zachleedogg/E_Moto/Hardware/BMS/BatteryPowerDissipationCalcs.ods

Sheet: IR losses
Battery Current | 200
 | p | L (mm) | thick(mm) | width(mm) | Resistance (Ω) | current(A) | Connections (#) | IR loss (W) | Voltage sag (V)
Nickel strip | 6.99E-008 | 20 | 0.15 | 8 | 0.001165 | 8.3333333333 | 576 | 46.6 | 0.233
12mil wire bond |  | 15 |  |  | 0.005492126 | 4 | 1200 | 105.4488188976 | 0.5272440945

Sheet: DCR losses
DC
