zachleedogg/E_Moto/Hardware/InterfaceController/InterfaceList.ods

Interface Controller
ICs | note
uC | pic33
BLE | rn41
CAN
I2C EEPROM | 256k
LED driver | 16
Power Rails
5V_MAIN | buck
5V_EXT | ldo
3.3V | ldo
12V_PROT | reverse polarity protection
Inputs
Sonar
Ambient Light
IGN
KILL
Touch Screen
Outputs
LCD
LED
Speedo
