zachleedogg/E_Moto/Hardware/LEDController/LM3904 Calculator.ods

lm3904 calculator
Design Requirements:
symbol | value | units | desc
fsw | 525000 | Hz | switching freq
Vin | 13.5 | V | input Voltage
Vo | 8 | V | output Voltage
Iled | 4 | A | LED current
Δiled-pp | 1 | A | LED ripple current
Δvin-pp | 0.5 | V | input ripple voltage
Vturn-on | 9 | V | Turn-on voltage
Vhys | 1.1 | V | hysterysis voltage
n | 0.95 |  | efficiency
Nominal Switching Frequendy
Coff | 4.7E-010 | F
Roff_desired | 8683.4913185556 | Ω
Roff_actual | 8660 | Ω
toff | 7.14667706305369E-007 | Seconds
fsw_actaul | 526424.127279638 | Hz |  | -0.76754
L1 | 5.71734165044295E-006 | H
L1_actual | 6.00E-006 | H
Δiled-pp_actual | 9.53E-001
Ilmax | 4.4764451375 | A |  | 528309.409888357
Rsns | 0.0554011034 | Ω |  | 526424.127279638
Rsns_actual | 0.056 | Ω
Iled_actual | 3.952126291
