zachleedogg/E_Moto/Hardware/DCDC/Calcs/LTC_3638.ods

LT3638
Vin (min) | Vin (nom) | Vin (max)
60 | 86 | 100
Vout | freq
5 | 100000
Load Current | 0.2 | A
Riset | 176000 | ohms
Inductor | 0.0002354651 | H
min Inductor | 0.000045 | H | Check if min on time is violate
Chosen | 0.00022 | H | Choose value based on next standard size
Irms | 0.0468014228 | A
Cin | 2.47627906976744E-007 | F
Cin Chosen | 1uF
UVLO | 40 | V
OVLO | 140 | V
Rtot | 1500000 | Ohms
Rbot | 12964.2857142857 |  | 13000
Rmid | 32410.7142857143 |  | 32000
Rtop | 1454625 |  | 1450000
 |  |  | 1495000
OVLO 6V check | 0.8695652174 |  | this must be less than 6V
Soft Start Time | 0.1 | s
Css | 0.000000625 | F
Css Check | 0.0172 | s | SS time must be greater than this value.
