zachleedogg/E_Moto/Hardware/DCDC/Calcs/LTC_7810.ods

LTC7810
Vin (min) | Vin (nom) | Vin (max)
60 | 96 | 110
Vout | freq
12 | 200000
Load Current | 17.5 | A | Max Load Current (per channel)
Inductor | 0.0000068 | H | Change this value
Ripple Current | 7.8609625668 | A | Ripple current based on values above
Ripple % max | 30 | % | Desired Max Ripple
Ripple Current Check | 5.25 | A | Check if ripple is less than this value
