zachleedogg/E_Moto/Hardware/BodyController/Calcs/BodyControllerList.ods

Interface Controller
ICs | note
uC | pic33
Power Rails
5V_MAIN | buck
5V_SW | pfet
3V3 | ldo
12V+ | reverse polarity protection
Inputs | Current
B+ | 35
DCDC | 35
Outputs | Max Current | Typ Current | Continuous?
Headlight_Hi | 0.3 | 0.3 | x
Headlight_Lo | 2.5 | 2.5 | x
Turn FL | 0.25 | 0.25
Turn FR | 0.25 | 0.25
Taillight | 1 | 1 | x
Brake Light | 0.5 | 0.5
Turn RR | 0.25 | 0.25
Turn RL | 0.25 | 0.25
Horn | 5 | 5
Aux 12V | 8 | 2 | x
Heated Grips | 4 | 2 | x
Heated Seat | 4 | 1 | x
Pump | 3.5 | 0 | x
Fan | 3 | 0 | x
Motor Controller | 0.5 | 0 | x
BMS | 0.25 | 0.08 | x
Interface Controller | 5 | 0.3 | x
Charge Controller | 0.25 | 0.08 | x
Column Lock | 3 | 3
Charge Port Lock | 3 | 3
Seat Lock | 3 | 3
Spare_1 | 3 | 3
Spare_2 | 3 | 3
Main Precharge | 0.25 | 0.2 | x
Main Contactor | 0.25 | 0.2 | x
DCDC Contactor | 0.25 | 0.2 | x
TOTAL | 54.55 | 9.86 | 33.05
HSDs | Rds(on) | CH | Current Rating
BTS51802EKAXUMA1 | 0.18 | 2 | 1.5
BTS50301EJAXUMA1 | 0.03 | 1 | 5
BTS50202EKAXUMA2 | 0.02 | 2 | 5
BTS500801TMAATMA1 | 0.016 | 1 | 10
BTS716G | 0.14 | 4 | 2
TPS25940AQRVCRQ1 | 0.042 | 1 | 5 | (efuse)
