zachleedogg/E_Moto/Hardware/Calculators/ReflowTime.ods

Time | temp | phase | Test 1 |  | knob | ebike | time | time mins | temp | knob
0 | 0 | slope | 0 | 85 | 150 |  | 0 | 0 | 69 | 150
45 | 150 | slope | 45 | 120 | 200 |  | 45 | 0.75 | 95 | 200
90 | 212 | soak | 90 | 210 | 200 |  | 90 | 1.5 | 145 | 250
120 | 275 | soak | 120 | 270 | 150 |  | 120 | 2 | 185 | 300
210 | 275 | reflow | 210 | 280 | toast |  | 210 | 3.5 | 300 | toast
300 | 430 | reflow | 300 | 360 | toast |  | 300 | 5 | 400 | toast
360 | 275 | cool | 360 | 425 | toast |  | 360 | 6 | 444 | Open 1
420 | 100 | cool | 420 | 300 | open 1inch |  | 420 | 7 | 275 | open
 |  |  | 480 | 200 | open |  | 480 | 8 | 150
