zachleedogg/E_Moto/Architecture/Documentation/Top Speed Calculator.ods

Motor RPM | Front Gear | Rear Gear | Wheel Circ | Speed | Front Gear | Rear Gear | Wheel Cir
500 | 10 | 46 | 84.945 | 8.7435153162 | 10 | 46 | 84.945
550 | 10 | 46 | 84.945 | 9.6178668478
600 | 10 | 46 | 84.945 | 10.4922183794
650 | 10 | 46 | 84.945 | 11.3665699111
700 | 10 | 46 | 84.945 | 12.2409214427
750 | 10 | 46 | 84.945 | 13.1152729743
800 | 10 | 46 | 84.945 | 13.9896245059
850 | 10 | 46 | 84.945 | 14.8639760375
900 | 10 | 46 | 84.945 | 15.7383275692
950 | 10 | 46 | 84.945 | 16.6126791008
1000 | 10 | 46 | 84.945 | 17.4870306324
1050 | 10 | 46 | 84.945 | 18.361382164
1100 | 10 | 46 | 84.945 | 19.2357336957
1150 | 10 | 46 | 84.945 | 20.1100852273
1200 | 10 | 46 | 84.945 | 20.9844367589
1250 | 10 | 46 | 84.945 | 21.8587882905
1300 | 10 | 46 | 84.945 | 22.7331398221
1350 | 10 | 46 | 84.945 | 23.6074913538
1400 | 10 | 46 | 84.945 | 24.4818428854
1450 | 10 | 46 | 84.945 | 25.356194417
1500 | 10 | 46 | 84.945 | 26.2305459486
1550 | 10 | 46 | 84.945 | 27.1048974802
1600 | 10 | 46 | 84.945 | 27.9792490119
1650 | 10 | 46 | 84.945 | 28.8536005435
1700 | 10 | 46 | 84.945 | 29.7279520751
1750 | 10 | 46 | 84.945 | 30.6023036067
1800 | 10 | 46 | 84.945 | 31.4766551383
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
