zachleedogg/E_Moto/Architecture/E-MotoSystemArch.png

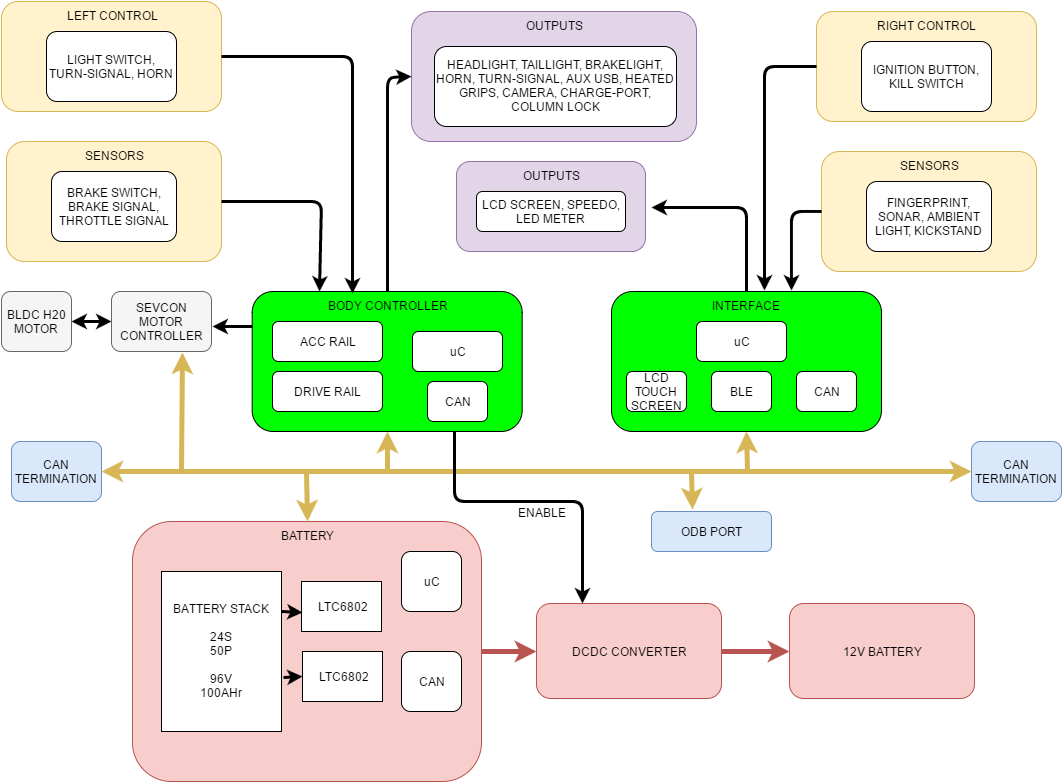
Architecture/E-MotoSystemArch.png
