zachleedogg/E_Moto/CAD/Battery/Battery 3.0/Documentation/ANNPower_6P_Holder.PNG

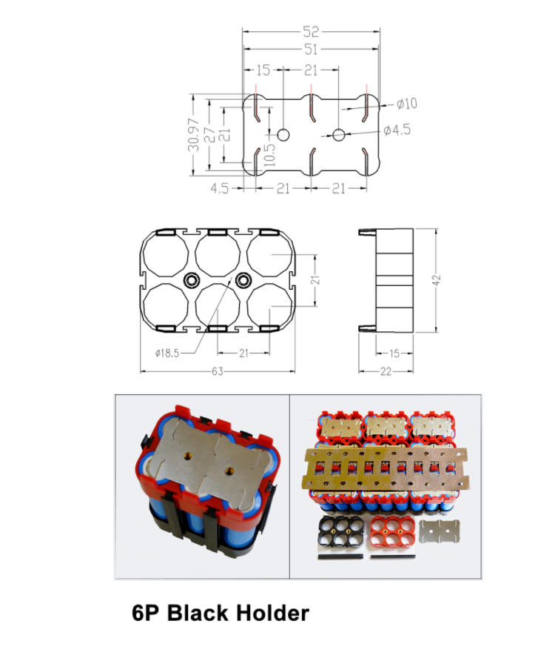
CAD/Battery/Battery 3.0/Documentation/ANNPower_6P_Holder.PNG
