zachleedogg/E_Moto/CAD/Motor/ME1616.jpg

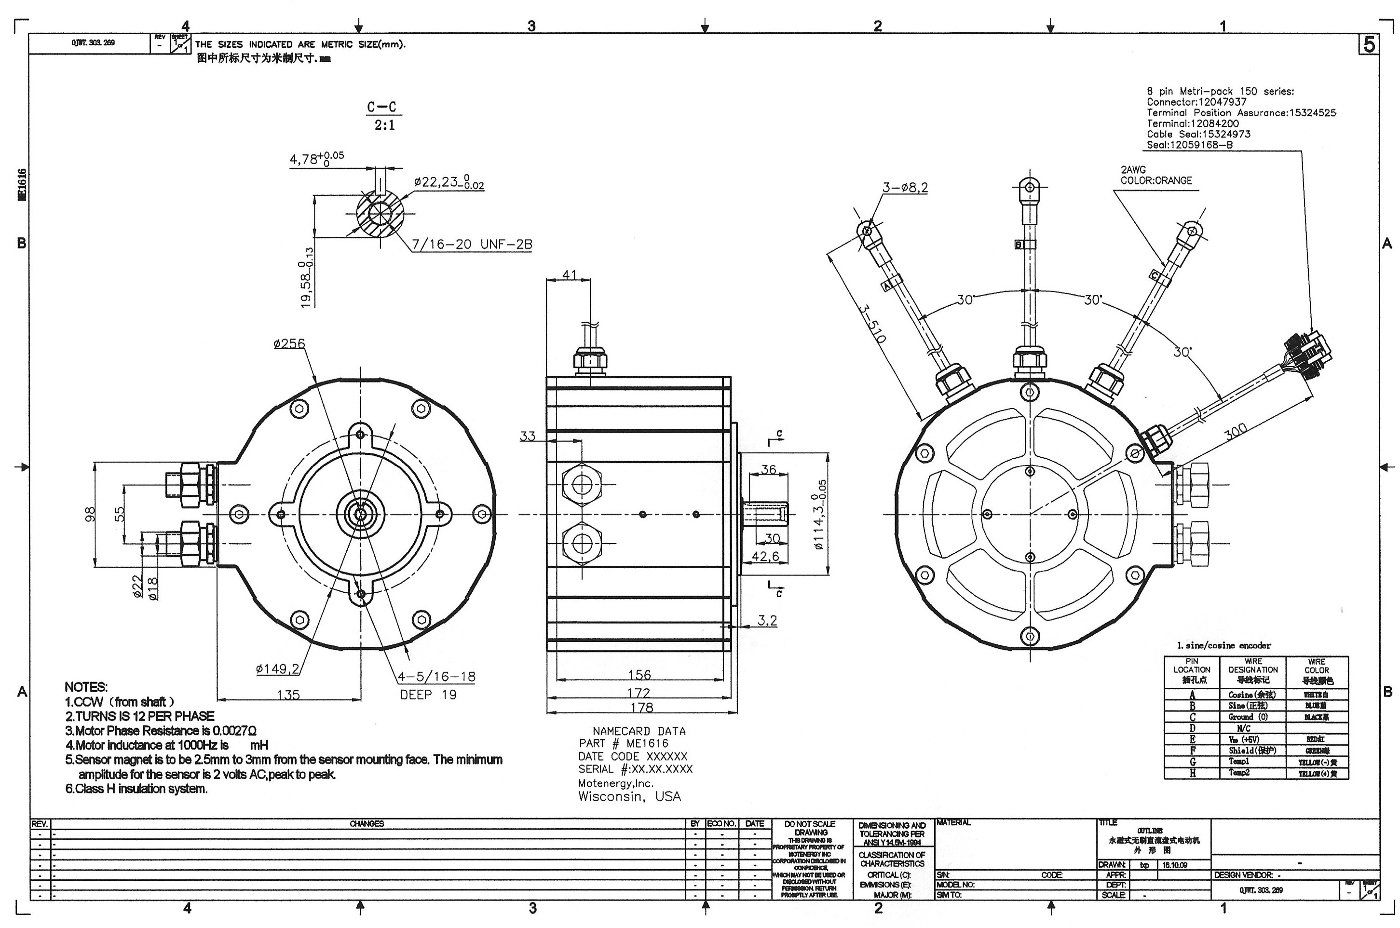
CAD/Motor/ME1616.jpg
