zachleedogg/E_Moto/Hardware/BMS/DischargeCircuit.PNG

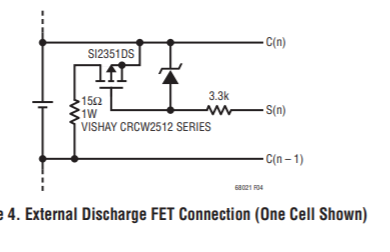
Hardware/BMS/DischargeCircuit.PNG
