zachleedogg/E_Moto/Hardware/BMS/DischargeCircuit_wRC.PNG

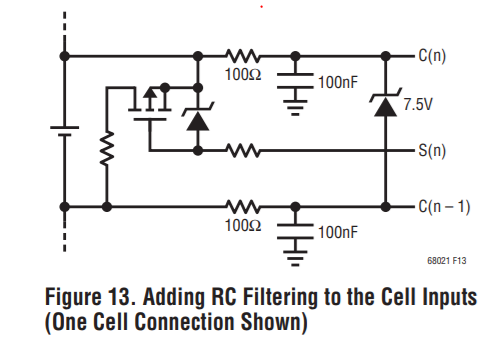
Hardware/BMS/DischargeCircuit_wRC.PNG
