zachleedogg/E_Moto/Hardware/DCDC/Isolated Gate Drive.PNG

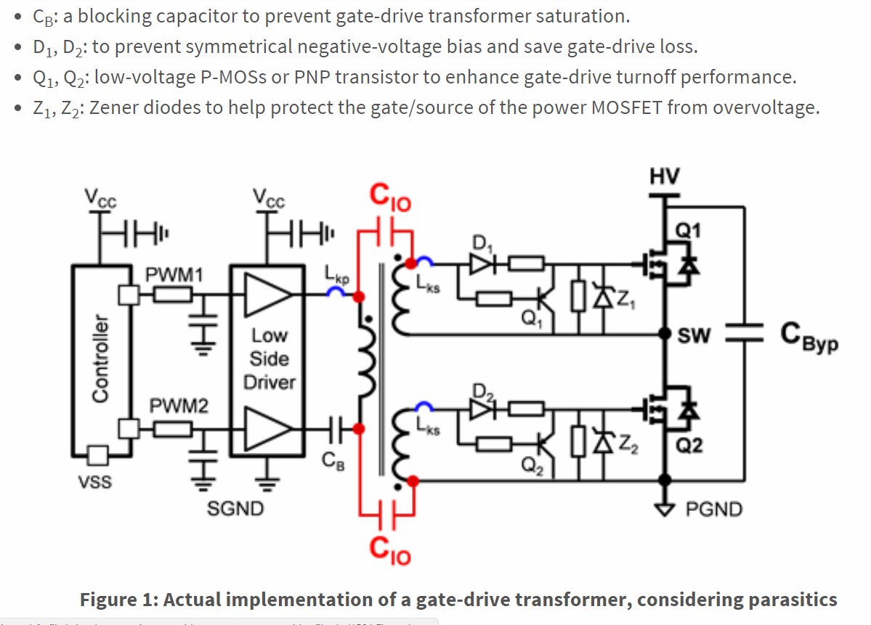
Hardware/DCDC/Isolated Gate Drive.PNG
