zachleedogg/E_Moto/Architecture/Documentation/CheckList.ods

Item | Status | Priority | System | Notes | Cost | Total Expected Cost
Vinyl wrap black | Finished | 1 | Chassis | COMPLETE | 50 | 3185
Fabricate Battery Cradle | In Progress | 1 | Chassis | Not Started, price??? | 200
Mount Radiator, Fan, and Pump | In Progress | 1 | Chassis | This is a fun project that could be completed soon!!! | 10
Machine Aluminum Motor Pate | In Progress | 1 | Chassis | Not Started | 200
Ignition Wiring | Finished | 1 | Electrical | COMPLETE | 0
Left Control Wiring | Finished | 1 | Electrical | COMPLETE | 0
Build Battery | In Progress | 1 | Electrical | Start with mockups using mostly empty cell banks | 100
Get Chain/Sprocket | On Hold | 2 | Chassis | 530 chain, mcmaster 11t front and JT 46t rear | 180
Get Motor | On Hold | 2 | Chassis | ME1616 Water Cooled | 1000
Headlight/taillight | In Progress | 2 | Electrical | Make sure Taillight brakes work | 0
Horn power wiring | In Progress | 2 | Electrical | just connect to power pin. | 0
Get Motor Controller | On Hold | 2 | Electrical | Sevcon? Or what | 700
Get ElCon Charger from AliExpress | In Progress | 2 | Electrical |  | 500
Rebuild Fork | On Hold | 3 | Chassis | Take to super plush | 245
3D Print a cool gas cap | On Hold | 3 | Chassis |  | 0
Turn Signals | In Progress | 3 | Electrical | Front need replaced or superglued together. | 0
j1772 wiring | In Progress | 3 | Electrical | wires from connector to Body Controller | 0
Clean Wheels | In Progress | 5 | Chassis | Not complete. Try using simple green | 0
Clean Rear Swing Arm | In Progress | 5 | Chassis | Not complete. Try using simple green | 0
