zachleedogg/E_Moto/Hardware/BMS/BMS_01/BOM_by_refdes.xlsx

RefDes | Value | Digikey_PN | Mouser_PN | MFG_PN
R125 | 15R0 | 2019-WK73R2ATTD15R0FCT-ND |  | WK73R2ATTD15R0F
R121 | 15R0 | 2019-WK73R2ATTD15R0FCT-ND |  | WK73R2ATTD15R0F
R117 | 15R0 | 2019-WK73R2ATTD15R0FCT-ND |  | WK73R2ATTD15R0F
R113 | 15R0 | 2019-WK73R2ATTD15R0FCT-ND |  | WK73R2ATTD15R0F
R109 | 15R0 | 2019-WK73R2ATTD15R0FCT-ND |  | WK73R2ATTD15R0F
R105 | 15R0 | 2019-WK73R2ATTD15R0FCT-ND |  | WK73R2ATTD15R0F
R101 | 15R0 | 2019-WK73R2ATTD15R0FCT-ND |  | WK73R2ATTD15R0F
R97 | 15R0 | 2019-WK73R2ATTD15R0FCT-ND |  | WK73R2ATTD15R0F
R93 | 15R0 | 2019-WK73R2ATTD15R0FCT-ND |  | WK73R2ATTD15R0F
R89 | 15R0 | 2019-WK73R2ATTD15R0FCT-ND |  | WK73R2ATTD15R0F
R85 | 15R0 | 2019-WK73R2ATTD15R0FCT-ND |  | WK73R2ATTD15R0F
R81 | 15R0 | 2019-WK73R2ATTD15R0FCT-ND |  | WK73R2ATTD15R0F
R65 | 15R0 | 2019-WK73R2ATTD15R0FCT-ND |  | WK73R2ATTD15R0F
R61 | 15R0 | 2019-WK73R2ATTD15R0FCT-ND |  | WK73R2ATTD15R0F
R57 | 15R0 | 2019-WK73R2ATTD15R0FCT-ND |  | WK73R2ATTD15R0F
R53 | 15R0 | 2019-WK73R2ATTD15R0FCT-ND |  | WK73R2ATTD15R0F
R49 | 15R0 | 2019-WK73R2ATTD15R0FCT-ND |  | WK73R2ATTD15R0F
R45 | 15R0 | 2019-WK73R2ATTD15R0FCT-ND |  | WK73R2ATTD15R0F
R41 | 15R0 | 2019-WK73R2ATTD15R0FCT-ND |  | WK73R2ATTD15R0F
R37 | 15R0 | 2019-WK73R2ATTD15R0FCT-ND |  | WK73R2ATTD15R0F
R33 | 15R0 | 2019-WK73R2ATTD15R0FCT-ND |  | WK73R2ATTD15R0F
R29 | 15R0 | 2019-WK73R2ATTD15R0FCT-ND |  | WK73R2ATTD15R0F
R25 | 15R0 | 2019-WK73R2ATTD15R0FCT-ND |  | WK73R2ATTD15R0F
R21 | 15R0 | 2019-WK73R2ATTD15R0FCT-ND |  | WK73R2ATTD15R0F
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
R13 | 100R | YAG3561CT-ND |  | AC0603FR-07100RL
R7 | 100R | YAG3561CT-ND |  | AC0603FR-07100RL
L10 | Ferrite_Bead | 732-1591-1-ND |  | 742792609
L9 | Ferrite_Bead | 732-1591-1-ND |  | 742792609
L8 | Ferrite_Bead | 732-1591-1-ND |  | 742792609
L5 | Ferrite_Bead | 732-1591-1-ND |  | 742792609
L4 | Ferrite_Bead | 732-1591-1-ND |  | 742792609
L2 | Ferrite_Bead | 732-1591-1-ND |  | 742792609
L1 | Ferrite_Bead | 732-1591-1-ND |  | 742792609
J19 | 7807 | 36-7807-ND |  | 7807
J18 | 7807 | 36-7807-ND |  | 7807
J17 | 7807 | 36-7807-ND |  | 7807
J10 | 7807 | 36-7807-ND |  | 7807
TP1 | TestPoint
NT1 | Net-Tie_2
J20 | Conn_01x02
J16 | Conn_01x02
J15 | Conn_01x02
J14 | USB_B_Micro
J13 | Conn_01x06
J12 | Conn_01x02
J11 | Conn_01x04
J9 | Conn_01x04
J8 | Conn_02x06_Odd_Even
J7 | Conn_02x06_Odd_Even
J6 | Conn_02x06_Odd_Even
J5 | Conn_02x06_Odd_Even
J4 | Conn_01x06
J3 | Conn_01x06
J2 | Conn_01x06
J1 | Conn_01x07
H5 | MountingHole_Pad
H4 | MountingHole_Pad
H3 | MountingHole_Pad
H2 | MountingHole_Pad
H1 | MountingHole_Pad
