zachleedogg/E_Moto/Hardware/Calculators/TPS25940-Q1.ods

OverVoltage | 20
NormalVoltage | 13.5
UnderVoltage | 5
V(ovpr) | 0.99
V(enr) | 0.99
R3 | 34000
r2+r1 | 652868.686868687
r2 | 102000
r1 | 550868.686868687
R1 | 550868.686868687
R2 | 102000
R3 | 34000
Chosen Values | 560000
 | 100000
 | 34000
OverVoltage | 20.2076470588
NormalVoltage | 13.5
UnderVoltage | 5.1273134328
