zachleedogg/E_Moto/Hardware/BodyController/Calcs/Sleep Budget.ods

Sleep Budget
Qty | PN | uA | V
2 | BTS500801TMAATMA1 | 6 | 13.5
6 | BTS50202EKAXUMA2 | 1 | 13.5
2 | BTS716GXUMA1 | 16 | 13.5
1 | DRV8872DDARQ1 | 13 | 13.5
1 | TPS25940AQRVCRQ1 | 130 | 13.5
1 | TPS divider | 19 | 13.5
1 | LMR14020SQDDARQ1 | 50 | 13.5
1 | LMR divider EN | 19 | 13.5
 |  | 281
1 | DSPIC33EP512MU810-E/PF | 440 | 3.3 (5)
1 | LMR divider FB | 5 | 5
1 | TPS70933QDBVRQ1 | 2 | 5
1 | TCAN1051GVDRQ1 | 1600 | 5
 |  | 2047
 |  | 758.1481481481
 |  | 1039.1481481482
