zachleedogg/E_Moto/Firmware/SevconController/Master Object Dictionary Database.xls

Sheet: Instructions
Sevcon CANopen Object Dictionary Instructions
 | This file contains a description for every object in every Sevcon CANopen device. It provides the following functionality:
 | 1 | Allows different versions of the same index/subindex. Primarily this is intended for supporting changes to objects between different software versions.
 |  | e.g. Different scalings, etc. However, a different version of an object might be an entirely new object with a new name, etc.

Sheet: Object Dictionary
Sevcon CANopen Master Object Dictionary |  |  |  |  |  |  |  |  |  |  |  |  | More this way
 |  |  |  |  |  |  |  |  |  |  |  |  |  |  |  |  |  |  | Column Reserved | Column Reserved
 | Index | Sub-Index | Version | Access Type | Access Level | Scaling | Units | Name | Data Type | Low Limit | High Limit | Value | Description | Map to PDO? | Object Flags | Object Specifiers | Bit Splitting | ToolTips | for macro. | for macro.
 | 1000h | 0 | 1 | Const | N/A |  |  | Device type | Unsigned32 | 0 | FFFFFFFFh | FFFF0192h | Contains information about the device type. This actually describes profiles. One node can have more than one profile (e.g. 1 or 2 Drives and Motion Control profiles and an I/O Module profile). The device type at this location is for the first profile. The device type for each profile is stored at 67FFh + (x * 800h), where x is the profile number. The value indicates it is a multiple profile device (FFFF) and the 1st profile is drives and motion (402d = 192h). | No | 0 | OBJECT=DEVICE_TYPE SECTION=CANOPEN_PROFILEEND CATEGORY=MONITORING | DESC=Type:HEX_MASK=0000FFFF:MIN=0:MAX=0xFFFF:NF=2:402=Electric Drive:401=Generic I/O:419=Battery charger:418=Battery module:410 = inclinometer DESC=Additional data:HEX_MASK=FFFF0000:MIN=0:MAX=0xFFFF:NF=BASE16
 | 1001h | 0 | 1 | RO | N/A |  |  | Error register | Unsigned8 | 0 | FFh | No | Device error register. Gives details of the state of generic faults such as temperature, current, voltage, etc. Transmitted with the EMCY telegram. Note reserved bit deliberatley excluded from bitsplitting to simplify user interface | No | 0 | OBJECT=ERROR_REGISTER SECTION=Emergency NUMBER_FORMAT=BASE16 CATEGORY=MONITORING | DESC=Generic error:HEX_MASK=1:MIN=0:MAX=1:NF=2:0=Cleared:1=Set DESC=Current error:HEX_MASK=2:MIN=0:MAX=1:NF=2:0=Cleared:1=Set DESC=Voltage error:HEX_MASK=4:MIN=0:MAX=1:NF=2:0=Cleared:1=Set DESC=Temperature error:HEX_MASK=8:MIN=0:MAX=1:NF=2:0=Cleared:1=Set DESC=Comms error:HEX_MASK=10:MIN=0:MAX=1:NF=2:0=Cleared:1=Set DESC=Device Profile error:HEX_MASK=20:MIN=0:MAX=1:NF=2:0=Cleared:1=Set DESC=Manf specific error:HEX_MASK=80:MIN=0:MAX=1:NF=2:0=Cleared:1=Set
 | 1005h | 0 | 1 | RW | 4 |  |  | Synchronisation (SYNC) message COB-ID | Unsigned32 | 0 | 5FFFFFFFh | 40000080h | COB-ID and configuration of SYNC message. | No | 0 | OBJECT=COBID_SYNC SECTION=SYNCCOB EEPROM=comm.sync_id NUMBER_FORMAT=BASE16 WRITE_IN_PREOPERATIONAL_ONLY=TRUE CATEGORY=CONFIGURATION
 | 1006h | 0 | 1 | RW | 4 | 0.001 | ms | Interval between SYNC messages (Communication cycle period) | Unsigned32 | 00002711h | 01F3FC18h | 100000 | Interval between SYNC messages in µs. | No | 0 | OBJECT=COMM_CYCLE_PERIOD SECTION=SYNCCOB EEPROM=comm.cycle_period CATEGORY=CONFIGURATION
 | 1007h | 0 | 1 | RW | 4 |  | us | Synchronous (SYNC) window length | Unsigned32 | 0 | FFFFFFFFh | 0 | Length of the time window for synchronous PDOs in µs. This is the maximum time to transmit synchronous PDOs after receiving SYNC message. | No | 0 | OBJECT=SYNC_WINDOW_LEN SECTION=SYNCCOB EEPROM=comm.sync_win CATEGORY=CONFIGURATION
 | 1008h | 0 | 1 | Const | N/A |  |  | Product name | Visible String | N/A | N/A | No | Device name as a string. Eg. Shiroko AC Controller. Device name will be stored in ROM. | No | 0 | OBJECT=MANU_DEVICE_NAME SECTION=Identity CATEGORY=MONITORING
 | 1009h | 0 | 1 | Const | N/A |  |  | Hardware version | Visible String | N/A | N/A | No | Hardware version as a string. | No | 0 | OBJECT=MANU_HW_VERSION SECTION=Identity CATEGORY=MONITORING
 | 100Ah | 0 | 1 | Const | N/A |  |  | Software version | Visible String | N/A | N/A | No | Software version as a string. Version string will be stored in ROM. | No | 0 | OBJECT=MANU_SW_VERSION SECTION=Identity CATEGORY=MONITORING
 | 100Ch | 0 | 1 | RW | 4 |  | ms | Guard time | Unsigned16 | 0 | 7FFFh | 0 | Used for Life Guarding Protocol. Time is in ms. Refer to Node Guarding Protocol (section 9.2.6.2.2 in DS301). The default for the system is to use Heartbeats. | No | 0 | OBJECT=GUARD_TIME SECTION=Guarding EEPROM=comm.guard_time CATEGORY=CONFIGURATION
 | 100Dh | 0 | 1 | RW | 4 |  |  | Life time factor | Unsigned8 | 0 | FFh | 0 | Multiplied with the Guard Time to give the Life Time. Refer to Node Guarding Protocol (section 9.2.6.2.2 in DS301). | No | 0 | OBJECT=LIFE_TIME_FACTOR SECTION=Guarding EEPROM=comm.life_time CATEGORY=CONFIGURATION
 | 1010h | ---- | ---- | ---- | ---- |  |  | Store command | Array | N/A | N/A | ---- | This object must be written to to store objects to non-volatile memory. | ---- | ---- | OBJECT=STORE SECTION=CANOpenStore CATEGORY=MONITORING
 |  | 0 | 1 | RO | N/A |  |  | Number of entries | Unsigned8 | 0 | FFh | 1 |  | No | 0
 |  | 1 | 1 | RW | 4 |  |  | Save all parameters | Unsigned32 | 65766173h | 65766173h | No | Write 65766173h to this object to save to EEPROM. The number represents "save" (ie 'e' = 65h; 'v' = 76h; 'a' = 61h; 's' = 73h). Reading this object will retun 1 meaning values in the Object Dictionary are only saved on command. | No | 1h | WRITE_IN_PREOPERATIONAL_ONLY=TRUE NUMBER_FORMAT=2:0x0=Cancel:0x65766173=Save to EEPROM COMMS_TIMEOUT=10000
 | 1011h | ---- | ---- | ---- | ---- |  |  | Restore command | Array | N/A | N/A | ---- | This object must be written to to store objects in the range 1200h to 1FFFh to non-volatile memory. All other objects are stored autonomously. | ---- | ---- | OBJECT=RESTORE SECTION=CANOpenStore CATEGORY=MONITORING
 |  | 0 | 1 | RO | N/A |  |  | Number of entries | Unsigned8 | 0 | FFh | 1 |  | No | 0
 |  | 1 | 1 | RW | 4 |  |  | Load all parameters | Unsigned32 | 64616F6Ch | 64616F6Ch | No | Write 64616F6Ch to this object to load from EEPROM. The number represents "load" (ie 'd' = 64h; 'a' = 61h; 'o' = 6Fh; 'l' = 6Ch). Reading this object will retun 1 meaning values in the Object Dictionary are restored. | No | 1h | WRITE_IN_PREOPERATIONAL_ONLY=TRUE NUMBER_FORMAT=2:0x0=Cancel:0x64616F6C=Load from EEPROM COMMS_TIMEOUT=10000
 | 1014h | 0 | 1 | RW | 4 |  |  | Emergency (EMCY) telegram COB-ID | Unsigned32 | 0 | 1FFFFFFFh | 81h | COB-ID of EMCY object. At run-time COB-ID will equal 80h + Node ID | No | 0 | OBJECT=COBID_EMCY SECTION=Emergency EEPROM=comm.emergency_id NUMBER_FORMAT=BASE16 WRITE_IN_PREOPERATIONAL_ONLY=TRUE CATEGORY=CONFIGURATION
 | 1015h | 0 | 1 | RW | 4 | 0.1 | ms | EMCY Inhibit Time | Unsigned16 | 0 | FFFFh | 0 | Inhibit time for EMCY objects in 0.1ms / bit resolution. | No | 0 | OBJECT=EMCY_INHIBIT_TIME SECTION=Emergency EEPROM=comm.inhibit_time CATEGORY=CONFIGURATION
 | 1016h | ---- | ---- | ---- | ---- |  |  | Consumer heartbeat time | Array | N/A | N/A | ---- | Defines the expected heartbeat cycle time for each node. Must be higher than the corresponding producer heartbeat time. If the heartbeat time for a node is set to 0, then that node defaults to the Node Guarding protocol. Format: 00NN TTTT h, where NN is the node ID and TTTT is the heartbeat time in 1ms/bit resolution. 75ms (4Bh) is the default time. | ---- | ---- | OBJECT=CONSUMER_HBEAT_TIME SECTION=Heartbeat CATEGORY=CONFIGURATION
 |  | 0 | 1 | RO | N/A |  |  | Number of entries | Unsigned8 | 0 | FFh | 7 |  | No | 0
 |  | 1 | 1 | RW | 4 |  |  | Consumer heartbeat time for 1st node | Unsigned32 | 0 | FFFFFFFFh | 0 |  | No | 0 | EEPROM=comm.con_heartbeat_0 NUMBER_FORMAT=BASE16 | DESC=1st node- Heartbeat time:HEX_MASK=FFFF:MIN=0:MAX=0xFFFF:NF=BASE10:UNITS=ms DESC=1st node- Node ID:HEX_MASK=FF0000:MIN=0:MAX=127:NF=BASE10:
 |  | 2 | 1 | RW | 4 |  |  | Consumer heartbeat time for 2nd node | Unsigned32 | 0 | FFFFFFFFh | 0 |  | No | 0 | EEPROM=comm.con_heartbeat_1 NUMBER_FORMAT=BASE16 | DESC=2nd node- Heartbeat time:HEX_MASK=FFFF:MIN=0:MAX=0xFFFF:NF=BASE10:UNITS=ms DESC=2nd node- Node ID:HEX_MASK=FF0000:MIN=0:MAX=127:NF=BASE10
 |  | 3 | 1 | RW | 4 |  |  | Consumer heartbeat time for 3rd node | Unsigned32 | 0 | FFFFFFFFh | 0 |  | No | 0 | EEPROM=comm.con_heartbeat_2 NUMBER_FORMAT=BASE16 | DESC=3rd node- Heartbeat time:HEX_MASK=FFFF:MIN=0:MAX=0xFFFF:NF=BASE10:UNITS=ms DESC=3rd node- Node ID:HEX_MASK=FF0000:MIN=0:MAX=127:NF=BASE10
 |  | 4 | 1 | RW | 4 |  |  | Consumer heartbeat time for 4th node | Unsigned32 | 0 | FFFFFFFFh | 0 |  | No | 0 | EEPROM=comm.con_heartbeat_3 NUMBER_FORMAT=BASE16 | DESC=4th node- Heartbeat time:HEX_MASK=FFFF:MIN=0:MAX=0xFFFF:NF=BASE10:UNITS=ms DESC=4th node- Node ID:HEX_MASK=FF0000:MIN=0:MAX=127:NF=BASE10
 |  | 5 | 1 | RW | 4 |  |  | Consumer heartbeat time for 5th node | Unsigned32 | 0 | FFFFFFFFh | 0 |  | No | 0 | EEPROM=comm.con_heartbeat_4 NUMBER_FORMAT=BASE16 | DESC=5th node- Heartbeat time:HEX_MASK=FFFF:MIN=0:MAX=0xFFFF:NF=BASE10:UNITS=ms DESC=5th node- Node ID:HEX_MASK=FF0000:MIN=0:MAX=127:NF=BASE10
 |  | 6 | 1 | RW | 4 |  |  | Consumer heartbeat time for 6th node | Unsigned32 | 0 | FFFFFFFFh | 0 |  | No | 0 | EEPROM=comm.con_heartbeat_5 NUMBER_FORMAT=BASE16 | DESC=6th node- Heartbeat time:HEX_MASK=FFFF:MIN=0:MAX=0xFFFF:NF=BASE10:UNITS=ms DESC=6th node- Node ID:HEX_MASK=FF0000:MIN=0:MAX=127:NF=BASE10
 |  | 7 | 1 | RW | 4 |  |  | Consumer heartbeat time for 7th node | Unsigned32 | 0 | FFFFFFFFh | 0 |  | No | 0 | EEPROM=comm.con_heartbeat_6 NUMBER_FORMAT=BASE16 | DESC=7th node- Heartbeat time:HEX_MASK=FFFF:MIN=0:MAX=0xFFFF:NF=BASE10:UNITS=ms DESC=7th node- Node ID:HEX_MASK=FF0000:MIN=0:MAX=127:NF=BASE10
 | 1017h | 0 | 1 | RW | 4 |  | ms | Producer heartbeat time | Unsigned16 | 0 | 7FFFh | 500 | Producer heartbeat time in ms. Default 50ms. | No | 0 | OBJECT=PRODUCER_HBEAT_TIME SECTION=Heartbeat EEPROM=comm.heartbeat_reload CATEGORY=CONFIGURATION
 | 1018h | ---- | ---- | ---- | ---- |  |  | Identity object | Record | N/A | N/A | ---- | General device information. Note that LSS requires every sub-index be given a value, and that, when all four sub-indices are appended to give the LSS address, they generate a unique identifier. | ---- | ---- | OBJECT=IDENTITY SECTION=Identity CATEGORY=MONITORING
 |  | 0 | 1 | RO | N/A |  |  | Number of entries | Unsigned8 | 0 | FFh | 4 |  | No | 0
 |  | 1 | 1 | Const | N/A |  |  | Vendor ID | Unsigned32 | 0 | FFFFFFFFh | 0000001Eh | Sevcon's CiA CAN assigned vendor ID. | No | 0 | NUMBER_FORMAT=BASE16
 |  | 2 | 1 | RO | N/A |  |  | Product code | Unsigned32 | 0 | FFFFFFFFh | 0101503ch | 32-bit unsigned integer which can be used to identify the product. Format: RRvv VVAAh, where RR is the product range (eg 1 = Shiroko), vv is the variant (eg 1 = AC), VV is the voltage (eg 30h = 48V) and AA is the current (eg 46h = 700A). | No | 0 | NUMBER_FORMAT=BASE16
 |  | 3 | 1 | Const | N/A |  |  | CANopen (Object Dictionary) revision | Unsigned32 | 0 | FFFFFFFFh | 00010001h | Contains a CANopen revision number indicating the version of object dictionary for a given application build. In the format RRRRVVVV where RRRR is the build version ie 0007 and VVVV indicates the version of the object dictionary for that build | No | 0 | NUMBER_FORMAT=BASE16
 |  | 4 | 1 | RO | N/A |  |  | Serial number | Unsigned32 | 0 | FFFFFFFFh | No | 32 bit unsigned integer containing the product serial number. Currently, Sevcon serial numbers have the format YYYYMMNNNN, where YYYY is the year, MM is the month and NNNN is a unique integer. A 32 bit number can go up to 4292967296, which allows our prefered serial number format to fit. Serial number will be stored in EEPROM. | No | 0 | NUMBER_FORMAT=BASE16
 | 1200h | ---- | ---- | ---- | ---- |  |  | Server SDO 1 (Default) parameters | Record | N/A | N/A | ---- |  | ---- | ---- | OBJECT=SDO_PARAMETER SECTION=ClientServerSDOs CATEGORY=CONFIGURATION
 |  | 0 | 1 | RO | N/A |  |  | Number of entries | Unsigned8 | 0 | FFh | 2 |  | No | 0
 |  | 1 | 1 | RO | N/A |  |  | COB-ID Client->Server (rx) | Unsigned32 | 0 | 9FFFFFFFh | $NODEID+0x600 |  | No | 0 | NUMBER_FORMAT=BASE16
 |  | 2 | 1 | RO | N/A |  |  | COB-ID Server->Client (tx) | Unsigned32 | 0 | 9FFFFFFFh | $NODEID+0x580 |  | No | 0 | NUMBER_FORMAT=BASE16
 | 1201h | ---- | ---- | ---- | ---- |  |  | Server SDO 2 parameters | Record | N/A | N/A | ---- |  | ---- | ---- | OBJECT=SDO_PARAMETER SECTION=ClientServerSDOs CATEGORY=CONFIGURATION
 |  | 0 | 1 | RO | N/A |  |  | Number of entries | Unsigned8 | 0 | FFh | 2 |  | No | 0
 |  | 1 | 1 | RW | 4 |  |  | COB-ID Client->Server (rx) | Unsigned32 | 0 | 9FFFFFFFh | 0 |  | No | 0 | EEPROM=sdo_pdo.ssdo_1.tx_sdo_id NUMBER_FORMAT=BASE16
 |  | 2 | 1 | RW | 4 |  |  | COB-ID Server->Client (tx) | Unsigned32 | 0 | 9FFFFFFFh | 0 |  | No | 0 | EEPROM=sdo_pdo.ssdo_1.rx_sdo_id NUMBER_FORMAT=BASE16
 | 1202h | ---- | ---- | ---- | ---- |  |  | Server SDO 3 parameters | Record | N/A | N/A | ---- |  | ---- | ---- | OBJECT=SDO_PARAMETER SECTION=ClientServerSDOs CATEGORY=CONFIGURATION
 |  | 0 | 1 | RO | N/A |  |  | Number of entries | Unsigned8 | 0 | FFh | 2 |  | No | 0
 |  | 1 | 1 | RW | 4 |  |  | COB-ID Client->Server (rx) | Unsigned32 | 0 | 9FFFFFFFh | 0 |  | No | 0 | EEPROM=sdo_pdo.ssdo_2.tx_sdo_id NUMBER_FORMAT=BASE16
 |  | 2 | 1 | RW | 4 |  |  | COB-ID Server->Client (tx) | Unsigned32 | 0 | 9FFFFFFFh | 0 |  | No | 0 | EEPROM=sdo_pdo.ssdo_2.rx_sdo_id NUMBER_FORMAT=BASE16
 | 1203h | ---- | ---- | ---- | ---- |  |  | Server SDO 4 parameters | Record | N/A | N/A | ---- |  | ---- | ---- | OBJECT=SDO_PARAMETER SECTION=ClientServerSDOs CATEGORY=CONFIGURATION
 |  | 0 | 1 | RO | N/A |  |  | Number of entries | Unsigned8 | 0 | FFh | 2 |  | No | 0
 |  | 1 | 1 | RW | 4 |  |  | COB-ID Client->Server (rx) | Unsigned32 | 0 | 9FFFFFFFh | 0 |  | No | 0 | EEPROM=sdo_pdo.ssdo_3.tx_sdo_id NUMBER_FORMAT=BASE16
 |  | 2 | 1 | RW | 4 |  |  | COB-ID Server->Client (tx) | Unsigned32 | 0 | 9FFFFFFFh | 0 |  | No | 0 | EEPROM=sdo_pdo.ssdo_3.rx_sdo_id NUMBER_FORMAT=BASE16
 | 1280h | ---- | ---- | ---- | ---- |  |  | Client SDO 1 parameters | Record | N/A | N/A | ---- | Required by Masters only.. | ---- | ---- | OBJECT=SDO_PARAMETER SECTION=ClientServerSDOs CATEGORY=CONFIGURATION
 |  | 0 | 1 | RO | N/A |  |  | Number of entries | Unsigned8 | 0 | FFh | 3 |  | No | 0
 |  | 1 | 1 | RW | 4 |  |  | COB-ID Client->Server (tx) | Unsigned32 | 0 | 9FFFFFFFh | 0 |  | No | 0 | EEPROM=sdo_pdo.csdo_0.tx_sdo_id NUMBER_FORMAT=BASE16
 |  | 2 | 1 | RW | 4 |  |  | COB-ID Server->Client (rx) | Unsigned32 | 0 | 9FFFFFFFh | 0 |  | No | 0 | EEPROM=sdo_pdo.csdo_0.rx_sdo_id NUMBER_FORMAT=BASE16
 |  | 3 | 1 | RW | 4 |  |  | SDO server Node ID | Unsigned8 | 1 | 7Fh | 1 |  | No | 0 | EEPROM=sdo_pdo.csdo_0.node_id
 | 1281h | ---- | ---- | ---- | ---- |  |  | Client SDO 2 parameters | Record | N/A | N/A | ---- | Required by Masters only.. | ---- | ---- | OBJECT=SDO_PARAMETER SECTION=ClientServerSDOs CATEGORY=CONFIGURATION
 |  | 0 | 1 | RO | N/A |  |  | Number of entries | Unsigned8 | 0 | FFh | 3 |  | No | 0
 |  | 1 | 1 | RW | 4 |  |  | COB-ID Client->Server (tx) | Unsigned32 | 0 | 9FFFFFFFh | 0 |  | No | 0 | EEPROM=sdo_pdo.csdo_1.tx_sdo_id NUMBER_FORMAT=BASE16
 |  | 2 | 1 | RW | 4 |  |  | COB-ID Server->Client (rx) | Unsigned32 | 0 | 9FFFFFFFh | 0 |  | No | 0 | EEPROM=sdo_pdo.csdo_1.rx_sdo_id NUMBER_FORMAT=BASE16
 |  | 3 | 1 | RW | 4 |  |  | SDO server Node ID | Unsigned8 | 1 | 7Fh | 1 |  | No | 0 | EEPROM=sdo_pdo.csdo_1.node_id
 | 1282h | ---- | ---- | ---- | ---- |  |  | Client SDO 3 parameters | Record | N/A | N/A | ---- | Required by Masters only.. | ---- | ---- | OBJECT=SDO_PARAMETER SECTION=ClientServerSDOs CATEGORY=CONFIGURATION
 |  | 0 | 1 | RO | N/A |  |  | Number of entries | Unsigned8 | 0 | FFh | 3 |  | No | 0
 |  | 1 | 1 | RW | 4 |  |  | COB-ID Client->Server (tx) | Unsigned32 | 0 | 9FFFFFFFh | 0 |  | No | 0 | EEPROM=sdo_pdo.csdo_2.tx_sdo_id NUMBER_FORMAT=BASE16
 |  | 2 | 1 | RW | 4 |  |  | COB-ID Server->Client (rx) | Unsigned32 | 0 | 9FFFFFFFh | 0 |  | No | 0 | EEPROM=sdo_pdo.csdo_2.rx_sdo_id NUMBER_FORMAT=BASE16
 |  | 3 | 1 | RW | 4 |  |  | SDO server Node ID | Unsigned8 | 1 | 7Fh | 1 |  | No | 0 | EEPROM=sdo_pdo.csdo_2.node_id
 | 1283h | ---- | ---- | ---- | ---- |  |  | Client SDO 4 parameters | Record | N/A | N/A | ---- | Required by Masters only.. | ---- | ---- | OBJECT=SDO_PARAMETER SECTION=ClientServerSDOs CATEGORY=CONFIGURATION
 |  | 0 | 1 | RO | N/A |  |  | Number of entries | Unsigned8 | 0 | FFh | 3 |  | No | 0
 |  | 1 | 1 | RW | 4 |  |  | COB-ID Client->Server (tx) | Unsigned32 | 0 | 9FFFFFFFh | 0 |  | No | 0 | EEPROM=sdo_pdo.csdo_3.tx_sdo_id NUMBER_FORMAT=BASE16
 |  | 2 | 1 | RW | 4 |  |  | COB-ID Server->Client (rx) | Unsigned32 | 0 | 9FFFFFFFh | 0 |  | No | 0 | EEPROM=sdo_pdo.csdo_3.rx_sdo_id NUMBER_FORMAT=BASE16
 |  | 3 | 1 | RW | 4 |  |  | SDO server Node ID | Unsigned8 | 1 | 7Fh | 1 |  | No | 0 | EEPROM=sdo_pdo.csdo_3.node_id
 | 1284h | ---- | ---- | ---- | ---- |  |  | Client SDO 5 parameters | Record | N/A | N/A | ---- | Required by Masters only.. | ---- | ---- | OBJECT=SDO_PARAMETER SECTION=ClientServerSDOs CATEGORY=CONFIGURATION
 |  | 0 | 1 | RO | N/A |  |  | Number of entries | Unsigned8 | 0 | FFh | 3 |  | No | 0
 |  | 1 | 1 | RW | 4 |  |  | COB-ID Client->Server (tx) | Unsigned32 | 0 | 9FFFFFFFh | 0 |  | No | 0 | EEPROM=sdo_pdo.csdo_4.tx_sdo_id NUMBER_FORMAT=BASE16
 |  | 2 | 1 | RW | 4 |  |  | COB-ID Server->Client (rx) | Unsigned32 | 0 | 9FFFFFFFh | 0 |  | No | 0 | EEPROM=sdo_pdo.csdo_4.rx_sdo_id NUMBER_FORMAT=BASE16
 |  | 3 | 1 | RW | 4 |  |  | SDO server Node ID | Unsigned8 | 1 | 7Fh | 1 |  | No | 0 | EEPROM=sdo_pdo.csdo_4.node_id
 | 1285h | ---- | ---- | ---- | ---- |  |  | Client SDO 6 parameters | Record | N/A | N/A | ---- | Required by Masters only.. | ---- | ---- | OBJECT=SDO_PARAMETER SECTION=ClientServerSDOs CATEGORY=CONFIGURATION
 |  | 0 | 1 | RO | N/A |  |  | Number of entries | Unsigned8 | 0 | FFh | 3 |  | No | 0
 |  | 1 | 1 | RW | 4 |  |  | COB-ID Client->Server (tx) | Unsigned32 | 0 | 9FFFFFFFh | 0 |  | No | 0 | EEPROM=sdo_pdo.csdo_5.tx_sdo_id NUMBER_FORMAT=BASE16
 |  | 2 | 1 | RW | 4 |  |  | COB-ID Server->Client (rx) | Unsigned32 | 0 | 9FFFFFFFh | 0 |  | No | 0 | EEPROM=sdo_pdo.csdo_5.rx_sdo_id NUMBER_FORMAT=BASE16
 |  | 3 | 1 | RW | 4 |  |  | SDO server Node ID | Unsigned8 | 1 | 7Fh | 1 |  | No | 0 | EEPROM=sdo_pdo.csdo_5.node_id
 | 1286h | ---- | ---- | ---- | ---- |  |  | Client SDO 7 parameters | Record | N/A | N/A | ---- | Required by Masters only.. | ---- | ---- | OBJECT=SDO_PARAMETER SECTION=ClientServerSDOs CATEGORY=CONFIGURATION
 |  | 0 | 1 | RO | N/A |  |  | Number of entries | Unsigned8 | 0 | FFh | 3 |  | No | 0
 |  | 1 | 1 | RW | 4 |  |  | COB-ID Client->Server (tx) | Unsigned32 | 0 | 9FFFFFFFh | 0 |  | No | 0 | EEPROM=sdo_pdo.csdo_6.tx_sdo_id NUMBER_FORMAT=BASE16
 |  | 2 | 1 | RW | 4 |  |  | COB-ID Server->Client (rx) | Unsigned32 | 0 | 9FFFFFFFh | 0 |  | No | 0 | EEPROM=sdo_pdo.csdo_6.rx_sdo_id NUMBER_FORMAT=BASE16
 |  | 3 | 1 | RW | 4 |  |  | SDO server Node ID | Unsigned8 | 1 | 7Fh | 1 |  | No | 0 | EEPROM=sdo_pdo.csdo_6.node_id
 | 1287h | ---- | ---- | ---- | ---- |  |  | Client SDO 8 parameters | Record | N/A | N/A | ---- | Required by Masters only.. | ---- | ---- | OBJECT=SDO_PARAMETER SECTION=ClientServerSDOs CATEGORY=CONFIGURATION
 |  | 0 | 1 | RO | N/A |  |  | Number of entries | Unsigned8 | 0 | FFh | 3 |  | No | 0
 |  | 1 | 1 | RW | 4 |  |  | COB-ID Client->Server (tx) | Unsigned32 | 0 | 9FFFFFFFh | 0 |  | No | 0 | EEPROM=sdo_pdo.csdo_7.tx_sdo_id NUMBER_FORMAT=BASE16
 |  | 2 | 1 | RW | 4 |  |  | COB-ID Server->Client (rx) | Unsigned32 | 0 | 9FFFFFFFh | 0 |  | No | 0 | EEPROM=sdo_pdo.csdo_7.rx_sdo_id NUMBER_FORMAT=BASE16
 |  | 3 | 1 | RW | 4 |  |  | SDO server Node ID | Unsigned8 | 1 | 7Fh | 1 |  | No | 0 | EEPROM=sdo_pdo.csdo_7.node_id
 | 1400h | ---- | ---- | ---- | ---- |  |  | Receive PDO communication parameters 1 | Record | N/A | N/A | ---- | Communication setup for RPDO 1 | ---- | ---- | OBJECT=PDO_COMMUNICATION SECTION=RECEIVEPDO1 CATEGORY=CONFIGURATION
 |  | 0 | 1 | RO | N/A |  |  | Largest sub-index supported | Unsigned8 | 0 | FFh | 2 |  | No | 0
 |  | 1 | 1 | RW | 4 |  |  | COB-ID used by PDO | Unsigned32 | 00000001h | 9FFFFFFFh | 80000182h |  | No | 0 | EEPROM=sdo_pdo.rpdo_comm_0.cob_id NUMBER_FORMAT=BASE16
 |  | 2 | 1 | RW | 4 |  |  | Transmission type | Unsigned8 | 0 | FFh | 255 |  | No | 0 | EEPROM=sdo_pdo.rpdo_comm_0.trans_type
 | 1401h | ---- | ---- | ---- | ---- |  |  | Receive PDO communication parameters 2 | Record | N/A | N/A | ---- | Communication setup for RPDO 2 | ---- | ---- | OBJECT=PDO_COMMUNICATION SECTION=RECEIVEPDO2 CATEGORY=CONFIGURATION
 |  | 0 | 1 | RO | N/A |  |  | Largest sub-index supported | Unsigned8 | 0 | FFh | 2 |  | No | 0
 |  | 1 | 1 | RW | 4 |  |  | COB-ID used by PDO | Unsigned32 | 00000001h | 9FFFFFFFh | 80000282h |  | No | 0 | EEPROM=sdo_pdo.rpdo_comm_1.cob_id NUMBER_FORMAT=BASE16
 |  | 2 | 1 | RW | 4 |  |  | Transmission type | Unsigned8 | 0 | FFh | 255 |  | No | 0 | EEPROM=sdo_pdo.rpdo_comm_1.trans_type
 | 1402h | ---- | ---- | ---- | ---- |  |  | Receive PDO communication parameters 3 | Record | N/A | N/A | ---- | Communication setup for RPDO 3 | ---- | ---- | OBJECT=PDO_COMMUNICATION SECTION=RECEIVEPDO3 CATEGORY=CONFIGURATION
 |  | 0 | 1 | RO | N/A |  |  | Largest sub-index supported | Unsigned8 | 0 | FFh | 2 |  | No | 0
 |  | 1 | 1 | RW | 4 |  |  | COB-ID used by PDO | Unsigned32 | 00000001h | 9FFFFFFFh | 80000382h |  | No | 0 | EEPROM=sdo_pdo.rpdo_comm_2.cob_id NUMBER_FORMAT=BASE16
 |  | 2 | 1 | RW | 4 |  |  | Transmission type | Unsigned8 | 0 | FFh | 255 |  | No | 0 | EEPROM=sdo_pdo.rpdo_comm_2.trans_type
 | 1403h | ---- | ---- | ---- | ---- |  |  | Receive PDO communication parameters 4 | Record | N/A | N/A | ---- | Communication setup for RPDO 4 | ---- | ---- | OBJECT=PDO_COMMUNICATION SECTION=RECEIVEPDO4 CATEGORY=CONFIGURATION
 |  | 0 | 1 | RO | N/A |  |  | Largest sub-index supported | Unsigned8 | 0 | FFh | 2 |  | No | 0
 |  | 1 | 1 | RW | 4 |  |  | COB-ID used by PDO | Unsigned32 | 00000001h | 9FFFFFFFh | 80000183h |  | No | 0 | EEPROM=sdo_pdo.rpdo_comm_3.cob_id NUMBER_FORMAT=BASE16
 |  | 2 | 1 | RW | 4 |  |  | Transmission type | Unsigned8 | 0 | FFh | 255 |  | No | 0 | EEPROM=sdo_pdo.rpdo_comm_3.trans_type
 | 1404h | ---- | ---- | ---- | ---- |  |  | Receive PDO communication parameters 5 | Record | N/A | N/A | ---- | Communication setup for RPDO 5 | ---- | ---- | OBJECT=PDO_COMMUNICATION SECTION=RECEIVEPDO5 CATEGORY=CONFIGURATION
 |  | 0 | 1 | RO | N/A |  |  | Largest sub-index supported | Unsigned8 | 0 | FFh | 2 |  | No | 0
 |  | 1 | 1 | RW | 4 |  |  | COB-ID used by PDO | Unsigned32 | 00000001h | 9FFFFFFFh | 80000283h |  | No | 0 | EEPROM=sdo_pdo.rpdo_comm_4.cob_id NUMBER_FORMAT=BASE16
 |  | 2 | 1 | RW | 4 |  |  | Transmission type | Unsigned8 | 0 | FFh | 255 |  | No | 0 | EEPROM=sdo_pdo.rpdo_comm_4.trans_type
 | 1405h | ---- | ---- | ---- | ---- |  |  | Receive PDO communication parameters 6 | Record | N/A | N/A | ---- | Communication setup for RPDO 6 | ---- | ---- | OBJECT=PDO_COMMUNICATION SECTION=RECEIVEPDO6 CATEGORY=CONFIGURATION
 |  | 0 | 1 | RO | N/A |  |  | Largest sub-index supported | Unsigned8 | 0 | FFh | 2 |  | No | 0
 |  | 1 | 1 | RW | 4 |  |  | COB-ID used by PDO | Unsigned32 | 00000001h | 9FFFFFFFh | 80000383h |  | No | 0 | EEPROM=sdo_pdo.rpdo_comm_5.cob_id NUMBER_FORMAT=BASE16
 |  | 2 | 1 | RW | 4 |  |  | Transmission type | Unsigned8 | 0 | FFh | 255 |  | No | 0 | EEPROM=sdo_pdo.rpdo_comm_5.trans_type
 | 1406h | ---- | ---- | ---- | ---- |  |  | Receive PDO communication parameters 7 | Record | N/A | N/A | ---- | Communication setup for RPDO 7 | ---- | ---- | OBJECT=PDO_COMMUNICATION SECTION=RECEIVEPDO7 CATEGORY=CONFIGURATION
 |  | 0 | 1 | RO | N/A |  |  | Largest sub-index supported | Unsigned8 | 0 | FFh | 2 |  | No | 0
 |  | 1 | 1 | RW | 4 |  |  | COB-ID used by PDO | Unsigned32 | 00000001h | 9FFFFFFFh | 80000184h |  | No | 0 | EEPROM=sdo_pdo.rpdo_comm_6.cob_id NUMBER_FORMAT=BASE16
 |  | 2 | 1 | RW | 4 |  |  | Transmission type | Unsigned8 | 0 | FFh | 255 |  | No | 0 | EEPROM=sdo_pdo.rpdo_comm_6.trans_type
 | 1407h | ---- | ---- | ---- | ---- |  |  | Receive PDO communication parameters 8 | Record | N/A | N/A | ---- | Communication setup for RPDO 8 | ---- | ---- | OBJECT=PDO_COMMUNICATION SECTION=RECEIVEPDO8 CATEGORY=CONFIGURATION
 |  | 0 | 1 | RO | N/A |  |  | Largest sub-index supported | Unsigned8 | 0 | FFh | 2 |  | No | 0
 |  | 1 | 1 | RW | 4 |  |  | COB-ID used by PDO | Unsigned32 | 00000001h | 9FFFFFFFh | 80000284h |  | No | 0 | EEPROM=sdo_pdo.rpdo_comm_7.cob_id NUMBER_FORMAT=BASE16
 |  | 2 | 1 | RW | 4 |  |  | Transmission type | Unsigned8 | 0 | FFh | 255 |  | No | 0 | EEPROM=sdo_pdo.rpdo_comm_7.trans_type
 | 1408h | ---- | ---- | ---- | ---- |  |  | Receive PDO communication parameters 9 | Record | N/A | N/A | ---- | Communication setup for RPDO 9 | ---- | ---- | OBJECT=PDO_COMMUNICATION SECTION=RECEIVEPDO9 CATEGORY=CONFIGURATION
 |  | 0 | 1 | RO | N/A |  |  | Largest sub-index supported | Unsigned8 | 0 | FFh | 2 |  | No | 0
 |  | 1 | 1 | RW | 4 |  |  | COB-ID used by PDO | Unsigned32 | 00000001h | 9FFFFFFFh | 80000384h |  | No | 0 | EEPROM=sdo_pdo.rpdo_comm_8.cob_id NUMBER_FORMAT=BASE16
 |  | 2 | 1 | RW | 4 |  |  | Transmission type | Unsigned8 | 0 | FFh | 255 |  | No | 0 | EEPROM=sdo_pdo.rpdo_comm_8.trans_type
 | 1600h | ---- | ---- | ---- | ---- |  |  | Receive PDO mapping parameters 1 | Record | N/A | N/A | ---- | Mapping setup for RPDO 1 | ---- | ---- | OBJECT=RPDO_MAPPING SECTION=RECEIVEPDO1 CATEGORY=CONFIGURATION
 |  | 0 | 1 | RW | 4 |  |  | Number of mapped objects | Unsigned8 | 0 | FFh | 3 | Maximum of 8 mappings allowed. | No | 0 | EEPROM=sdo_pdo.rpdo_map_0.num_objects
 |  | 1 | 1 | RW | 4 |  |  | Map 1 | Unsigned32 | 0 | FFFFFFFFh | 20210210h |  | No | 0 | EEPROM=sdo_pdo.rpdo_map_0.object[0] NUMBER_FORMAT=BASE16
 |  | 2 | 1 | RW | 4 |  |  | Map 2 | Unsigned32 | 0 | FFFFFFFFh | 20210420h |  | No | 0 | EEPROM=sdo_pdo.rpdo_map_0.object[1] NUMBER_FORMAT=BASE16
 |  | 3 | 1 | RW | 4 |  |  | Map 3 | Unsigned32 | 0 | FFFFFFFFh | 20210610h |  | No | 0 | EEPROM=sdo_pdo.rpdo_map_0.object[2] NUMBER_FORMAT=BASE16
 |  | 4 | 1 | RW | 4 |  |  | Map 4 | Unsigned32 | 0 | FFFFFFFFh | 6C110410h |  | No | 0 | EEPROM=sdo_pdo.rpdo_map_0.object[3] NUMBER_FORMAT=BASE16
 |  | 5 | 1 | RW | 4 |  |  | Map 5 | Unsigned32 | 0 | FFFFFFFFh | 6C110110h |  | No | 0 | EEPROM=sdo_pdo.rpdo_map_0.object[4] NUMBER_FORMAT=BASE16
 |  | 6 | 1 | RW | 4 |  |  | Map 6 | Unsigned32 | 0 | FFFFFFFFh | 6C110110h |  | No | 0 | EEPROM=sdo_pdo.rpdo_map_0.object[5] NUMBER_FORMAT=BASE16
 |  | 7 | 1 | RW | 4 |  |  | Map 7 | Unsigned32 | 0 | FFFFFFFFh | 6C110110h |  | No | 0 | EEPROM=sdo_pdo.rpdo_map_0.object[6] NUMBER_FORMAT=BASE16
 |  | 8 | 1 | RW | 4 |  |  | Map 8 | Unsigned32 | 0 | FFFFFFFFh | 6C110110h |  | No | 0 | EEPROM=sdo_pdo.rpdo_map_0.object[7] NUMBER_FORMAT=BASE16
 | 1601h | ---- | ---- | ---- | ---- |  |  | Receive PDO mapping parameters 2 | Record | N/A | N/A | ---- | Mapping setup for RPDO 2 | ---- | ---- | OBJECT=RPDO_MAPPING SECTION=RECEIVEPDO2 CATEGORY=CONFIGURATION
 |  | 0 | 1 | RW | 4 |  |  | Number of mapped objects | Unsigned8 | 0 | FFh | 8 | Maximum of 8 mappings allowed. | No | 0 | EEPROM=sdo_pdo.rpdo_map_1.num_objects
 |  | 1 | 1 | RW | 4 |  |  | Map 1 | Unsigned32 | 0 | FFFFFFFFh | 21200001h |  | No | 0 | EEPROM=sdo_pdo.rpdo_map_1.object[0] NUMBER_FORMAT=BASE16
 |  | 2 | 1 | RW | 4 |  |  | Map 2 | Unsigned32 | 0 | FFFFFFFFh | 21210001h |  | No | 0 | EEPROM=sdo_pdo.rpdo_map_1.object[1] NUMBER_FORMAT=BASE16
 |  | 3 | 1 | RW | 4 |  |  | Map 3 | Unsigned32 | 0 | FFFFFFFFh | 21220001h |  | No | 0 | EEPROM=sdo_pdo.rpdo_map_1.object[2] NUMBER_FORMAT=BASE16
 |  | 4 | 1 | RW | 4 |  |  | Map 4 | Unsigned32 | 0 | FFFFFFFFh | 21230001h |  | No | 0 | EEPROM=sdo_pdo.rpdo_map_1.object[3] NUMBER_FORMAT=BASE16
 |  | 5 | 1 | RW | 4 |  |  | Map 5 | Unsigned32 | 0 | FFFFFFFFh | 21240001h |  | No | 0 | EEPROM=sdo_pdo.rpdo_map_1.object[4] NUMBER_FORMAT=BASE16
 |  | 6 | 1 | RW | 4 |  |  | Map 6 | Unsigned32 | 0 | FFFFFFFFh | 21250001h |  | No | 0 | EEPROM=sdo_pdo.rpdo_map_1.object[5] NUMBER_FORMAT=BASE16
 |  | 7 | 1 | RW | 4 |  |  | Map 7 | Unsigned32 | 0 | FFFFFFFFh | 21260001h |  | No | 0 | EEPROM=sdo_pdo.rpdo_map_1.object[6] NUMBER_FORMAT=BASE16
 |  | 8 | 1 | RW | 4 |  |  | Map 8 | Unsigned32 | 0 | FFFFFFFFh | 21270001h |  | No | 0 | EEPROM=sdo_pdo.rpdo_map_1.object[7] NUMBER_FORMAT=BASE16
 | 1602h | ---- | ---- | ---- | ---- |  |  | Receive PDO mapping parameters 3 | Record | N/A | N/A | ---- | Mapping setup for RPDO 3 | ---- | ---- | OBJECT=RPDO_MAPPING SECTION=RECEIVEPDO3 CATEGORY=CONFIGURATION
 |  | 0 | 1 | RW | 4 |  |  | Number of mapped objects | Unsigned8 | 0 | FFh | 4 | Maximum of 8 mappings allowed. | No | 0 | EEPROM=sdo_pdo.rpdo_map_2.num_objects
 |  | 1 | 1 | RW | 4 |  |  | Map 1 | Unsigned32 | 0 | FFFFFFFFh | 22200010h |  | No | 0 | EEPROM=sdo_pdo.rpdo_map_2.object[0] NUMBER_FORMAT=BASE16
 |  | 2 | 1 | RW | 4 |  |  | Map 2 | Unsigned32 | 0 | FFFFFFFFh | 22210010h |  | No | 0 | EEPROM=sdo_pdo.rpdo_map_2.object[1] NUMBER_FORMAT=BASE16
 |  | 3 | 1 | RW | 4 |  |  | Map 3 | Unsigned32 | 0 | FFFFFFFFh | 22220010h |  | No | 0 | EEPROM=sdo_pdo.rpdo_map_2.object[2] NUMBER_FORMAT=BASE16
 |  | 4 | 1 | RW | 4 |  |  | Map 4 | Unsigned32 | 0 | FFFFFFFFh | 22230010h |  | No | 0 | EEPROM=sdo_pdo.rpdo_map_2.object[3] NUMBER_FORMAT=BASE16
 |  | 5 | 1 | RW | 4 |  |  | Map 5 | Unsigned32 | 0 | FFFFFFFFh | 6C110110h |  | No | 0 | EEPROM=sdo_pdo.rpdo_map_2.object[4] NUMBER_FORMAT=BASE16
 |  | 6 | 1 | RW | 4 |  |  | Map 6 | Unsigned32 | 0 | FFFFFFFFh | 6C110110h |  | No | 0 | EEPROM=sdo_pdo.rpdo_map_2.object[5] NUMBER_FORMAT=BASE16
 |  | 7 | 1 | RW | 4 |  |  | Map 7 | Unsigned32 | 0 | FFFFFFFFh | 6C110110h |  | No | 0 | EEPROM=sdo_pdo.rpdo_map_2.object[6] NUMBER_FORMAT=BASE16
 |  | 8 | 1 | RW | 4 |  |  | Map 8 | Unsigned32 | 0 | FFFFFFFFh | 6C110110h |  | No | 0 | EEPROM=sdo_pdo.rpdo_map_2.object[7] NUMBER_FORMAT=BASE16
 | 1603h | ---- | ---- | ---- | ---- |  |  | Receive PDO mapping parameters 4 | Record | N/A | N/A | ---- | Mapping setup for RPDO 4 | ---- | ---- | OBJECT=RPDO_MAPPING SECTION=RECEIVEPDO4 CATEGORY=CONFIGURATION
 |  | 0 | 1 | RW | 4 |  |  | Number of mapped objects | Unsigned8 | 0 | FFh | 3 | Maximum of 8 mappings allowed. | No | 0 | EEPROM=sdo_pdo.rpdo_map_3.num_objects
 |  | 1 | 1 | RW | 4 |  |  | Map 1 | Unsigned32 | 0 | FFFFFFFFh | 20400210h |  | No | 0 | EEPROM=sdo_pdo.rpdo_map_3.object[0] NUMBER_FORMAT=BASE16
 |  | 2 | 1 | RW | 4 |  |  | Map 2 | Unsigned32 | 0 | FFFFFFFFh | 20400420h |  | No | 0 | EEPROM=sdo_pdo.rpdo_map_3.object[1] NUMBER_FORMAT=BASE16
 |  | 3 | 1 | RW | 4 |  |  | Map 3 | Unsigned32 | 0 | FFFFFFFFh | 20400610h |  | No | 0 | EEPROM=sdo_pdo.rpdo_map_3.object[2] NUMBER_FORMAT=BASE16
 |  | 4 | 1 | RW | 4 |  |  | Map 4 | Unsigned32 | 0 | FFFFFFFFh | 6C110110h |  | No | 0 | EEPROM=sdo_pdo.rpdo_map_3.object[3] NUMBER_FORMAT=BASE16
 |  | 5 | 1 | RW | 4 |  |  | Map 5 | Unsigned32 | 0 | FFFFFFFFh | 6C110110h |  | No | 0 | EEPROM=sdo_pdo.rpdo_map_3.object[4] NUMBER_FORMAT=BASE16
 |  | 6 | 1 | RW | 4 |  |  | Map 6 | Unsigned32 | 0 | FFFFFFFFh | 6C110110h |  | No | 0 | EEPROM=sdo_pdo.rpdo_map_3.object[5] NUMBER_FORMAT=BASE16
 |  | 7 | 1 | RW | 4 |  |  | Map 7 | Unsigned32 | 0 | FFFFFFFFh | 6C110110h |  | No | 0 | EEPROM=sdo_pdo.rpdo_map_3.object[6] NUMBER_FORMAT=BASE16
 |  | 8 | 1 | RW | 4 |  |  | Map 8 | Unsigned32 | 0 | FFFFFFFFh | 6C110110h |  | No | 0 | EEPROM=sdo_pdo.rpdo_map_3.object[7] NUMBER_FORMAT=BASE16
 | 1604h | ---- | ---- | ---- | ---- |  |  | Receive PDO mapping parameters 5 | Record | N/A | N/A | ---- | Mapping setup for RPDO 5 | ---- | ---- | OBJECT=RPDO_MAPPING SECTION=RECEIVEPDO5 CATEGORY=CONFIGURATION
 |  | 0 | 1 | RW | 4 |  |  | Number of mapped objects | Unsigned8 | 0 | FFh | 7 | Maximum of 8 mappings allowed. | No | 0 | EEPROM=sdo_pdo.rpdo_map_4.num_objects
 |  | 1 | 1 | RW | 4 |  |  | Map 1 | Unsigned32 | 0 | FFFFFFFFh | 21400001h |  | No | 0 | EEPROM=sdo_pdo.rpdo_map_4.object[0] NUMBER_FORMAT=BASE16
 |  | 2 | 1 | RW | 4 |  |  | Map 2 | Unsigned32 | 0 | FFFFFFFFh | 21410001h |  | No | 0 | EEPROM=sdo_pdo.rpdo_map_4.object[1] NUMBER_FORMAT=BASE16
 |  | 3 | 1 | RW | 4 |  |  | Map 3 | Unsigned32 | 0 | FFFFFFFFh | 21420001h |  | No | 0 | EEPROM=sdo_pdo.rpdo_map_4.object[2] NUMBER_FORMAT=BASE16
 |  | 4 | 1 | RW | 4 |  |  | Map 4 | Unsigned32 | 0 | FFFFFFFFh | 21430001h |  | No | 0 | EEPROM=sdo_pdo.rpdo_map_4.object[3] NUMBER_FORMAT=BASE16
 |  | 5 | 1 | RW | 4 |  |  | Map 5 | Unsigned32 | 0 | FFFFFFFFh | 21440001h |  | No | 0 | EEPROM=sdo_pdo.rpdo_map_4.object[4] NUMBER_FORMAT=BASE16
 |  | 6 | 1 | RW | 4 |  |  | Map 6 | Unsigned32 | 0 | FFFFFFFFh | 21450001h |  | No | 0 | EEPROM=sdo_pdo.rpdo_map_4.object[5] NUMBER_FORMAT=BASE16
 |  | 7 | 1 | RW | 4 |  |  | Map 7 | Unsigned32 | 0 | FFFFFFFFh | 21460001h |  | No | 0 | EEPROM=sdo_pdo.rpdo_map_4.object[6] NUMBER_FORMAT=BASE16
 |  | 8 | 1 | RW | 4 |  |  | Map 8 | Unsigned32 | 0 | FFFFFFFFh | 6C110110h |  | No | 0 | EEPROM=sdo_pdo.rpdo_map_4.object[7] NUMBER_FORMAT=BASE16
 | 1605h | ---- | ---- | ---- | ---- |  |  | Receive PDO mapping parameters 6 | Record | N/A | N/A | ---- | Mapping setup for RPDO 6 | ---- | ---- | OBJECT=RPDO_MAPPING SECTION=RECEIVEPDO6 CATEGORY=CONFIGURATION
 |  | 0 | 1 | RW | 4 |  |  | Number of mapped objects | Unsigned8 | 0 | FFh | 2 | Maximum of 8 mappings allowed. | No | 0 | EEPROM=sdo_pdo.rpdo_map_5.num_objects
 |  | 1 | 1 | RW | 4 |  |  | Map 1 | Unsigned32 | 0 | FFFFFFFFh | 22400010h |  | No | 0 | EEPROM=sdo_pdo.rpdo_map_5.object[0] NUMBER_FORMAT=BASE16
 |  | 2 | 1 | RW | 4 |  |  | Map 2 | Unsigned32 | 0 | FFFFFFFFh | 22410010h |  | No | 0 | EEPROM=sdo_pdo.rpdo_map_5.object[1] NUMBER_FORMAT=BASE16
 |  | 3 | 1 | RW | 4 |  |  | Map 3 | Unsigned32 | 0 | FFFFFFFFh | 6C110110h |  | No | 0 | EEPROM=sdo_pdo.rpdo_map_5.object[2] NUMBER_FORMAT=BASE16
 |  | 4 | 1 | RW | 4 |  |  | Map 4 | Unsigned32 | 0 | FFFFFFFFh | 6C110110h |  | No | 0 | EEPROM=sdo_pdo.rpdo_map_5.object[3] NUMBER_FORMAT=BASE16
 |  | 5 | 1 | RW | 4 |  |  | Map 5 | Unsigned32 | 0 | FFFFFFFFh | 6C110110h |  | No | 0 | EEPROM=sdo_pdo.rpdo_map_5.object[4] NUMBER_FORMAT=BASE16
 |  | 6 | 1 | RW | 4 |  |  | Map 6 | Unsigned32 | 0 | FFFFFFFFh | 6C110110h |  | No | 0 | EEPROM=sdo_pdo.rpdo_map_5.object[5] NUMBER_FORMAT=BASE16
 |  | 7 | 1 | RW | 4 |  |  | Map 7 | Unsigned32 | 0 | FFFFFFFFh | 6C110110h |  | No | 0 | EEPROM=sdo_pdo.rpdo_map_5.object[6] NUMBER_FORMAT=BASE16
 |  | 8 | 1 | RW | 4 |  |  | Map 8 | Unsigned32 | 0 | FFFFFFFFh | 6C110110h |  | No | 0 | EEPROM=sdo_pdo.rpdo_map_5.object[7] NUMBER_FORMAT=BASE16
 | 1606h | ---- | ---- | ---- | ---- |  |  | Receive PDO mapping parameters 7 | Record | N/A | N/A | ---- | Mapping setup for RPDO 7 | ---- | ---- | OBJECT=RPDO_MAPPING SECTION=RECEIVEPDO7 CATEGORY=CONFIGURATION
 |  | 0 | 1 | RW | 4 |  |  | Number of mapped objects | Unsigned8 | 0 | FFh | 3 | Maximum of 8 mappings allowed. | No | 0 | EEPROM=sdo_pdo.rpdo_map_6.num_objects
 |  | 1 | 1 | RW | 4 |  |  | Map 1 | Unsigned32 | 0 | FFFFFFFFh | 20600210h |  | No | 0 | EEPROM=sdo_pdo.rpdo_map_6.object[0] NUMBER_FORMAT=BASE16
 |  | 2 | 1 | RW | 4 |  |  | Map 2 | Unsigned32 | 0 | FFFFFFFFh | 20600420h |  | No | 0 | EEPROM=sdo_pdo.rpdo_map_6.object[1] NUMBER_FORMAT=BASE16
 |  | 3 | 1 | RW | 4 |  |  | Map 3 | Unsigned32 | 0 | FFFFFFFFh | 20600610h |  | No | 0 | EEPROM=sdo_pdo.rpdo_map_6.object[2] NUMBER_FORMAT=BASE16
 |  | 4 | 1 | RW | 4 |  |  | Map 4 | Unsigned32 | 0 | FFFFFFFFh | 6C110110h |  | No | 0 | EEPROM=sdo_pdo.rpdo_map_6.object[3] NUMBER_FORMAT=BASE16
 |  | 5 | 1 | RW | 4 |  |  | Map 5 | Unsigned32 | 0 | FFFFFFFFh | 6C110110h |  | No | 0 | EEPROM=sdo_pdo.rpdo_map_6.object[4] NUMBER_FORMAT=BASE16
 |  | 6 | 1 | RW | 4 |  |  | Map 6 | Unsigned32 | 0 | FFFFFFFFh | 6C110110h |  | No | 0 | EEPROM=sdo_pdo.rpdo_map_6.object[5] NUMBER_FORMAT=BASE16
 |  | 7 | 1 | RW | 4 |  |  | Map 7 | Unsigned32 | 0 | FFFFFFFFh | 6C110110h |  | No | 0 | EEPROM=sdo_pdo.rpdo_map_6.object[6] NUMBER_FORMAT=BASE16
 |  | 8 | 1 | RW | 4 |  |  | Map 8 | Unsigned32 | 0 | FFFFFFFFh | 6C110110h |  | No | 0 | EEPROM=sdo_pdo.rpdo_map_6.object[7] NUMBER_FORMAT=BASE16
 | 1607h | ---- | ---- | ---- | ---- |  |  | Receive PDO mapping parameters 8 | Record | N/A | N/A | ---- | Mapping setup for RPDO 8 | ---- | ---- | OBJECT=RPDO_MAPPING SECTION=RECEIVEPDO8 CATEGORY=CONFIGURATION
 |  | 0 | 1 | RW | 4 |  |  | Number of mapped objects | Unsigned8 | 0 | FFh | 0 | Maximum of 8 mappings allowed. | No | 0 | EEPROM=sdo_pdo.rpdo_map_7.num_objects
 |  | 1 | 1 | RW | 4 |  |  | Map 1 | Unsigned32 | 0 | FFFFFFFFh | 6C110110h |  | No | 0 | EEPROM=sdo_pdo.rpdo_map_7.object[0] NUMBER_FORMAT=BASE16
 |  | 2 | 1 | RW | 4 |  |  | Map 2 | Unsigned32 | 0 | FFFFFFFFh | 6C110110h |  | No | 0 | EEPROM=sdo_pdo.rpdo_map_7.object[1] NUMBER_FORMAT=BASE16
 |  | 3 | 1 | RW | 4 |  |  | Map 3 | Unsigned32 | 0 | FFFFFFFFh | 6C110110h |  | No | 0 | EEPROM=sdo_pdo.rpdo_map_7.object[2] NUMBER_FORMAT=BASE16
 |  | 4 | 1 | RW | 4 |  |  | Map 4 | Unsigned32 | 0 | FFFFFFFFh | 6C110110h |  | No | 0 | EEPROM=sdo_pdo.rpdo_map_7.object[3] NUMBER_FORMAT=BASE16
 |  | 5 | 1 | RW | 4 |  |  | Map 5 | Unsigned32 | 0 | FFFFFFFFh | 6C110110h |  | No | 0 | EEPROM=sdo_pdo.rpdo_map_7.object[4] NUMBER_FORMAT=BASE16
 |  | 6 | 1 | RW | 4 |  |  | Map 6 | Unsigned32 | 0 | FFFFFFFFh | 6C110110h |  | No | 0 | EEPROM=sdo_pdo.rpdo_map_7.object[5] NUMBER_FORMAT=BASE16
 |  | 7 | 1 | RW | 4 |  |  | Map 7 | Unsigned32 | 0 | FFFFFFFFh | 6C110110h |  | No | 0 | EEPROM=sdo_pdo.rpdo_map_7.object[6] NUMBER_FORMAT=BASE16
 |  | 8 | 1 | RW | 4 |  |  | Map 8 | Unsigned32 | 0 | FFFFFFFFh | 6C110110h |  | No | 0 | EEPROM=sdo_pdo.rpdo_map_7.object[7] NUMBER_FORMAT=BASE16
 | 1608h | ---- | ---- | ---- | ---- |  |  | Receive PDO mapping parameters 9 | Record | N/A | N/A | ---- | Mapping setup for RPDO 9 | ---- | ---- | OBJECT=RPDO_MAPPING SECTION=RECEIVEPDO9 CATEGORY=CONFIGURATION
 |  | 0 | 1 | RW | 4 |  |  | Number of mapped objects | Unsigned8 | 0 | FFh | 0 | Maximum of 8 mappings allowed. | No | 0 | EEPROM=sdo_pdo.rpdo_map_8.num_objects
 |  | 1 | 1 | RW | 4 |  |  | Map 1 | Unsigned32 | 0 | FFFFFFFFh | 6C110110h |  | No | 0 | EEPROM=sdo_pdo.rpdo_map_8.object[0] NUMBER_FORMAT=BASE16
 |  | 2 | 1 | RW | 4 |  |  | Map 2 | Unsigned32 | 0 | FFFFFFFFh | 6C110110h |  | No | 0 | EEPROM=sdo_pdo.rpdo_map_8.object[1] NUMBER_FORMAT=BASE16
 |  | 3 | 1 | RW | 4 |  |  | Map 3 | Unsigned32 | 0 | FFFFFFFFh | 6C110110h |  | No | 0 | EEPROM=sdo_pdo.rpdo_map_8.object[2] NUMBER_FORMAT=BASE16
 |  | 4 | 1 | RW | 4 |  |  | Map 4 | Unsigned32 | 0 | FFFFFFFFh | 6C110110h |  | No | 0 | EEPROM=sdo_pdo.rpdo_map_8.object[3] NUMBER_FORMAT=BASE16
 |  | 5 | 1 | RW | 4 |  |  | Map 5 | Unsigned32 | 0 | FFFFFFFFh | 6C110110h |  | No | 0 | EEPROM=sdo_pdo.rpdo_map_8.object[4] NUMBER_FORMAT=BASE16
 |  | 6 | 1 | RW | 4 |  |  | Map 6 | Unsigned32 | 0 | FFFFFFFFh | 6C110110h |  | No | 0 | EEPROM=sdo_pdo.rpdo_map_8.object[5] NUMBER_FORMAT=BASE16
 |  | 7 | 1 | RW | 4 |  |  | Map 7 | Unsigned32 | 0 | FFFFFFFFh | 6C110110h |  | No | 0 | EEPROM=sdo_pdo.rpdo_map_8.object[6] NUMBER_FORMAT=BASE16
 |  | 8 | 1 | RW | 4 |  |  | Map 8 | Unsigned32 | 0 | FFFFFFFFh | 6C110110h |  | No | 0 | EEPROM=sdo_pdo.rpdo_map_8.object[7] NUMBER_FORMAT=BASE16
 | 1800h | ---- | ---- | ---- | ---- |  |  | Transmit PDO communication parameters 1 | Record | N/A | N/A | ---- | Communication setup for TPDO 1 | ---- | ---- | OBJECT=PDO_COMMUNICATION SECTION=TRANSMITPDO1 CATEGORY=CONFIGURATION
 |  | 0 | 1 | RO | N/A |  |  | Largest sub-index supported | Unsigned8 | 0 | FFh | 5 |  | No | 0
 |  | 1 | 1 | RW | 4 |  |  | COB-ID used by PDO | Unsigned32 | 00000001h | 9FFFFFFFh | 80000202h |  | No | 0 | EEPROM=sdo_pdo.tpdo_comm_0.cob_id NUMBER_FORMAT=BASE16
 |  | 2 | 1 | RW | 4 |  |  | Transmission type | Unsigned8 | 0 | FFh | 1 |  | No | 0 | EEPROM=sdo_pdo.tpdo_comm_0.trans_type
 |  | 3 | 1 | RW | 4 | 0.1 | ms | Inhibit time | Unsigned16 | 0 | 7FFFh | 0 |  | No | 0 | EEPROM=sdo_pdo.tpdo_comm_0.inhibit_time
 |  | 5 | 1 | RW | 4 |  | ms | Event timer | Unsigned16 | 0 | 7FFFh | 0 |  | No | 0 | EEPROM=sdo_pdo.tpdo_comm_0.w_event_timer_reload
 | 1801h | ---- | ---- | ---- | ---- |  |  | Transmit PDO communication parameters 2 | Record | N/A | N/A | ---- | Communication setup for TPDO 2 | ---- | ---- | OBJECT=PDO_COMMUNICATION SECTION=TRANSMITPDO2 CATEGORY=CONFIGURATION
 |  | 0 | 1 | RO | N/A |  |  | Largest sub-index supported | Unsigned8 | 0 | FFh | 5 |  | No | 0
 |  | 1 | 1 | RW | 4 |  |  | COB-ID used by PDO | Unsigned32 | 00000001h | 9FFFFFFFh | 80000302h |  | No | 0 | EEPROM=sdo_pdo.tpdo_comm_1.cob_id NUMBER_FORMAT=BASE16
 |  | 2 | 1 | RW | 4 |  |  | Transmission type | Unsigned8 | 0 | FFh | FFh |  | No | 0 | EEPROM=sdo_pdo.tpdo_comm_1.trans_type
 |  | 3 | 1 | RW | 4 | 0.1 | ms | Inhibit time | Unsigned16 | 0 | 7FFFh | 0 |  | No | 0 | EEPROM=sdo_pdo.tpdo_comm_1.inhibit_time
 |  | 5 | 1 | RW | 4 |  | ms | Event timer | Unsigned16 | 0 | 7FFFh | 0 |  | No | 0 | EEPROM=sdo_pdo.tpdo_comm_1.w_event_timer_reload
 | 1802h | ---- | ---- | ---- | ---- |  |  | Transmit PDO communication parameters 3 | Record | N/A | N/A | ---- | Communication setup for TPDO 3 | ---- | ---- | OBJECT=PDO_COMMUNICATION SECTION=TRANSMITPDO3 CATEGORY=CONFIGURATION
 |  | 0 | 1 | RO | N/A |  |  | Largest sub-index supported | Unsigned8 | 0 | FFh | 5 |  | No | 0
 |  | 1 | 1 | RW | 4 |  |  | COB-ID used by PDO | Unsigned32 | 00000001h | 9FFFFFFFh | 80000402h |  | No | 0 | EEPROM=sdo_pdo.tpdo_comm_2.cob_id NUMBER_FORMAT=BASE16
 |  | 2 | 1 | RW | 4 |  |  | Transmission type | Unsigned8 | 0 | FFh | FFh |  | No | 0 | EEPROM=sdo_pdo.tpdo_comm_2.trans_type
 |  | 3 | 1 | RW | 4 | 0.1 | ms | Inhibit time | Unsigned16 | 0 | 7FFFh | 0 |  | No | 0 | EEPROM=sdo_pdo.tpdo_comm_2.inhibit_time
 |  | 5 | 1 | RW | 4 |  | ms | Event timer | Unsigned16 | 0 | 7FFFh | 0 |  | No | 0 | EEPROM=sdo_pdo.tpdo_comm_2.w_event_timer_reload
 | 1803h | ---- | ---- | ---- | ---- |  |  | Transmit PDO communication parameters 4 | Record | N/A | N/A | ---- | Communication setup for TPDO 4 | ---- | ---- | OBJECT=PDO_COMMUNICATION SECTION=TRANSMITPDO4 CATEGORY=CONFIGURATION
 |  | 0 | 1 | RO | N/A |  |  | Largest sub-index supported | Unsigned8 | 0 | FFh | 5 |  | No | 0
 |  | 1 | 1 | RW | 4 |  |  | COB-ID used by PDO | Unsigned32 | 00000001h | 9FFFFFFFh | 80000203h |  | No | 0 | EEPROM=sdo_pdo.tpdo_comm_3.cob_id NUMBER_FORMAT=BASE16
 |  | 2 | 1 | RW | 4 |  |  | Transmission type | Unsigned8 | 0 | FFh | 1 |  | No | 0 | EEPROM=sdo_pdo.tpdo_comm_3.trans_type
 |  | 3 | 1 | RW | 4 | 0.1 | ms | Inhibit time | Unsigned16 | 0 | 7FFFh | 0 |  | No | 0 | EEPROM=sdo_pdo.tpdo_comm_3.inhibit_time
 |  | 5 | 1 | RW | 4 |  | ms | Event timer | Unsigned16 | 0 | 7FFFh | 0 |  | No | 0 | EEPROM=sdo_pdo.tpdo_comm_3.w_event_timer_reload
 | 1804h | ---- | ---- | ---- | ---- |  |  | Transmit PDO communication parameters 5 | Record | N/A | N/A | ---- | Communication setup for TPDO 5 | ---- | ---- | OBJECT=PDO_COMMUNICATION SECTION=TRANSMITPDO5 CATEGORY=CONFIGURATION
 |  | 0 | 1 | RO | N/A |  |  | Largest sub-index supported | Unsigned8 | 0 | FFh | 5 |  | No | 0
 |  | 1 | 1 | RW | 4 |  |  | COB-ID used by PDO | Unsigned32 | 00000001h | 9FFFFFFFh | 80000303h |  | No | 0 | EEPROM=sdo_pdo.tpdo_comm_4.cob_id NUMBER_FORMAT=BASE16
 |  | 2 | 1 | RW | 4 |  |  | Transmission type | Unsigned8 | 0 | FFh | FFh |  | No | 0 | EEPROM=sdo_pdo.tpdo_comm_4.trans_type
 |  | 3 | 1 | RW | 4 | 0.1 | ms | Inhibit time | Unsigned16 | 0 | 7FFFh | 0 |  | No | 0 | EEPROM=sdo_pdo.tpdo_comm_4.inhibit_time
 |  | 5 | 1 | RW | 4 |  | ms | Event timer | Unsigned16 | 0 | 7FFFh | 0 |  | No | 0 | EEPROM=sdo_pdo.tpdo_comm_4.w_event_timer_reload
 | 1805h | ---- | ---- | ---- | ---- |  |  | Transmit PDO communication parameters 6 | Record | N/A | N/A | ---- | Communication setup for TPDO 6 | ---- | ---- | OBJECT=PDO_COMMUNICATION SECTION=TRANSMITPDO6 CATEGORY=CONFIGURATION
 |  | 0 | 1 | RO | N/A |  |  | Largest sub-index supported | Unsigned8 | 0 | FFh | 5 |  | No | 0
 |  | 1 | 1 | RW | 4 |  |  | COB-ID used by PDO | Unsigned32 | 00000001h | 9FFFFFFFh | 80000403h |  | No | 0 | EEPROM=sdo_pdo.tpdo_comm_5.cob_id NUMBER_FORMAT=BASE16
 |  | 2 | 1 | RW | 4 |  |  | Transmission type | Unsigned8 | 0 | FFh | FFh |  | No | 0 | EEPROM=sdo_pdo.tpdo_comm_5.trans_type
 |  | 3 | 1 | RW | 4 | 0.1 | ms | Inhibit time | Unsigned16 | 0 | 7FFFh | 0 |  | No | 0 | EEPROM=sdo_pdo.tpdo_comm_5.inhibit_time
 |  | 5 | 1 | RW | 4 |  | ms | Event timer | Unsigned16 | 0 | 7FFFh | 0 |  | No | 0 | EEPROM=sdo_pdo.tpdo_comm_5.w_event_timer_reload
 | 1806h | ---- | ---- | ---- | ---- |  |  | Transmit PDO communication parameters 7 | Record | N/A | N/A | ---- | Communication setup for TPDO 7 | ---- | ---- | OBJECT=PDO_COMMUNICATION SECTION=TRANSMITPDO7 CATEGORY=CONFIGURATION
 |  | 0 | 1 | RO | N/A |  |  | Largest sub-index supported | Unsigned8 | 0 | FFh | 5 |  | No | 0
 |  | 1 | 1 | RW | 4 |  |  | COB-ID used by PDO | Unsigned32 | 00000001h | 9FFFFFFFh | 80000204h |  | No | 0 | EEPROM=sdo_pdo.tpdo_comm_6.cob_id NUMBER_FORMAT=BASE16
 |  | 2 | 1 | RW | 4 |  |  | Transmission type | Unsigned8 | 0 | FFh | 1 |  | No | 0 | EEPROM=sdo_pdo.tpdo_comm_6.trans_type
 |  | 3 | 1 | RW | 4 | 0.1 | ms | Inhibit time | Unsigned16 | 0 | 7FFFh | 0 |  | No | 0 | EEPROM=sdo_pdo.tpdo_comm_6.inhibit_time
 |  | 5 | 1 | RW | 4 |  | ms | Event timer | Unsigned16 | 0 | 7FFFh | 0 |  | No | 0 | EEPROM=sdo_pdo.tpdo_comm_6.w_event_timer_reload
 | 1807h | ---- | ---- | ---- | ---- |  |  | Transmit PDO communication parameters 8 | Record | N/A | N/A | ---- | Communication setup for TPDO 8 | ---- | ---- | OBJECT=PDO_COMMUNICATION SECTION=TRANSMITPDO8 CATEGORY=CONFIGURATION
 |  | 0 | 1 | RO | N/A |  |  | Largest sub-index supported | Unsigned8 | 0 | FFh | 5 |  | No | 0
 |  | 1 | 1 | RW | 4 |  |  | COB-ID used by PDO | Unsigned32 | 00000001h | 9FFFFFFFh | 80000304h |  | No | 0 | EEPROM=sdo_pdo.tpdo_comm_7.cob_id NUMBER_FORMAT=BASE16
 |  | 2 | 1 | RW | 4 |  |  | Transmission type | Unsigned8 | 0 | FFh | FFh |  | No | 0 | EEPROM=sdo_pdo.tpdo_comm_7.trans_type
 |  | 3 | 1 | RW | 4 | 0.1 | ms | Inhibit time | Unsigned16 | 0 | 7FFFh | 0 |  | No | 0 | EEPROM=sdo_pdo.tpdo_comm_7.inhibit_time
 |  | 5 | 1 | RW | 4 |  | ms | Event timer | Unsigned16 | 0 | 7FFFh | 0 |  | No | 0 | EEPROM=sdo_pdo.tpdo_comm_7.w_event_timer_reload
 | 1808h | ---- | ---- | ---- | ---- |  |  | Transmit PDO communication parameters 9 | Record | N/A | N/A | ---- | Communication setup for TPDO 9 | ---- | ---- | OBJECT=PDO_COMMUNICATION SECTION=TRANSMITPDO9 CATEGORY=CONFIGURATION
 |  | 0 | 1 | RO | N/A |  |  | Largest sub-index supported | Unsigned8 | 0 | FFh | 5 |  | No | 0
 |  | 1 | 1 | RW | 4 |  |  | COB-ID used by PDO | Unsigned32 | 00000001h | 9FFFFFFFh | 80000404h |  | No | 0 | EEPROM=sdo_pdo.tpdo_comm_8.cob_id NUMBER_FORMAT=BASE16
 |  | 2 | 1 | RW | 4 |  |  | Transmission type | Unsigned8 | 0 | FFh | FFh |  | No | 0 | EEPROM=sdo_pdo.tpdo_comm_8.trans_type
 |  | 3 | 1 | RW | 4 | 0.1 | ms | Inhibit time | Unsigned16 | 0 | 7FFFh | 0 |  | No | 0 | EEPROM=sdo_pdo.tpdo_comm_8.inhibit_time
 |  | 5 | 1 | RW | 4 |  | ms | Event timer | Unsigned16 | 0 | 7FFFh | 0 |  | No | 0 | EEPROM=sdo_pdo.tpdo_comm_8.w_event_timer_reload
 | 1A00h | ---- | ---- | ---- | ---- |  |  | Transmit PDO mapping parameters 1 | Record | N/A | N/A | ---- | Mapping setup for TPDO 1 | ---- | ---- | OBJECT=TPDO_MAPPING SECTION=TRANSMITPDO1 CATEGORY=CONFIGURATION
 |  | 0 | 1 | RW | 4 |  |  | Number of mapped objects | Unsigned8 | 0 | FFh | 3 | Maximum of 8 mappings allowed. | No | 0 | EEPROM=sdo_pdo.tpdo_map_0.num_objects
 |  | 1 | 1 | RW | 4 |  |  | Map 1 | Unsigned32 | 0 | FFFFFFFFh | 20210110h |  | No | 0 | EEPROM=sdo_pdo.tpdo_map_0.object[0] NUMBER_FORMAT=BASE16
 |  | 2 | 1 | RW | 4 |  |  | Map 2 | Unsigned32 | 0 | FFFFFFFFh | 20210320h |  | No | 0 | EEPROM=sdo_pdo.tpdo_map_0.object[1] NUMBER_FORMAT=BASE16
 |  | 3 | 1 | RW | 4 |  |  | Map 3 | Unsigned32 | 0 | FFFFFFFFh | 20210510h |  | No | 0 | EEPROM=sdo_pdo.tpdo_map_0.object[2] NUMBER_FORMAT=BASE16
 |  | 4 | 1 | RW | 4 |  |  | Map 4 | Unsigned32 | 0 | FFFFFFFFh | 68000108h |  | No | 0 | EEPROM=sdo_pdo.tpdo_map_0.object[3] NUMBER_FORMAT=BASE16
 |  | 5 | 1 | RW | 4 |  |  | Map 5 | Unsigned32 | 0 | FFFFFFFFh | 68000108h |  | No | 0 | EEPROM=sdo_pdo.tpdo_map_0.object[4] NUMBER_FORMAT=BASE16
 |  | 6 | 1 | RW | 4 |  |  | Map 6 | Unsigned32 | 0 | FFFFFFFFh | 68000108h |  | No | 0 | EEPROM=sdo_pdo.tpdo_map_0.object[5] NUMBER_FORMAT=BASE16
 |  | 7 | 1 | RW | 4 |  |  | Map 7 | Unsigned32 | 0 | FFFFFFFFh | 68000108h |  | No | 0 | EEPROM=sdo_pdo.tpdo_map_0.object[6] NUMBER_FORMAT=BASE16
 |  | 8 | 1 | RW | 4 |  |  | Map 8 | Unsigned32 | 0 | FFFFFFFFh | 68000108h |  | No | 0 | EEPROM=sdo_pdo.tpdo_map_0.object[7] NUMBER_FORMAT=BASE16
 | 1A01h | ---- | ---- | ---- | ---- |  |  | Transmit PDO mapping parameters 2 | Record | N/A | N/A | ---- | Mapping setup for TPDO 2 | ---- | ---- | OBJECT=TPDO_MAPPING SECTION=TRANSMITPDO2 CATEGORY=CONFIGURATION
 |  | 0 | 1 | RW | 4 |  |  | Number of mapped objects | Unsigned8 | 0 | FFh | 1 | Maximum of 8 mappings allowed. | No | 0 | EEPROM=sdo_pdo.tpdo_map_1.num_objects
 |  | 1 | 1 | RW | 4 |  |  | Map 1 | Unsigned32 | 0 | FFFFFFFFh | 23200001h |  | No | 0 | EEPROM=sdo_pdo.tpdo_map_1.object[0] NUMBER_FORMAT=BASE16
 |  | 2 | 1 | RW | 4 |  |  | Map 2 | Unsigned32 | 0 | FFFFFFFFh | 6C010210h |  | No | 0 | EEPROM=sdo_pdo.tpdo_map_1.object[1] NUMBER_FORMAT=BASE16
 |  | 3 | 1 | RW | 4 |  |  | Map 3 | Unsigned32 | 0 | FFFFFFFFh | 6C010310h |  | No | 0 | EEPROM=sdo_pdo.tpdo_map_1.object[2] NUMBER_FORMAT=BASE16
 |  | 4 | 1 | RW | 4 |  |  | Map 4 | Unsigned32 | 0 | FFFFFFFFh | 6C010410h |  | No | 0 | EEPROM=sdo_pdo.tpdo_map_1.object[3] NUMBER_FORMAT=BASE16
 |  | 5 | 1 | RW | 4 |  |  | Map 5 | Unsigned32 | 0 | FFFFFFFFh | 68000108h |  | No | 0 | EEPROM=sdo_pdo.tpdo_map_1.object[4] NUMBER_FORMAT=BASE16
 |  | 6 | 1 | RW | 4 |  |  | Map 6 | Unsigned32 | 0 | FFFFFFFFh | 68000108h |  | No | 0 | EEPROM=sdo_pdo.tpdo_map_1.object[5] NUMBER_FORMAT=BASE16
 |  | 7 | 1 | RW | 4 |  |  | Map 7 | Unsigned32 | 0 | FFFFFFFFh | 68000108h |  | No | 0 | EEPROM=sdo_pdo.tpdo_map_1.object[6] NUMBER_FORMAT=BASE16
 |  | 8 | 1 | RW | 4 |  |  | Map 8 | Unsigned32 | 0 | FFFFFFFFh | 68000108h |  | No | 0 | EEPROM=sdo_pdo.tpdo_map_1.object[7] NUMBER_FORMAT=BASE16
 | 1A02h | ---- | ---- | ---- | ---- |  |  | Transmit PDO mapping parameters 3 | Record | N/A | N/A | ---- | Mapping setup for TPDO 3 | ---- | ---- | OBJECT=TPDO_MAPPING SECTION=TRANSMITPDO3 CATEGORY=CONFIGURATION
 |  | 0 | 1 | RW | 4 |  |  | Number of mapped objects | Unsigned8 | 0 | FFh | 4 | Maximum of 8 mappings allowed. | No | 0 | EEPROM=sdo_pdo.tpdo_map_2.num_objects
 |  | 1 | 1 | RW | 4 |  |  | Map 1 | Unsigned32 | 0 | FFFFFFFFh | 24000010h |  | No | 0 | EEPROM=sdo_pdo.tpdo_map_2.object[0] NUMBER_FORMAT=BASE16
 |  | 2 | 1 | RW | 4 |  |  | Map 2 | Unsigned32 | 0 | FFFFFFFFh | 24010010h |  | No | 0 | EEPROM=sdo_pdo.tpdo_map_2.object[1] NUMBER_FORMAT=BASE16
 |  | 3 | 1 | RW | 4 |  |  | Map 3 | Unsigned32 | 0 | FFFFFFFFh | 24200010h |  | No | 0 | EEPROM=sdo_pdo.tpdo_map_2.object[2] NUMBER_FORMAT=BASE16
 |  | 4 | 1 | RW | 4 |  |  | Map 4 | Unsigned32 | 0 | FFFFFFFFh | 24210010h |  | No | 0 | EEPROM=sdo_pdo.tpdo_map_2.object[3] NUMBER_FORMAT=BASE16
 |  | 5 | 1 | RW | 4 |  |  | Map 5 | Unsigned32 | 0 | FFFFFFFFh | 68000108h |  | No | 0 | EEPROM=sdo_pdo.tpdo_map_2.object[4] NUMBER_FORMAT=BASE16
 |  | 6 | 1 | RW | 4 |  |  | Map 6 | Unsigned32 | 0 | FFFFFFFFh | 68000108h |  | No | 0 | EEPROM=sdo_pdo.tpdo_map_2.object[5] NUMBER_FORMAT=BASE16
 |  | 7 | 1 | RW | 4 |  |  | Map 7 | Unsigned32 | 0 | FFFFFFFFh | 68000108h |  | No | 0 | EEPROM=sdo_pdo.tpdo_map_2.object[6] NUMBER_FORMAT=BASE16
 |  | 8 | 1 | RW | 4 |  |  | Map 8 | Unsigned32 | 0 | FFFFFFFFh | 68000108h |  | No | 0 | EEPROM=sdo_pdo.tpdo_map_2.object[7] NUMBER_FORMAT=BASE16
 | 1A03h | ---- | ---- | ---- | ---- |  |  | Transmit PDO mapping parameters 4 | Record | N/A | N/A | ---- | Mapping setup for TPDO 4 | ---- | ---- | OBJECT=TPDO_MAPPING SECTION=TRANSMITPDO4 CATEGORY=CONFIGURATION
 |  | 0 | 1 | RW | 4 |  |  | Number of mapped objects | Unsigned8 | 0 | FFh | 3 | Maximum of 8 mappings allowed. | No | 0 | EEPROM=sdo_pdo.tpdo_map_3.num_objects
 |  | 1 | 1 | RW | 4 |  |  | Map 1 | Unsigned32 | 0 | FFFFFFFFh | 20400110h |  | No | 0 | EEPROM=sdo_pdo.tpdo_map_3.object[0] NUMBER_FORMAT=BASE16
 |  | 2 | 1 | RW | 4 |  |  | Map 2 | Unsigned32 | 0 | FFFFFFFFh | 20400320h |  | No | 0 | EEPROM=sdo_pdo.tpdo_map_3.object[1] NUMBER_FORMAT=BASE16
 |  | 3 | 1 | RW | 4 |  |  | Map 3 | Unsigned32 | 0 | FFFFFFFFh | 20400510h |  | No | 0 | EEPROM=sdo_pdo.tpdo_map_3.object[2] NUMBER_FORMAT=BASE16
 |  | 4 | 1 | RW | 4 |  |  | Map 4 | Unsigned32 | 0 | FFFFFFFFh | 68000108h |  | No | 0 | EEPROM=sdo_pdo.tpdo_map_3.object[3] NUMBER_FORMAT=BASE16
 |  | 5 | 1 | RW | 4 |  |  | Map 5 | Unsigned32 | 0 | FFFFFFFFh | 68000108h |  | No | 0 | EEPROM=sdo_pdo.tpdo_map_3.object[4] NUMBER_FORMAT=BASE16
 |  | 6 | 1 | RW | 4 |  |  | Map 6 | Unsigned32 | 0 | FFFFFFFFh | 68000108h |  | No | 0 | EEPROM=sdo_pdo.tpdo_map_3.object[5] NUMBER_FORMAT=BASE16
 |  | 7 | 1 | RW | 4 |  |  | Map 7 | Unsigned32 | 0 | FFFFFFFFh | 68000108h |  | No | 0 | EEPROM=sdo_pdo.tpdo_map_3.object[6] NUMBER_FORMAT=BASE16
 |  | 8 | 1 | RW | 4 |  |  | Map 8 | Unsigned32 | 0 | FFFFFFFFh | 68000108h |  | No | 0 | EEPROM=sdo_pdo.tpdo_map_3.object[7] NUMBER_FORMAT=BASE16
 | 1A04h | ---- | ---- | ---- | ---- |  |  | Transmit PDO mapping parameters 5 | Record | N/A | N/A | ---- | Mapping setup for TPDO 5 | ---- | ---- | OBJECT=TPDO_MAPPING SECTION=TRANSMITPDO5 CATEGORY=CONFIGURATION
 |  | 0 | 1 | RW | 4 |  |  | Number of mapped objects | Unsigned8 | 0 | FFh | 0 | Maximum of 8 mappings allowed. | No | 0 | EEPROM=sdo_pdo.tpdo_map_4.num_objects
 |  | 1 | 1 | RW | 4 |  |  | Map 1 | Unsigned32 | 0 | FFFFFFFFh | 68000108h |  | No | 0 | EEPROM=sdo_pdo.tpdo_map_4.object[0] NUMBER_FORMAT=BASE16
 |  | 2 | 1 | RW | 4 |  |  | Map 2 | Unsigned32 | 0 | FFFFFFFFh | 68000108h |  | No | 0 | EEPROM=sdo_pdo.tpdo_map_4.object[1] NUMBER_FORMAT=BASE16
 |  | 3 | 1 | RW | 4 |  |  | Map 3 | Unsigned32 | 0 | FFFFFFFFh | 68000108h |  | No | 0 | EEPROM=sdo_pdo.tpdo_map_4.object[2] NUMBER_FORMAT=BASE16
 |  | 4 | 1 | RW | 4 |  |  | Map 4 | Unsigned32 | 0 | FFFFFFFFh | 68000108h |  | No | 0 | EEPROM=sdo_pdo.tpdo_map_4.object[3] NUMBER_FORMAT=BASE16
 |  | 5 | 1 | RW | 4 |  |  | Map 5 | Unsigned32 | 0 | FFFFFFFFh | 68000108h |  | No | 0 | EEPROM=sdo_pdo.tpdo_map_4.object[4] NUMBER_FORMAT=BASE16
 |  | 6 | 1 | RW | 4 |  |  | Map 6 | Unsigned32 | 0 | FFFFFFFFh | 68000108h |  | No | 0 | EEPROM=sdo_pdo.tpdo_map_4.object[5] NUMBER_FORMAT=BASE16
 |  | 7 | 1 | RW | 4 |  |  | Map 7 | Unsigned32 | 0 | FFFFFFFFh | 68000108h |  | No | 0 | EEPROM=sdo_pdo.tpdo_map_4.object[6] NUMBER_FORMAT=BASE16
 |  | 8 | 1 | RW | 4 |  |  | Map 8 | Unsigned32 | 0 | FFFFFFFFh | 68000108h |  | No | 0 | EEPROM=sdo_pdo.tpdo_map_4.object[7] NUMBER_FORMAT=BASE16
 | 1A05h | ---- | ---- | ---- | ---- |  |  | Transmit PDO mapping parameters 6 | Record | N/A | N/A | ---- | Mapping setup for TPDO 6 | ---- | ---- | OBJECT=TPDO_MAPPING SECTION=TRANSMITPDO6 CATEGORY=CONFIGURATION
 |  | 0 | 1 | RW | 4 |  |  | Number of mapped objects | Unsigned8 | 0 | FFh | 1 | Maximum of 8 mappings allowed. | No | 0 | EEPROM=sdo_pdo.tpdo_map_5.num_objects
 |  | 1 | 1 | RW | 4 |  |  | Map 1 | Unsigned32 | 0 | FFFFFFFFh | 24400010h |  | No | 0 | EEPROM=sdo_pdo.tpdo_map_5.object[0] NUMBER_FORMAT=BASE16
 |  | 2 | 1 | RW | 4 |  |  | Map 2 | Unsigned32 | 0 | FFFFFFFFh | 68000108h |  | No | 0 | EEPROM=sdo_pdo.tpdo_map_5.object[1] NUMBER_FORMAT=BASE16
 |  | 3 | 1 | RW | 4 |  |  | Map 3 | Unsigned32 | 0 | FFFFFFFFh | 68000108h |  | No | 0 | EEPROM=sdo_pdo.tpdo_map_5.object[2] NUMBER_FORMAT=BASE16
 |  | 4 | 1 | RW | 4 |  |  | Map 4 | Unsigned32 | 0 | FFFFFFFFh | 68000108h |  | No | 0 | EEPROM=sdo_pdo.tpdo_map_5.object[3] NUMBER_FORMAT=BASE16
 |  | 5 | 1 | RW | 4 |  |  | Map 5 | Unsigned32 | 0 | FFFFFFFFh | 68000108h |  | No | 0 | EEPROM=sdo_pdo.tpdo_map_5.object[4] NUMBER_FORMAT=BASE16
 |  | 6 | 1 | RW | 4 |  |  | Map 6 | Unsigned32 | 0 | FFFFFFFFh | 68000108h |  | No | 0 | EEPROM=sdo_pdo.tpdo_map_5.object[5] NUMBER_FORMAT=BASE16
 |  | 7 | 1 | RW | 4 |  |  | Map 7 | Unsigned32 | 0 | FFFFFFFFh | 68000108h |  | No | 0 | EEPROM=sdo_pdo.tpdo_map_5.object[6] NUMBER_FORMAT=BASE16
 |  | 8 | 1 | RW | 4 |  |  | Map 8 | Unsigned32 | 0 | FFFFFFFFh | 68000108h |  | No | 0 | EEPROM=sdo_pdo.tpdo_map_5.object[7] NUMBER_FORMAT=BASE16
 | 1A06h | ---- | ---- | ---- | ---- |  |  | Transmit PDO mapping parameters 7 | Record | N/A | N/A | ---- | Mapping setup for TPDO 7 | ---- | ---- | OBJECT=TPDO_MAPPING SECTION=TRANSMITPDO7 CATEGORY=CONFIGURATION
 |  | 0 | 1 | RW | 4 |  |  | Number of mapped objects | Unsigned8 | 0 | FFh | 3 | Maximum of 8 mappings allowed. | No | 0 | EEPROM=sdo_pdo.tpdo_map_6.num_objects
 |  | 1 | 1 | RW | 4 |  |  | Map 1 | Unsigned32 | 0 | FFFFFFFFh | 20600110h |  | No | 0 | EEPROM=sdo_pdo.tpdo_map_6.object[0] NUMBER_FORMAT=BASE16
 |  | 2 | 1 | RW | 4 |  |  | Map 2 | Unsigned32 | 0 | FFFFFFFFh | 20600320h |  | No | 0 | EEPROM=sdo_pdo.tpdo_map_6.object[1] NUMBER_FORMAT=BASE16
 |  | 3 | 1 | RW | 4 |  |  | Map 3 | Unsigned32 | 0 | FFFFFFFFh | 20600510h |  | No | 0 | EEPROM=sdo_pdo.tpdo_map_6.object[2] NUMBER_FORMAT=BASE16
 |  | 4 | 1 | RW | 4 |  |  | Map 4 | Unsigned32 | 0 | FFFFFFFFh | 68000108h |  | No | 0 | EEPROM=sdo_pdo.tpdo_map_6.object[3] NUMBER_FORMAT=BASE16
 |  | 5 | 1 | RW | 4 |  |  | Map 5 | Unsigned32 | 0 | FFFFFFFFh | 68000108h |  | No | 0 | EEPROM=sdo_pdo.tpdo_map_6.object[4] NUMBER_FORMAT=BASE16
 |  | 6 | 1 | RW | 4 |  |  | Map 6 | Unsigned32 | 0 | FFFFFFFFh | 68000108h |  | No | 0 | EEPROM=sdo_pdo.tpdo_map_6.object[5] NUMBER_FORMAT=BASE16
 |  | 7 | 1 | RW | 4 |  |  | Map 7 | Unsigned32 | 0 | FFFFFFFFh | 68000108h |  | No | 0 | EEPROM=sdo_pdo.tpdo_map_6.object[6] NUMBER_FORMAT=BASE16
 |  | 8 | 1 | RW | 4 |  |  | Map 8 | Unsigned32 | 0 | FFFFFFFFh | 68000108h |  | No | 0 | EEPROM=sdo_pdo.tpdo_map_6.object[7] NUMBER_FORMAT=BASE16
 | 1A07h | ---- | ---- | ---- | ---- |  |  | Transmit PDO mapping parameters 8 | Record | N/A | N/A | ---- | Mapping setup for TPDO 8 | ---- | ---- | OBJECT=TPDO_MAPPING SECTION=TRANSMITPDO8 CATEGORY=CONFIGURATION
 |  | 0 | 1 | RW | 4 |  |  | Number of mapped objects | Unsigned8 | 0 | FFh | 0 | Maximum of 8 mappings allowed. | No | 0 | EEPROM=sdo_pdo.tpdo_map_7.num_objects
 |  | 1 | 1 | RW | 4 |  |  | Map 1 | Unsigned32 | 0 | FFFFFFFFh | 68000108h |  | No | 0 | EEPROM=sdo_pdo.tpdo_map_7.object[0] NUMBER_FORMAT=BASE16
 |  | 2 | 1 | RW | 4 |  |  | Map 2 | Unsigned32 | 0 | FFFFFFFFh | 68000108h |  | No | 0 | EEPROM=sdo_pdo.tpdo_map_7.object[1] NUMBER_FORMAT=BASE16
 |  | 3 | 1 | RW | 4 |  |  | Map 3 | Unsigned32 | 0 | FFFFFFFFh | 68000108h |  | No | 0 | EEPROM=sdo_pdo.tpdo_map_7.object[2] NUMBER_FORMAT=BASE16
 |  | 4 | 1 | RW | 4 |  |  | Map 4 | Unsigned32 | 0 | FFFFFFFFh | 68000108h |  | No | 0 | EEPROM=sdo_pdo.tpdo_map_7.object[3] NUMBER_FORMAT=BASE16
 |  | 5 | 1 | RW | 4 |  |  | Map 5 | Unsigned32 | 0 | FFFFFFFFh | 68000108h |  | No | 0 | EEPROM=sdo_pdo.tpdo_map_7.object[4] NUMBER_FORMAT=BASE16
 |  | 6 | 1 | RW | 4 |  |  | Map 6 | Unsigned32 | 0 | FFFFFFFFh | 68000108h |  | No | 0 | EEPROM=sdo_pdo.tpdo_map_7.object[5] NUMBER_FORMAT=BASE16
 |  | 7 | 1 | RW | 4 |  |  | Map 7 | Unsigned32 | 0 | FFFFFFFFh | 68000108h |  | No | 0 | EEPROM=sdo_pdo.tpdo_map_7.object[6] NUMBER_FORMAT=BASE16
 |  | 8 | 1 | RW | 4 |  |  | Map 8 | Unsigned32 | 0 | FFFFFFFFh | 68000108h |  | No | 0 | EEPROM=sdo_pdo.tpdo_map_7.object[7] NUMBER_FORMAT=BASE16
 | 1A08h | ---- | ---- | ---- | ---- |  |  | Transmit PDO mapping parameters 9 | Record | N/A | N/A | ---- | Mapping setup for TPDO 9 | ---- | ---- | OBJECT=TPDO_MAPPING SECTION=TRANSMITPDO9 CATEGORY=CONFIGURATION
 |  | 0 | 1 | RW | 4 |  |  | Number of mapped objects | Unsigned8 | 0 | FFh | 1 | Maximum of 8 mappings allowed. | No | 0 | EEPROM=sdo_pdo.tpdo_map_8.num_objects
 |  | 1 | 1 | RW | 4 |  |  | Map 1 | Unsigned32 | 0 | FFFFFFFFh | 24600010h |  | No | 0 | EEPROM=sdo_pdo.tpdo_map_8.object[0] NUMBER_FORMAT=BASE16
 |  | 2 | 1 | RW | 4 |  |  | Map 2 | Unsigned32 | 0 | FFFFFFFFh | 68000108h |  | No | 0 | EEPROM=sdo_pdo.tpdo_map_8.object[1] NUMBER_FORMAT=BASE16
 |  | 3 | 1 | RW | 4 |  |  | Map 3 | Unsigned32 | 0 | FFFFFFFFh | 68000108h |  | No | 0 | EEPROM=sdo_pdo.tpdo_map_8.object[2] NUMBER_FORMAT=BASE16
 |  | 4 | 1 | RW | 4 |  |  | Map 4 | Unsigned32 | 0 | FFFFFFFFh | 68000108h |  | No | 0 | EEPROM=sdo_pdo.tpdo_map_8.object[3] NUMBER_FORMAT=BASE16
 |  | 5 | 1 | RW | 4 |  |  | Map 5 | Unsigned32 | 0 | FFFFFFFFh | 68000108h |  | No | 0 | EEPROM=sdo_pdo.tpdo_map_8.object[4] NUMBER_FORMAT=BASE16
 |  | 6 | 1 | RW | 4 |  |  | Map 6 | Unsigned32 | 0 | FFFFFFFFh | 68000108h |  | No | 0 | EEPROM=sdo_pdo.tpdo_map_8.object[5] NUMBER_FORMAT=BASE16
 |  | 7 | 1 | RW | 4 |  |  | Map 7 | Unsigned32 | 0 | FFFFFFFFh | 68000108h |  | No | 0 | EEPROM=sdo_pdo.tpdo_map_8.object[6] NUMBER_FORMAT=BASE16
 |  | 8 | 1 | RW | 4 |  |  | Map 8 | Unsigned32 | 0 | FFFFFFFFh | 68000108h |  | No | 0 | EEPROM=sdo_pdo.tpdo_map_8.object[7] NUMBER_FORMAT=BASE16
 | 2020h | ---- | ---- | ---- | ---- |  |  | Motor drive left information | Record | N/A | N/A | ---- |  | ---- | ---- | OBJECT=MOTOR_DRIVE SECTION=TractionStatus MASTER=TRUE CATEGORY=MONITORING
 |  | 0 | 1 | RO | N/A |  |  | Number of entries | Unsigned8 | 0 | FFh | 6 |  | No | 0
 |  | 1 | 1 | RO | N/A |  |  | controlword - left motor | Unsigned16 | 0 | FFFFh | No | Controls the drive state and operational mode of the left motor drive. | Yes | 0 | NUMBER_FORMAT=BASE16
 |  | 2 | 1 | RWW | N/A |  |  | statusword - left motor | Unsigned16 | 0 | FFFFh | No | Indicates the current state of the left drive. | Yes | 1h | NUMBER_FORMAT=BASE16
 |  | 3 | 1 | RO | N/A |  | RPM | Target velocity - left motor | Integer32 | -2147483648 | 2147483647 | No | In RPM. | Yes | 0
 |  | 4 | 1 | RWW | N/A |  | RPM | Velocity actual value - left motor | Integer32 | -2147483648 | 2147483647 | No | In RPM. | Yes | 1h
 |  | 5 | 1 | RO | N/A | 0.001 |  | Max torque - left motor | Integer16 | -32768 | 32767 | No | In 1/1000ths of motor rated torque (2916h,1). | Yes | 0
 |  | 6 | 1 | RWW | N/A | 0.001 |  | Actual torque - left motor | Integer16 | -32768 | 32767 | No | In 1/1000ths of motor rated torque (2916h,1). | Yes | 1h
 | 2021h | ---- | ---- | ---- | ---- |  |  | Motor drive right information | Record | N/A | N/A | ---- |  | ---- | ---- | OBJECT=MOTOR_DRIVE SECTION=TractionStatus MASTER=TRUE CATEGORY=MONITORING
 |  | 0 | 1 | RO | N/A |  |  | Number of entries | Unsigned8 | 0 | FFh | 6 |  | No | 0
 |  | 1 | 1 | RO | N/A |  |  | controlword - right motor | Unsigned16 | 0 | FFFFh | No | Controls the drive state and operational mode of the right motor drive. | Yes | 0 | NUMBER_FORMAT=BASE16
 |  | 2 | 1 | RWW | N/A |  |  | statusword - right motor | Unsigned16 | 0 | FFFFh | No | Indicates the current state of the right drive. | Yes | 1h | NUMBER_FORMAT=BASE16
 |  | 3 | 1 | RO | N/A |  | RPM | Target velocity - right motor | Integer32 | -2147483648 | 2147483647 | No | In RPM. | Yes | 0
 |  | 4 | 1 | RWW | N/A |  | RPM | Velocity actual value - right motor | Integer32 | -2147483648 | 2147483647 | No | In RPM. | Yes | 1h
 |  | 5 | 1 | RO | N/A | 0.001 |  | Max torque - right motor | Integer16 | -32768 | 32767 | No | In 1/1000ths of traction motor rated torque (2916h,1). | Yes | 0
 |  | 6 | 1 | RWW | N/A | 0.001 |  | Actual torque - right motor | Integer16 | -32768 | 32767 | No | In 1/1000ths of traction motor rated torque (2916h,1). | Yes | 1h
 | 2040h | ---- | ---- | ---- | ---- |  |  | Motor drive pump information | Record | N/A | N/A | ---- |  | ---- | ---- | OBJECT=MOTOR_DRIVE SECTION=PumpStatus MASTER=TRUE CATEGORY=MONITORING
 |  | 0 | 1 | RO | N/A |  |  | Number of entries | Unsigned8 | 0 | FFh | 6 |  | No | 0
 |  | 1 | 1 | RO | N/A |  |  | controlword - pump motor | Unsigned16 | 0 | FFFFh | No | Controls the drive state and operational mode of the pump motor drive. | Yes | 0 | NUMBER_FORMAT=BASE16
 |  | 2 | 1 | RWW | N/A |  |  | statusword - pump motor | Unsigned16 | 0 | FFFFh | No | Indicates the current state of the pump drive. | Yes | 1h | NUMBER_FORMAT=BASE16
 |  | 3 | 1 | RO | N/A |  | RPM | Target velocity - pump motor | Integer32 | -2147483648 | 2147483647 | No | In RPM. | Yes | 0
 |  | 4 | 1 | RWW | N/A |  | RPM | Velocity actual value - pump motor | Integer32 | -2147483648 | 2147483647 | No | In RPM. | Yes | 1h
 |  | 5 | 1 | RO | N/A | 0.001 |  | Max torque - pump motor | Integer16 | -32768 | 32767 | No | In 1/1000ths of pump motor rated torque (2A01h,1). | Yes | 0
 |  | 6 | 1 | RWW | N/A | 0.001 |  | Actual torque - pump motor | Integer16 | -32768 | 32767 | No | In 1/1000ths of pump motor rated torque (2A01h,1). | Yes | 1h
 | 2060h | ---- | ---- | ---- | ---- |  |  | Motor drive power steer information | Record | N/A | N/A | ---- |  | ---- | ---- | OBJECT=MOTOR_DRIVE SECTION=PSteerStatus MASTER=TRUE CATEGORY=MONITORING
 |  | 0 | 1 | RO | N/A |  |  | Number of entries | Unsigned8 | 0 | FFh | 6 |  | No | 0
 |  | 1 | 1 | RO | N/A |  |  | controlword - power steer motor | Unsigned16 | 0 | FFFFh | No | Controls the drive state and operational mode of the power steer motor drive. | Yes | 0 | NUMBER_FORMAT=BASE16
 |  | 2 | 1 | RWW | N/A |  |  | statusword - power steer motor | Unsigned16 | 0 | FFFFh | No | Indicates the current state of the power steer drive. | Yes | 1h | NUMBER_FORMAT=BASE16
 |  | 3 | 1 | RO | N/A |  | RPM | Target velocity - power steer motor | Integer32 | -2147483648 | 2147483647 | No | In RPM. | Yes | 0
 |  | 4 | 1 | RWW | N/A |  | RPM | Velocity actual value - power steer motor | Integer32 | -2147483648 | 2147483647 | No | In RPM. | Yes | 1h
 |  | 5 | 1 | RO | N/A | 0.001 |  | Max torque - power steer motor | Integer16 | -32768 | 32767 | No | In 1/1000ths of power steer motor rated torque (2B01h,1). | Yes | 0
 |  | 6 | 1 | RWW | N/A | 0.001 |  | Actual torque - power steer motor | Integer16 | -32768 | 32767 | No | In 1/1000ths of power steer motor rated torque (2B01h,1). | Yes | 1h
 | 2100h | 0 | 1 | RWW | N/A |  |  | Key switch | Boolean | 0 | 1 | No |  | Yes | 1h | OBJECT=DIGITAL_SIGNAL_IN SECTION=VehicleDI NUMBER_FORMAT=2:0=Inactive:1=Active MASTER=TRUE CATEGORY=MONITORING
 | 2101h | 0 | 1 | RWW | N/A |  |  | Horn switch | Boolean | 0 | 1 | No |  | Yes | 1h | OBJECT=DIGITAL_SIGNAL_IN SECTION=VehicleDI NUMBER_FORMAT=2:0=Inactive:1=Active MASTER=TRUE CATEGORY=MONITORING
 | 2120h | 0 | 1 | RWW | N/A |  |  | Drive enable switch | Boolean | 0 | 1 | No |  | Yes | 1h | OBJECT=DIGITAL_SIGNAL_IN SECTION=TractionDI NUMBER_FORMAT=2:0=Inactive:1=Active MASTER=TRUE CATEGORY=MONITORING
 | 2121h | 0 | 1 | RWW | N/A |  |  | Forward Switch | Boolean | 0 | 1 | No |  | Yes | 1h | OBJECT=DIGITAL_SIGNAL_IN SECTION=TractionDI NUMBER_FORMAT=2:0=Inactive:1=Active MASTER=TRUE CATEGORY=MONITORING
 | 2122h | 0 | 1 | RWW | N/A |  |  | Reverse Switch | Boolean | 0 | 1 | No |  | Yes | 1h | OBJECT=DIGITAL_SIGNAL_IN SECTION=TractionDI NUMBER_FORMAT=2:0=Inactive:1=Active MASTER=TRUE CATEGORY=MONITORING
 | 2123h | 0 | 1 | RWW | N/A |  |  | FS1 switch | Boolean | 0 | 1 | No |  | Yes | 1h | OBJECT=DIGITAL_SIGNAL_IN SECTION=TractionDI NUMBER_FORMAT=2:0=Inactive:1=Active MASTER=TRUE CATEGORY=MONITORING
 | 2124h | 0 | 1 | RWW | N/A |  |  | Seat switch | Boolean | 0 | 1 | No |  | Yes | 1h | OBJECT=DIGITAL_SIGNAL_IN SECTION=TractionDI NUMBER_FORMAT=2:0=Inactive:1=Active MASTER=TRUE CATEGORY=MONITORING
 | 2125h | 0 | 1 | RWW | N/A |  |  | Handbrake switch | Boolean | 0 | 1 | No |  | Yes | 1h | OBJECT=DIGITAL_SIGNAL_IN SECTION=TractionDI NUMBER_FORMAT=2:0=Inactive:1=Active MASTER=TRUE CATEGORY=MONITORING
 | 2126h | 0 | 1 | RWW | N/A |  |  | Driveability Select 1 switch | Boolean | 0 | 1 | No |  | Yes | 1h | OBJECT=DIGITAL_SIGNAL_IN SECTION=TractionDI NUMBER_FORMAT=2:0=Inactive:1=Active MASTER=TRUE CATEGORY=MONITORING
 | 2127h | 0 | 1 | RWW | N/A |  |  | Driveability Select 2 switch | Boolean | 0 | 1 | No |  | Yes | 1h | OBJECT=DIGITAL_SIGNAL_IN SECTION=TractionDI NUMBER_FORMAT=2:0=Inactive:1=Active MASTER=TRUE CATEGORY=MONITORING
 | 2128h | 0 | 1 | RWW | N/A |  |  | Driveability Select 3 switch | Boolean | 0 | 1 | No |  | Yes | 1h | OBJECT=DIGITAL_SIGNAL_IN SECTION=TractionDI NUMBER_FORMAT=2:0=Inactive:1=Active MASTER=TRUE CATEGORY=MONITORING
 | 2129h | 0 | 1 | RWW | N/A |  |  | Inch forward switch | Boolean | 0 | 1 | No |  | Yes | 1h | OBJECT=DIGITAL_SIGNAL_IN SECTION=TractionDI NUMBER_FORMAT=2:0=Inactive:1=Active MASTER=TRUE CATEGORY=MONITORING
 | 212Ah | 0 | 1 | RWW | N/A |  |  | Inch reverse switch | Boolean | 0 | 1 | No |  | Yes | 1h | OBJECT=DIGITAL_SIGNAL_IN SECTION=TractionDI NUMBER_FORMAT=2:0=Inactive:1=Active MASTER=TRUE CATEGORY=MONITORING
 | 212Bh | 0 | 1 | RWW | N/A |  |  | Inner left steer switch | Boolean | 0 | 1 | No |  | Yes | 1h | OBJECT=DIGITAL_SIGNAL_IN SECTION=TractionDI NUMBER_FORMAT=2:0=Inactive:1=Active MASTER=TRUE CATEGORY=MONITORING
 | 212Ch | 0 | 1 | RWW | N/A |  |  | Outer left steer switch | Boolean | 0 | 1 | No |  | Yes | 1h | OBJECT=DIGITAL_SIGNAL_IN SECTION=TractionDI NUMBER_FORMAT=2:0=Inactive:1=Active MASTER=TRUE CATEGORY=MONITORING
 | 212Dh | 0 | 1 | RWW | N/A |  |  | Inner right steer switch | Boolean | 0 | 1 | No |  | Yes | 1h | OBJECT=DIGITAL_SIGNAL_IN SECTION=TractionDI NUMBER_FORMAT=2:0=Inactive:1=Active MASTER=TRUE CATEGORY=MONITORING
 | 212Eh | 0 | 1 | RWW | N/A |  |  | Outer right steer switch | Boolean | 0 | 1 | No |  | Yes | 1h | OBJECT=DIGITAL_SIGNAL_IN SECTION=TractionDI NUMBER_FORMAT=2:0=Inactive:1=Active MASTER=TRUE CATEGORY=MONITORING
 | 212Fh | 0 | 1 | RWW | N/A |  |  | High speed switch | Boolean | 0 | 1 | No |  | Yes | 1h | OBJECT=DIGITAL_SIGNAL_IN SECTION=TractionDI NUMBER_FORMAT=2:0=Inactive:1=Active MASTER=TRUE CATEGORY=MONITORING
 | 2130h | 0 | 1 | RWW | N/A |  |  | Footbrake switch | Boolean | 0 | 1 | No |  | Yes | 1h | OBJECT=DIGITAL_SIGNAL_IN SECTION=TractionDI NUMBER_FORMAT=2:0=Inactive:1=Active MASTER=TRUE CATEGORY=MONITORING
 | 2131h | 0 | 1 | RWW | N/A |  |  | Regen Charging Enable Switch | Boolean | 0 | 1 | No |  | Yes | 1h | OBJECT=DIGITAL_SIGNAL_IN SECTION=TractionDI NUMBER_FORMAT=2:0=Inactive:1=Active MASTER=TRUE CATEGORY=MONITORING
 | 2132h | 0 | 1 | RWW | N/A |  |  | Overload switch | Boolean | 0 | 1 | No |  | Yes | 1h | OBJECT=DIGITAL_SIGNAL_IN SECTION=TractionDI NUMBER_FORMAT=2:0=Inactive:1=Active MASTER=TRUE CATEGORY=MONITORING
 | 2133h | 0 | 1 | RWW | N/A |  |  | Operational alarm trigger switch | Boolean | 0 | 1 | No |  | Yes | 1h | OBJECT=DIGITAL_SIGNAL_IN SECTION=TractionDI NUMBER_FORMAT=2:0=Inactive:1=Active MASTER=TRUE CATEGORY=MONITORING
 | 2134h | 0 | 1 | RWW | N/A |  |  | Tilt Switch | Boolean | 0 | 1 | No |  | Yes | 1h | OBJECT=DIGITAL_SIGNAL_IN SECTION=TractionDI NUMBER_FORMAT=2:0=Inactive:1=Active MASTER=TRUE CATEGORY=MONITORING
 | 2135h | 0 | 1 | RWW | N/A |  |  | Platform Up | Boolean | 0 | 1 | No |  | Yes | 1h | OBJECT=DIGITAL_SIGNAL_IN SECTION=TractionDI NUMBER_FORMAT=2:0=Inactive:1=Active MASTER=TRUE CATEGORY=MONITORING
 | 2136h | 0 | 1 | RWW | N/A |  |  | Traction Mode Select | Boolean | 0 | 1 | No |  | Yes | 1h | OBJECT=DIGITAL_SIGNAL_IN SECTION=TractionDI NUMBER_FORMAT=2:0=Inactive:1=Active MASTER=TRUE CATEGORY=MONITORING
 | 2137h | 0 | 1 | RWW | N/A |  |  | Traction Inhibit | Boolean | 0 | 1 | No |  | Yes | 1h | OBJECT=DIGITAL_SIGNAL_IN SECTION=TractionDI NUMBER_FORMAT=2:0=Inactive:1=Active MASTER=TRUE CATEGORY=MONITORING
 | 2138h | 0 | 1 | RWW | N/A |  |  | Pothole | Boolean | 0 | 1 | No |  | Yes | 1h | OBJECT=DIGITAL_SIGNAL_IN SECTION=TractionDI NUMBER_FORMAT=2:0=Inactive:1=Active MASTER=TRUE CATEGORY=MONITORING
 | 2139h | 0 | 1 | RWW | N/A |  |  | Belly | Boolean | 0 | 1 | No |  | Yes | 1h | OBJECT=DIGITAL_SIGNAL_IN SECTION=TractionDI NUMBER_FORMAT=2:0=Inactive:1=Active MASTER=TRUE CATEGORY=MONITORING
 | 213Ah | 0 | 1 | RWW | N/A |  |  | Deadman switch | Boolean | 0 | 1 | No |  | Yes | 1h | OBJECT=DIGITAL_SIGNAL_IN SECTION=TractionDI NUMBER_FORMAT=2:0=Inactive:1=Active MASTER=TRUE CATEGORY=MONITORING
 | 2140h | 0 | 1 | RWW | N/A |  |  | Pump 1 switch | Boolean | 0 | 1 | No |  | Yes | 1h | OBJECT=DIGITAL_SIGNAL_IN SECTION=PumpDI NUMBER_FORMAT=2:0=Inactive:1=Active MASTER=TRUE CATEGORY=MONITORING
 | 2141h | 0 | 1 | RWW | N/A |  |  | Pump 2 switch | Boolean | 0 | 1 | No |  | Yes | 1h | OBJECT=DIGITAL_SIGNAL_IN SECTION=PumpDI NUMBER_FORMAT=2:0=Inactive:1=Active MASTER=TRUE CATEGORY=MONITORING
 | 2142h | 0 | 1 | RWW | N/A |  |  | Pump 3 switch | Boolean | 0 | 1 | No |  | Yes | 1h | OBJECT=DIGITAL_SIGNAL_IN SECTION=PumpDI NUMBER_FORMAT=2:0=Inactive:1=Active MASTER=TRUE CATEGORY=MONITORING
 | 2143h | 0 | 1 | RWW | N/A |  |  | Pump 4 switch | Boolean | 0 | 1 | No |  | Yes | 1h | OBJECT=DIGITAL_SIGNAL_IN SECTION=PumpDI NUMBER_FORMAT=2:0=Inactive:1=Active MASTER=TRUE CATEGORY=MONITORING
 | 2144h | 0 | 1 | RWW | N/A |  |  | Pump 5 switch | Boolean | 0 | 1 | No |  | Yes | 1h | OBJECT=DIGITAL_SIGNAL_IN SECTION=PumpDI NUMBER_FORMAT=2:0=Inactive:1=Active MASTER=TRUE CATEGORY=MONITORING
 | 2145h | 0 | 1 | RWW | N/A |  |  | Pump 6 switch | Boolean | 0 | 1 | No |  | Yes | 1h | OBJECT=DIGITAL_SIGNAL_IN SECTION=PumpDI NUMBER_FORMAT=2:0=Inactive:1=Active MASTER=TRUE CATEGORY=MONITORING
 | 2146h | 0 | 1 | RWW | N/A |  |  | Pump 7 switch | Boolean | 0 | 1 | No |  | Yes | 1h | OBJECT=DIGITAL_SIGNAL_IN SECTION=PumpDI NUMBER_FORMAT=2:0=Inactive:1=Active MASTER=TRUE CATEGORY=MONITORING
 | 2150h | 0 | 1 | RWW | N/A |  |  | Pump Inhibit switch | Boolean | 0 | 1 | No |  | Yes | 1h | OBJECT=DIGITAL_SIGNAL_IN SECTION=PumpDI NUMBER_FORMAT=2:0=Inactive:1=Active MASTER=TRUE CATEGORY=MONITORING
 | 2152h | 0 | 1 | RWW | N/A |  |  | Pump Driveability 1 switch | Boolean | 0 | 1 | No |  | Yes | 1h | OBJECT=DIGITAL_SIGNAL_IN SECTION=PumpDI NUMBER_FORMAT=2:0=Inactive:1=Active MASTER=TRUE CATEGORY=MONITORING
 | 2153h | 0 | 1 | RWW | N/A |  |  | Pump Driveability 2 switch | Boolean | 0 | 1 | No |  | Yes | 1h | OBJECT=DIGITAL_SIGNAL_IN SECTION=PumpDI NUMBER_FORMAT=2:0=Inactive:1=Active MASTER=TRUE CATEGORY=MONITORING
 | 2154h | 0 | 1 | RWW | N/A |  |  | Pump Mode Select switch | Boolean | 0 | 1 | No |  | Yes | 1h | OBJECT=DIGITAL_SIGNAL_IN SECTION=PumpDI NUMBER_FORMAT=2:0=Inactive:1=Active MASTER=TRUE CATEGORY=MONITORING
 | 2160h | 0 | 1 | RWW | N/A |  |  | Power steer trigger switch | Boolean | 0 | 1 | No |  | Yes | 1h | OBJECT=DIGITAL_SIGNAL_IN SECTION=PSteerDI NUMBER_FORMAT=2:0=Inactive:1=Active MASTER=TRUE CATEGORY=MONITORING
 | 2161h | 0 | 1 | RWW | N/A |  |  | In Position switch | Boolean | 0 | 1 | No |  | Yes | 1h | OBJECT=DIGITAL_SIGNAL_IN SECTION=TractionDI NUMBER_FORMAT=2:0=Inactive:1=Active MASTER=TRUE CATEGORY=MONITORING
 | 2162h | 0 | 1 | RWW | N/A |  |  | Diagnostic switch | Boolean | 0 | 1 | No |  | Yes | 1h | OBJECT=DIGITAL_SIGNAL_IN SECTION=TractionDI NUMBER_FORMAT=2:0=Inactive:1=Active MASTER=TRUE CATEGORY=MONITORING
 | 2163h | 0 | 1 | RWW | N/A |  |  | Pump Start/Stop switch | Boolean | 0 | 1 | No |  | Yes | 1h | OBJECT=DIGITAL_SIGNAL_IN SECTION=TractionDI NUMBER_FORMAT=2:0=Inactive:1=Active MASTER=TRUE CATEGORY=MONITORING
 | 2164h | 0 | 1 | RWW | N/A |  |  | Park Brake Set/Release switch | Boolean | 0 | 1 | No |  | Yes | 1h | OBJECT=DIGITAL_SIGNAL_IN SECTION=TractionDI NUMBER_FORMAT=2:0=Inactive:1=Active MASTER=TRUE CATEGORY=MONITORING
 | 2165h | 0 | 1 | RWW | N/A |  |  | Park Brake Presure switch | Boolean | 0 | 1 | No |  | Yes | 1h | OBJECT=DIGITAL_SIGNAL_IN SECTION=TractionDI NUMBER_FORMAT=2:0=Inactive:1=Active MASTER=TRUE CATEGORY=MONITORING
 | 2166h | 0 | 1 | RWW | N/A |  |  | Stop all PWM switch | Boolean | 0 | 1 | No |  | Yes | 1h | OBJECT=DIGITAL_SIGNAL_IN SECTION=TractionDI NUMBER_FORMAT=2:1=Inactive:0=Active MASTER=TRUE CATEGORY=MONITORING
 | 2167h | 0 | 1 | RWW | N/A |  |  | Traction Assist switch | Boolean | 0 | 1 | No |  | Yes | 1h | OBJECT=DIGITAL_SIGNAL_IN SECTION=TractionDI NUMBER_FORMAT=2:0=Inactive:1=Active MASTER=TRUE CATEGORY=MONITORING
 | 2168h | 0 | 1 | RWW | N/A |  |  | Oil Level Low switch | Boolean | 0 | 1 | No |  | Yes | 1h | OBJECT=DIGITAL_SIGNAL_IN SECTION=TractionDI NUMBER_FORMAT=2:0=Inactive:1=Active MASTER=TRUE CATEGORY=MONITORING
 | 2169h | 0 | 1 | RWW | N/A |  |  | Tow Mode switch | Boolean | 0 | 1 | No |  | Yes | 1h | OBJECT=DIGITAL_SIGNAL_IN SECTION=TractionDI NUMBER_FORMAT=2:0=Inactive:1=Active MASTER=TRUE CATEGORY=MONITORING
 | 216Ah | 0 | 1 | RWW | N/A |  |  | Payload Speed limit switch | Boolean | 0 | 1 | No |  | Yes | 1h | OBJECT=DIGITAL_SIGNAL_IN SECTION=TractionDI NUMBER_FORMAT=2:0=Inactive:1=Active MASTER=TRUE CATEGORY=MONITORING
 | 216Bh | 0 | 1 | RWW | N/A |  |  | Pump Cutback Pressure switch | Boolean | 0 | 1 | No |  | Yes | 1h | OBJECT=DIGITAL_SIGNAL_IN SECTION=TractionDI NUMBER_FORMAT=2:0=Inactive:1=Active MASTER=TRUE CATEGORY=MONITORING
 | 216Ch | 0 | 1 | RWW | N/A |  |  | Counter switch | Boolean | 0 | 1 | No |  | Yes | 1h | OBJECT=DIGITAL_SIGNAL_IN SECTION=TractionDI NUMBER_FORMAT=2:0=Inactive:1=Active MASTER=TRUE CATEGORY=MONITORING
 | 216Dh | 0 | 1 | RWW | N/A |  |  | Counter switch | Boolean | 0 | 1 | No |  | Yes | 1h | OBJECT=DIGITAL_SIGNAL_IN SECTION=TractionDI NUMBER_FORMAT=2:0=Inactive:1=Active MASTER=TRUE CATEGORY=MONITORING
 | 216Eh | 0 | 1 | RWW | N/A |  |  | Gear Config 2 switch | Boolean | 0 | 1 | No |  | Yes | 1h | OBJECT=DIGITAL_SIGNAL_IN SECTION=TractionDI NUMBER_FORMAT=2:0=Inactive:1=Active MASTER=TRUE CATEGORY=MONITORING
 | 216Fh | 0 | 1 | RWW | N/A |  |  | Gear Config 3 switch | Boolean | 0 | 1 | No |  | Yes | 1h | OBJECT=DIGITAL_SIGNAL_IN SECTION=TractionDI NUMBER_FORMAT=2:0=Inactive:1=Active MASTER=TRUE CATEGORY=MONITORING
 | 2170h | 0 | 1 | RWW | N/A |  |  | Gear Config 4 switch | Boolean | 0 | 1 | No |  | Yes | 1h | OBJECT=DIGITAL_SIGNAL_IN SECTION=TractionDI NUMBER_FORMAT=2:0=Inactive:1=Active MASTER=TRUE CATEGORY=MONITORING
 | 2171h | 0 | 1 | RWW | N/A |  |  | Gear Config 5 switch | Boolean | 0 | 1 | No |  | Yes | 1h | OBJECT=DIGITAL_SIGNAL_IN SECTION=TractionDI NUMBER_FORMAT=2:0=Inactive:1=Active MASTER=TRUE CATEGORY=MONITORING
 | 2172h | 0 | 1 | RWW | N/A |  |  | Tire Config 1 switch | Boolean | 0 | 1 | No |  | Yes | 1h | OBJECT=DIGITAL_SIGNAL_IN SECTION=TractionDI NUMBER_FORMAT=2:0=Inactive:1=Active MASTER=TRUE CATEGORY=MONITORING
 | 2173h | 0 | 1 | RWW | N/A |  |  | Tire Config 2 switch | Boolean | 0 | 1 | No |  | Yes | 1h | OBJECT=DIGITAL_SIGNAL_IN SECTION=TractionDI NUMBER_FORMAT=2:0=Inactive:1=Active MASTER=TRUE CATEGORY=MONITORING
 | 2174h | 0 | 1 | RWW | N/A |  |  | Tire Config 3 switch | Boolean | 0 | 1 | No |  | Yes | 1h | OBJECT=DIGITAL_SIGNAL_IN SECTION=TractionDI NUMBER_FORMAT=2:0=Inactive:1=Active MASTER=TRUE CATEGORY=MONITORING
 | 2175h | 0 | 1 | RWW | N/A |  |  | Tire Config 4 switch | Boolean | 0 | 1 | No |  | Yes | 1h | OBJECT=DIGITAL_SIGNAL_IN SECTION=TractionDI NUMBER_FORMAT=2:0=Inactive:1=Active MASTER=TRUE CATEGORY=MONITORING
 | 2176h | 0 | 1 | RWW | N/A |  |  | Vehicle Type 1 switch | Boolean | 0 | 1 | No |  | Yes | 1h | OBJECT=DIGITAL_SIGNAL_IN SECTION=TractionDI NUMBER_FORMAT=2:0=Inactive:1=Active MASTER=TRUE CATEGORY=MONITORING
 | 2177h | 0 | 1 | RWW | N/A |  |  | Vehicle Type 2 switch | Boolean | 0 | 1 | No |  | Yes | 1h | OBJECT=DIGITAL_SIGNAL_IN SECTION=TractionDI NUMBER_FORMAT=2:0=Inactive:1=Active MASTER=TRUE CATEGORY=MONITORING
 | 2178h | 0 | 1 | RWW | N/A |  |  | Traction Motor Configuration | Boolean | 0 | 1 | No |  | Yes | 1h | OBJECT=DIGITAL_SIGNAL_IN SECTION=TractionDI NUMBER_FORMAT=2:0=Inactive:1=Active MASTER=TRUE CATEGORY=MONITORING
 | 2179h | 0 | 1 | RWW | N/A |  |  | Hydraulic Filter switch | Boolean | 0 | 1 | No |  | Yes | 1h | OBJECT=DIGITAL_SIGNAL_IN SECTION=TractionDI NUMBER_FORMAT=2:0=Inactive:1=Active MASTER=TRUE CATEGORY=MONITORING
 | 217Ah | 0 | 1 | RWW | N/A |  |  | CB Monitor Switch | Boolean | 0 | 1 | No |  | Yes | 1h | OBJECT=DIGITAL_SIGNAL_IN SECTION=TractionDI NUMBER_FORMAT=2:0=Inactive:1=Active MASTER=TRUE CATEGORY=MONITORING
 | 217Bh | 0 | 1 | RWW | N/A |  |  | Traction Motor HP | Boolean | 0 | 1 | No |  | Yes | 1h | OBJECT=DIGITAL_SIGNAL_IN SECTION=TractionDI NUMBER_FORMAT=2:0=Inactive:1=Active MASTER=TRUE CATEGORY=MONITORING
 | 217Ch | 0 | 1 | RWW | N/A |  |  | Hard Wired Stop Input | Boolean | 0 | 1 | No |  | Yes | 1h | OBJECT=DIGITAL_SIGNAL_IN SECTION=TractionDI NUMBER_FORMAT=2:1=Inactive:0=Active MASTER=TRUE CATEGORY=MONITORING
 | 2220h | 0 | 1 | RWW | N/A | 0.00390625 | V | Throttle Input Voltage | Integer16 | -32768 | 32767 | No |  | Yes | 1h | OBJECT=ANALOGUE_SIGNAL_IN SECTION=TractionAI MASTER=TRUE CATEGORY=MONITORING
 | 2221h | 0 | 1 | RWW | N/A | 0.00390625 | V | Footbrake Pot Input Voltage | Integer16 | -32768 | 32767 | No |  | Yes | 1h | OBJECT=ANALOGUE_SIGNAL_IN SECTION=TractionAI MASTER=TRUE CATEGORY=MONITORING
 | 2222h | 0 | 1 | RWW | N/A | 0.00390625 | V | Economy Input Voltage | Integer16 | -32768 | 32767 | No |  | Yes | 1h | OBJECT=ANALOGUE_SIGNAL_IN SECTION=TractionAI MASTER=TRUE CATEGORY=MONITORING
 | 2223h | 0 | 1 | RWW | N/A | 0.00390625 | V | Steer Pot Input Voltage | Integer16 | -32768 | 32767 | No |  | Yes | 1h | OBJECT=ANALOGUE_SIGNAL_IN SECTION=TractionAI MASTER=TRUE CATEGORY=MONITORING
 | 2224h | 0 | 1 | RWW | N/A | 0.00390625 | V | Throttle 2 Input Voltage | Integer16 | -32768 | 32767 | No |  | Yes | 1h | OBJECT=ANALOGUE_SIGNAL_IN SECTION=TractionAI MASTER=TRUE CATEGORY=MONITORING
 | 2240h | 0 | 1 | RWW | N/A | 0.00390625 | V | Pump Throttle 1 Input Voltage | Integer16 | -32768 | 32767 | No |  | Yes | 1h | OBJECT=ANALOGUE_SIGNAL_IN SECTION=TractionAI MASTER=TRUE CATEGORY=MONITORING
 | 2241h | 0 | 1 | RWW | N/A | 0.00390625 | V | Pump Throttle 2 Input Voltage | Integer16 | -32768 | 32767 | No |  | Yes | 1h | OBJECT=ANALOGUE_SIGNAL_IN SECTION=TractionAI MASTER=TRUE CATEGORY=MONITORING
 | 2320h | 0 | 1 | RO | N/A |  |  | Traction Drive Hour-meter output | Boolean | 0 | 1 | No |  | Yes | 0 | OBJECT=DIGITAL_SIGNAL_OUT SECTION=TractionDO NUMBER_FORMAT=2:0=Inactive:1=Active MASTER=TRUE CATEGORY=MONITORING
 | 2400h | 0 | 1 | RO | N/A |  |  | Line contactor | Integer16 | 0 | 32767 | No |  | Yes | 0 | OBJECT=ANALOGUE_SIGNAL_OUT SECTION=VehicleAO NUMBER_FORMAT=BASE16 MASTER=TRUE CATEGORY=MONITORING
 | 2401h | 0 | 1 | RO | N/A |  |  | External LED | Integer16 | 0 | 32767 | No |  | Yes | 0 | OBJECT=ANALOGUE_SIGNAL_OUT SECTION=VehicleAO NUMBER_FORMAT=BASE16 MASTER=TRUE CATEGORY=MONITORING
 | 2402h | 0 | 1 | RO | N/A |  |  | Alarm buzzer | Integer16 | 0 | 32767 | No |  | Yes | 0 | OBJECT=ANALOGUE_SIGNAL_OUT SECTION=VehicleAO NUMBER_FORMAT=BASE16 MASTER=TRUE CATEGORY=MONITORING
 | 2403h | 0 | 1 | RO | N/A |  |  | Horn | Integer16 | 0 | 32767 | No |  | Yes | 0 | OBJECT=ANALOGUE_SIGNAL_OUT SECTION=VehicleAO NUMBER_FORMAT=BASE16 MASTER=TRUE CATEGORY=MONITORING
 | 2404h | 0 | 1 | RO | N/A |  |  | Brake Lights | Integer16 | 0 | 32767 | No |  | Yes | 0 | OBJECT=ANALOGUE_SIGNAL_OUT SECTION=VehicleAO NUMBER_FORMAT=BASE16 MASTER=TRUE CATEGORY=MONITORING
 | 2405h | 0 | 1 | RO | N/A |  |  | Service Due | Integer16 | 0 | 32767 | No |  | Yes | 0 | OBJECT=ANALOGUE_SIGNAL_OUT SECTION=VehicleAO NUMBER_FORMAT=BASE16 MASTER=TRUE CATEGORY=MONITORING
 | 2406h | 0 | 1 | RO | N/A |  |  | System Cooling Fan | Integer16 | 0 | 32767 | No |  | Yes | 0 | OBJECT=ANALOGUE_SIGNAL_OUT SECTION=VehicleAO NUMBER_FORMAT=BASE16 MASTER=TRUE CATEGORY=MONITORING
 | 2407h | 0 | 1 | RO | N/A |  |  | Secondary Line Contactor | Integer16 | 0 | 32767 | No |  | Yes | 0 | OBJECT=ANALOGUE_SIGNAL_OUT SECTION=VehicleAO NUMBER_FORMAT=BASE16 MASTER=TRUE CATEGORY=MONITORING
 | 2408h | 0 | 1 | RO | N/A |  |  | Thermal Cutback Indication | Integer16 | 0 | 32767 | No |  | Yes | 0 | OBJECT=ANALOGUE_SIGNAL_OUT SECTION=VehicleAO NUMBER_FORMAT=BASE16 MASTER=TRUE CATEGORY=MONITORING
 | 2420h | 0 | 1 | RO | N/A |  |  | Electro-mechanical brake | Integer16 | 0 | 32767 | No |  | Yes | 0 | OBJECT=ANALOGUE_SIGNAL_OUT SECTION=TractionAO NUMBER_FORMAT=BASE16 MASTER=TRUE CATEGORY=MONITORING
 | 2421h | 0 | 1 | RO | N/A |  |  | Traction Motor Cooling Fan | Integer16 | 0 | 32767 | No |  | Yes | 0 | OBJECT=ANALOGUE_SIGNAL_OUT SECTION=TractionAO NUMBER_FORMAT=BASE16 MASTER=TRUE CATEGORY=MONITORING
 | 2422h | 0 | 1 | RO | N/A |  |  | Motor Isolation Contactor | Integer16 | 0 | 32767 | No |  | Yes | 0 | OBJECT=ANALOGUE_SIGNAL_OUT SECTION=TractionAO NUMBER_FORMAT=BASE16 MASTER=TRUE CATEGORY=MONITORING
 | 2423h | 0 | 1 | RO | N/A |  |  | High / Low Speed Indication | Integer16 | 0 | 32767 | No |  | Yes | 0 | OBJECT=ANALOGUE_SIGNAL_OUT SECTION=TractionAO NUMBER_FORMAT=BASE16 MASTER=TRUE CATEGORY=MONITORING
 | 2424h | 0 | 1 | RO | N/A |  |  | UVR Coil | Integer16 | 0 | 32767 | No |  | Yes | 0 | OBJECT=ANALOGUE_SIGNAL_OUT SECTION=TractionAO NUMBER_FORMAT=BASE16 MASTER=TRUE CATEGORY=MONITORING
 | 2425h | 0 | 1 | RO | N/A |  |  | Park brake | Integer16 | 0 | 32767 | No |  | Yes | 0 | OBJECT=ANALOGUE_SIGNAL_OUT SECTION=TractionAO NUMBER_FORMAT=BASE16 MASTER=TRUE CATEGORY=MONITORING
 | 2426h | 0 | 1 | RO | N/A |  |  | Service Brake | Integer16 | 0 | 32767 | No |  | Yes | 0 | OBJECT=ANALOGUE_SIGNAL_OUT SECTION=TractionAO NUMBER_FORMAT=BASE16 MASTER=TRUE CATEGORY=MONITORING
 | 2440h | 0 | 1 | RO | N/A |  |  | Pump contactor | Integer16 | 0 | 32767 | No |  | Yes | 0 | OBJECT=ANALOGUE_SIGNAL_OUT SECTION=PumpAO NUMBER_FORMAT=BASE16 MASTER=TRUE CATEGORY=MONITORING
 | 2441h | 0 | 1 | RO | N/A |  |  | Pump Monitor Output | Integer16 | 0 | 32767 | No |  | Yes | 0 | OBJECT=ANALOGUE_SIGNAL_OUT SECTION=TractionAO NUMBER_FORMAT=BASE16 MASTER=TRUE CATEGORY=MONITORING
 | 2442h | 0 | 1 | RO | N/A |  |  | Precharge complete, CB closed indication | Integer16 | 0 | 32767 | No |  | Yes | 0 | OBJECT=ANALOGUE_SIGNAL_OUT SECTION=TractionAO NUMBER_FORMAT=BASE16 MASTER=TRUE CATEGORY=MONITORING
 | 2443h | 0 | 1 | RO | N/A |  |  | Pump Tilt Out Solenoid | Integer16 | 0 | 32767 | No |  | Yes | 0 | OBJECT=ANALOGUE_SIGNAL_OUT SECTION=PumpAO NUMBER_FORMAT=BASE16 MASTER=TRUE CATEGORY=MONITORING
 | 2444h | 0 | 1 | RO | N/A |  |  | Pump Tilt In Solenoid | Integer16 | 0 | 32767 | No |  | Yes | 0 | OBJECT=ANALOGUE_SIGNAL_OUT SECTION=PumpAO NUMBER_FORMAT=BASE16 MASTER=TRUE CATEGORY=MONITORING
 | 2445h | 0 | 1 | RO | N/A |  |  | Pump Lift Up Solenoid | Integer16 | 0 | 32767 | No |  | Yes | 0 | OBJECT=ANALOGUE_SIGNAL_OUT SECTION=PumpAO NUMBER_FORMAT=BASE16 MASTER=TRUE CATEGORY=MONITORING
 | 2446h | 0 | 1 | RO | N/A |  |  | Pump Lift Down Solenoid | Integer16 | 0 | 32767 | No |  | Yes | 0 | OBJECT=ANALOGUE_SIGNAL_OUT SECTION=PumpAO NUMBER_FORMAT=BASE16 MASTER=TRUE CATEGORY=MONITORING
 | 2447h | 0 | 1 | RO | N/A |  |  | Pump Lock Solenoid | Integer16 | 0 | 32767 | No |  | Yes | 0 | OBJECT=ANALOGUE_SIGNAL_OUT SECTION=PumpAO NUMBER_FORMAT=BASE16 MASTER=TRUE CATEGORY=MONITORING
 | 2460h | 0 | 1 | RO | N/A |  |  | Power steer contactor | Integer16 | 0 | 32767 | No |  | Yes | 0 | OBJECT=ANALOGUE_SIGNAL_OUT SECTION=PSteerAO NUMBER_FORMAT=BASE16 MASTER=TRUE CATEGORY=MONITORING
 | 2620h | 0 | 1 | RO | N/A | 3.051850948e-05 |  | Throttle Value | Integer16 | -32768 | 32767 | No |  | Yes | 0 | OBJECT=ANALOGUE_SIGNAL_VALUE SECTION=TractionAO MASTER=TRUE CATEGORY=MONITORING
 | 2621h | 0 | 1 | RO | N/A | 3.051850948e-05 |  | Footbrake Value | Integer16 | -32768 | 32767 | No |  | Yes | 0 | OBJECT=ANALOGUE_SIGNAL_VALUE SECTION=TractionAO MASTER=TRUE CATEGORY=MONITORING
 | 2622h | 0 | 1 | RO | N/A | 3.051850948e-05 |  | Economy Value | Integer16 | -32768 | 32767 | No |  | Yes | 0 | OBJECT=ANALOGUE_SIGNAL_VALUE SECTION=TractionAO MASTER=TRUE CATEGORY=MONITORING
 | 2623h | 0 | 1 | RO | N/A | 3.051850948e-05 |  | Steer Angle | Integer16 | -32768 | 32767 | No |  | Yes | 0 | OBJECT=ANALOGUE_SIGNAL_VALUE SECTION=TractionAO MASTER=TRUE CATEGORY=MONITORING
 | 2624h | 0 | 1 | RWW | N/A | 0.01 | Degrees | Steer Angle (in degrees) | Integer16 | -9000 | 9000 | No | As 2923h but in 0.01 degree's/bit. Can also be overwritten to provide external twin motor steering control. | Yes | 0 | OBJECT=ANALOGUE_SIGNAL_VALUE SECTION=TractionValue MASTER=TRUE CATEGORY=MONITORING
 | 2625h | 0 | 1 | RWW | N/A | 0.01 | Degrees | Analogue tilt switch ( in degrees) | Integer16 | -32768 | 32767 | No | slope angle from analogue tilt switch ( already converted into degrees) | Yes | 0 | OBJECT=ANALOGUE_SIGNAL_VALUE SECTION=TractionValue MASTER=TRUE CATEGORY=MONITORING
 | 2640h | 0 | 1 | RO | N/A | 3.051850948e-05 |  | Pump Throttle 1 Value | Integer16 | -32768 | 32767 | No |  | Yes | 0 | OBJECT=ANALOGUE_SIGNAL_VALUE SECTION=PumpAO MASTER=TRUE CATEGORY=MONITORING
 | 2641h | 0 | 1 | RO | N/A | 3.051850948e-05 |  | Pump Throttle 2 Value | Integer16 | -32768 | 32767 | No |  | Yes | 0 | OBJECT=ANALOGUE_SIGNAL_VALUE SECTION=PumpAO MASTER=TRUE CATEGORY=MONITORING
 | 2720h | ---- | ---- | ---- | ---- |  |  | Traction Application Status | Record | N/A | N/A | ---- | Contains various status information about the Traction Application. Mainly used for debug purposes. | ---- | ---- | OBJECT=TRACTION_STATUS SECTION=TractionStatus MASTER=TRUE CATEGORY=MONITORING
 |  | 0 | 1 | RO | N/A |  |  | Number of entries | Unsigned8 | 0 | FFh | 5 |  | No | 0
 |  | 1 | 1 | RO | N/A |  |  | Driveability Profile Status | Unsigned16 | 0 | FFFFh | No | Indicates if a driveablity profile is active or not. Each bit corresponds to one profile. Ie: Bit 0: Baseline (should always be 1) Bit 1: Driveability Select 1. Bit 2: Driveability Select 2. Bit 3: Low Speed Bit 4: BDI Bit 5: Service | Yes | 0 |  | DESC=Baseline:HEX_MASK=1:MIN=0:MAX=1:NF=2:0=On:1=Off DESC=Driveability Select 1:HEX_MASK=2:MIN=0:MAX=1:NF=2:0=On:1=Off DESC=Driveability Select 2:HEX_MASK=4:MIN=0:MAX=1:NF=2:0=On:1=Off DESC=Low Speed:HEX_MASK=8:MIN=0:MAX=1:NF=2:0=On:1=Off DESC=BDI:HEX_MASK=10:MIN=0:MAX=1:NF=2:0=On:1=Off DESC=Service:HEX_MASK=20:MIN=0:MAX=1:NF=2:0=On:1=Off
 |  | 2 | 1 | RO | N/A |  |  | Traction Drive State | Unsigned8 | 0 | FFh | No | State of main Traction Drive FSM | Yes | 0 | NUMBER_FORMAT=11 0=OFF:1=FOOTBRAKING:2=DRIVE 3=STOP_AT_CD_RATE:4=CD_DECEL:5=CD_ACCEL 6=NTRL_BRK_OR_COAST:7=HILL_HOLD:8=IDLE 9=POWER_OFF:10=CONTROLLED_ROLL_OFF
 |  | 3 | 1 | RO | N/A |  |  | Drive / Direction Change State | Unsigned8 | 0 | FFh | No | State of Drive/Direction Change FSM | Yes | 0 | NUMBER_FORMAT=7 0=NO_DIR_SEL_NO_LDD 1=FWD_SEL_LDD_FWD:2=NO_DIR_SEL_LDD_FWD 3=REV_SEL_LDD_FWD:4=FWD_SEL_LDD_REV 5=NO_DIR_SEL_LDD_REV:6=REV_SEL_LDD_REV
 |  | 4 | 1 | RO | N/A |  |  | SRO State | Unsigned8 | 0 | FFh | No | State of SRO FSM | Yes | 0 | NUMBER_FORMAT=5 0=NO_FS1_NO_DIR:1=NO_FS1_DIR_ACTIVE 2=FS1_ACTIVE_NO_DIR 3=FS1_ACTIVE_DIR_ACTIVE:4=SRO_FAULT
 |  | 5 | 1 | RO | N/A |  |  | Operator Presence (Seat) State | Unsigned8 | 0 | FFh | No | State of Operator Presence (Seat switch) FSM | Yes | 0 | NUMBER_FORMAT=5 0=SEAT_SWITCH_INACTIVE 1=SEAT_SWITCH_ACTIVE:2=IN_DRIVE 3=SEAT_INACTIVE_IN_DRIVE:4=SEAT_FAULT
 | 2721h | 0 | 1 | RO | N/A |  |  | Vehicle Speed | Integer16 | -32768 | 32767 | 0 | Gives the scaled vehicle speed in the units defined by the gear ratio | Yes | 1h | OBJECT=VEHICLE_SPEED SECTION=TractionStatus EEPROM=app_stat.real_speed MASTER=TRUE CATEGORY=MONITORING
 | 2730h | ---- | ---- | ---- | ---- |  |  | Vehicle Maximum Speeds | Record | N/A | N/A | ---- | Maximum allowable vehicle speeds. Allows runtime limiting of vehicle speed in addition to the driveability profile maximum speeds | ---- | ---- | OBJECT=VEHICLE_SPEED_LIMITS SECTION=TractionStatus MASTER=TRUE CATEGORY=MONITORING
 |  | 0 | 1 | RO | N/A |  |  | Number of entries | Unsigned8 | 0 | FFh | 2 |  | No | 0
 |  | 1 | 1 | RWW | N/A | 0.01 | % | Forward speed limit | Unsigned16 | 0 | FFFFh | No |  | Yes | 1h
 |  | 2 | 1 | RWW | N/A | 0.01 | % | Reverse speed limit | Unsigned16 | 0 | FFFFh | No |  | Yes | 1h
 | 2740h | ---- | ---- | ---- | ---- |  |  | Pump Application Status | Record | N/A | N/A | ---- | Contains various status information about the Pump Application. Mainly used for debug purposes. | ---- | ---- | OBJECT=PUMP_STATUS SECTION=PUMPSTATUS MASTER=TRUE CATEGORY=MONITORING
 |  | 0 | 1 | RO | N/A |  |  | Number of entries | Unsigned8 | 0 | FFh | 1 |  | No | 0
 |  | 1 | 1 | RO | N/A |  |  | Pump Drive State | Unsigned8 | 0 | FFh | No | State of main Pump Drive FSM | Yes | 0 | NUMBER_FORMAT=6 0=OFF:1=NEUTRAL:2=PUMP_REQ_BUT_INHIBITED 3=PUMP_INHIBIT:4=PUMP:5=PUMP_DURING_INHIBIT
 |  | 2 | 1 | RO | N/A |  |  | Pump Driveability Profile Status | Unsigned16 | 0 | FFFFh | No | Indicates if a driveablity profile is active or not. Each bit corresponds to one profile. Ie: Bit 0: Baseline (should always be 1) Bit 1: Driveability Select 1. Bit 2: Driveability Select 2. | Yes | 0 |  | DESC=Baseline:HEX_MASK=1:MIN=0:MAX=1:NF=2:0=On:1=Off DESC=Driveability Select 1:HEX_MASK=2:MIN=0:MAX=1:NF=2:0=On:1=Off DESC=Driveability Select 2:HEX_MASK=4:MIN=0:MAX=1:NF=2:0=On:1=Off
 | 2760h | ---- | ---- | ---- | ---- |  |  | Power Steer Application Status | Record | N/A | N/A | ---- | Contains various status information about the Power Steer Application. Mainly used for debug purposes. | ---- | ---- | OBJECT=PSTEER_STATUS SECTION=PSTEERSTATUS MASTER=TRUE CATEGORY=MONITORING
 |  | 0 | 1 | RO | N/A |  |  | Number of entries | Unsigned8 | 0 | FFh | 1 |  | No | 0
 |  | 1 | 1 | RO | N/A |  |  | Power Steer Drive State | Unsigned8 | 0 | FFh | No | State of main Power Steer Drive FSM | Yes | 0 | NUMBER_FORMAT=4 0=OFF:1=NEUTRAL 2=WAIT_FOR_TIMEOUT:3=POWER_STEER
 | 2780h | ---- | ---- | ---- | ---- |  |  | Vehicle hours | Record | N/A | N/A | ---- | Vehicle hours counter offsets. | ---- | ---- | OBJECT=HOURS_COUNTER_OFFSETS SECTION=HoursCounters MASTER=TRUE CATEGORY=CONFIGURATION
 |  | 0 | 1 | RO | N/A |  |  | Number of entries | Unsigned8 | 0 | FFh | 6 |  | No | 0
 |  | 1 | 1 | RW | 2 |  | Hours | Key hours counter offset | Unsigned16 | 0 | FFFFh | 0 |  | No | 1h | EEPROM=vehicle.vehicle_hrs_offsets_0
 |  | 2 | 1 | RW | 2 |  | Hours | Traction hours counter offset | Unsigned16 | 0 | FFFFh | 0 |  | No | 1h | EEPROM=vehicle.vehicle_hrs_offsets_1
 |  | 3 | 1 | RW | 2 |  | Hours | Pump hours counter offset | Unsigned16 | 0 | FFFFh | 0 |  | No | 1h | EEPROM=vehicle.vehicle_hrs_offsets_2
 |  | 4 | 1 | RW | 2 |  | Hours | Power steer hours counter offset | Unsigned16 | 0 | FFFFh | 0 |  | No | 1h | EEPROM=vehicle.vehicle_hrs_offsets_3
 |  | 5 | 1 | RW | 2 |  | Hours | Work hours counter offset | Unsigned16 | 0 | FFFFh | 0 |  | No | 1h | EEPROM=vehicle.vehicle_hrs_offsets_4
 |  | 6 | 1 | RW | 2 |  | Hours | Charging hours counter offset | Unsigned16 | 0 | FFFFh | 0 |  | No | 1h | EEPROM=vehicle.vehicle_hrs_offsets_4
 | 2781h | ---- | ---- | ---- | ---- |  |  | Key Hours Counter | Record | N/A | N/A | ---- |  | ---- | ---- | OBJECT=HOURS_COUNTER SECTION=HoursCounters MASTER=TRUE CATEGORY=LOGGING
 |  | 0 | 1 | RO | N/A |  |  | Number of entries | Unsigned8 | 0 | FFh | 2 |  | No | 0
 |  | 1 | 1 | RW | N/A |  | Hours | Hours | Unsigned16 | 0 | FFFFh | No | 1 hour / bit. Shows the hours in the EEPROM + the offset in 2780h. | Yes | 1h
 |  | 2 | 1 | RW | N/A | 0.25 | Minutes | Minutes / Seconds | Unsigned8 | 0 | EFh | No | 15 secs / bit | Yes | 1h
 | 2782h | ---- | ---- | ---- | ---- |  |  | Traction Hours Counter | Record | N/A | N/A | ---- |  | ---- | ---- | OBJECT=HOURS_COUNTER SECTION=HoursCounters MASTER=TRUE CATEGORY=LOGGING
 |  | 0 | 1 | RO | N/A |  |  | Number of entries | Unsigned8 | 0 | FFh | 2 |  | No | 0
 |  | 1 | 1 | RW | N/A |  | Hours | Hours | Unsigned16 | 0 | FFFFh | No | 1 hour / bit. Shows the hours in the EEPROM + the offset in 2780h. | Yes | 1h
 |  | 2 | 1 | RW | N/A | 0.25 | Minutes | Minutes / Seconds | Unsigned8 | 0 | EFh | No | 15 secs / bit | Yes | 1h
 | 2783h | ---- | ---- | ---- | ---- |  |  | Pump Hours Counter | Record | N/A | N/A | ---- |  | ---- | ---- | OBJECT=HOURS_COUNTER SECTION=HoursCounters MASTER=TRUE CATEGORY=LOGGING
 |  | 0 | 1 | RO | N/A |  |  | Number of entries | Unsigned8 | 0 | FFh | 2 |  | No | 0
 |  | 1 | 1 | RW | N/A |  | Hours | Hours | Unsigned16 | 0 | FFFFh | No | 1 hour / bit. Shows the hours in the EEPROM + the offset in 2780h. | Yes | 1h
 |  | 2 | 1 | RW | N/A | 0.25 | Minutes | Minutes / Seconds | Unsigned8 | 0 | EFh | No | 15 secs / bit | Yes | 1h
 | 2784h | ---- | ---- | ---- | ---- |  |  | Power Steer Hours Counter | Record | N/A | N/A | ---- |  | ---- | ---- | OBJECT=HOURS_COUNTER SECTION=HoursCounters MASTER=TRUE CATEGORY=LOGGING
 |  | 0 | 1 | RO | N/A |  |  | Number of entries | Unsigned8 | 0 | FFh | 2 |  | No | 0
 |  | 1 | 1 | RW | N/A |  | Hours | Hours | Unsigned16 | 0 | FFFFh | No | 1 hour / bit. Shows the hours in the EEPROM + the offset in 2780h. | Yes | 1h
 |  | 2 | 1 | RW | N/A | 0.25 | Minutes | Minutes / Seconds | Unsigned8 | 0 | EFh | No | 15 secs / bit | Yes | 1h
 | 2785h | ---- | ---- | ---- | ---- |  |  | Work Hours Counter | Record | N/A | N/A | ---- |  | ---- | ---- | OBJECT=HOURS_COUNTER SECTION=HoursCounters MASTER=TRUE CATEGORY=LOGGING
 |  | 0 | 1 | RO | N/A |  |  | Number of entries | Unsigned8 | 0 | FFh | 2 |  | No | 0
 |  | 1 | 1 | RW | N/A |  | Hours | Hours | Unsigned16 | 0 | FFFFh | No | 1 hour / bit. Shows the hours in the EEPROM + the offset in 2780h. | Yes | 1h
 |  | 2 | 1 | RW | N/A | 0.25 | Minutes | Minutes / Seconds | Unsigned8 | 0 | EFh | No | 15 secs / bit | Yes | 1h
 | 2786h | ---- | ---- | ---- | ---- |  |  | Charging Hours Counter | Record | N/A | N/A | ---- |  | ---- | ---- | OBJECT=HOURS_COUNTER SECTION=HoursCounters MASTER=TRUE CATEGORY=LOGGING
 |  | 0 | 1 | RO | N/A |  |  | Number of entries | Unsigned8 | 0 | FFh | 2 |  | No | 0
 |  | 1 | 1 | RW | N/A |  | Hours | Hours | Unsigned16 | 0 | FFFFh | No | 1 hour / bit. Shows the hours in the EEPROM + the offset in 2780h. | Yes | 1h
 |  | 2 | 1 | RW | N/A | 0.25 | Minutes | Minutes / Seconds | Unsigned8 | 0 | EFh | No | 15 secs / bit | Yes | 1h
 | 278Fh | 0 | 1 | RO | N/A |  |  | Running indicators | Unsigned16 | 0 | FFFFh | 0 | bit field representing each of the hours counters bit0 "Node Hrs", bit1 "Pulsing Hrs", bit2 "Key Hrs", bit3 "Trac Hrs", bit4 "Pump Hrs", bit5 "PS Hrs", bit6 "Work Hrs" The main use is to the tell CANopen display if an icon should be displayed for a particular activity | Yes | 1h | OBJECT=HOURS_COUNTER SECTION=HoursCounters MASTER=TRUE CATEGORY=MONITORING | DESC=Node Hours:HEX_MASK=1:MIN=0:MAX=1:NF=2:0=Stopped:1=Running DESC=Pulsing Hours:HEX_MASK=2:MIN=0:MAX=1:NF=2:0=Stopped:1=Running DESC=Key Hours:HEX_MASK=4:MIN=0:MAX=1:NF=2:0=Stopped:1=Running DESC=Traction Hours:HEX_MASK=8:MIN=0:MAX=1:NF=2:0=Stopped:1=Running DESC=Pump Hours:HEX_MASK=10:MIN=0:MAX=1:NF=2:0=Stopped:1=Running DESC=Power Steer Hours:HEX_MASK=20:MIN=0:MAX=1:NF=2:0=Stopped:1=Running DESC=Work Hours:HEX_MASK=40:MIN=0:MAX=1:NF=2:0=Stopped:1=Running
 | 2790h | ---- | ---- | ---- | ---- |  |  | Battery Status | Record | N/A | N/A | ---- |  | ---- | ---- | OBJECT=BatteryStatus SECTION=BatteryStatus MASTER=TRUE CATEGORY=MONITORING
 |  | 0 | 1 | RO | N/A |  |  | Number of parameters | Unsigned8 | 0 | FFh | 1 |  | No | 0
 |  | 1 | 1 | RO | N/A |  | % | BDI remaining charge | Unsigned8 | 0 | FFh | No | 1% / bit | Yes | 0
 | 2800h | 0 | 1 | RW | 4 |  |  | Force system to pre-operational state | Boolean | 0 | 1 | 0 | If set to 1, the Master will put itself and all the Slaves into pre-operational. The system is only allowed to enter operational when this is set to 0. | No | 1h | OBJECT=FORCE_TO_PREOP SECTION=CANopenSetup EEPROM=vehicle.force_to_pre_op NUMBER_FORMAT=2 0=Operational 1=Pre-Operational MASTER=TRUE CATEGORY=MONITORING
 | 2810h | ---- | ---- | ---- | ---- |  |  | Node Indication | Record | N/A | N/A | ---- | Indicates to the MASTER controller which nodes are connected in the network. | ---- | ---- | OBJECT=NODE_INDICATION SECTION=CANopenSetup MASTER=TRUE CATEGORY=CONFIGURATION
 |  | 0 | 1 | RW | 4 |  |  | Number of slaves | Unsigned8 | 0 | 7 | 0 | Maximum of 7 slaves allowed. | No | 0 | EEPROM=vehicle.number_slaves WRITE_IN_PREOPERATIONAL_ONLY=TRUE
 |  | 1 | 1 | RW | 4 |  |  | 1st slave node ID | Unsigned8 | 1 | 7Fh | 1 |  | No | 0 | EEPROM=vehicle.slave_node_id_0 WRITE_IN_PREOPERATIONAL_ONLY=TRUE
 |  | 2 | 1 | RW | 4 |  |  | 2nd slave node ID | Unsigned8 | 1 | 7Fh | 1 |  | No | 0 | EEPROM=vehicle.slave_node_id_1 WRITE_IN_PREOPERATIONAL_ONLY=TRUE
 |  | 3 | 1 | RW | 4 |  |  | 3rd slave node ID | Unsigned8 | 1 | 7Fh | 1 |  | No | 0 | EEPROM=vehicle.slave_node_id_2 WRITE_IN_PREOPERATIONAL_ONLY=TRUE
 |  | 4 | 1 | RW | 4 |  |  | 4th slave node ID | Unsigned8 | 1 | 7Fh | 1 |  | No | 0 | EEPROM=vehicle.slave_node_id_3 WRITE_IN_PREOPERATIONAL_ONLY=TRUE
 |  | 5 | 1 | RW | 4 |  |  | 5th slave node ID | Unsigned8 | 1 | 7Fh | 1 |  | No | 0 | EEPROM=vehicle.slave_node_id_4 WRITE_IN_PREOPERATIONAL_ONLY=TRUE
 |  | 6 | 1 | RW | 4 |  |  | 6th slave node ID | Unsigned8 | 1 | 7Fh | 1 |  | No | 0 | EEPROM=vehicle.slave_node_id_5 WRITE_IN_PREOPERATIONAL_ONLY=TRUE
 |  | 7 | 1 | RW | 4 |  |  | 7th slave node ID | Unsigned8 | 1 | 7Fh | 1 |  | No | 0 | EEPROM=vehicle.slave_node_id_6 WRITE_IN_PREOPERATIONAL_ONLY=TRUE
 | 2820h | ---- | ---- | ---- | ---- |  |  | Line Contactor parameters | Record | N/A | N/A | ---- | Parameters to configure line contactor operation | ---- | ---- | OBJECT=LINE_CONT_PARAM SECTION=VehicleConfig MASTER=TRUE CATEGORY=CONFIGURATION
 |  | 0 | 1 | RO | N/A |  |  | Number of parameters | Unsigned8 | 0 | FFh | 2 |  | No | 0
 |  | 1 | 1 | RW | 4 |  |  | Line contactor drop out enable | Boolean | 0 | 1 | 1 | 0 = Disabled, 1 = Enabled | No | 0 | EEPROM=vehicle.line_contactor_drop_enabled NUMBER_FORMAT=2:0=Disabled:1=Enabled WRITE_IN_PREOPERATIONAL_ONLY=TRUE
 |  | 2 | 1 | RW | 4 |  | Seconds | Line contactor drop out timer | Unsigned8 | 0 | FFh | 10 | 1s/bit | No | 0 | EEPROM=vehicle.line_contactor_drop_timer
 |  | 3 | 1 | RW | 4 |  |  | Line contactor options | Unsigned8 | 0 | FFh | 0 | Used to enable/disable line contactor features: Bit 0 - Disable line contactor welded test. PMAC variants only. | No | 0 |  | DESC=Disable Line Welded Fault:HEX_MASK=1:MIN=0:MAX=1:NF=2:0=Enable:1=Disable
 | 2830h | 0 | 1 | RW | 4 |  |  | Assumed fault severity level for EMCY received from non-sevcon nodes. | Unsigned8 | 0 | 5 | 3 | EMCY telegrams from Sevcon nodes include the fault ID in the manufacturer specific bytes. The fault ID gives the fault severity. Non-sevcon nodes will not supply this information so any EMCY message received from these nodes will be given the severity level defined in this object. Severity levels are: 0 - None, 1 - Warning, 2 - Drive Inhibit, 3 - Severe, 4 - Very severe and 5 - Return to base. | No | 0 | OBJECT=NON_SEVCON_EMCY_LEVEL SECTION=CANOPENSETUP EEPROM=vehicle.anon_emcy_severity WRITE_IN_PREOPERATIONAL_ONLY=TRUE MASTER=TRUE CATEGORY=CONFIGURATION
 | 2840h | ---- | ---- | ---- | ---- |  |  | Alarm Buzzer Configuration | Record | N/A | N/A | ---- | Parameters to configure alarm buzzer operation | ---- | ---- | OBJECT=BUZZER_CONFIG SECTION=VehicleConfig MASTER=TRUE CATEGORY=CONFIGURATION
 |  | 0 | 1 | RO | N/A |  |  | Number of parameters | Unsigned8 | 0 | FFh | 11 |  | No | 0
 |  | 1 | 1 | RW | 4 |  |  | Alarm buzzer source enable flags. | Unsigned8 | 0 | FFh | 0Fh | Set bit to enable buzzer source: Bit 0 - Forward. Bit 1 - Reverse. Bit 2 - Controlled Roll Off. Bit 3 - Fault. Bit 4 - BDI Low. | No | 0 | EEPROM=vehicle.buzzer_enable NUMBER_FORMAT=BASE16 WRITE_IN_PREOPERATIONAL_ONLY=TRUE | DESC=Forward:HEX_MASK=1:MIN=0:MAX=1:NF=2:0=No:1=Yes DESC=Reverse:HEX_MASK=2:MIN=0:MAX=1:NF=2:0=No:1=Yes DESC=Roll off:HEX_MASK=4:MIN=0:MAX=1:NF=2:0=No:1=Yes DESC=Fault:HEX_MASK=8:MIN=0:MAX=1:NF=2:0=No:1=Yes DESC=BDI low:HEX_MASK=10:MIN=0:MAX=1:NF=2:0=No:1=Yes
 |  | 2 | 1 | RW | 4 | 0.1 | Seconds | Forward Cadence On Time | Unsigned8 | 0 | FFh | 1 | 0.1s/bit. Buzzer on-time when vehicle is moving forward. | No | 0 | EEPROM=vehicle.buzzer_cadance[0][0]
 |  | 3 | 1 | RW | 4 | 0.1 | Seconds | Forward Cadence Off Time | Unsigned8 | 0 | FFh | 4 | 0.1s/bit. Buzzer off-time when vehicle is moving forward. | No | 0 | EEPROM=vehicle.buzzer_cadance[0][1]
 |  | 4 | 1 | RW | 4 | 0.1 | Seconds | Reverse Cadence On Time | Unsigned8 | 0 | FFh | 2 | 0.1s/bit. Buzzer on-time when vehicle is moving backwards. | No | 0 | EEPROM=vehicle.buzzer_cadance[1][0]
 |  | 5 | 1 | RW | 4 | 0.1 | Seconds | Reverse Cadence Off Time | Unsigned8 | 0 | FFh | 3 | 0.1s/bit. Buzzer off-time when vehicle is moving backwards. | No | 0 | EEPROM=vehicle.buzzer_cadance[1][1]
 |  | 6 | 1 | RW | 4 | 0.1 | Seconds | Fault Cadence On Time | Unsigned8 | 0 | FFh | 3 | 0.1s/bit. Buzzer on-time when a fault is active. | No | 0 | EEPROM=vehicle.buzzer_cadance[2][0]
 |  | 7 | 1 | RW | 4 | 0.1 | Seconds | Fault Cadence Off Time | Unsigned8 | 0 | FFh | 2 | 0.1s/bit. Buzzer off-time when a fault is active. | No | 0 | EEPROM=vehicle.buzzer_cadance[2][1]
 |  | 8 | 1 | RW | 4 | 0.1 | Seconds | Controlled Roll Off Cadence On Time | Unsigned8 | 0 | FFh | 4 | 0.1s/bit. Buzzer on-time when vehicle is rolling away. | No | 0 | EEPROM=vehicle.buzzer_cadance[3][0]
 |  | 9 | 1 | RW | 4 | 0.1 | Seconds | Controlled Roll Off Cadence Off Time | Unsigned8 | 0 | FFh | 1 | 0.1s/bit. Buzzer off-time when vehicle is rolling away. | No | 0 | EEPROM=vehicle.buzzer_cadance[3][1]
 |  | 10 | 1 | RW | 4 | 0.1 | Seconds | BDI low Cadence On Time | Unsigned8 | 0 | FFh | 3 | 0.1s/bit. Buzzer on-time when a fault is active. | No | 0 | EEPROM=misc.bdi_cadence[0]
 |  | 11 | 1 | RW | 4 | 0.1 | Seconds | BDI low Cadence Off Time | Unsigned8 | 0 | FFh | 2 | 0.1s/bit. Buzzer off-time when a fault is active. | No | 0 | EEPROM=misc.bdi_cadence[1]
 | 2850h | ---- | ---- | ---- | ---- |  |  | Servicing | Record | N/A | N/A | ---- | Parameters to configure service alert. | ---- | ---- | OBJECT=SERVICE_CONFIG SECTION=VehicleConfig MASTER=TRUE CATEGORY=CONFIGURATION
 |  | 0 | 1 | RO | N/A |  |  | Number of parameters | Unsigned8 | 0 | FFh | 5 |  | No | 0
 |  | 1 | 1 | WO | 1 |  |  | Reset (write to reset next service time) | Boolean | 0 | 1h | No | This automatically resets the service alert by setting the Next Service Due hours to the current hours + Service Interval. Alternatively, the Next Service Due hours can be updated manually. | No | 1h | NUMBER_FORMAT=2:0=Reset:1=Reset
 |  | 2 | 1 | RW | 2 |  |  | Flags | Unsigned8 | 0 | FFh | 0 | Bits are: 0 - Enable (set to enable service alert). 1 - Active Contactor Drive output (2405h) 2 - Indicate service on controller LED (15FF). | No | 0 | EEPROM=vehicle.service_flags WRITE_IN_PREOPERATIONAL_ONLY=TRUE | DESC=Enable Service:HEX_MASK=1:MIN=0:MAX=1:NF=2:0=On:1=Off DESC=Activate Contactor Drive:HEX_MASK=2:MIN=0:MAX=1:NF=2:0=No:1=Yes DESC=Flash LED:HEX_MASK=4:MIN=0:MAX=1:NF=2:0=No:1=Yes
 |  | 3 | 1 | RW | 2 |  |  | Source Hours Counter | Unsigned8 | 0 | FFh | 80h | Used to select the source hours counter to use for service: 00h - Device key hours. 01h - Device pulsing hours. 80h - Vehicle key hours. 81h - Vehicle traction hours 82h - Vehicle pump hours 83h - Vehicle power steer hours 84h - Vehicle work hours | No | 0 | EEPROM=vehicle.service_source NUMBER_FORMAT=BASE16 WRITE_IN_PREOPERATIONAL_ONLY=TRUE
 |  | 4 | 1 | RW | 2 |  | Hours | Time between services (Service Interval) | Unsigned16 | 0 | FFFFh | 0 | 1 hour / bit. This is the time before the next service is due. | No | 0 | EEPROM=vehicle.service_interval
 |  | 5 | 1 | RW | 2 |  | Hours | Next Service Due time | Unsigned16 | 0 | FFFFh | FFFFh | 1 hour / bit. The hours when the next service will be flagged. This can be set automatically to the source hours + interval by writing to subindex 1. | No | 1h | EEPROM=vehicle.service_next_due
 | 2860h | ---- | ---- | ---- | ---- |  |  | System Cooling Fan configuration | Record | N/A | N/A | ---- | Parameters to configure system cooling fan. | ---- | ---- | OBJECT=SYSTEM_COOLING_FAN_CONFIG SECTION=VehicleConfig MASTER=TRUE CATEGORY=CONFIGURATION
 |  | 0 | 1 | RO | N/A |  |  | Number of parameters | Unsigned8 | 0 | FFh | 2 |  | No | 0
 |  | 1 | 1 | RW | 4 | 0.00390625 | V | Half Speed output voltage | Unsigned16 | 0 | FFFFh | 0 | The output voltage set when the system cooling fan is running at half speed. | No | 0 | EEPROM=misc.system_cooling_fan_half_speed_v
 |  | 2 | 1 | RW | 4 | 0.00390625 | V | Full Speed output voltage | Unsigned16 | 0 | FFFFh | 0 | The output voltage set when the system cooling fan is running at full speed. | No | 0 | EEPROM=misc.system_cooling_fan_full_speed_v
 | 2860h | ---- | ---- | ---- | ---- |  |  | UVR config parameters | Record | N/A | N/A | ---- | Parameters to configure systems using UVR contacts | ---- | ---- | OBJECT=UVR_PARAM SECTION=VehicleConfig MASTER=TRUE CATEGORY=CONFIGURATION
 |  | 0 | 2 | RO | N/A |  |  | Number of parameters | Unsigned8 | 0 | FFh | 2 |  | No | 0
 |  | 1 | 2 | RW | 2 | 0.001 | Seconds | UVR Timer | Unsigned32 | 0 | 1200000 | 0 | 0.001s/bit | No | 0 | EEPROM=misc.uvr_config_timeout
 |  | 2 | 2 | RW | 2 | 0.001 | Seconds | Powerdown Timer | Unsigned32 | 0 | 1200000 | 0 | 0.001s/bit | No | 0 | EEPROM=misc.uvr_config_power_down_timeout
 | 2870h | ---- | ---- | ---- | ---- |  |  | Master Battery Current Limit Parameters | Record | N/A | N/A | ---- |  | ---- | ---- | OBJECT=IBATT_LIMIT_PARAM SECTION=TractionConfig MASTER=TRUE CATEGORY=CONFIGURATION
 |  | 0 | 1 | RO | N/A |  |  | Number of parameters | Unsigned8 | 0 | FFh | 3 |  | No | 0
 |  | 1 | 1 | RW | 2 |  |  | Battery current limit data source | Unsigned8 | 0 | 2 | 0 |  | No | 0 | EEPROM=traction.traction_mode NUMBER_FORMAT=2 0=Disabled:1=Use object:2=Use Delaware BMS WRITE_IN_PREOPERATIONAL_ONLY=TRUE
 |  | 2 | 1 | RW | 2 |  | A | Maximum battery discharge current | Signed16 | 0 | 7FFFh | 100 |  | Yes | 0
 |  | 3 | 1 | RW | 2 |  | A | Maximum battery recharge current | Signed16 | 0 | 8000h | FF9Ch |  | Yes | 0
 | 2900h | 0 | 1 | RW | 4 |  |  | Traction control mode (Torque/speed mode (0) or closed loop speed control (0)) | Boolean | 0 | 1 | 0 | Torque / Speed mode (0) or Closed Loop Speed Control (1). | No | 0 | OBJECT=TRAC_CTRL_MODE SECTION=TractionConfig EEPROM=traction.traction_mode NUMBER_FORMAT=2 0=Torque/Speed:1=Speed Control WRITE_IN_PREOPERATIONAL_ONLY=TRUE MASTER=TRUE CATEGORY=CONFIGURATION
 | 2901h | 0 | 1 | RW | 2 | 0.1 | Seconds | Hill hold delay | Unsigned8 | 0 | FFh | 0 | 0.1s/bit | No | 0 | OBJECT=HILL_HOLD_DELAY SECTION=TractionConfig EEPROM=traction.hill_hold_delay MASTER=TRUE CATEGORY=CONFIGURATION
 | 2902h | 0 | 1 | RW | 2 | 0.1 | Seconds | Seat Switch delay | Unsigned8 | 0 | FFh | 20 | 0.1s/bit | No | 0 | OBJECT=SEAT_DELAY SECTION=TractionConfig EEPROM=traction.seat_delay MASTER=TRUE CATEGORY=CONFIGURATION
 | 2903h | ---- | ---- | ---- | ---- |  |  | Electromechanical Brake parameters | Record | N/A | N/A | ---- |  | ---- | ---- | OBJECT=EBRAKE_PARAM SECTION=TractionConfig MASTER=TRUE CATEGORY=CONFIGURATION
 |  | 0 | 1 | RO | N/A |  |  | Number of parameters | Unsigned8 | 0 | FFh | 3 |  | No | 0
 |  | 1 | 1 | RW | 4 | 0.1 | Seconds | Electromechanical brake apply delay | Unsigned8 | 0 | FFh | 50 | Time between vehicle stopping (or entering hill hold or rolloff if configured) and the electrobrake being applied. Set this value to zero if you do not want the electrobrake to be applied automatically when the vehicle stops. | No | 0 | EEPROM=traction.ebrake_apply_delay
 |  | 2 | 1 | RW | 4 | 0.1 | Seconds | Electromechanical brake release delay | Unsigned8 | 0 | FFh | 0 | Time between electrobrake being released and drive being allowed. Set this if the electrobrake takes some time to physically release. Set to zero if you do not want a delay. | No | 0 | EEPROM=traction.ebrake_release_delay
 |  | 3 | 1 | RW | 4 |  |  | Electromechanical brake control | Unsigned8 | 0 | 1 | 0 | Used to select if the brake should remain applied until the motors are outputting torque or if it can release as soon as required. | No | 0 | NUMBER_FORMAT=2:0=Release after motor started:1=Release immediately WRITE_IN_PREOPERATIONAL_ONLY=TRUE
 | 2904h | ---- | ---- | ---- | ---- |  |  | High speed parameters | Record | N/A | N/A | ---- | Configures High Speed function. TODO | ---- | ---- | OBJECT=HIGH_SPEED_PARAM SECTION=TractionConfig MASTER=TRUE CATEGORY=CONFIGURATION
 |  | 0 | 1 | RO | N/A |  |  | Number of entries | Unsigned8 | 0 | FFh | 1 |  | No | 0
 |  | 1 | 1 | RW | 4 |  |  | Latched / momentary operation | Boolean | 0 | 1 | 1 | 0 = Latched, 1 = Momentary | No | 0 | EEPROM=traction.high_speed_latched_momentary NUMBER_FORMAT=2:0=Latched:1=Momentary WRITE_IN_PREOPERATIONAL_ONLY=TRUE
 | 2906h | ---- | ---- | ---- | ---- |  |  | Low Speed Profile Configuration | Record | N/A | N/A | ---- | Configures the low speed profile activation threshold | ---- | ---- | OBJECT=LOW_SPEED_PRO_CONFIG SECTION=TractionConfig MASTER=TRUE CATEGORY=CONFIGURATION
 |  | 0 | 1 | RO | N/A |  |  | Number of parameters | Unsigned8 | 0 | FFh | 1 |  | No | 0
 |  | 1 | 1 | RW | 4 |  | RPM | Speed below which low speed profile is active | Unsigned16 | 0 | FFFFh | 0 | The low speed profile is active below this velocity. | No | 0 | EEPROM=misc.low_speed_threshold
 | 2907h | ---- | ---- | ---- | ---- |  |  | High/Low Speed Indication Configuration | Record | N/A | N/A | ---- | Configures the High/Low speed indication output | ---- | ---- | OBJECT=SPEED_INDICATION_CONFIG SECTION=TractionConfig MASTER=TRUE CATEGORY=CONFIGURATION
 |  | 0 | 1 | RO | N/A |  |  | Number of parameters | Unsigned8 | 0 | FFh | 3 |  | No | 0
 |  | 1 | 1 | RW | 4 |  | RPM | Activation Speed | Unsigned16 | 0 | FFFFh | 0 | The high/low speed indication output activates based on this speed. | No | 0 | EEPROM=misc.high_low_speed_ind_act_speed
 |  | 2 | 1 | RW | 4 |  | RPM | Deactivation Speed | Unsigned16 | 0 | FFFFh | 0 | The high/low speed indication output deactivates based on this speed. | No | 0 | EEPROM=misc.high_low_speed_ind_deact_speed
 |  | 3 | 1 | RW | 4 | 0.00390625 | V | Analogue output voltage | Unsigned16 | 0 | FFFFh | 0 | The output voltage set when the output is activated | No | 0 | EEPROM=misc.high_low_speed_ind_ao_voltage
 | 2908h | 0 | 1 | RW | 4 |  | RPM | Drive torque disable speed | Unsigned16 | 0 | FFFFh | 500 | When in neutral brake, drive torque is disabled when the vehicle is above this speed to prevent drive against footbrakes. Drive torque is reenabled below this speed to assist entry to hill hold. | No | 0 | OBJECT=DRIVE_TRQ_DISABLE_SPEED EEPROM=misc.trac_drive_disable_speed SECTION=TractionConfig MASTER=TRUE CATEGORY=CONFIGURATION
 | 2909h | 0 | 1 | RW | 4 | 0.1 | Seconds | Direction change delay | Unsigned8 | 0 | FFh | 0 | Enter delay to insert between direction changes | No | 0 | OBJECT=DIR_CHANGE_DELAY EEPROM=misc.trac_dir_change_delay SECTION=TractionConfig MASTER=TRUE CATEGORY=CONFIGURATION
 | 290Ah | ---- | ---- | ---- | ---- |  |  | S-Curve Control |  | N/A | N/A | ---- |  | --- | --- | OBJECT=S_CURVE_PARAM SECTION=TractionConfig MASTER=TRUE CATEGORY=CONFIGURATION
 |  | 0 | 1 | RO | N/A |  |  | Number of parameters | Unsigned8 | 0 | FFh | 3 |  | No | 0
 |  | 1 | 1 | RW | 4 |  |  | Target speed approach curve | Unsigned8 | 1 | 11 | 8 | Enter value to determine the point at which the ramped speed will level out when approaching the demanded speed | No | 0 | EEPROM=misc.s_curve_factor_a
 |  | 2 | 1 | RW | 4 |  |  | Ramp change delay | Unsigned8 | 1 | 7Fh | 7Fh | Enter value to determine how quickly the system will change to a new ramp rate | No | 0 | EEPROM=misc.s_curve_factor_b
 |  | 3 | 1 | RW | 4 | 1 | RPM | Ramp change delay speed | Integer16 | 0 | 1000 | 0 | Changes in demand greater than this value will mean ramp change delay does not take effect | Mo | 0 | EEPROM=misc.s_curve_speed
 | 290Bh | ---- | ---- | ---- | ---- |  |  | Tilt Alarm Delays |  | N/A | N/A | ---- |  | --- | --- | OBJECT=TILT_ALARM_DELAYS SECTION=TractionConfig MASTER=TRUE CATEGORY=CONFIGURATION
 |  | 0 | 1 | RO | N/A |  |  | Number of parameters | Unsigned8 | 0 | FFh | 2 |  | No | 0
 |  | 1 | 1 | RW | 4 | 0.1 | Seconds | Off delay | Unsigned16 | 0 | FFFFh | 0 | Time tilt signal needs to be inactive before tilt alarm output is deactivated. | No | 0
 |  | 2 | 1 | RW | 4 | 0.1 | Seconds | On delay | Unsigned16 | 0 | FFFFh | 0 | Time tilt signal needs to be active before tilt alarm output is activated. | No | 0
 | 290Bh | ---- | ---- | ---- | ---- |  |  | Steering Inner Wheel Cutback Control Parameters |  | N/A | N/A | ---- |  | --- | --- | OBJECT=STEERING_CUTBACK_CONTROL SECTION=TractionConfig MASTER=TRUE CATEGORY=CONFIGURATION
 |  | 0 | 2 | RO | N/A |  |  | Number of parameters | Unsigned8 | 0 | FFh | 2 |  | No | 0
 |  | 1 | 2 | RW | 2 |  |  | Kp for inner wheel cutback control | Unsigned8 | 0 | FFh | 0 | Enter Kp to control how inner wheel speed demand decreases as outer wheel overspeeds | No | 0 | EEPROM=misc.drive_torque_cutback_kp
 |  | 2 | 2 | RW | 2 |  |  | Ki for inner wheel cutback control | Unsigned8 | 0 | FFh | 0 | Enter Ki to control how inner wheel speed demand decreases as outer wheel overspeeds | No | 0 | EEPROM=misc.drive_torque_cutback_ki
 | 290Ch | ---- | ---- | ---- | ---- |  |  | Belly operation configuration |  |  |  |  |  |  | ---- | OBJECT=BELLY_CONFIGURATION SECTION=TractionConfig MASTER=TRUE CATEGORY=CONFIGURATION
 |  | 0 | 1 | RO | N/A |  |  | Number of parameters | Unsigned8 | N/A | N/A | 3 |  | No | 0
 |  | 1 | 1 | RW | 4 | 3.051850948e-05 |  | Belly throttle value | Unsigned16 | 0 | 32767 | 16384 | Amount of throttle push applied during belly operation | No | 0 | EEPROM=misc.belly_throttle
 |  | 2 | 1 | RW | 4 | 1 | RPM | Belly max speed | Unsigned16 | 0 | 5000 | 1000 | Speed limit in belly operation | No | 0 | EEPROM=misc.belly_max_speed
 |  | 3 | 1 | RW | 4 | 0.1 | Seconds | Belly timeout | Unsigned8 | 0 | 100 | 50 | Belly operation timeout value | No | 0 | EEPROM=misc.belly_timeout
 | 290Dh | 0 | 1 | RW | 2 | 0.001 | Seconds | Neutral Braking Exit Timer | Unsigned16 | 0 | FFFFh | 0 | Debounce delay for neutral braking exit. Neutral braking will only exit when vehicle has been stopped for this time. | No | 0 | OBJECT=NTRL_BRK_EXIT_DELAY EEPROM=misc.ntrl_brk_exit_delay SECTION=TractionConfig MASTER=TRUE CATEGORY=CONFIGURATION
 | 290Eh | ---- | ---- | ---- | ---- |  |  | Brake Feathering |  | N/A | N/A | ---- |  | --- | --- | OBJECT=BRAKE_FEATHERING SECTION=TractionConfig MASTER=TRUE CATEGORY=CONFIGURATION
 |  | 0 | 1 | RO | N/A |  |  | Number of parameters | Unsigned8 | 0 | FFh | 2 |  | No | 0
 |  | 1 | 1 | RW | 4 | 1 | RPM | Brake feathering start speed | Integer16 | 0 | FFFFh | 300 | Speed at which braking torque starts to back off when vehicle is slowing to a stop | No | 0
 |  | 2 | 1 | RW | 4 | 1 | RPM | Brake feathering end speed | Integer16 | 0 | FFFFh | 50 | Speed at which braking torque is completely removed when vehicle is slowing to a stop | No | 0
 |  | 3 | 1 | RW | 4 | 0.001 |  | Brake feathering end torque | Integer16 | 0 | 1000 | 0 | Torque applied in neutral braking below brake feather end speed | No | 0
 | 290Fh | ---- | ---- | ---- | ---- |  |  | Service Brake Control Parameters |  | N/A | N/A | ---- |  | --- | --- | OBJECT=SERVICE_BRAKE SECTION=TractionConfig MASTER=TRUE CATEGORY=CONFIGURATION
 |  | 0 | 1 | RO | N/A |  |  | Number of parameters | Unsigned8 | 0 | FFh | 2 |  | No | 0
 |  | 1 | 1 | RW | 4 | 1 | RPM | Brake On Speed | Integer16 | 0 | FFFFh | 300 | Speed over which service brake is applied | No | 0
 |  | 2 | 1 | RW | 4 | 1 | RPM | Brake Off Speed | Integer16 | 0 | FFFFh | 50 | Speed below which service brake is released | No | 0
 | 2910h | ---- | ---- | ---- | ---- |  |  | Throttle parameters | Record | N/A | N/A | ---- | Parameters to configure Throttle Input. | ---- | ---- | OBJECT=THROTTLE_PARAM SECTION=TractionAIConfig MASTER=TRUE CATEGORY=CONFIGURATION
 |  | 0 | 1 | RO | N/A |  |  | Number of parameters | Unsigned8 | 0 | FFh | 16 |  | No | 0
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
