zachleedogg/E_Moto/CAD/Charger/j1772_vehicle_connector_asm.stp

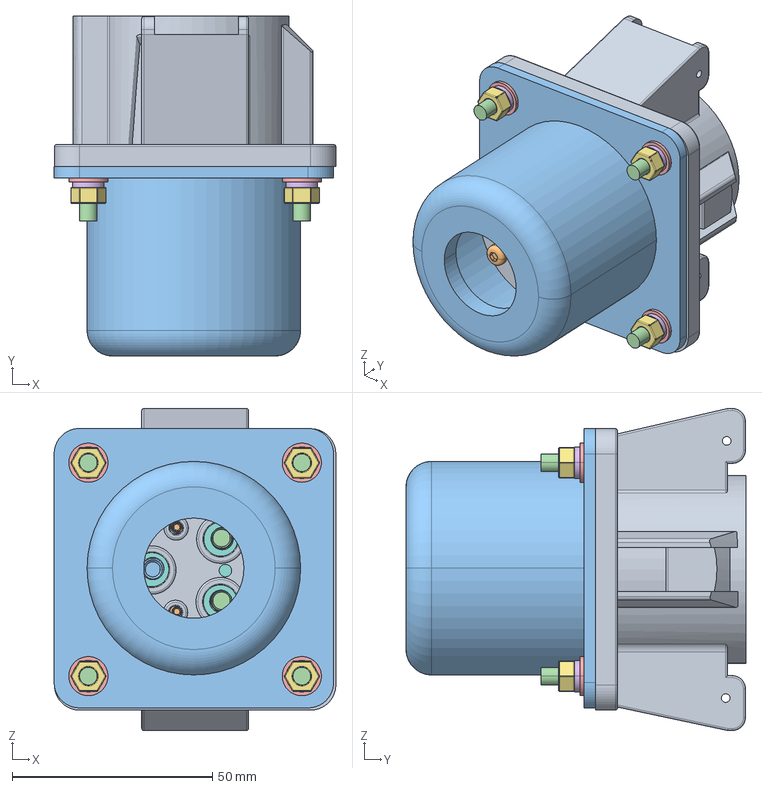
[picture p14: CAD file, 2020-04-24]
CAD/Charger/j1772_vehicle_connector_asm.stp
70.4 x 85.0 x 80.5 mm
J1772_CONNECTOR_HOUSING
J1772_CONNECTOR_SIGNAL_PIN x 2
J1772_NEUTRAL_PWR_PIN
J1772_PWR_PIN_LINE x 2
J1772_CONNECTOR_GASKET
J1772_CONNECTOR_WIRE_GUIDE
J1772_CONNECTOR_RETAINER_SCREW
J1772_CONNECTOR_INSULATOR
J1772_CONNECTOR_PIN_HOUSING_CAP
J1772_CONNECTOR_COVER_SCREW x 3
J1772_CONNECTOR_CABLE_COVER
J1772_CONNECTOR_HOUSING_BOLT x 4
J1772_CONNECTOR_WASHER x 4
J1772_CONNECTOR_LOCKWASHER x 4
J1772_CONNECTOR_NUT x 4
