zachleedogg/E_Moto/CAD/Motor/MotorMountAssy.SLDASM

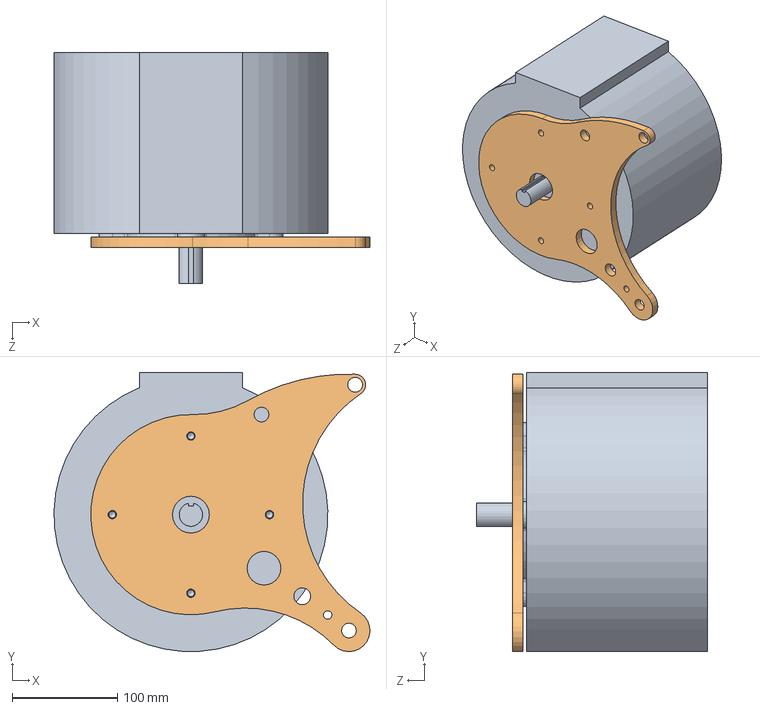
[picture p15: CAD file, 2020-05-17]
CAD/Motor/MotorMountAssy.SLDASM
299.9 x 265.0 x 219.3 mm
ME1616
MotorMount
