zachleedogg/E_Moto/CAD/Battery/Battery 3.0/CAD/Enclosure.SLDASM

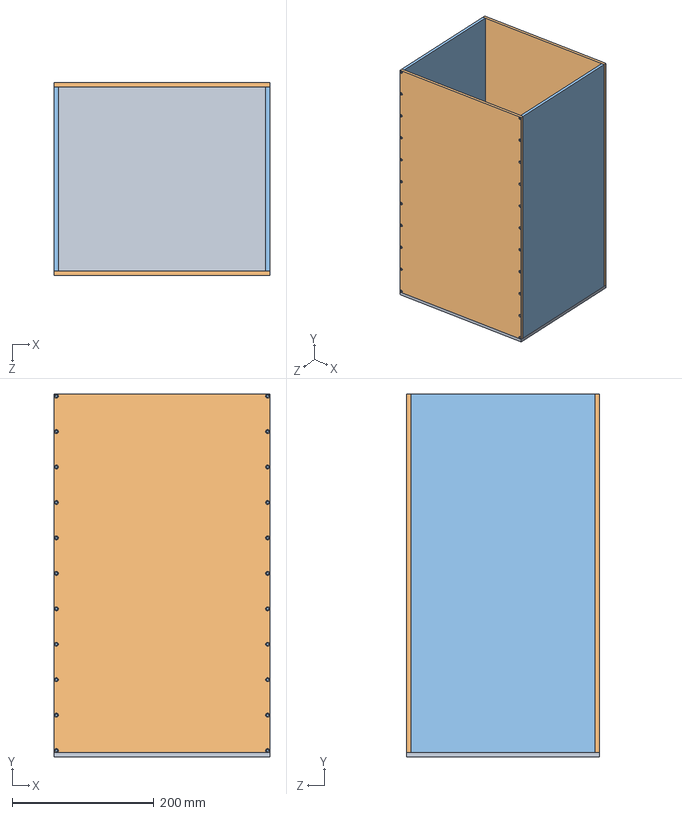
[picture p16: CAD file, 2022-04-16]
CAD/Battery/Battery 3.0/CAD/Enclosure.SLDASM
304.0 x 512.0 x 272.0 mm
Bottom_tray
Front-Back x 2
side-side x 2
