zachleedogg/E_Moto/CAD/Battery/Battery CAD/Enclosure_assy.SLDASM

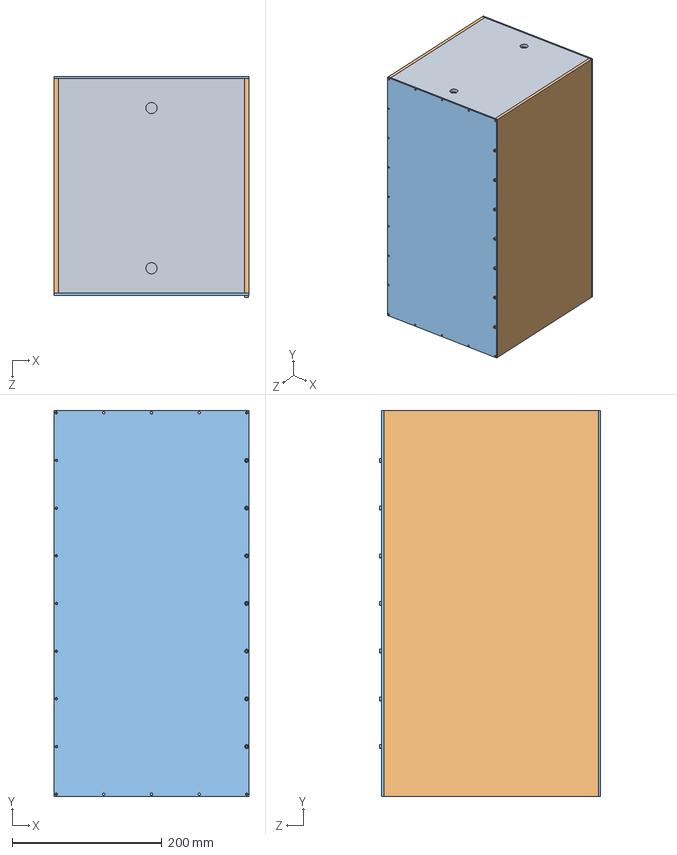
[picture p17: CAD file, 2020-05-06]
CAD/Battery/Battery CAD/Enclosure_assy.SLDASM
260.0 x 515.0 x 295.0 mm
Enclosure_Bottom x 2
Enclosure_Front_Rear x 2
Enclosure_Side x 2
socket head cap screw_am x 7
