zachleedogg/E_Moto/CAD/Frame/Electric Daytona - rough battery placement/Battery Fit.SLDASM

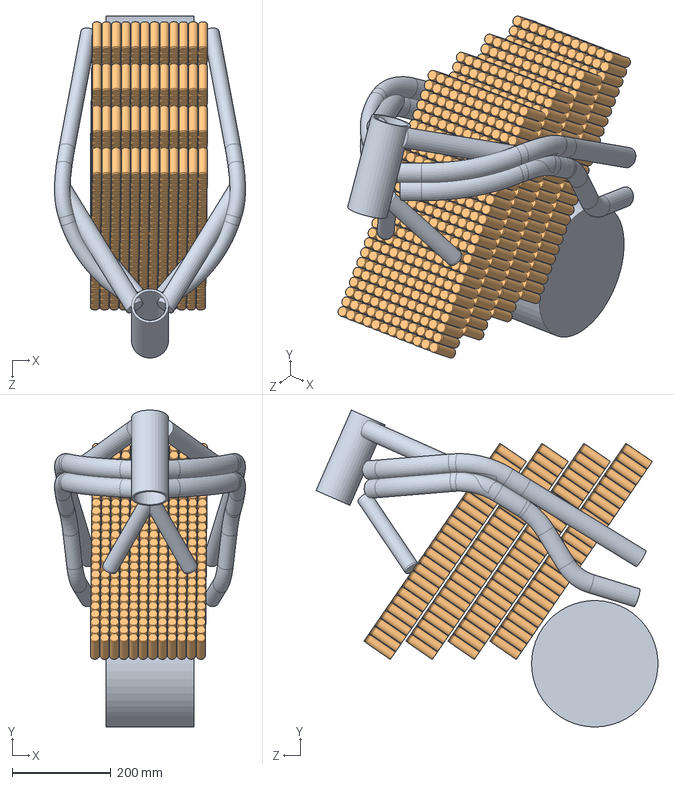
[picture p18: CAD file, 2020-02-11]
CAD/Frame/Electric Daytona - rough battery placement/Battery Fit.SLDASM
386.7 x 641.5 x 692.4 mm
Frame Reference
18650 NN x 1200
