zachleedogg/E_Moto/CAD/Battery/Battery CAD/Battery_Pack_Assy.SLDASM

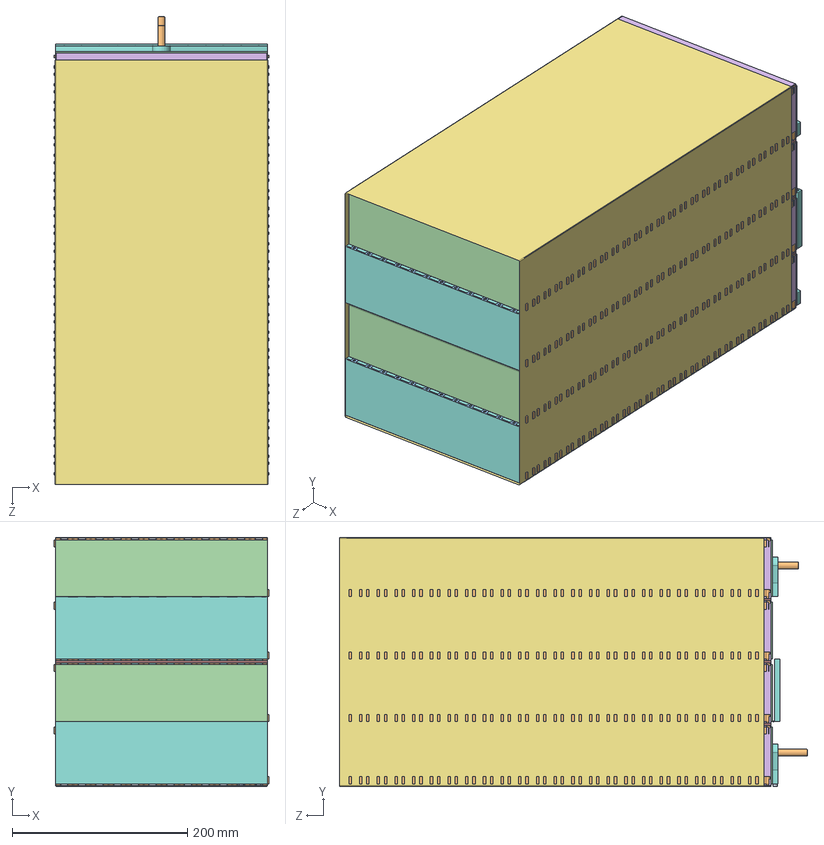
[picture p19: CAD file, 2020-05-06]
CAD/Battery/Battery CAD/Battery_Pack_Assy.SLDASM
245.2 x 284.8 x 534.5 mm
1P Holder x 2304
Connection_Grid x 28
Module_Bottom_Insulator x 8
Module_to_Module_Insulator x 11
Module_Shrink_Wrap x 4
Pack_Shrink_Wrap
Module_to_Module_BusBar x 5
socket head cap screw_am x 2
continous stud_am x 2
