zachleedogg/E_Moto/CAD/Connectors/ConnectorsTogether.SLDASM

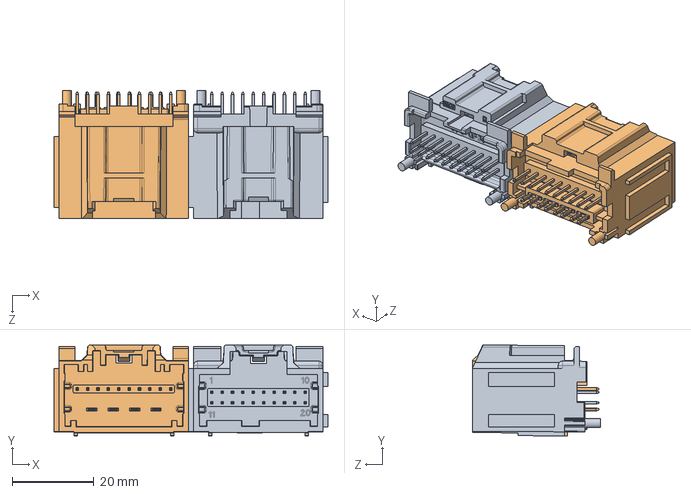
[picture p20: CAD file, 2017-12-21]
CAD/Connectors/ConnectorsTogether.SLDASM
67.0 x 22.2 x 31.4 mm
