zachleedogg/E_Moto/CAD/Frame/Electric Daytona - rough battery placement/25x2.SLDASM

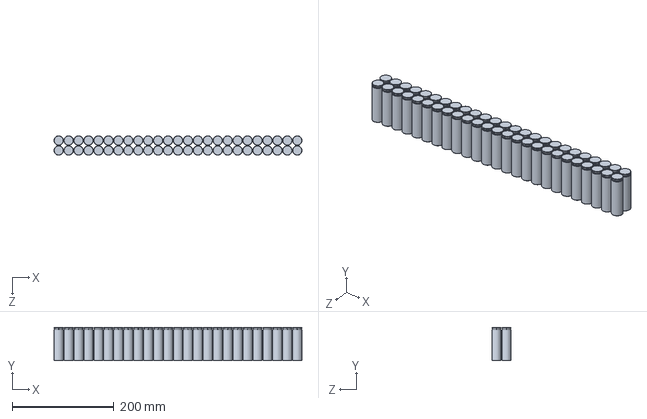
[picture p21: CAD file, 2020-02-11]
CAD/Frame/Electric Daytona - rough battery placement/25x2.SLDASM
486.5 x 65.2 x 38.0 mm
18650 NN x 50
