zachleedogg/E_Moto/CAD/Battery/Welder/welder_assy.SLDASM

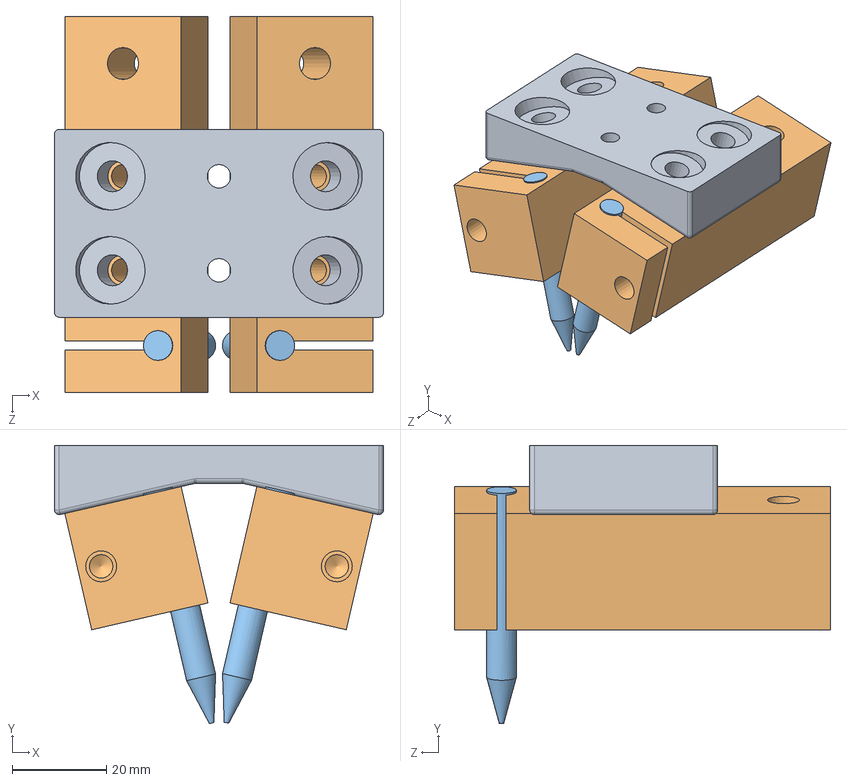
[picture p22: CAD file, 2019-07-03]
CAD/Battery/Welder/welder_assy.SLDASM
70.0 x 59.2 x 80.0 mm
Block_Holder
Bus_Block x 2
Carbide_Electrode x 2
