zachleedogg/E_Moto/CAD/BodyController/PCBA.SLDASM

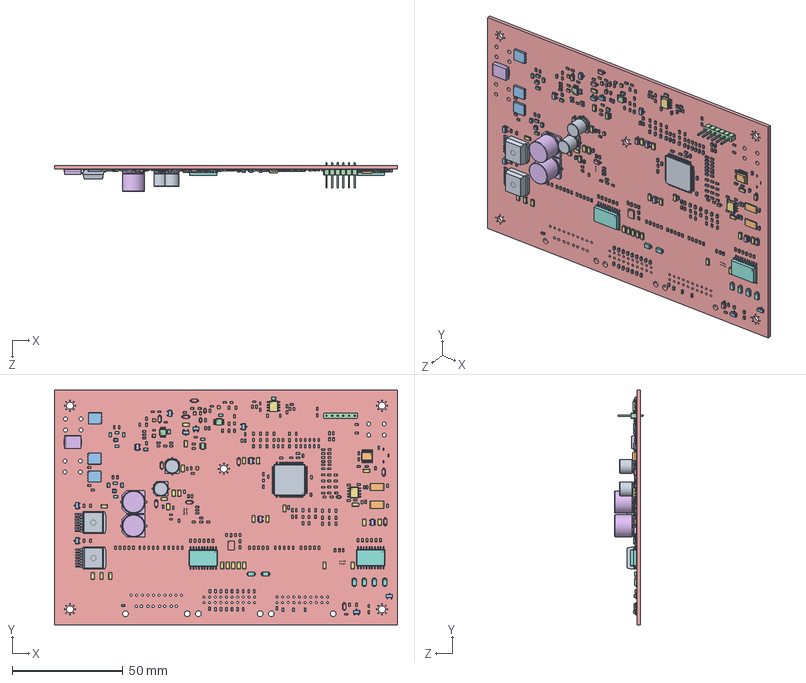
[picture p23: CAD file, 2019-07-03]
CAD/BodyController/PCBA.SLDASM
155.0 x 106.0 x 13.0 mm
