zachleedogg/E_Moto/CAD/Battery/Battery 3.0/CAD/6P_Cell_Pack.SLDASM

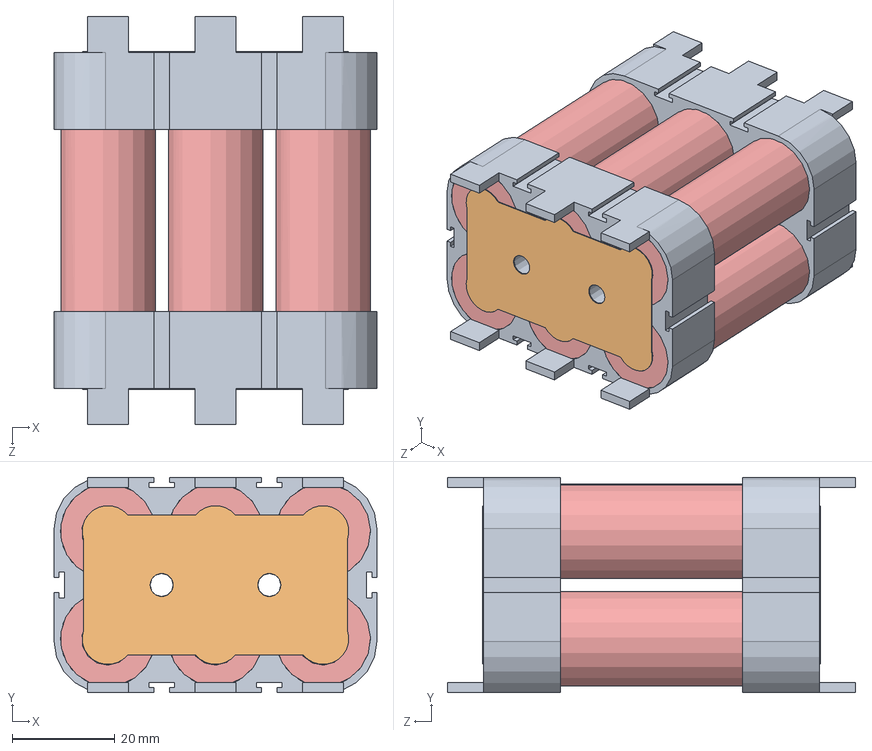
[picture p24: CAD file, 2021-01-03]
CAD/Battery/Battery 3.0/CAD/6P_Cell_Pack.SLDASM
63.0 x 42.0 x 79.6 mm
Cell_Holder_6P x 2
Contact_Plate x 2
Insulator_donut x 6
18650_Shrinkwarp x 6
