zachleedogg/E_Moto/CAD/Battery/Welder/WelderArmAssy.SLDASM

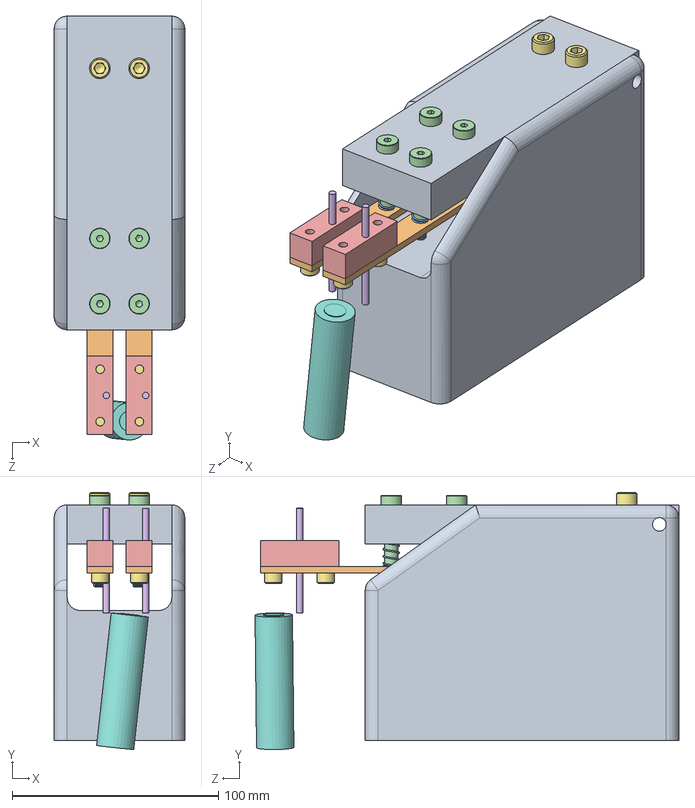
[picture p25: CAD file, 2019-07-03]
CAD/Battery/Welder/WelderArmAssy.SLDASM
63.5 x 124.8 x 205.8 mm
WelderArm
copperBusBar x 2
9657K303_STEEL COMPRESSION SPRING x 4
socket head shoulder screw2_am x 4
Mini_Bus_Block x 2
CopperElectrode x 2
socket head cap screw_am x 6
stand
