zachleedogg/E_Moto/CAD/Battery/Battery 3.0/CAD/6S48P.SLDASM

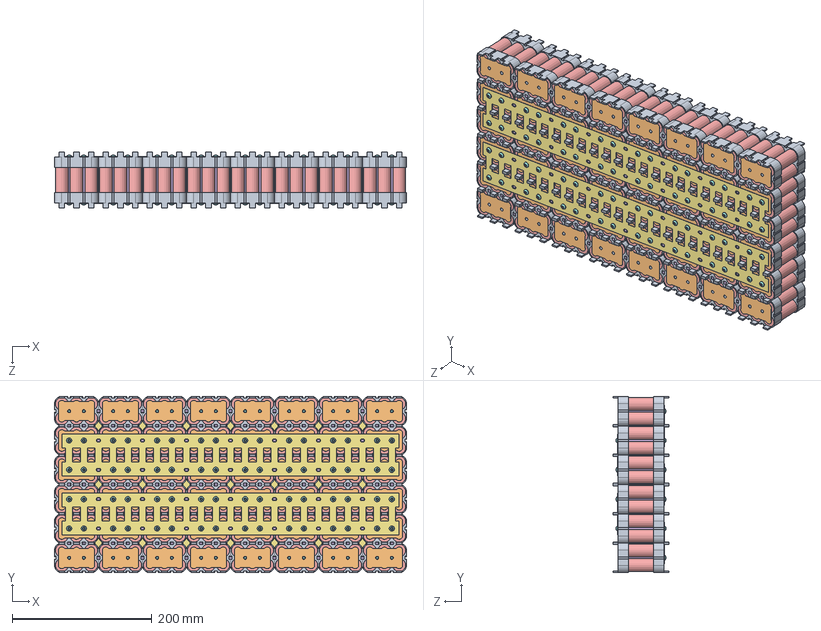
[picture p26: CAD file, 2021-01-03]
CAD/Battery/Battery 3.0/CAD/6S48P.SLDASM
504.0 x 252.0 x 79.6 mm
Cell_Holder_6P x 96
Contact_Plate x 96
Insulator_donut x 288
18650_Shrinkwarp x 288
Cell_Holder_connector x 122
Copper_Bus_Strip x 5
socket button head cap screw_am x 160
