zachleedogg/E_Moto/CAD/Battery/Battery 3.0/CAD/1S24P_Brick.SLDASM

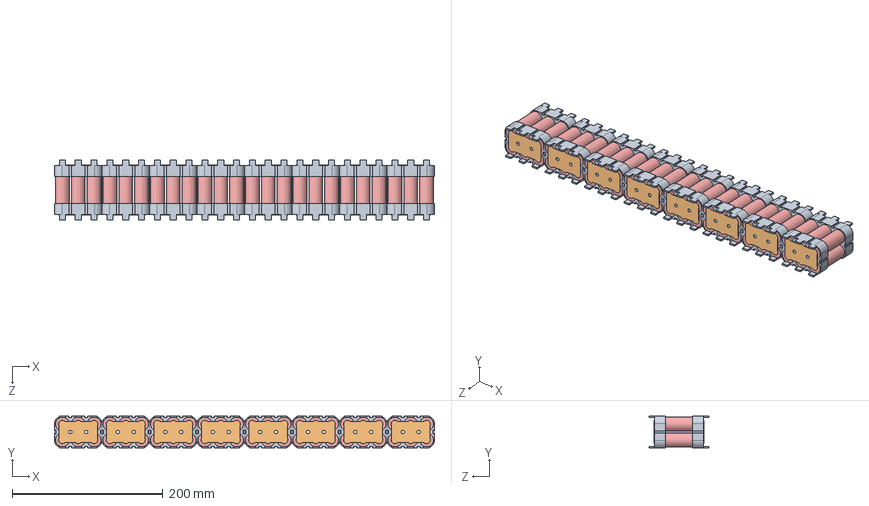
[picture p27: CAD file, 2021-01-03]
CAD/Battery/Battery 3.0/CAD/1S24P_Brick.SLDASM
504.0 x 42.0 x 79.6 mm
Cell_Holder_6P x 16
Contact_Plate x 16
Insulator_donut x 48
18650_Shrinkwarp x 48
Cell_Holder_connector x 7
