zachleedogg/E_Moto/CAD/Battery/Battery 3.0/CAD/24S48P.SLDASM

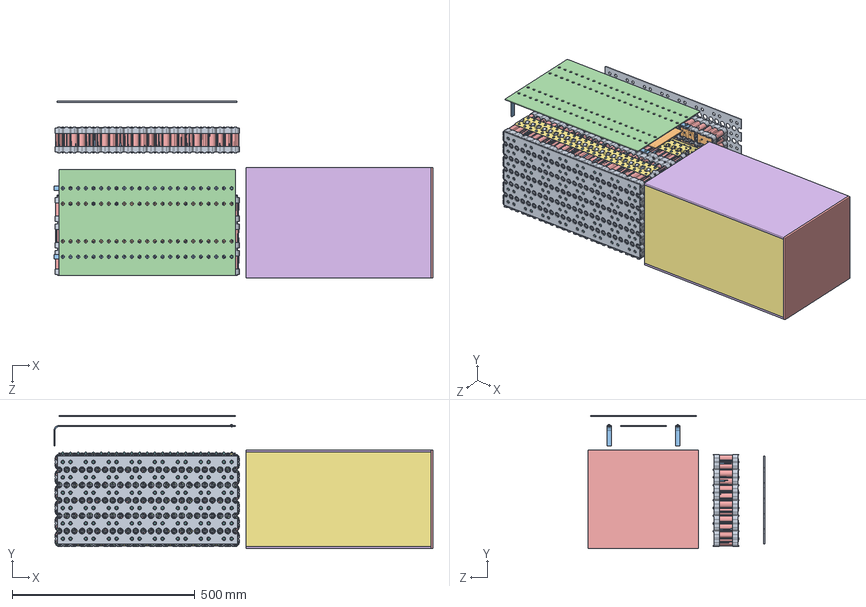
[picture p28: CAD file, 2021-01-03]
CAD/Battery/Battery 3.0/CAD/24S48P.SLDASM
1037.5 x 364.6 x 483.2 mm
Cell_Holder_6P x 384
Contact_Plate x 384
Insulator_donut x 1152
18650_Shrinkwarp x 1152
Cell_Holder_connector x 488
Copper_Bus_Strip x 26
socket button head cap screw_am x 764
12X48_Pack_Insulator x 5
Center_conductor
Terminal_conductor x 2
Main_Insulator
Bottom_tray
Front-Back x 2
side-side x 2
