zachleedogg/E_Moto/CAD/Battery/Battery 3.0/CAD/Main_Insulator.SLDPRT

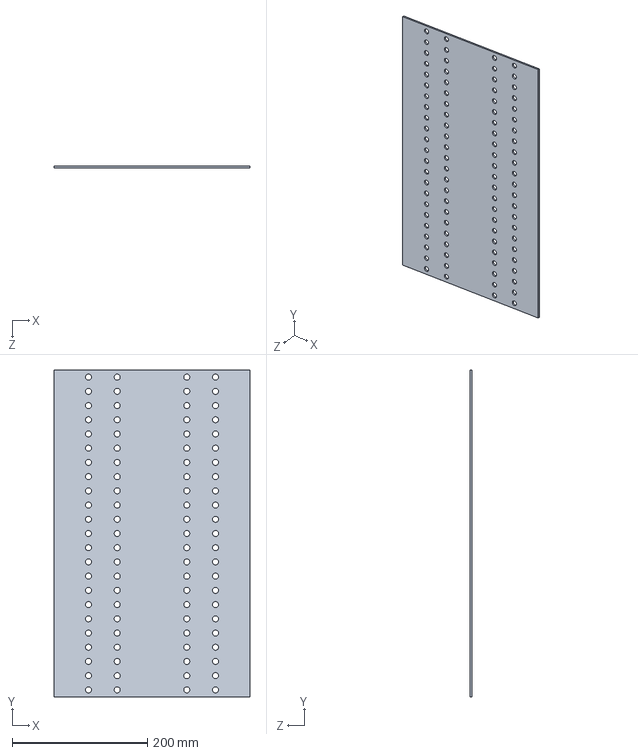
[picture p29: CAD file, 2021-01-03]
CAD/Battery/Battery 3.0/CAD/Main_Insulator.SLDPRT
289.4 x 483.0 x 3.00 mm
