zachleedogg/E_Moto/CAD/Battery/Battery CAD/Battery_Module_12x24.SLDASM

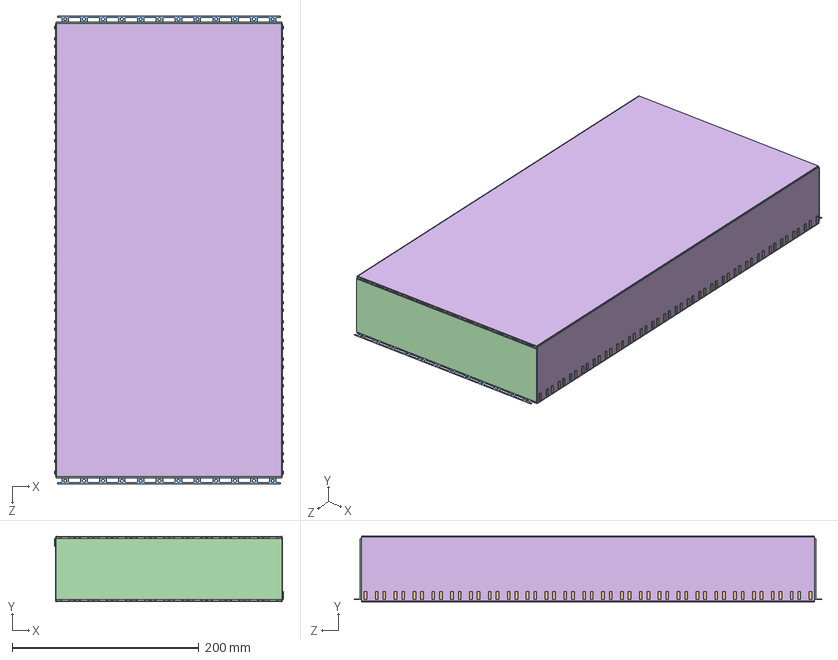
[picture p30: CAD file, 2020-03-23]
CAD/Battery/Battery CAD/Battery_Module_12x24.SLDASM
245.2 x 70.5 x 501.0 mm
1P Holder x 576
Connection_Grid x 7
Module_Bottom_Insulator x 2
Module_to_Module_Insulator x 2
Module_Shrink_Wrap
