zachleedogg/E_Moto/CAD/Battery/Battery CAD/2Banger18650Holder.SLDASM

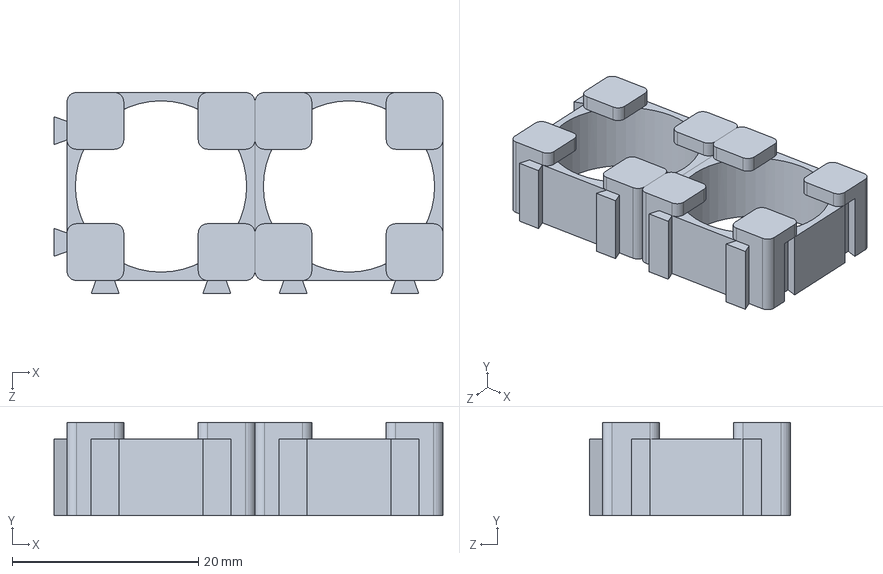
[picture p31: CAD file, 2020-02-11]
CAD/Battery/Battery CAD/2Banger18650Holder.SLDASM
41.8 x 10.0 x 21.6 mm
1P Holder x 2
