zachleedogg/E_Moto/CAD/BodyController/BodyController_Shell/BodyControllerAssy_V2.SLDASM

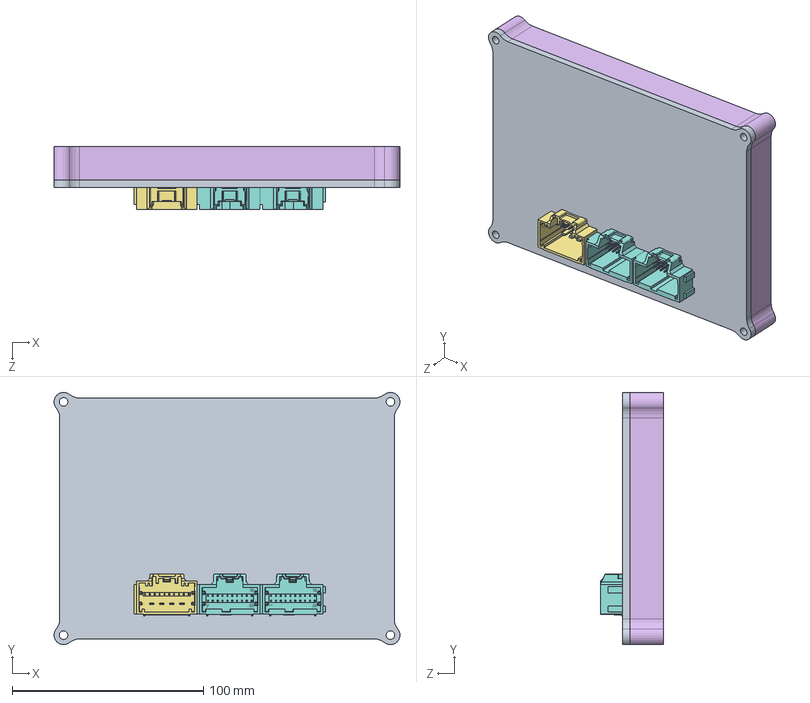
[picture p32: CAD file, 2019-07-03]
CAD/BodyController/BodyController_Shell/BodyControllerAssy_V2.SLDASM
181.0 x 132.0 x 33.2 mm
BottomSheel_V2
Top_Shell_V2
