zachleedogg/E_Moto/CAD/BodyController/BodyController_01.SLDASM

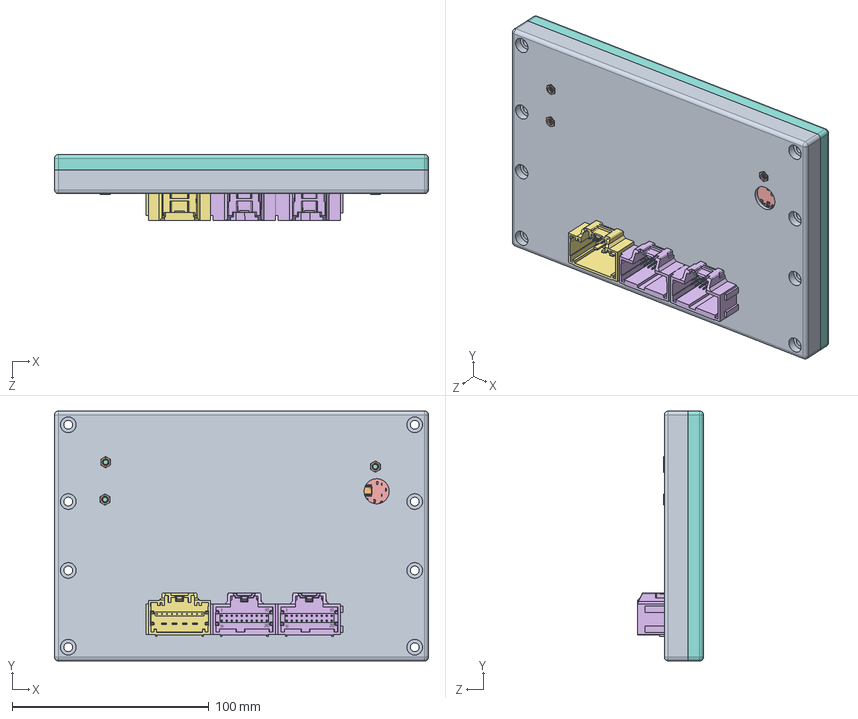
[picture p33: CAD file, 2019-07-03]
CAD/BodyController/BodyController_01.SLDASM
190.0 x 127.0 x 33.7 mm
BottomShell
TopShell
93590A103_18-8 SS HEX CPLG NUT x 3
