zachleedogg/E_Moto/CAD/Battery/Battery 3.0/CAD/Bottom_tray.SLDPRT

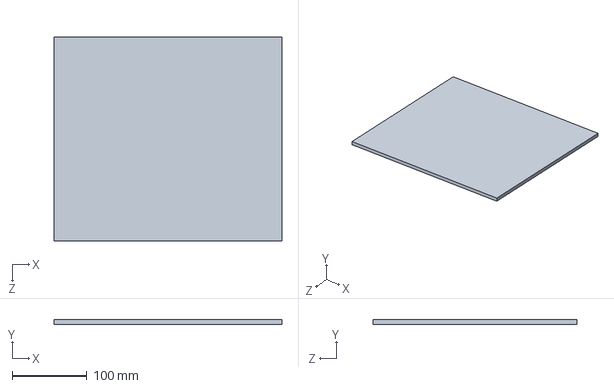
[picture p34: CAD file, 2022-04-16]
CAD/Battery/Battery 3.0/CAD/Bottom_tray.SLDPRT
304.0 x 6.00 x 272.0 mm
