zachleedogg/E_Moto/CAD/Battery/Battery CAD/Aluminum_Enclosure_01.SLDPRT

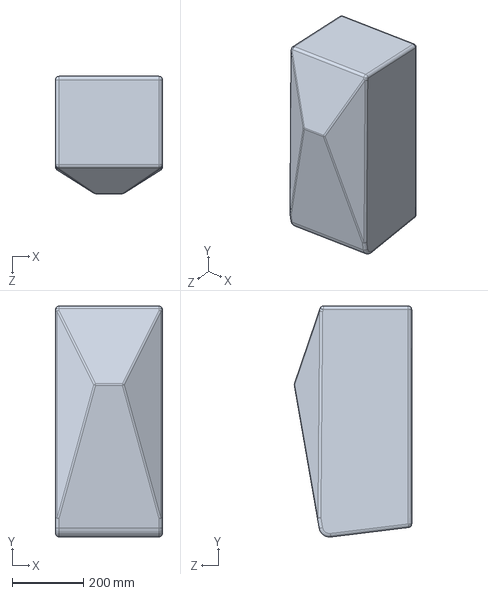
[picture p35: CAD file, 2020-05-06]
CAD/Battery/Battery CAD/Aluminum_Enclosure_01.SLDPRT
300.0 x 647.8 x 329.7 mm
