zachleedogg/E_Moto/CAD/Frame/Trellis_Left.sldprt

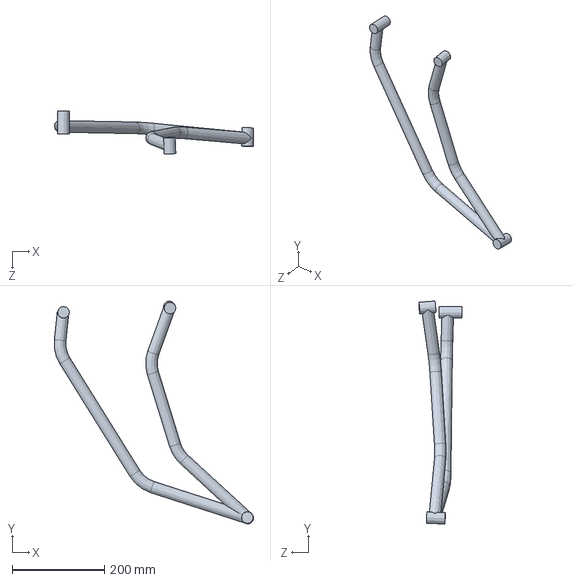
[picture p36: CAD file, 2020-10-11]
CAD/Frame/Trellis_Left.sldprt
432.2 x 483.4 x 94.0 mm
