zachleedogg/E_Moto/CAD/Battery/Welder/copperBusBar.SLDPRT

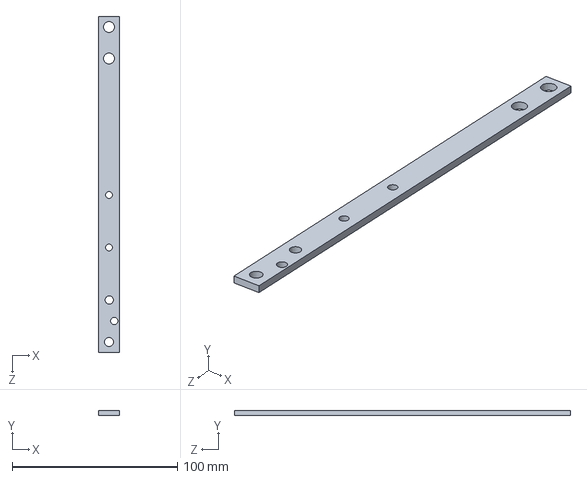
[picture p37: CAD file, 2019-07-03]
CAD/Battery/Welder/copperBusBar.SLDPRT
12.7 x 3.17 x 203.2 mm
