zachleedogg/E_Moto/CAD/Charger/Elcon_3k_charger.SLDPRT

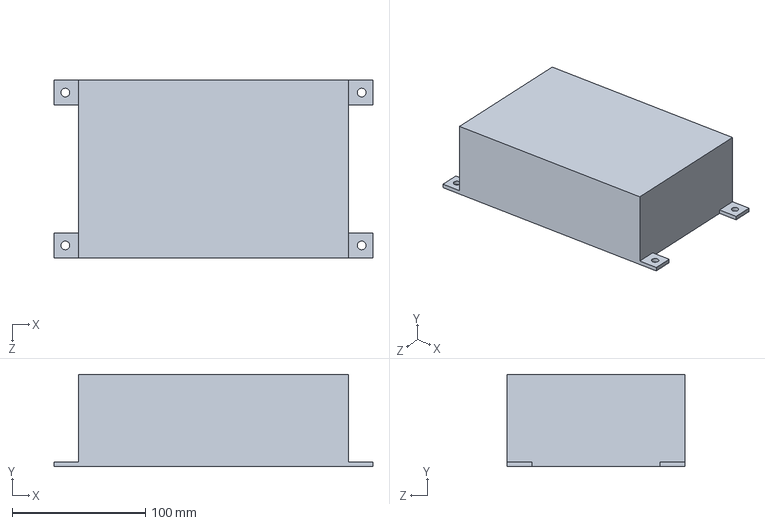
[picture p38: CAD file, 2019-07-03]
CAD/Charger/Elcon_3k_charger.SLDPRT
239.0 x 69.0 x 133.0 mm
