zachleedogg/E_Moto/CAD/Frame/Trellis_Left_02_MID.STL

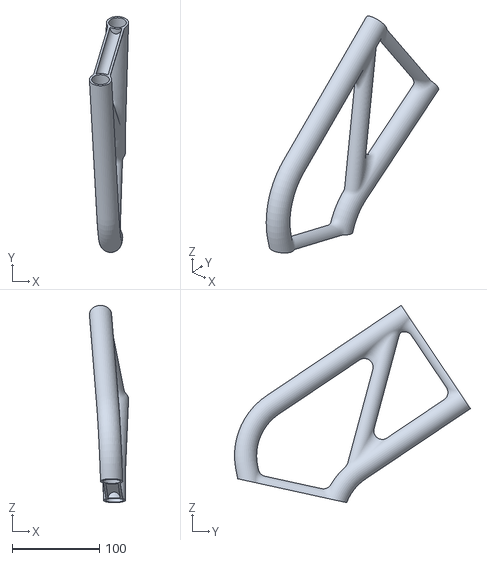
[picture p39: CAD file, 2020-10-11]
CAD/Frame/Trellis_Left_02_MID.STL
44.8 x 270.0 x 225.8
