zachleedogg/E_Moto/CAD/Motor/MotorMount.sldprt

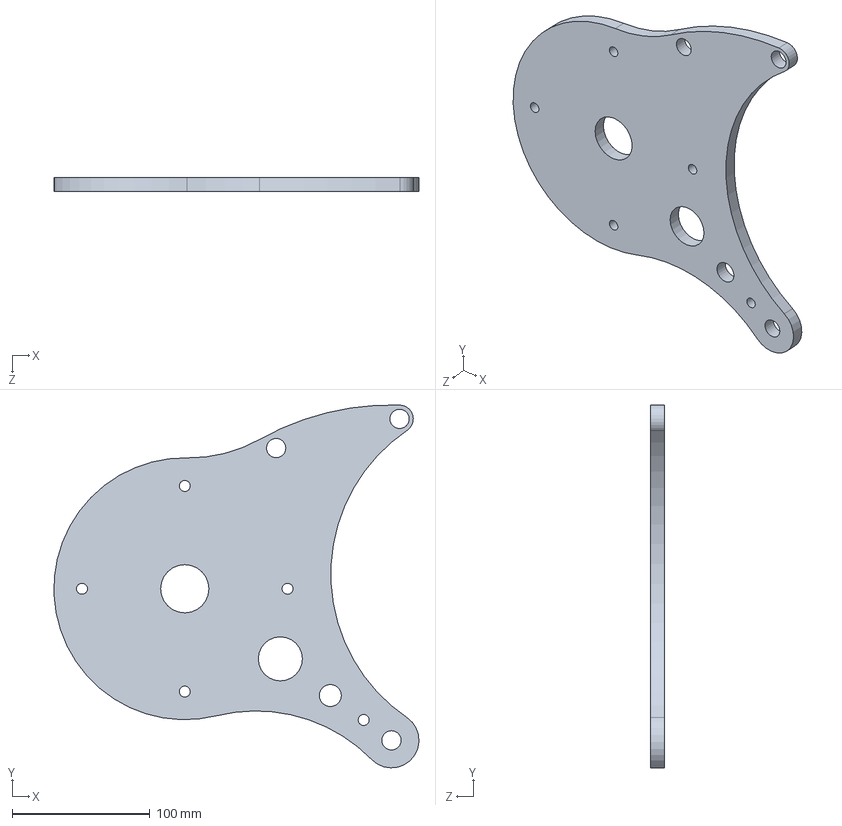
[picture p40: CAD file, 2020-05-17]
CAD/Motor/MotorMount.sldprt
264.9 x 263.3 x 10.0 mm
