zachleedogg/E_Moto/CAD/Battery/Battery 3.0/CAD/Front-Back.SLDPRT

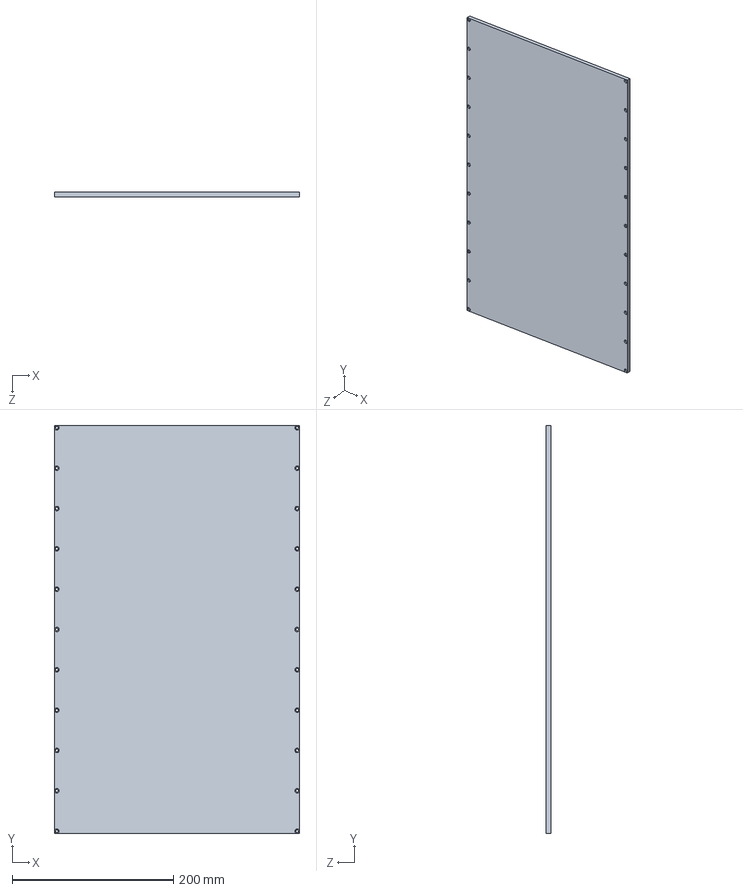
[picture p41: CAD file, 2022-04-16]
CAD/Battery/Battery 3.0/CAD/Front-Back.SLDPRT
304.0 x 506.0 x 6.00 mm
