zachleedogg/E_Moto/CAD/Battery/Welder/CopperElectrode.SLDPRT

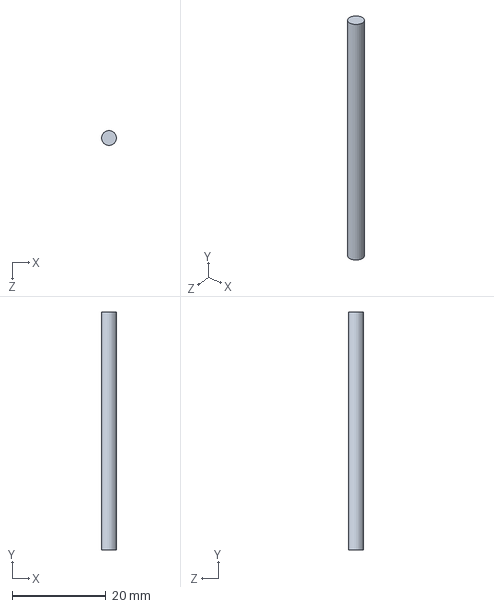
[picture p42: CAD file, 2019-07-03]
CAD/Battery/Welder/CopperElectrode.SLDPRT
3.17 x 50.8 x 3.17 mm
