zachleedogg/E_Moto/CAD/BodyController/BodyController_Shell/BottomShell.SLDPRT

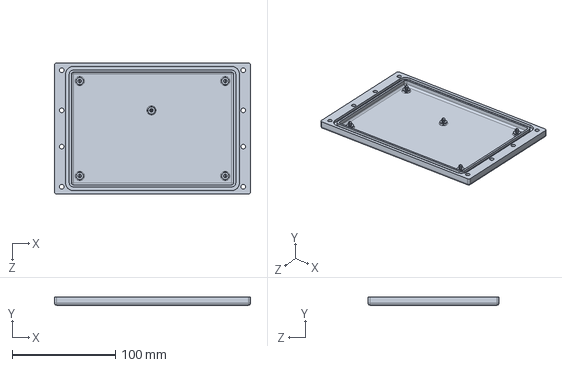
[picture p43: CAD file, 2019-07-03]
CAD/BodyController/BodyController_Shell/BottomShell.SLDPRT
190.0 x 8.26 x 127.0 mm
