zachleedogg/E_Moto/CAD/Frame/Trellis_Left_02.SLDPRT

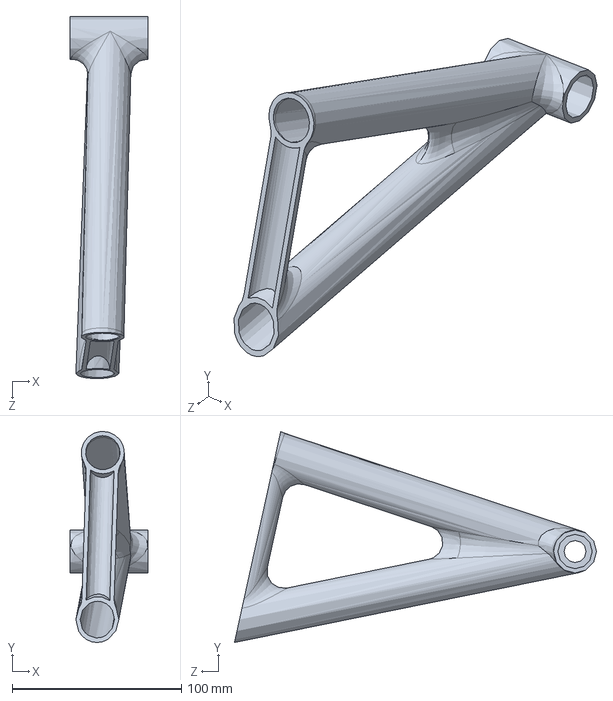
[picture p44: CAD file, 2020-10-11]
CAD/Frame/Trellis_Left_02.SLDPRT
46.0 x 124.8 x 214.1 mm
