zachleedogg/E_Moto/CAD/Motor/ME1616.SLDPRT

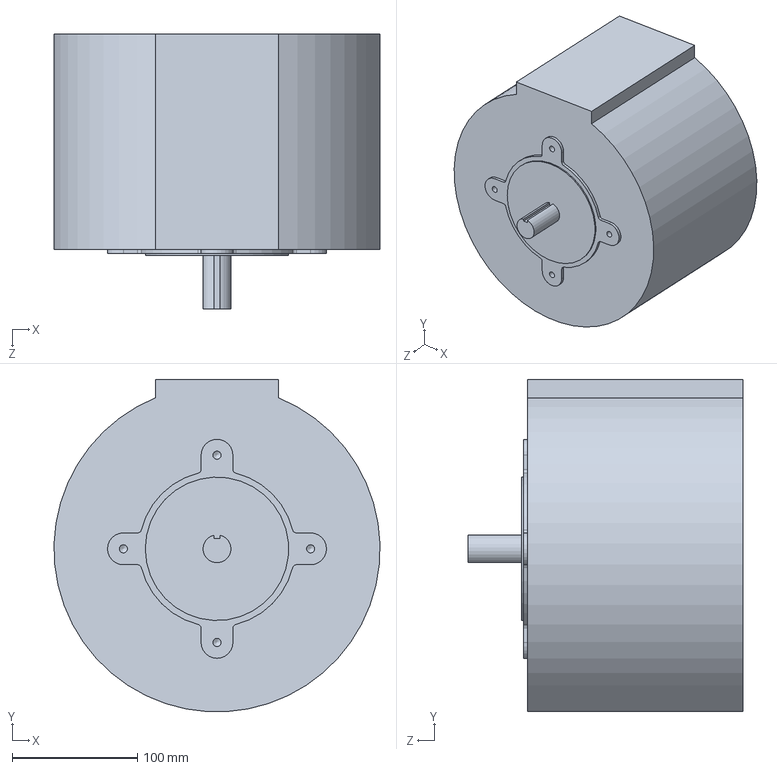
[picture p45: CAD file, 2020-05-17]
CAD/Motor/ME1616.SLDPRT
259.9 x 264.7 x 219.3 mm
