zachleedogg/E_Moto/CAD/Battery/Battery 3.0/CAD/side-side.SLDPRT

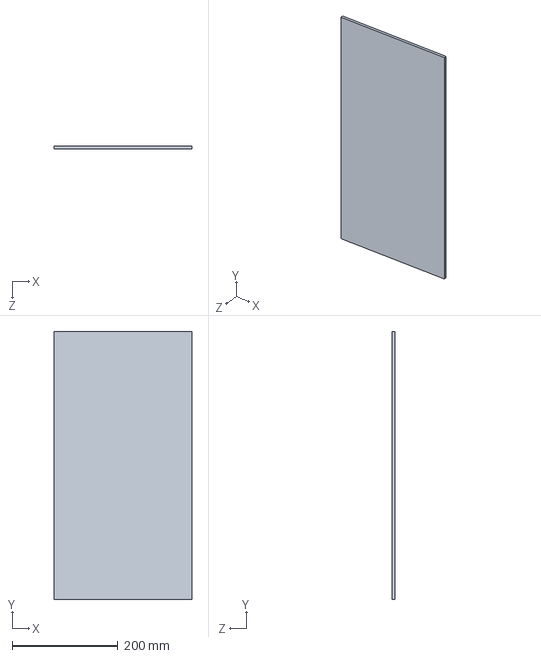
[picture p46: CAD file, 2022-04-16]
CAD/Battery/Battery 3.0/CAD/side-side.SLDPRT
260.0 x 506.0 x 6.00 mm
