zachleedogg/E_Moto/CAD/Battery/Battery CAD/Enclosure_Front_Rear.SLDPRT

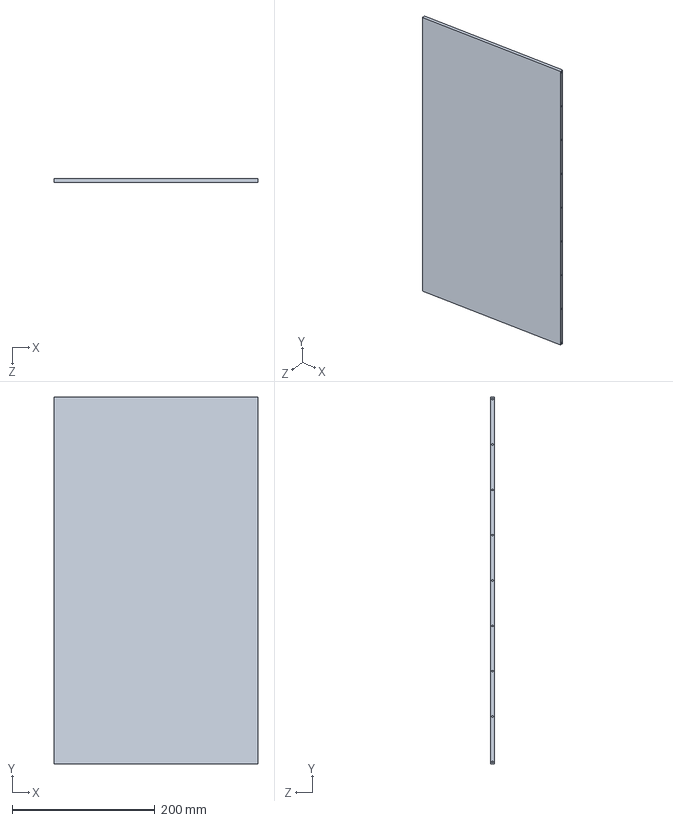
[picture p47: CAD file, 2020-04-24]
CAD/Battery/Battery CAD/Enclosure_Front_Rear.SLDPRT
286.0 x 515.0 x 5.99 mm
