zachleedogg/E_Moto/CAD/Frame/Trellis_Left_02_TOP.STL

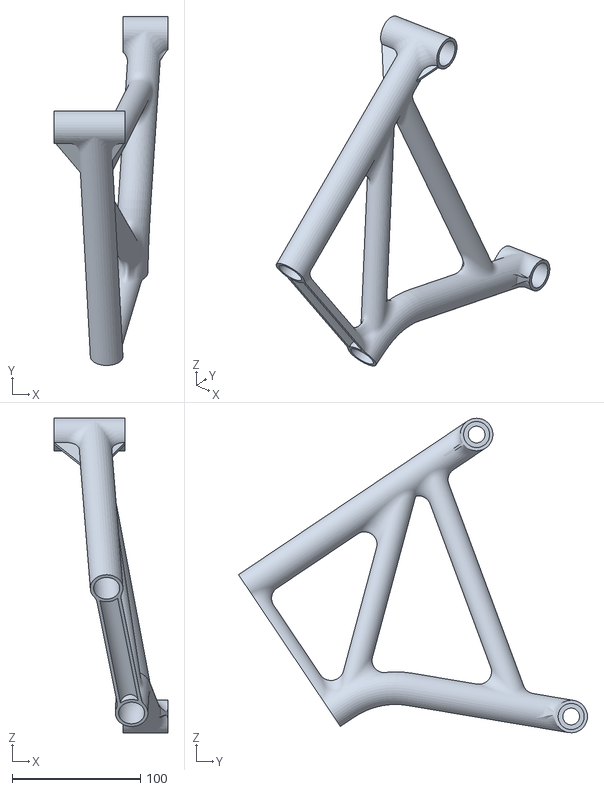
[picture p48: CAD file, 2020-10-11]
CAD/Frame/Trellis_Left_02_TOP.STL
88.5 x 271.7 x 244.9
