zachleedogg/E_Moto/CAD/Battery/Battery 3.0/CAD/Cell_Holder_connector.SLDPRT

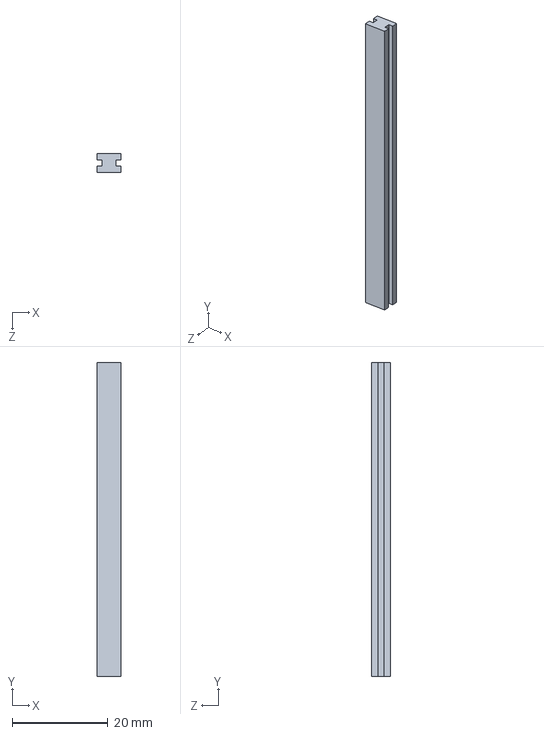
[picture p49: CAD file, 2021-01-03]
CAD/Battery/Battery 3.0/CAD/Cell_Holder_connector.SLDPRT
5.00 x 65.5 x 4.00 mm
