zachleedogg/E_Moto/CAD/Battery/Battery CAD/GV200_step_121715.SLDPRT

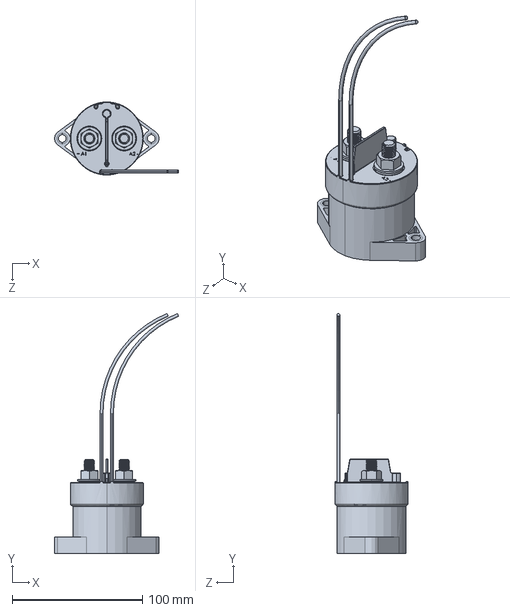
[picture p50: CAD file, 2020-04-24]
CAD/Battery/Battery CAD/GV200_step_121715.SLDPRT
95.4 x 184.2 x 56.0 mm
