zachleedogg/E_Moto/CAD/Battery/Welder/stand.SLDPRT

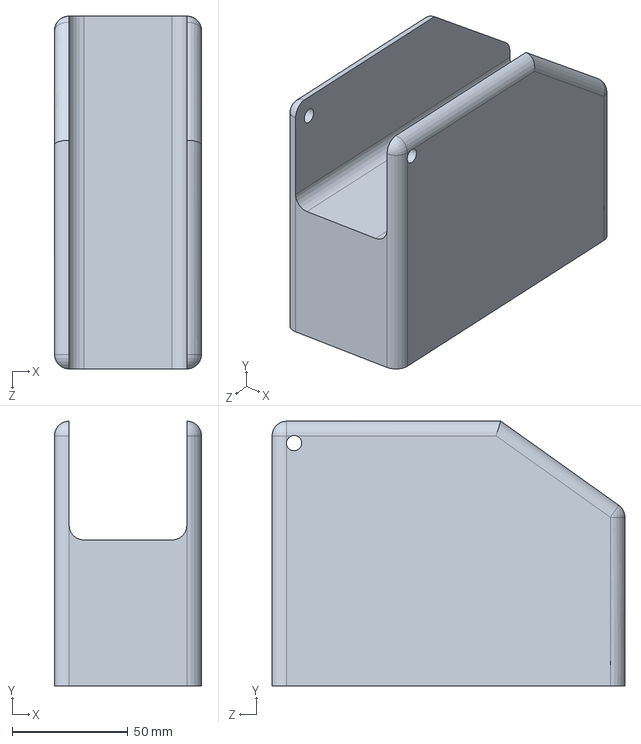
[picture p51: CAD file, 2019-07-03]
CAD/Battery/Welder/stand.SLDPRT
63.5 x 114.3 x 152.3 mm
