zachleedogg/E_Moto/CAD/Battery/Battery CAD/HASS_XXX-P.stp

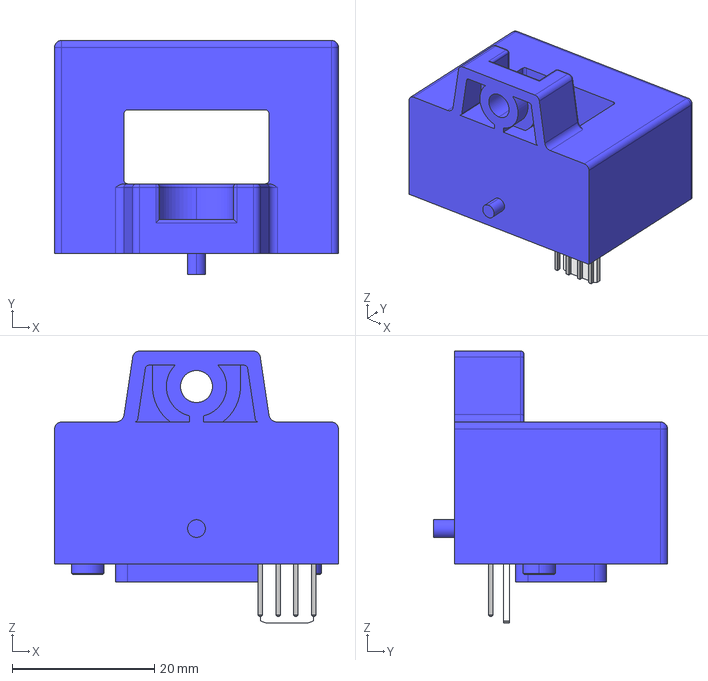
[picture p52: CAD file, 2020-04-24]
CAD/Battery/Battery CAD/HASS_XXX-P.stp
40.0 x 33.0 x 38.3 mm
