zachleedogg/E_Moto/CAD/Battery/Welder/Block_Holder.STEP

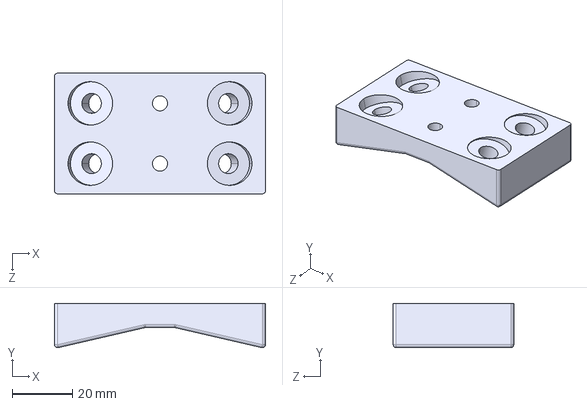
[picture p53: CAD file, 2019-07-03]
CAD/Battery/Welder/Block_Holder.STEP
70.0 x 14.7 x 40.0 mm
