zachleedogg/E_Moto/CAD/Frame/Mounting Points.SLDPRT

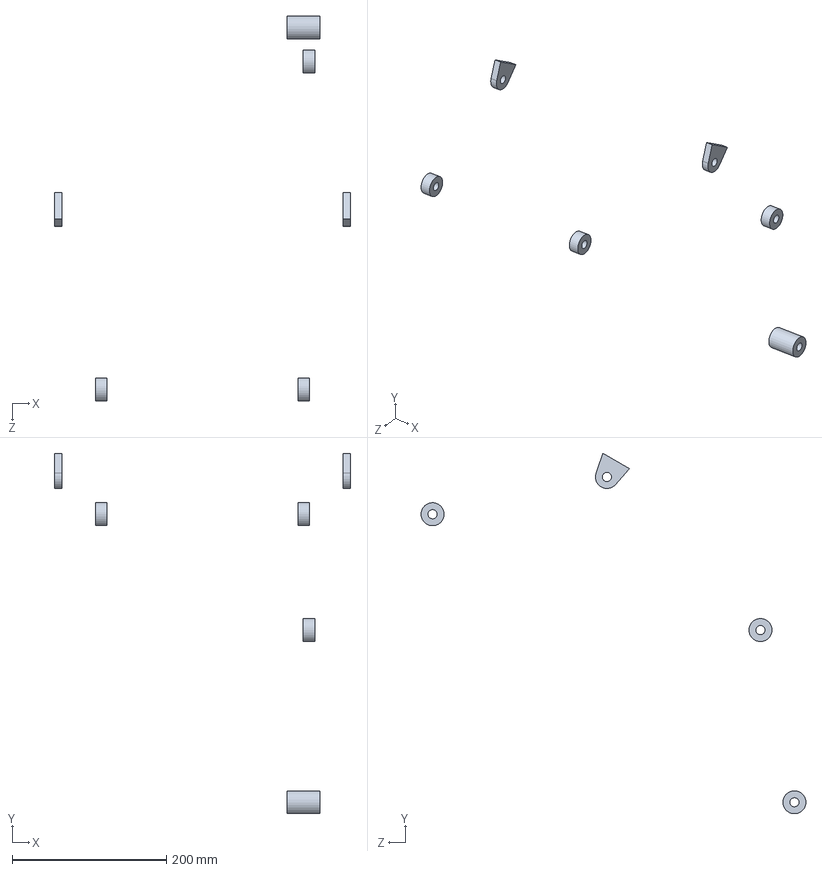
[picture p54: CAD file, 2020-10-11]
CAD/Frame/Mounting Points.SLDPRT
384.5 x 468.0 x 499.8 mm
