zachleedogg/E_Moto/CAD/Battery/Battery 3.0/CAD/Insulator_donut.SLDPRT

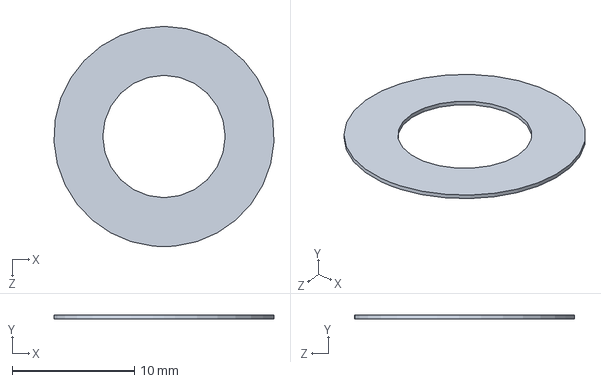
[picture p55: CAD file, 2021-01-03]
CAD/Battery/Battery 3.0/CAD/Insulator_donut.SLDPRT
18.0 x 0.3 x 18.0 mm
