zachleedogg/E_Moto/CAD/Battery/Battery CAD/fusible.SLDPRT

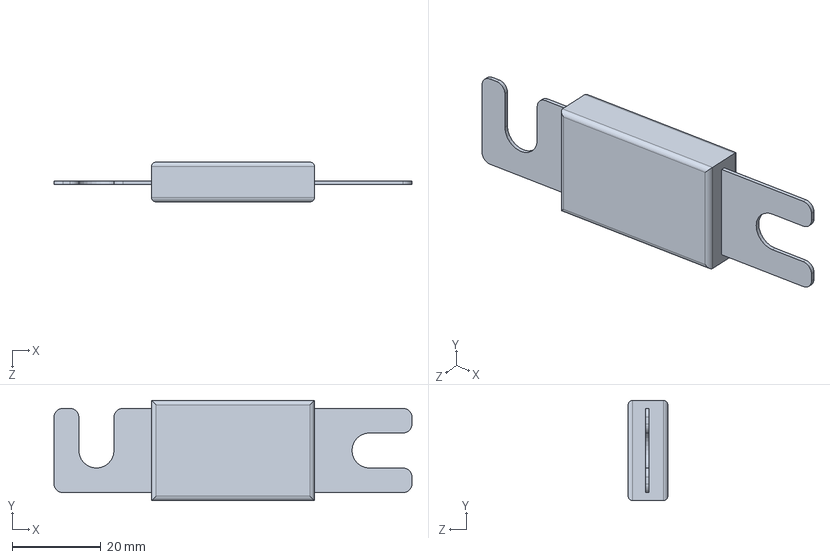
[picture p56: CAD file, 2020-04-24]
CAD/Battery/Battery CAD/fusible.SLDPRT
80.9 x 22.6 x 9.00 mm
