zachleedogg/E_Moto/CAD/Battery/Battery CAD/Busbar_Fuse_to_Contactor.SLDPRT

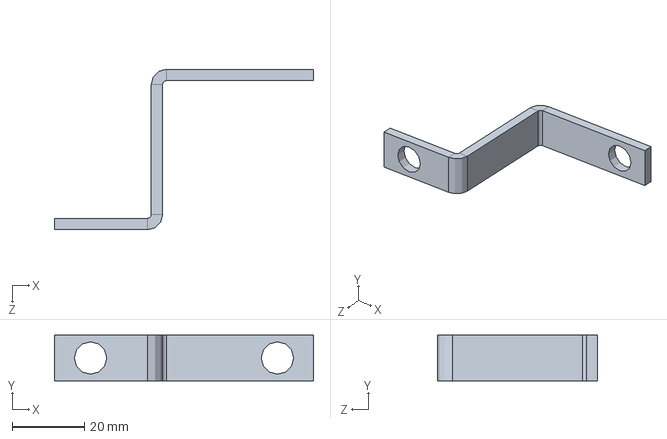
[picture p57: CAD file, 2020-04-24]
CAD/Battery/Battery CAD/Busbar_Fuse_to_Contactor.SLDPRT
71.8 x 12.7 x 44.5 mm
