zachleedogg/E_Moto/CAD/Battery/Welder/Mini_Bus_Block.SLDPRT

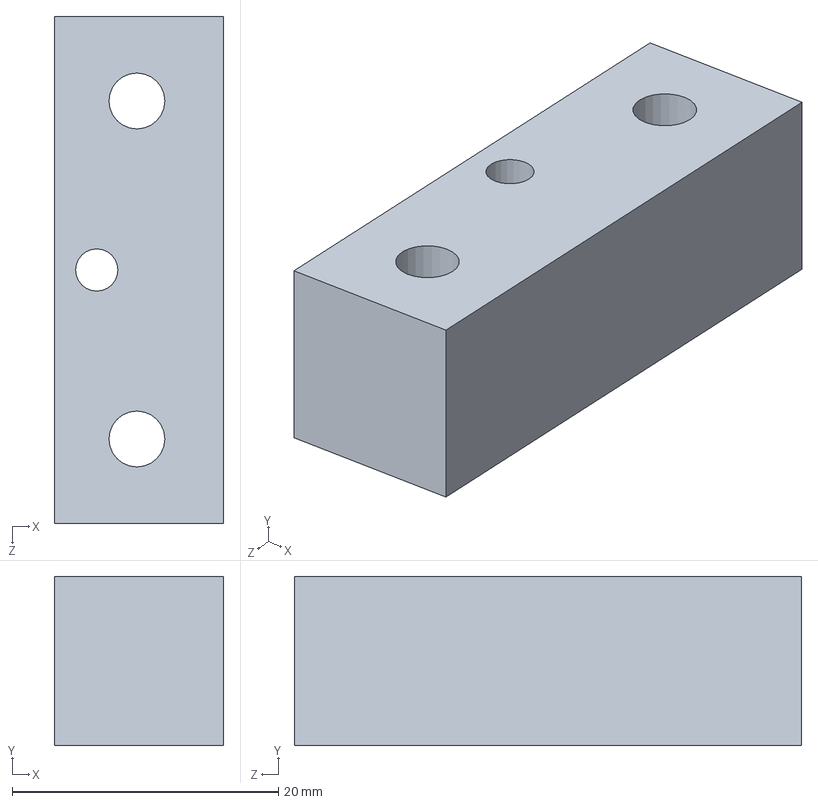
[picture p58: CAD file, 2019-07-03]
CAD/Battery/Welder/Mini_Bus_Block.SLDPRT
12.7 x 12.7 x 38.1 mm
