zachleedogg/E_Moto/CAD/Battery/Battery CAD/HV_Penthouse_Bottom_Plate.SLDPRT

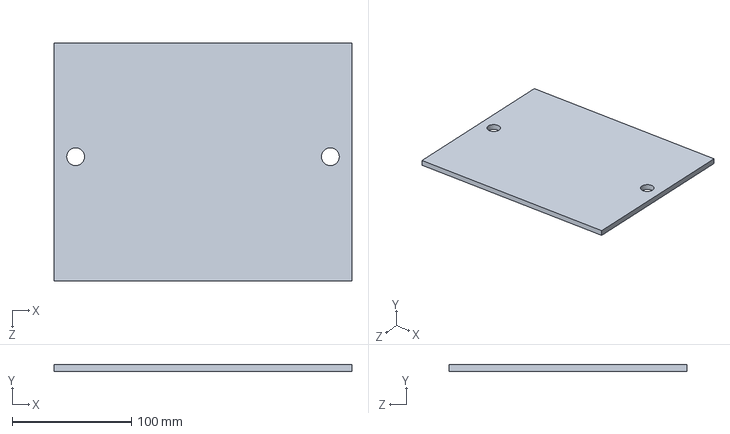
[picture p59: CAD file, 2020-04-24]
CAD/Battery/Battery CAD/HV_Penthouse_Bottom_Plate.SLDPRT
250.0 x 5.99 x 200.0 mm
