zachleedogg/E_Moto/CAD/Battery/Welder/Carbide_Electrode.SLDPRT

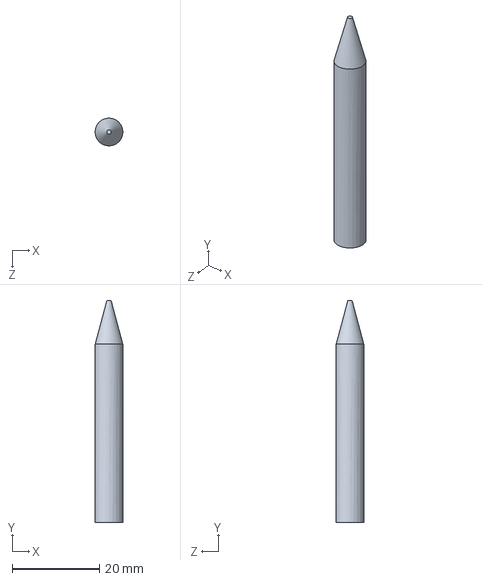
[picture p60: CAD file, 2019-07-03]
CAD/Battery/Welder/Carbide_Electrode.SLDPRT
6.35 x 50.8 x 6.35 mm
