zachleedogg/E_Moto/CAD/Battery/Battery CAD/Fuse_Mount.SLDPRT

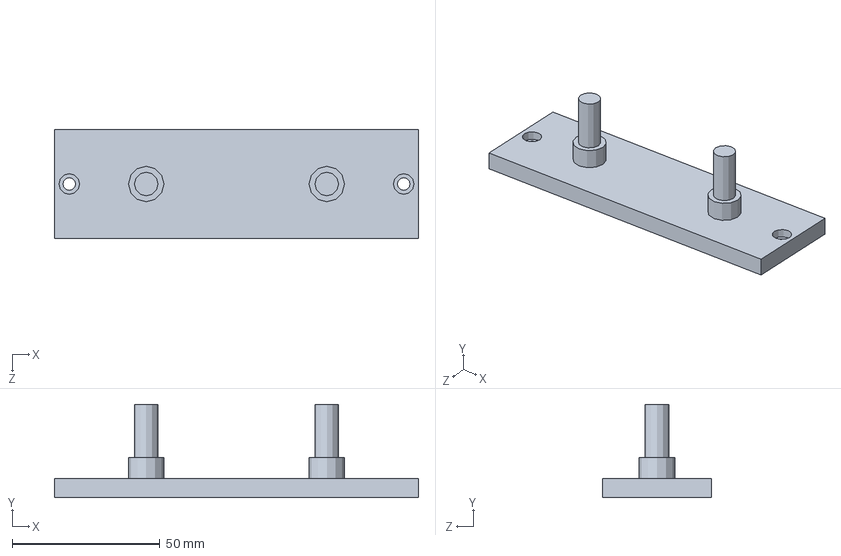
[picture p61: CAD file, 2020-04-24]
CAD/Battery/Battery CAD/Fuse_Mount.SLDPRT
123.0 x 31.5 x 37.0 mm
