zachleedogg/E_Moto/CAD/Battery/Battery CAD/Busbar_Contactor_to_Output.SLDPRT

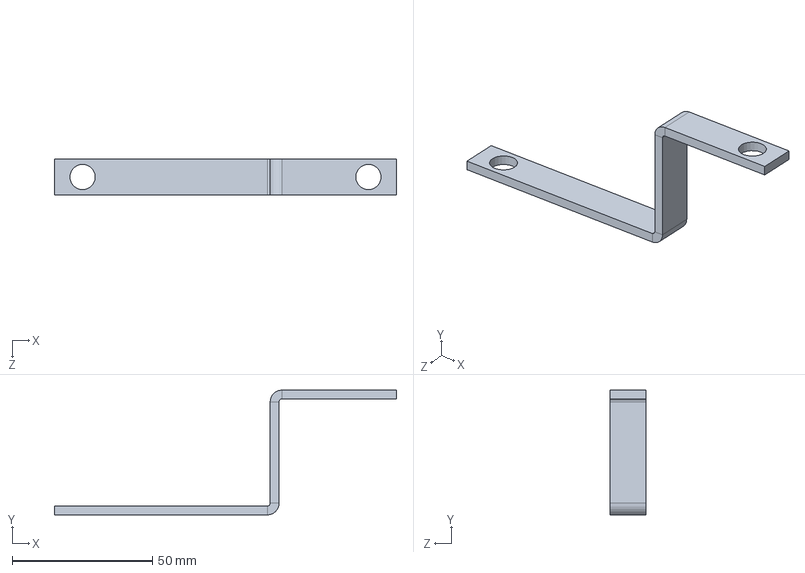
[picture p62: CAD file, 2020-04-24]
CAD/Battery/Battery CAD/Busbar_Contactor_to_Output.SLDPRT
121.8 x 44.5 x 12.7 mm
