zachleedogg/E_Moto/CAD/Battery/Battery CAD/Enclosure_Bottom.SLDPRT

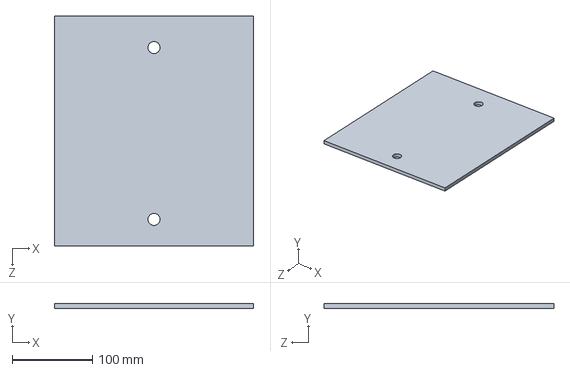
[picture p63: CAD file, 2020-04-24]
CAD/Battery/Battery CAD/Enclosure_Bottom.SLDPRT
248.0 x 5.99 x 286.0 mm
