zachleedogg/E_Moto/CAD/Battery/Welder/WelderArm.SLDPRT

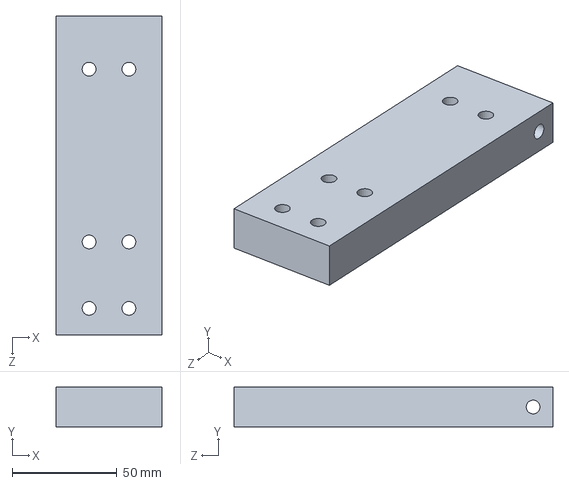
[picture p64: CAD file, 2019-07-03]
CAD/Battery/Welder/WelderArm.SLDPRT
50.8 x 19.1 x 152.4 mm
