zachleedogg/E_Moto/CAD/BodyController/BodyController_Shell/BottomSheel_V2.SLDPRT

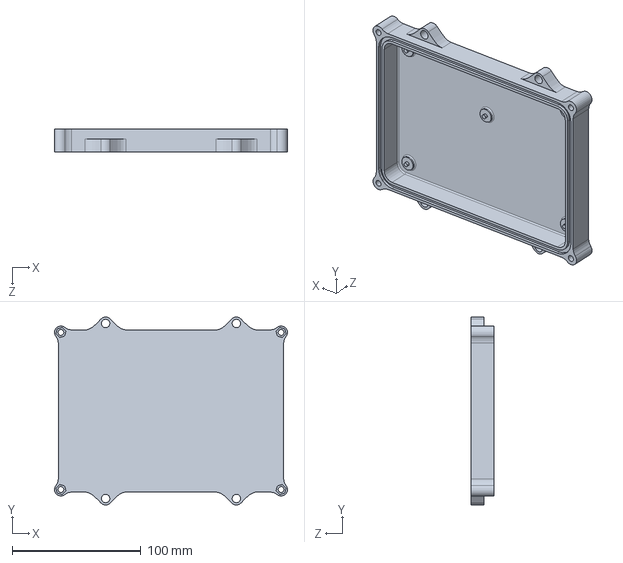
[picture p65: CAD file, 2019-07-03]
CAD/BodyController/BodyController_Shell/BottomSheel_V2.SLDPRT
181.0 x 146.0 x 17.6 mm
