zachleedogg/E_Moto/CAD/Battery/Battery 3.0/CAD/Copper_Bus_Strip.SLDPRT

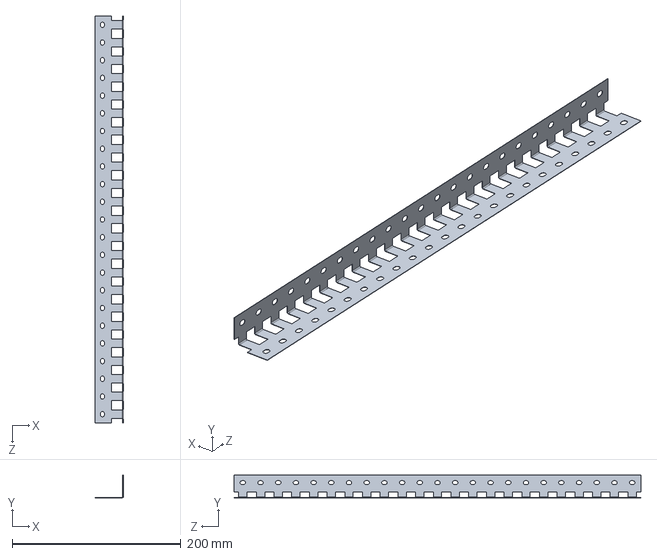
[picture p66: CAD file, 2021-01-03]
CAD/Battery/Battery 3.0/CAD/Copper_Bus_Strip.SLDPRT
33.6 x 27.2 x 483.0 mm
