zachleedogg/E_Moto/CAD/Battery/Battery CAD/Enclosure_Side.SLDPRT

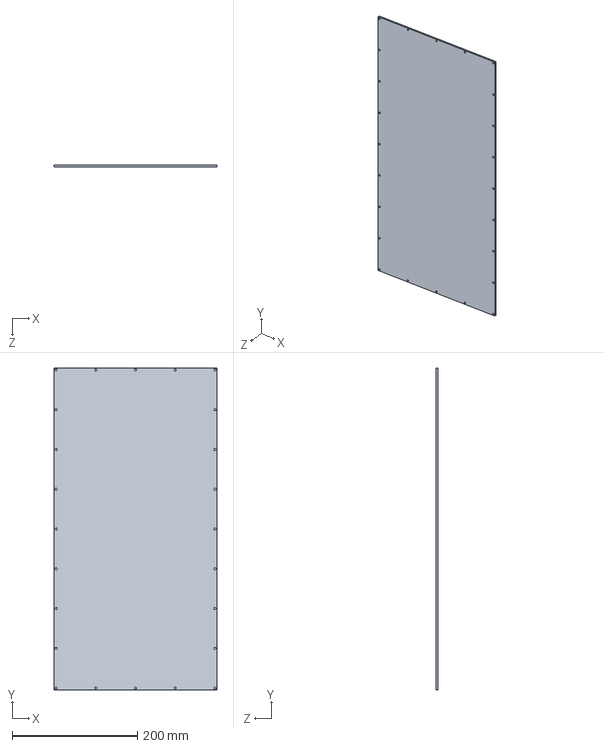
[picture p67: CAD file, 2020-04-24]
CAD/Battery/Battery CAD/Enclosure_Side.SLDPRT
260.0 x 515.0 x 3.00 mm
