zachleedogg/E_Moto/CAD/Battery/Welder/Bus_Block.SLDPRT

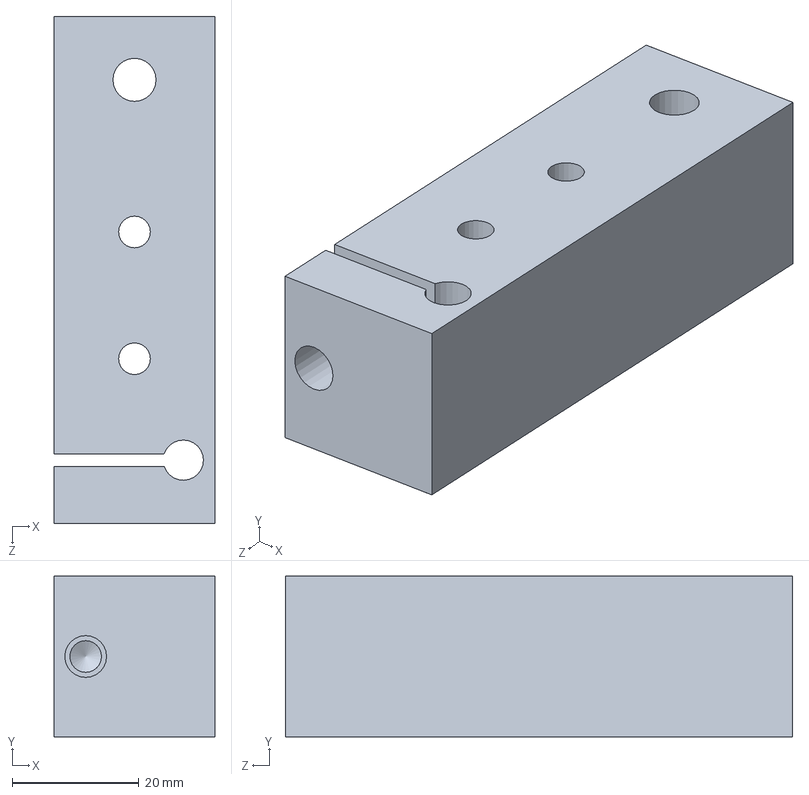
[picture p68: CAD file, 2019-07-03]
CAD/Battery/Welder/Bus_Block.SLDPRT
25.4 x 25.4 x 80.0 mm
