zachleedogg/E_Moto/CAD/Battery/Battery 3.0/CAD/Contact_Plate.SLDPRT

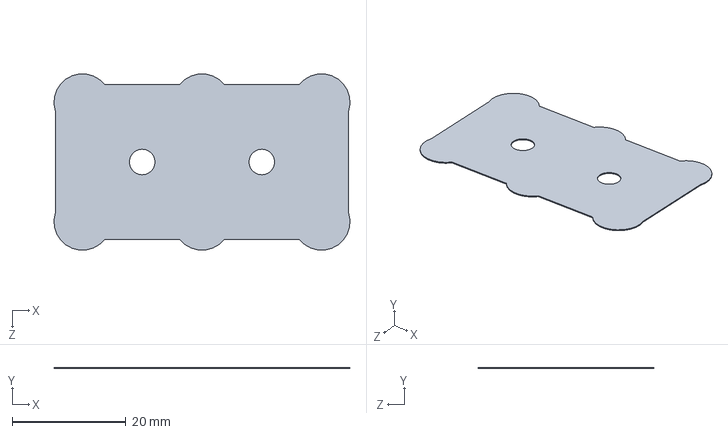
[picture p69: CAD file, 2021-01-03]
CAD/Battery/Battery 3.0/CAD/Contact_Plate.SLDPRT
52.0 x 0.2 x 30.9 mm
