zachleedogg/E_Moto/CAD/Battery/Battery CAD/Busbar_B+_to_Fuse.SLDPRT

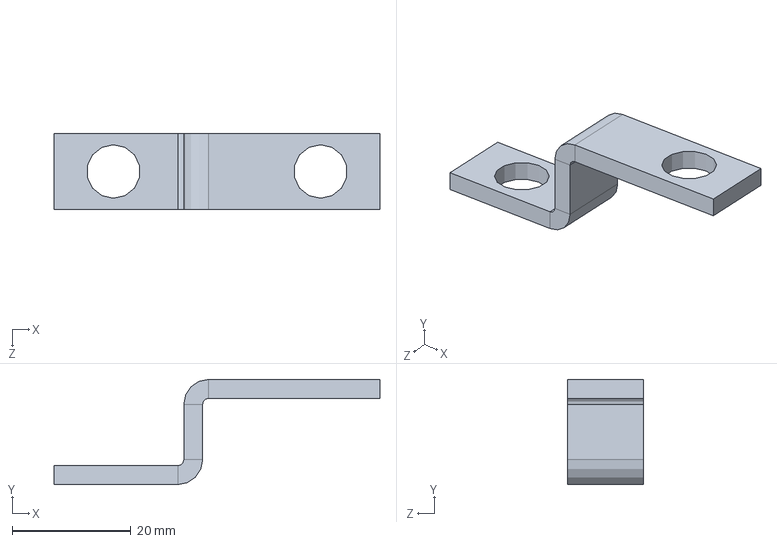
[picture p70: CAD file, 2020-04-24]
CAD/Battery/Battery CAD/Busbar_B+_to_Fuse.SLDPRT
54.8 x 17.7 x 12.7 mm
