zachleedogg/E_Moto/CAD/Battery/Battery 3.0/CAD/Cell_Holder_6P.SLDPRT

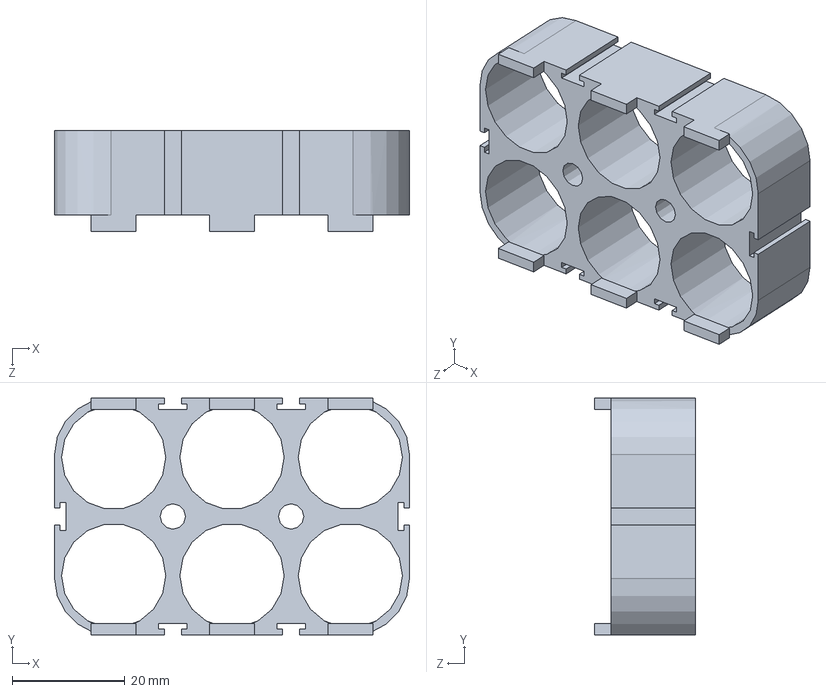
[picture p71: CAD file, 2021-01-03]
CAD/Battery/Battery 3.0/CAD/Cell_Holder_6P.SLDPRT
63.0 x 42.0 x 18.0 mm
