zachleedogg/E_Moto/CAD/Battery/Battery CAD/terminal.SLDPRT

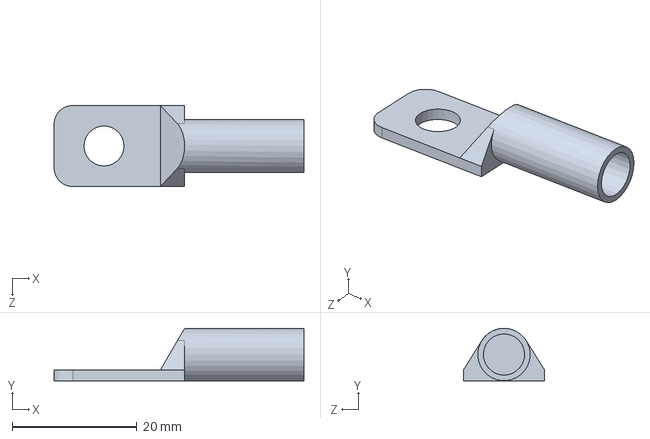
[picture p72: CAD file, 2020-04-24]
CAD/Battery/Battery CAD/terminal.SLDPRT
40.0 x 8.40 x 13.0 mm
