zachleedogg/E_Moto/CAD/Battery/Battery CAD/Module_to_Module_BusBar.SLDPRT

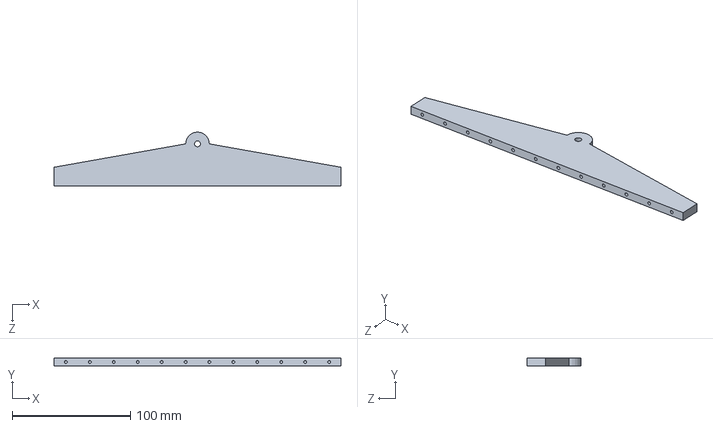
[picture p73: CAD file, 2020-04-24]
CAD/Battery/Battery CAD/Module_to_Module_BusBar.SLDPRT
242.4 x 6.35 x 45.5 mm
