zachleedogg/E_Moto/CAD/BodyController/BodyController_Shell/Top_Shell_V2.sldprt

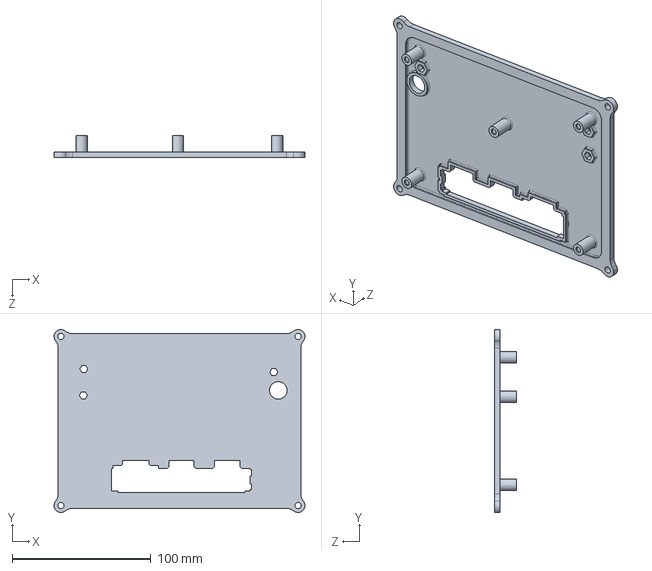
[picture p74: CAD file, 2019-07-03]
CAD/BodyController/BodyController_Shell/Top_Shell_V2.sldprt
181.0 x 132.0 x 15.6 mm
