zachleedogg/E_Moto/CAD/Battery/Battery 3.0/CAD/Terminal_conductor.SLDPRT

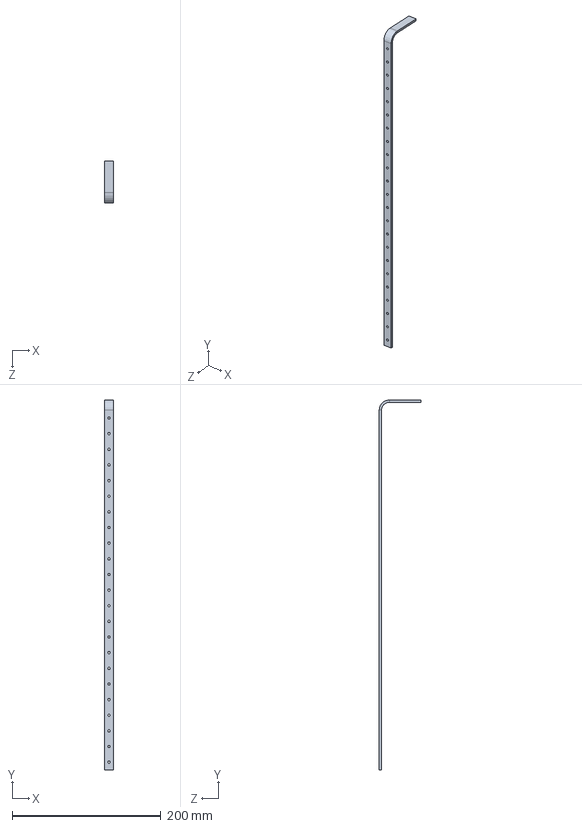
[picture p75: CAD file, 2021-01-03]
CAD/Battery/Battery 3.0/CAD/Terminal_conductor.SLDPRT
12.7 x 496.7 x 56.0 mm
