zachleedogg/E_Moto/CAD/Battery/Battery 3.0/CAD/12X48_Pack_Insulator.SLDPRT

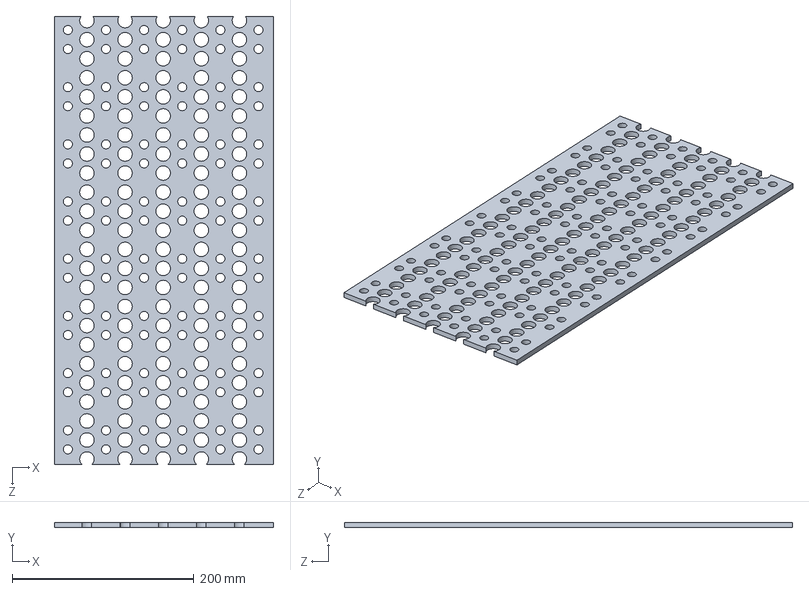
[picture p76: CAD file, 2021-01-03]
CAD/Battery/Battery 3.0/CAD/12X48_Pack_Insulator.SLDPRT
241.5 x 6.00 x 493.5 mm
