zachleedogg/E_Moto/CAD/Battery/Battery CAD/Module_to_Module_Insulator.SLDPRT

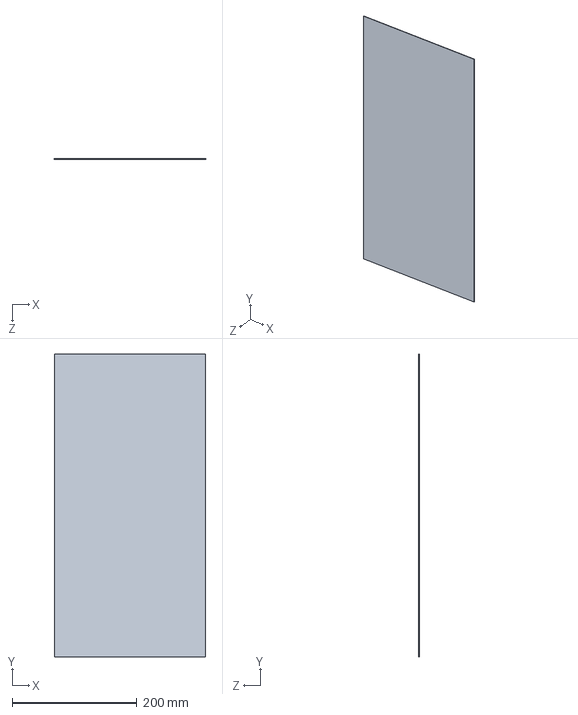
[picture p77: CAD file, 2020-03-23]
CAD/Battery/Battery CAD/Module_to_Module_Insulator.SLDPRT
242.4 x 484.8 x 0.75 mm
