zachleedogg/E_Moto/CAD/Battery/Battery 3.0/CAD/Center_conductor.SLDPRT

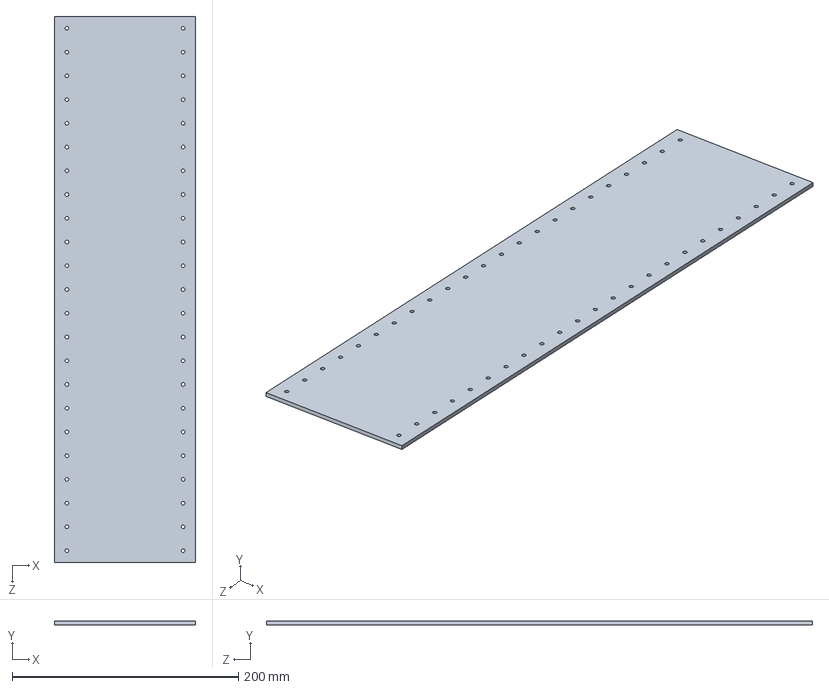
[picture p78: CAD file, 2021-01-03]
CAD/Battery/Battery 3.0/CAD/Center_conductor.SLDPRT
124.8 x 3.17 x 483.0 mm
