zachleedogg/E_Moto/CAD/BodyController/COMPOUND_1.sldprt

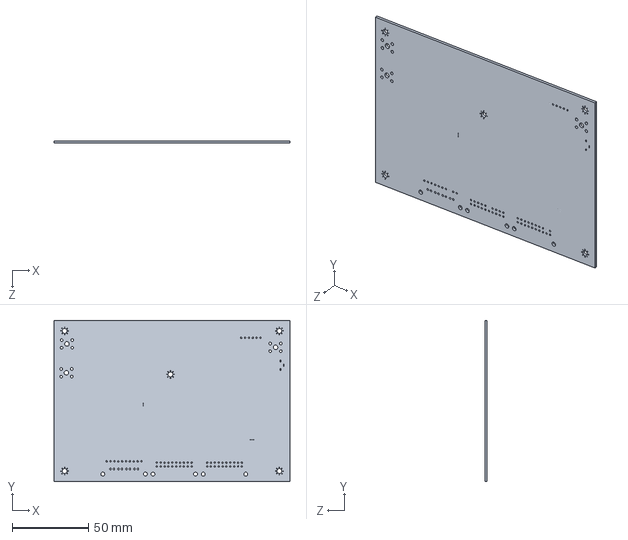
[picture p79: CAD file, 2019-07-03]
CAD/BodyController/COMPOUND_1.sldprt
155.0 x 106.0 x 1.60 mm
