zachleedogg/E_Moto/CAD/Battery/Battery CAD/Connection_Grid.SLDPRT

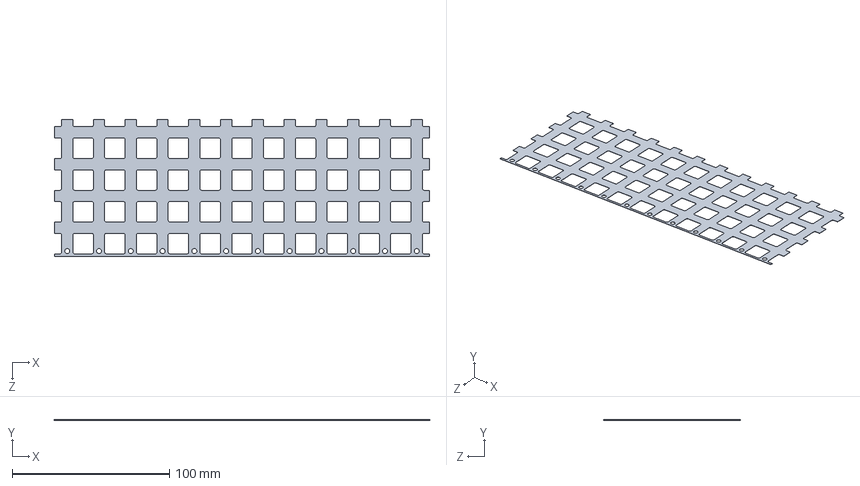
[picture p80: CAD file, 2020-02-11]
CAD/Battery/Battery CAD/Connection_Grid.SLDPRT
238.4 x 0.15 x 86.9 mm
