zachleedogg/E_Moto/CAD/Battery/Battery CAD/Module_Bottom_Insulator.SLDPRT

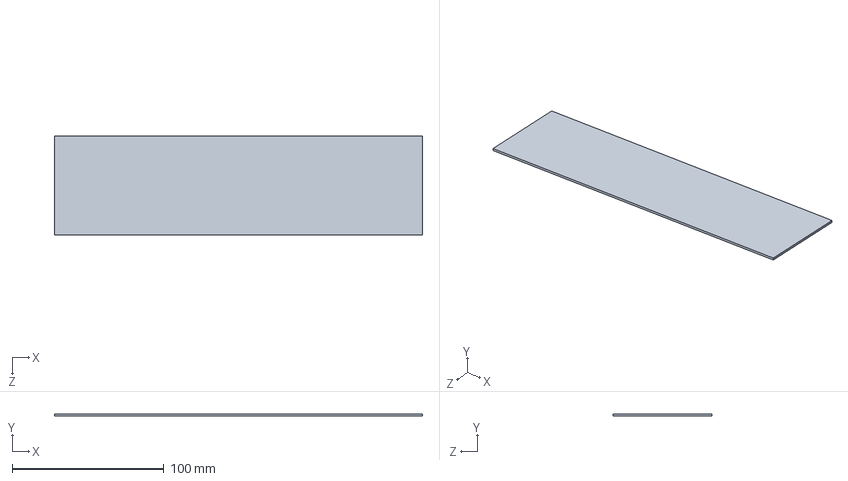
[picture p81: CAD file, 2020-02-11]
CAD/Battery/Battery CAD/Module_Bottom_Insulator.SLDPRT
242.4 x 1.59 x 65.0 mm
