zachleedogg/E_Moto/(list of files, cad)

Other CAD files:
CAD/BodyController/CP_Elec_6.3x7.7_1.sldasm
CAD/BodyController/TSSOP-8_3x3mm_Pitch0.65mm_1.sldasm
CAD/BodyController/SOT-23_1.sldasm
CAD/BodyController/SOT-363_SC-70-6_1.sldasm
CAD/BodyController/R_2512_1.sldasm
CAD/BodyController/CP_Elec_10x10_1.sldasm
CAD/BodyController/C_1206_1.sldasm
CAD/BodyController/C_0805_1.sldasm
CAD/BodyController/TQFP-100_14x14mm_Pitch0.5mm_1.sldasm
CAD/BodyController/SOIC-20W_7.5x12.8mm_Pitch1.27mm_1.sldasm
CAD/BodyController/D_SOT-23_1.sldasm
CAD/BodyController/Pin_Header_Straight_1x06_Pitch2.54mm_1.sldasm
CAD/BodyController/SSOP-16_3.9x4.9mm_Pitch0.635mm_1.sldasm
CAD/BodyController/D_0603_1.sldasm
CAD/BodyController/D_SMC_1.sldasm
CAD/BodyController/QFN-20-1EP_3x4mm_Pitch0.5mm_1.sldasm
CAD/BodyController/SOIC-8_3.9x4.9mm_Pitch1.27mm_1.sldasm
CAD/BodyController/D_PowerDI-123_1.sldasm
CAD/BodyController/SOT-23-5_1.sldasm
CAD/BodyController/SOT-666_1.sldasm
CAD/BodyController/R_0603_1.sldasm
CAD/BodyController/TDSON-8-1_1.sldasm
CAD/BodyController/D_SOD-323_1.sldasm
CAD/BodyController/TO-220-7Lead_TabPin8_1.sldasm
CAD/BodyController/C_0603_1.sldasm
CAD/BodyController/SOT-23-6_1.sldasm
CAD/BodyController/D_SOD-123_1.sldasm
CAD/BodyController/L_0603_1.sldasm
CAD/BodyController/QFN-20-1EP_3x4mm_Pitch0.5mm.sldasm
CAD/BodyController/D_0603.sldasm
CAD/BodyController/TSSOP-8_3x3mm_Pitch0.65mm.sldasm
CAD/BodyController/TO-220-7Lead_TabPin8.sldasm
CAD/BodyController/R_0603.sldasm
CAD/BodyController/SOT-666.sldasm
CAD/BodyController/D_SOD-323.sldasm
CAD/BodyController/D_SOT-23.sldasm
CAD/BodyController/SOIC-20W_7.5x12.8mm_Pitch1.27mm.sldasm
CAD/BodyController/C_0603.sldasm
CAD/BodyController/CP_Elec_10x10.sldasm
CAD/BodyController/Pin_Header_Straight_1x06_Pitch2.54mm.sldasm
CAD/BodyController/SOT-23.sldasm
CAD/BodyController/TQFP-100_14x14mm_Pitch0.5mm.sldasm
CAD/BodyController/L_0603.sldasm
CAD/BodyController/SOIC-8_3.9x4.9mm_Pitch1.27mm.sldasm
CAD/BodyController/SSOP-16_3.9x4.9mm_Pitch0.635mm.sldasm
CAD/BodyController/C_1206.sldasm
CAD/BodyController/CP_Elec_6.3x7.7.sldasm
CAD/BodyController/C_0805.sldasm
CAD/BodyController/TDSON-8-1.sldasm
CAD/BodyController/R_2512.sldasm
CAD/BodyController/D_PowerDI-123.sldasm
CAD/BodyController/SOT-23-5.sldasm
CAD/BodyController/D_SMC.sldasm
CAD/BodyController/SOT-23-6.sldasm
CAD/BodyController/D_SOD-123.sldasm
CAD/BodyController/SOT-363_SC-70-6.sldasm
CAD/BodyController/BodyController_Shell/SOLID_1_16.sldprt
CAD/BodyController/BodyController_Shell/SOLID_1_12.sldprt
CAD/BodyController/SOLID_1.sldprt
CAD/BodyController/BodyController_Shell/SOLID_1_9.sldprt
CAD/BodyController/BodyController_Shell/SOLID_1_19.sldprt
CAD/BodyController/SOLID_1_8.sldprt
CAD/Frame/Trellis_Left_02_BOT.STL
CAD/BodyController/BodyController_Shell/SOLID_1_2.sldprt
CAD/BodyController/SOLID_1_5.sldprt
CAD/BodyController/BodyController_Shell/COMPOUND_1.sldprt
CAD/BodyController/BodyController_Shell/SOLID_1_24.sldprt
CAD/BodyController/BodyController_Shell/SOLID_1_13.sldprt
CAD/BodyController/BodyController_Shell/SOLID_1_20.sldprt
CAD/BodyController/BodyController_Shell/SOLID_1_25.sldprt
CAD/BodyController/SOLID_1_6.sldprt
CAD/BodyController/BodyController_Shell/SOLID_1_23.sldprt
CAD/BodyController/BodyController_Shell/SOLID_1_28.sldprt
CAD/BodyController/SOLID_1_10.sldprt
CAD/BodyController/BodyController_Shell/SOLID_1_15.sldprt
CAD/BodyController/BodyController_Shell/SOLID_1_10.sldprt
CAD/BodyController/SOLID_1_4.sldprt
CAD/BodyController/BodyController_Shell/SOLID_1.sldprt
CAD/BodyController/BodyController_Shell/SOLID_1_26.sldprt
CAD/BodyController/BodyController_Shell/SOLID_1_8.sldprt
CAD/BodyController/BodyController_Shell/SOLID_1_3.sldprt
CAD/BodyController/SOLID_1_23.sldprt
CAD/Battery/Battery 3.0/CAD/18650.SLDPRT
CAD/Battery/Battery 3.0/CAD/18650_Shrinkwarp.SLDPRT
CAD/Battery/Battery 3.0/CAD/18650_wrapped.SLDASM
CAD/Battery/Battery CAD/18650.SLDPRT
CAD/Battery/Battery CAD/1P Holder.SLDPRT
CAD/Battery/Battery CAD/HASS_XXX-P.SLDPRT
CAD/Battery/Battery CAD/Module_Shrink_Wrap.SLDPRT
CAD/Battery/Battery CAD/Pack_Shrink_Wrap.SLDPRT
CAD/Battery/Old Battery/7_wide_Bank.SLDASM
CAD/Battery/Old Battery/92125A126_TYPE 18-8 SS FLAT-HEAD SOCKET CAP SCREW.SLDPRT
CAD/Battery/Old Battery/93840A116_METRIC NYLON FLAT HEAD SLOTTED MACHINE SCREW.SLDPRT
CAD/Battery/Old Battery/Bank.SLDASM
CAD/Battery/Old Battery/BatteryPack.SLDASM
CAD/Battery/Old Battery/Bottom_Plate_7_wide.SLDPRT
CAD/Battery/Old Battery/BusBar.SLDPRT
CAD/Battery/Old Battery/BusBarAssy.SLDASM
CAD/Battery/Old Battery/BusBarIsulator.SLDPRT
CAD/Battery/Old Battery/BusBarTie.SLDPRT
CAD/Battery/Old Battery/EggCrate.SLDPRT
CAD/Battery/Old Battery/InsulatorPlate_1.SLDPRT
CAD/Battery/Old Battery/InsulatorPlate_2.SLDPRT
CAD/Battery/Old Battery/InsulatorPlate_Bottom.SLDPRT
CAD/Battery/Old Battery/NickelTab.SLDPRT
CAD/Battery/Old Battery/Side-Wall.SLDPRT
CAD/Battery/Old Battery/TerminalBusBar_1.SLDPRT
CAD/Battery/Old Battery/TerminalBusBar_2.SLDPRT
CAD/Battery/Old Battery/dummyBank_50.SLDPRT
CAD/Battery/Old Battery/longBank.SLDASM
CAD/Battery/Old Battery/longBrick.SLDASM
CAD/Battery/Old Battery/simpleAssem.SLDASM
CAD/Battery/Welder/18650.SLDPRT
CAD/Battery/Welder/18650.STL
CAD/Battery/Welder/92981A120_ALLOY STEEL SHOULDER SCREW.SLDPRT
CAD/Battery/Welder/9657K303_STEEL COMPRESSION SPRING.SLDPRT
CAD/Battery/Welder/Block_Holder.SLDPRT
CAD/Battery/Welder/Block_Holder.STL
CAD/Battery/Welder/Bus_Block.SLDDRW
CAD/Battery/Welder/WelderArm.SLDDRW
CAD/Battery/Welder/copperBusBar.SLDDRW
CAD/Battery/Welder/stand.STL
CAD/BodyController/BodyController_Shell/93590A103_18-8 SS HEX CPLG NUT.SLDPRT
CAD/BodyController/BodyController_Shell/BottomSheel_V2.STL
CAD/BodyController/BodyController_Shell/BottomShell.STL
CAD/BodyController/BodyController_Shell/Part61.sldprt
CAD/BodyController/BodyController_Shell/SOLID_1_11.sldprt
CAD/BodyController/BodyController_Shell/SOLID_1_14.sldprt
CAD/BodyController/BodyController_Shell/SOLID_1_17.sldprt
CAD/BodyController/BodyController_Shell/SOLID_1_18.sldprt
CAD/BodyController/BodyController_Shell/SOLID_1_21.sldprt
CAD/BodyController/BodyController_Shell/SOLID_1_22.sldprt
CAD/BodyController/BodyController_Shell/SOLID_1_27.sldprt
CAD/BodyController/BodyController_Shell/SOLID_1_4.sldprt
CAD/BodyController/BodyController_Shell/SOLID_1_5.sldprt
CAD/BodyController/BodyController_Shell/SOLID_1_6.sldprt
CAD/BodyController/BodyController_Shell/SOLID_1_7.sldprt
CAD/BodyController/BodyController_Shell/TopShell.SLDPRT
CAD/BodyController/BodyController_Shell/Top_Shell_V2.STL
CAD/BodyController/COMPOUND.sldprt
CAD/BodyController/PCB.SLDPRT
CAD/BodyController/SOLID.sldprt
CAD/BodyController/SOLID_10.sldprt
CAD/BodyController/SOLID_11.sldprt
CAD/BodyController/SOLID_12.sldprt
CAD/BodyController/SOLID_13.sldprt
CAD/BodyController/SOLID_14.sldprt
CAD/BodyController/SOLID_15.sldprt
CAD/BodyController/SOLID_16.sldprt
CAD/BodyController/SOLID_17.sldprt
CAD/BodyController/SOLID_18.sldprt
CAD/BodyController/SOLID_19.sldprt
CAD/BodyController/SOLID_1_11.sldprt
CAD/BodyController/SOLID_1_12.sldprt
CAD/BodyController/SOLID_1_13.sldprt
CAD/BodyController/SOLID_1_14.sldprt
CAD/BodyController/SOLID_1_15.sldprt
CAD/BodyController/SOLID_1_16.sldprt
CAD/BodyController/SOLID_1_17.sldprt
CAD/BodyController/SOLID_1_18.sldprt
CAD/BodyController/SOLID_1_19.sldprt
CAD/BodyController/SOLID_1_2.sldprt
CAD/BodyController/SOLID_1_20.sldprt
CAD/BodyController/SOLID_1_21.sldprt
CAD/BodyController/SOLID_1_22.sldprt
CAD/BodyController/SOLID_1_24.sldprt
CAD/BodyController/SOLID_1_25.sldprt
CAD/BodyController/SOLID_1_26.sldprt
CAD/BodyController/SOLID_1_27.sldprt
CAD/BodyController/SOLID_1_28.sldprt
CAD/BodyController/SOLID_1_3.sldprt
CAD/BodyController/SOLID_1_7.sldprt
CAD/BodyController/SOLID_1_9.sldprt
CAD/BodyController/SOLID_2.sldprt
CAD/BodyController/SOLID_20.sldprt
CAD/BodyController/SOLID_21.sldprt
CAD/BodyController/SOLID_22.sldprt
CAD/BodyController/SOLID_23.sldprt
CAD/BodyController/SOLID_24.sldprt
CAD/BodyController/SOLID_25.sldprt
CAD/BodyController/SOLID_26.sldprt
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
