zachleedogg/E_Moto/Hardware/BMS/Validation/5V_Ripple_200u_inductor.PNG

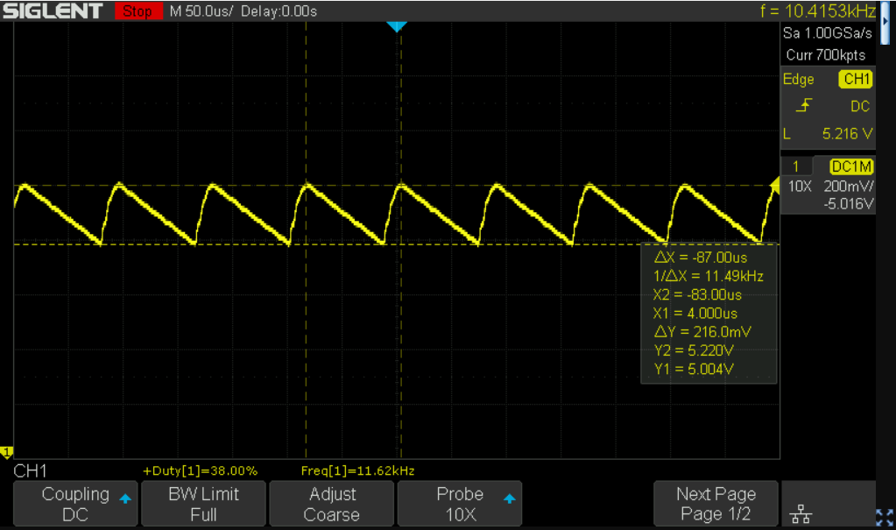
Hardware/BMS/Validation/5V_Ripple_200u_inductor.PNG
