zachleedogg/E_Moto/Hardware/BodyController/Validation/Horn/Horn_Transient.png

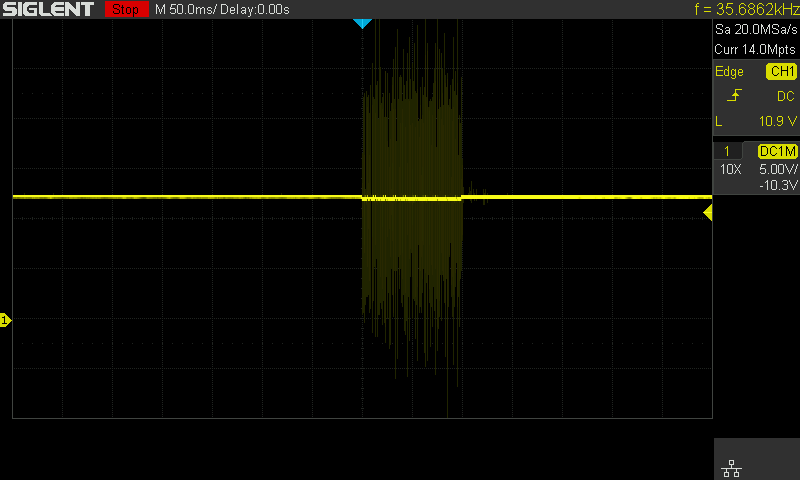
Hardware/BodyController/Validation/Horn/Horn_Transient.png
