zachleedogg/E_Moto/Firmware/Projects/BMS_Bootloader.X/.ca/buildLog/502_DEBUGActiveCA.txt

make -f nbproject/Makefile-502_DEBUGActiveCA.mk SUBPROJECTS= .clean-conf
make[1]: Entering directory 'C:/Users/kid group/Documents/Repos/E_Moto/Firmware/Projects/BMS_Controller_BL'
rm -f  -r .ca/build/502_DEBUGActiveCA/production
rm -f  -r .ca/dist/502_DEBUGActiveCA/production
make[1]: Leaving directory 'C:/Users/kid group/Documents/Repos/E_Moto/Firmware/Projects/BMS_Controller_BL'
[32mCLEAN SUCCESSFUL (total time: 155ms)[0m
make -f nbproject/Makefile-502_DEBUGActiveCA.mk SUBPROJECTS= .build-conf
make[1]: Entering directory 'C:/Users/kid group/Documents/Repos/E_Moto/Firmware/Projects/BMS_Controller_BL'
make  -f nbproject/Makefile-502_DEBUGActiveCA.mk .ca/dist/502_DEBUGActiveCA/production/BMS_Controller_BL.production.hex
make[2]: Entering directory 'C:/Users/kid group/Documents/Repos/E_Moto/Firmware/Projects/BMS_Controller_BL'
"C:\Program Files\Microchip\xc16\v2.00\bin\xc16-gcc.exe"   mcc_generated_files/boot/boot_application_header.c  -o .ca/build/502_DEBUGActiveCA/production/mcc_generated_files/boot/boot_application_header.o  -c -mcpu=33EP64GP506  -MP -MMD -MF ".ca/build/502_DEBUGActiveCA/production/mcc_generated_files/boot/boot_application_header.o.d"      -mno-eds-warn  -g -omf=elf -DXPRJ_502_DEBUGActiveCA=502_DEBUGActiveCA      -ffunction-sections -O0 -I"." -I"../../RTOS/Scheduler" -I"../../Libraries/PIC33_plib/inc" -I"../../Libraries/PIC33_plib/src" -I"../../CAN/generated" -I"../../Libraries/Standard" -I"../../Libraries/Drivers/TFT_LCD/inc" -I"../../Libraries/Drivers/TFT_LCD/src" -DDEBUG_502 -msmart-io=1 -Wall -msfr-warn=off    -mdfp="C:/Program Files/Microchip/MPLABX/v6.00/packs/Microchip/dsPIC33E-GM-GP-MC-GU-MU_DFP/1.3.85/xc16"
"C:\Program Files\Microchip\xc16\v2.00\bin\xc16-gcc.exe"   mcc_generated_files/boot/memory_partition.S  -o .ca/build/502_DEBUGActiveCA/production/mcc_generated_files/boot/memory_partition.o  -c -mcpu=33EP64GP506  -MP -MMD -MF ".ca/build/502_DEBUGActiveCA/production/mcc_generated_files/boot/memory_partition.o.d"  -omf=elf -DXPRJ_502_DEBUGActiveCA=502_DEBUGActiveCA    -Wa,-MD,".ca/build/502_DEBUGActiveCA/production/mcc_generated_files/boot/memory_partition.o.asm.d",--defsym=__MPLAB_BUILD=1,-g,--no-relax  -mdfp="C:/Program Files/Microchip/MPLABX/v6.00/packs/Microchip/dsPIC33E-GM-GP-MC-GU-MU_DFP/1.3.85/xc16"
"C:\Program Files\Microchip\xc16\v2.00\bin\xc16-gcc.exe"   mcc_generated_files/boot/boot_demo.c  -o .ca/build/502_DEBUGActiveCA/production/mcc_generated_files/boot/boot_demo.o  -c -mcpu=33EP64GP506  -MP -MMD -MF ".ca/build/502_DEBUGActiveCA/production/mcc_generated_files/boot/boot_demo.o.d"      -mno-eds-warn  -g -omf=elf -DXPRJ_502_DEBUGActiveCA=502_DEBUGActiveCA      -ffunction-sections -O0 -I"." -I"../../RTOS/Scheduler" -I"../../Libraries/PIC33_plib/inc" -I"../../Libraries/PIC33_plib/src" -I"../../CAN/generated" -I"../../Libraries/Standard" -I"../../Libraries/Drivers/TFT_LCD/inc" -I"../../Libraries/Drivers/TFT_LCD/src" -DDEBUG_502 -msmart-io=1 -Wall -msfr-warn=off    -mdfp="C:/Program Files/Microchip/MPLABX/v6.00/packs/Microchip/dsPIC33E-GM-GP-MC-GU-MU_DFP/1.3.85/xc16"
"C:\Program Files\Microchip\xc16\v2.00\bin\xc16-gcc.exe"   mcc_generated_files/boot/interrupts.S  -o .ca/build/502_DEBUGActiveCA/production/mcc_generated_files/boot/interrupts.o  -c -mcpu=33EP64GP506  -MP -MMD -MF ".ca/build/502_DEBUGActiveCA/production/mcc_generated_files/boot/interrupts.o.d"  -omf=elf -DXPRJ_502_DEBUGActiveCA=502_DEBUGActiveCA    -Wa,-MD,".ca/build/502_DEBUGActiveCA/production/mcc_generated_files/boot/interrupts.o.asm.d",--defsym=__MPLAB_BUILD=1,-g,--no-relax  -mdfp="C:/Program Files/Microchip/MPLABX/v6.00/packs/Microchip/dsPIC33E-GM-GP-MC-GU-MU_DFP/1.3.85/xc16"
"C:\Program Files\Microchip\xc16\v2.00\bin\xc16-gcc.exe"   mcc_generated_files/mcc.c  -o .ca/build/502_DEBUGActiveCA/production/mcc_generated_files/mcc.o  -c -mcpu=33EP64GP506  -MP -MMD -MF ".ca/build/502_DEBUGActiveCA/production/mcc_generated_files/mcc.o.d"      -mno-eds-warn  -g -omf=elf -DXPRJ_502_DEBUGActiveCA=502_DEBUGActiveCA      -ffunction-sections -O0 -I"." -I"../../RTOS/Scheduler" -I"../../Libraries/PIC33_plib/inc" -I"../../Libraries/PIC33_plib/src" -I"../../CAN/generated" -I"../../Libraries/Standard" -I"../../Libraries/Drivers/TFT_LCD/inc" -I"../../Libraries/Drivers/TFT_LCD/src" -DDEBUG_502 -msmart-io=1 -Wall -msfr-warn=off    -mdfp="C:/Program Files/Microchip/MPLABX/v6.00/packs/Microchip/dsPIC33E-GM-GP-MC-GU-MU_DFP/1.3.85/xc16"
"C:\Program Files\Microchip\xc16\v2.00\bin\xc16-gcc.exe"   mcc_generated_files/boot/boot_process.c  -o .ca/build/502_DEBUGActiveCA/production/mcc_generated_files/boot/boot_process.o  -c -mcpu=33EP64GP506  -MP -MMD -MF ".ca/build/502_DEBUGActiveCA/production/mcc_generated_files/boot/boot_process.o.d"      -mno-eds-warn  -g -omf=elf -DXPRJ_502_DEBUGActiveCA=502_DEBUGActiveCA      -ffunction-sections -O0 -I"." -I"../../RTOS/Scheduler" -I"../../Libraries/PIC33_plib/inc" -I"../../Libraries/PIC33_plib/src" -I"../../CAN/generated" -I"../../Libraries/Standard" -I"../../Libraries/Drivers/TFT_LCD/inc" -I"../../Libraries/Drivers/TFT_LCD/src" -DDEBUG_502 -msmart-io=1 -Wall -msfr-warn=off    -mdfp="C:/Program Files/Microchip/MPLABX/v6.00/packs/Microchip/dsPIC33E-GM-GP-MC-GU-MU_DFP/1.3.85/xc16"
"C:\Program Files\Microchip\xc16\v2.00\bin\xc16-gcc.exe"   mcc_generated_files/boot/com_adaptor_uart.c  -o .ca/build/502_DEBUGActiveCA/production/mcc_generated_files/boot/com_adaptor_uart.o  -c -mcpu=33EP64GP506  -MP -MMD -MF ".ca/build/502_DEBUGActiveCA/production/mcc_generated_files/boot/com_adaptor_uart.o.d"      -mno-eds-warn  -g -omf=elf -DXPRJ_502_DEBUGActiveCA=502_DEBUGActiveCA      -ffunction-sections -O0 -I"." -I"../../RTOS/Scheduler" -I"../../Libraries/PIC33_plib/inc" -I"../../Libraries/PIC33_plib/src" -I"../../CAN/generated" -I"../../Libraries/Standard" -I"../../Libraries/Drivers/TFT_LCD/inc" -I"../../Libraries/Drivers/TFT_LCD/src" -DDEBUG_502 -msmart-io=1 -Wall -msfr-warn=off    -mdfp="C:/Program Files/Microchip/MPLABX/v6.00/packs/Microchip/dsPIC33E-GM-GP-MC-GU-MU_DFP/1.3.85/xc16"
"C:\Program Files\Microchip\xc16\v2.00\bin\xc16-gcc.exe"   mcc_generated_files/boot/hardware_interrupt_table.S  -o .ca/build/502_DEBUGActiveCA/production/mcc_generated_files/boot/hardware_interrupt_table.o  -c -mcpu=33EP64GP506  -MP -MMD -MF ".ca/build/502_DEBUGActiveCA/production/mcc_generated_files/boot/hardware_interrupt_table.o.d"  -omf=elf -DXPRJ_502_DEBUGActiveCA=502_DEBUGActiveCA    -Wa,-MD,".ca/build/502_DEBUGActiveCA/production/mcc_generated_files/boot/hardware_interrupt_table.o.asm.d",--defsym=__MPLAB_BUILD=1,-g,--no-relax  -mdfp="C:/Program Files/Microchip/MPLABX/v6.00/packs/Microchip/dsPIC33E-GM-GP-MC-GU-MU_DFP/1.3.85/xc16"
"C:\Program Files\Microchip\xc16\v2.00\bin\xc16-gcc.exe"   mcc_generated_files/pin_manager.c  -o .ca/build/502_DEBUGActiveCA/production/mcc_generated_files/pin_manager.o  -c -mcpu=33EP64GP506  -MP -MMD -MF ".ca/build/502_DEBUGActiveCA/production/mcc_generated_files/pin_manager.o.d"      -mno-eds-warn  -g -omf=elf -DXPRJ_502_DEBUGActiveCA=502_DEBUGActiveCA      -ffunction-sections -O0 -I"." -I"../../RTOS/Scheduler" -I"../../Libraries/PIC33_plib/inc" -I"../../Libraries/PIC33_plib/src" -I"../../CAN/generated" -I"../../Libraries/Standard" -I"../../Libraries/Drivers/TFT_LCD/inc" -I"../../Libraries/Drivers/TFT_LCD/src" -DDEBUG_502 -msmart-io=1 -Wall -msfr-warn=off    -mdfp="C:/Program Files/Microchip/MPLABX/v6.00/packs/Microchip/dsPIC33E-GM-GP-MC-GU-MU_DFP/1.3.85/xc16"
"C:\Program Files\Microchip\xc16\v2.00\bin\xc16-gcc.exe"   mcc_generated_files/memory/flash_demo.c  -o .ca/build/502_DEBUGActiveCA/production/mcc_generated_files/memory/flash_demo.o  -c -mcpu=33EP64GP506  -MP -MMD -MF ".ca/build/502_DEBUGActiveCA/production/mcc_generated_files/memory/flash_demo.o.d"      -mno-eds-warn  -g -omf=elf -DXPRJ_502_DEBUGActiveCA=502_DEBUGActiveCA      -ffunction-sections -O0 -I"." -I"../../RTOS/Scheduler" -I"../../Libraries/PIC33_plib/inc" -I"../../Libraries/PIC33_plib/src" -I"../../CAN/generated" -I"../../Libraries/Standard" -I"../../Libraries/Drivers/TFT_LCD/inc" -I"../../Libraries/Drivers/TFT_LCD/src" -DDEBUG_502 -msmart-io=1 -Wall -msfr-warn=off    -mdfp="C:/Program Files/Microchip/MPLABX/v6.00/packs/Microchip/dsPIC33E-GM-GP-MC-GU-MU_DFP/1.3.85/xc16"
"C:\Program Files\Microchip\xc16\v2.00\bin\xc16-gcc.exe"   mcc_generated_files/memory/flash.s  -o .ca/build/502_DEBUGActiveCA/production/mcc_generated_files/memory/flash.o  -c -mcpu=33EP64GP506  -omf=elf -DXPRJ_502_DEBUGActiveCA=502_DEBUGActiveCA    -Wa,-MD,".ca/build/502_DEBUGActiveCA/production/mcc_generated_files/memory/flash.o.d",--defsym=__MPLAB_BUILD=1,-g,--no-relax  -mdfp="C:/Program Files/Microchip/MPLABX/v6.00/packs/Microchip/dsPIC33E-GM-GP-MC-GU-MU_DFP/1.3.85/xc16"
"C:\Program Files\Microchip\xc16\v2.00\bin\xc16-gcc.exe"   mcc_generated_files/traps.c  -o .ca/build/502_DEBUGActiveCA/production/mcc_generated_files/traps.o  -c -mcpu=33EP64GP506  -MP -MMD -MF ".ca/build/502_DEBUGActiveCA/production/mcc_generated_files/traps.o.d"      -mno-eds-warn  -g -omf=elf -DXPRJ_502_DEBUGActiveCA=502_DEBUGActiveCA      -ffunction-sections -O0 -I"." -I"../../RTOS/Scheduler" -I"../../Libraries/PIC33_plib/inc" -I"../../Libraries/PIC33_plib/src" -I"../../CAN/generated" -I"../../Libraries/Standard" -I"../../Libraries/Drivers/TFT_LCD/inc" -I"../../Libraries/Drivers/TFT_LCD/src" -DDEBUG_502 -msmart-io=1 -Wall -msfr-warn=off    -mdfp="C:/Program Files/Microchip/MPLABX/v6.00/packs/Microchip/dsPIC33E-GM-GP-MC-GU-MU_DFP/1.3.85/xc16"
"C:\Program Files\Microchip\xc16\v2.00\bin\xc16-gcc.exe"   mcc_generated_files/system.c  -o .ca/build/502_DEBUGActiveCA/production/mcc_generated_files/system.o  -c -mcpu=33EP64GP506  -MP -MMD -MF ".ca/build/502_DEBUGActiveCA/production/mcc_generated_files/system.o.d"      -mno-eds-warn  -g -omf=elf -DXPRJ_502_DEBUGActiveCA=502_DEBUGActiveCA      -ffunction-sections -O0 -I"." -I"../../RTOS/Scheduler" -I"../../Libraries/PIC33_plib/inc" -I"../../Libraries/PIC33_plib/src" -I"../../CAN/generated" -I"../../Libraries/Standard" -I"../../Libraries/Drivers/TFT_LCD/inc" -I"../../Libraries/Drivers/TFT_LCD/src" -DDEBUG_502 -msmart-io=1 -Wall -msfr-warn=off    -mdfp="C:/Program Files/Microchip/MPLABX/v6.00/packs/Microchip/dsPIC33E-GM-GP-MC-GU-MU_DFP/1.3.85/xc16"
"C:\Program Files\Microchip\xc16\v2.00\bin\xc16-gcc.exe"   mcc_generated_files/boot/boot_verify_not_blank.c  -o .ca/build/502_DEBUGActiveCA/production/mcc_generated_files/boot/boot_verify_not_blank.o  -c -mcpu=33EP64GP506  -MP -MMD -MF ".ca/build/502_DEBUGActiveCA/production/mcc_generated_files/boot/boot_verify_not_blank.o.d"      -mno-eds-warn  -g -omf=elf -DXPRJ_502_DEBUGActiveCA=502_DEBUGActiveCA      -ffunction-sections -O0 -I"." -I"../../RTOS/Scheduler" -I"../../Libraries/PIC33_plib/inc" -I"../../Libraries/PIC33_plib/src" -I"../../CAN/generated" -I"../../Libraries/Standard" -I"../../Libraries/Drivers/TFT_LCD/inc" -I"../../Libraries/Drivers/TFT_LCD/src" -DDEBUG_502 -msmart-io=1 -Wall -msfr-warn=off    -mdfp="C:/Program Files/Microchip/MPLABX/v6.00/packs/Microchip/dsPIC33E-GM-GP-MC-GU-MU_DFP/1.3.85/xc16"
"C:\Program Files\Microchip\xc16\v2.00\bin\xc16-gcc.exe"   mcc_generated_files/clock.c  -o .ca/build/502_DEBUGActiveCA/production/mcc_generated_files/clock.o  -c -mcpu=33EP64GP506  -MP -MMD -MF ".ca/build/502_DEBUGActiveCA/production/mcc_generated_files/clock.o.d"      -mno-eds-warn  -g -omf=elf -DXPRJ_502_DEBUGActiveCA=502_DEBUGActiveCA      -ffunction-sections -O0 -I"." -I"../../RTOS/Scheduler" -I"../../Libraries/PIC33_plib/inc" -I"../../Libraries/PIC33_plib/src" -I"../../CAN/generated" -I"../../Libraries/Standard" -I"../../Libraries/Drivers/TFT_LCD/inc" -I"../../Libraries/Drivers/TFT_LCD/src" -DDEBUG_502 -msmart-io=1 -Wall -msfr-warn=off    -mdfp="C:/Program Files/Microchip/MPLABX/v6.00/packs/Microchip/dsPIC33E-GM-GP-MC-GU-MU_DFP/1.3.85/xc16"
"C:\Program Files\Microchip\xc16\v2.00\bin\xc16-gcc.exe"   mcc_generated_files/reset.c  -o .ca/build/502_DEBUGActiveCA/production/mcc_generated_files/reset.o  -c -mcpu=33EP64GP506  -MP -MMD -MF ".ca/build/502_DEBUGActiveCA/production/mcc_generated_files/reset.o.d"      -mno-eds-warn  -g -omf=elf -DXPRJ_502_DEBUGActiveCA=502_DEBUGActiveCA      -ffunction-sections -O0 -I"." -I"../../RTOS/Scheduler" -I"../../Libraries/PIC33_plib/inc" -I"../../Libraries/PIC33_plib/src" -I"../../CAN/generated" -I"../../Libraries/Standard" -I"../../Libraries/Drivers/TFT_LCD/inc" -I"../../Libraries/Drivers/TFT_LCD/src" -DDEBUG_502 -msmart-io=1 -Wall -msfr-warn=off    -mdfp="C:/Program Files/Microchip/MPLABX/v6.00/packs/Microchip/dsPIC33E-GM-GP-MC-GU-MU_DFP/1.3.85/xc16"
"C:\Program Files\Microchip\xc16\v2.00\bin\xc16-gcc.exe"   mcc_generated_files/interrupt_manager.c  -o .ca/build/502_DEBUGActiveCA/production/mcc_generated_files/interrupt_manager.o  -c -mcpu=33EP64GP506  -MP -MMD -MF ".ca/build/502_DEBUGActiveCA/production/mcc_generated_files/interrupt_manager.o.d"      -mno-eds-warn  -g -omf=elf -DXPRJ_502_DEBUGActiveCA=502_DEBUGActiveCA      -ffunction-sections -O0 -I"." -I"../../RTOS/Scheduler" -I"../../Libraries/PIC33_plib/inc" -I"../../Libraries/PIC33_plib/src" -I"../../CAN/generated" -I"../../Libraries/Standard" -I"../../Libraries/Drivers/TFT_LCD/inc" -I"../../Libraries/Drivers/TFT_LCD/src" -DDEBUG_502 -msmart-io=1 -Wall -msfr-warn=off    -mdfp="C:/Program Files/Microchip/MPLABX/v6.00/packs/Microchip/dsPIC33E-GM-GP-MC-GU-MU_DFP/1.3.85/xc16"
"C:\Program Files\Microchip\xc16\v2.00\bin\xc16-gcc.exe"   mcc_generated_files/uart1.c  -o .ca/build/502_DEBUGActiveCA/production/mcc_generated_files/uart1.o  -c -mcpu=33EP64GP506  -MP -MMD -MF ".ca/build/502_DEBUGActiveCA/production/mcc_generated_files/uart1.o.d"      -mno-eds-warn  -g -omf=elf -DXPRJ_502_DEBUGActiveCA=502_DEBUGActiveCA      -ffunction-sections -O0 -I"." -I"../../RTOS/Scheduler" -I"../../Libraries/PIC33_plib/inc" -I"../../Libraries/PIC33_plib/src" -I"../../CAN/generated" -I"../../Libraries/Standard" -I"../../Libraries/Drivers/TFT_LCD/inc" -I"../../Libraries/Drivers/TFT_LCD/src" -DDEBUG_502 -msmart-io=1 -Wall -msfr-warn=off    -mdfp="C:/Program Files/Microchip/MPLABX/v6.00/packs/Microchip/dsPIC33E-GM-GP-MC-GU-MU_DFP/1.3.85/xc16"
"C:\Program Files\Microchip\xc16\v2.00\bin\xc16-gcc.exe"   main.c  -o .ca/build/502_DEBUGActiveCA/production/main.o  -c -mcpu=33EP64GP506  -MP -MMD -MF ".ca/build/502_DEBUGActiveCA/production/main.o.d"      -mno-eds-warn  -g -omf=elf -DXPRJ_502_DEBUGActiveCA=502_DEBUGActiveCA      -ffunction-sections -O0 -I"." -I"../../RTOS/Scheduler" -I"../../Libraries/PIC33_plib/inc" -I"../../Libraries/PIC33_plib/src" -I"../../CAN/generated" -I"../../Libraries/Standard" -I"../../Libraries/Drivers/TFT_LCD/inc" -I"../../Libraries/Drivers/TFT_LCD/src" -DDEBUG_502 -msmart-io=1 -Wall -msfr-warn=off    -mdfp="C:/Program Files/Microchip/MPLABX/v6.00/packs/Microchip/dsPIC33E-GM-GP-MC-GU-MU_DFP/1.3.85/xc16"
"C:\Program Files\Microchip\xc16\v2.00\bin\xc16-gcc.exe"   -o .ca/dist/502_DEBUGActiveCA/production/BMS_Controller_BL.production.elf  .ca/build/502_DEBUGActiveCA/production/mcc_generated_files/boot/memory_partition.o .ca/build/502_DEBUGActiveCA/production/mcc_generated_files/boot/boot_application_header.o .ca/build/502_DEBUGActiveCA/production/mcc_generated_files/boot/boot_process.o .ca/build/502_DEBUGActiveCA/production/mcc_generated_files/boot/interrupts.o .ca/build/502_DEBUGActiveCA/production/mcc_generated_files/boot/com_adaptor_uart.o .ca/build/502_DEBUGActiveCA/production/mcc_generated_files/boot/boot_demo.o .ca/build/502_DEBUGActiveCA/production/mcc_generated_files/boot/boot_verify_not_blank.o .ca/build/502_DEBUGActiveCA/production/mcc_generated_files/boot/hardware_interrupt_table.o .ca/build/502_DEBUGActiveCA/production/mcc_generated_files/memory/flash.o .ca/build/502_DEBUGActiveCA/production/mcc_generated_files/memory/flash_demo.o .ca/build/502_DEBUGActiveCA/production/mcc_generated_files/pin_manager.o .ca/build/502_DEBUGActiveCA/production/mcc_generated_files/traps.o .ca/build/502_DEBUGActiveCA/production/mcc_generated_files/mcc.o .ca/build/502_DEBUGActiveCA/production/mcc_generated_files/clock.o .ca/build/502_DEBUGActiveCA/production/mcc_generated_files/reset.o .ca/build/502_DEBUGActiveCA/production/mcc_generated_files/system.o .ca/build/502_DEBUGActiveCA/production/mcc_generated_files/interrupt_manager.o .ca/build/502_DEBUGActiveCA/production/mcc_generated_files/uart1.o .ca/build/502_DEBUGActiveCA/production/main.o      -mcpu=33EP64GP506        -omf=elf -DXPRJ_502_DEBUGActiveCA=502_DEBUGActiveCA      -Wl,--local-stack,,--defsym=__MPLAB_BUILD=1,,--script=p33EP64GP506.gld,--stack=16,--check-sections,--data-init,--pack-data,--handles,--isr,--gc-sections,--fill-upper=0,--stackguard=16,--no-force-link,--smart-io,-Map=".ca/dist/502_DEBUGActiveCA/production/BMS_Controller_BL.production.map",--report-mem,--memorysummary,.ca/dist/502_DEBUGActiveCA/production/memoryfile.xml  -mdfp="C:/Program Files/Microchip/MPLABX/v6.00/packs/Microchip/dsPIC33E-GM-GP-MC-GU-MU_DFP/1.3.85/xc16" 
[31m.ca/build/502_DEBUGActiveCA/production/mcc_generated_files/boot/boot_process.o: Link Error: Could not allocate section .text.EraseFlash, size = 500 PC units, attributes = code 
.ca/build/502_DEBUGActiveCA/production/mcc_generated_files/boot/boot_process.o: Link Error: Could not allocate section .text.WriteFlash, size = 438 PC units, attributes = code 
.ca/build/502_DEBUGActiveCA/production/mcc_generated_files/boot/boot_process.o: Link Error: Could not allocate section .text.CalculateChecksum, size = 414 PC units, attributes = code 
.ca/build/502_DEBUGActiveCA/production/mcc_generated_files/boot/boot_process.o: Link Error: Could not allocate section .text.ReadFlash, size = 394 PC units, attributes = code 
.ca/build/502_DEBUGActiveCA/production/mcc_generated_files/memory/flash.o: Link Error: Could not allocate section .NVM_flash, size = 244 PC units, attributes = code 
.ca/build/502_DEBUGActiveCA/production/mcc_generated_files/boot/boot_process.o: Link Error: Could not allocate section .text.BOOT_ProcessCommand, size = 178 PC units, attributes = code 
.ca/build/502_DEBUGActiveCA/production/mcc_generated_files/pin_manager.o: Link Error: Could not allocate section .text.PIN_MANAGER_Initialize, size = 168 PC units, attributes = code 
.ca/build/502_DEBUGActiveCA/production/mcc_generated_files/clock.o: Link Error: Could not allocate section .text.CLOCK_Initialize, size = 78 PC units, attributes = code 
.ca/build/502_DEBUGActiveCA/production/mcc_generated_files/boot/boot_process.o: Link Error: Could not allocate section .text.SelfVerify, size = 76 PC units, attributes = code 
.ca/build/502_DEBUGActiveCA/production/mcc_generated_files/boot/boot_process.o: Link Error: Could not allocate section .const, size = 74 PC units, attributes = psv page 
data_init: Link Error: Could not allocate section .dinit, size = 70 PC units, attributes = code keep 
.ca/build/502_DEBUGActiveCA/production/mcc_generated_files/boot/com_adaptor_uart.o: Link Error: Could not allocate section .text.BOOT_COM_GetBytesReady, size = 66 PC units, attributes = code 
.ca/build/502_DEBUGActiveCA/production/mcc_generated_files/boot/com_adaptor_uart.o: Link Error: Could not allocate section .text.BOOT_COM_Read, size = 64 PC units, attributes = code 
.ca/build/502_DEBUGActiveCA/production/mcc_generated_files/boot/boot_demo.o: Link Error: Could not allocate section .text.BOOT_DEMO_Tasks, size = 62 PC units, attributes = code 
.ca/build/502_DEBUGActiveCA/production/mcc_generated_files/uart1.o: Link Error: Could not allocate section .text.UART1_IsTxReady, size = 60 PC units, attributes = code 
.ca/build/502_DEBUGActiveCA/production/mcc_generated_files/boot/com_adaptor_uart.o: Link Error: Could not allocate section .text.BOOT_COM_Write, size = 56 PC units, attributes = code 
.ca/build/502_DEBUGActiveCA/production/mcc_generated_files/uart1.o: Link Error: Could not allocate section .text.UART1_Initialize, size = 52 PC units, attributes = code 
.ca/build/502_DEBUGActiveCA/production/mcc_generated_files/boot/boot_verify_not_blank.o: Link Error: Could not allocate section .text.BOOT_ImageVerify, size = 50 PC units, attributes = code 
.ca/build/502_DEBUGActiveCA/production/mcc_generated_files/boot/boot_process.o: Link Error: Could not allocate section .text.ResetDevice, size = 48 PC units, attributes = code 
.ca/build/502_DEBUGActiveCA/production/mcc_generated_files/boot/boot_process.o: Link Error: Could not allocate section .text.BOOT_ImageAddressGet, size = 48 PC units, attributes = code 
.ca/build/502_DEBUGActiveCA/production/mcc_generated_files/boot/boot_process.o: Link Error: Could not allocate section .text.IsLegalRange, size = 46 PC units, attributes = code 
.ca/build/502_DEBUGActiveCA/production/mcc_generated_files/boot/boot_process.o: Link Error: Could not allocate section .text.IsLegalAddress, size = 44 PC units, attributes = code 
.ca/build/502_DEBUGActiveCA/production/mcc_generated_files/uart1.o: Link Error: Could not allocate section .text.UART1_Read, size = 44 PC units, attributes = code 
.ca/build/502_DEBUGActiveCA/production/mcc_generated_files/boot/boot_process.o: Link Error: Could not allocate section .text.CommandError, size = 42 PC units, attributes = code 
.ca/build/502_DEBUGActiveCA/production/mcc_generated_files/uart1.o: Link Error: Could not allocate section .text.UART1_Write, size = 42 PC units, attributes = code 
.ca/build/502_DEBUGActiveCA/production/mcc_generated_files/interrupt_manager.o: Link Error: Could not allocate section .text.INTERRUPT_Initialize, size = 36 PC units, attributes = code 
.ca/build/502_DEBUGActiveCA/production/mcc_generated_files/uart1.o: Link Error: Could not allocate section .text.UART1_IsTxDone, size = 34 PC units, attributes = code 
.ca/build/502_DEBUGActiveCA/production/mcc_generated_files/boot/boot_process.o: Link Error: Could not allocate section .text.ReadVersion, size = 30 PC units, attributes = code 
.ca/build/502_DEBUGActiveCA/production/mcc_generated_files/boot/boot_process.o: Link Error: Could not allocate section .text.GetMemoryAddressRange, size = 28 PC units, attributes = code 
.ca/build/502_DEBUGActiveCA/production/mcc_generated_files/boot/com_adaptor_uart.o: Link Error: Could not allocate section .text.BOOT_COM_Peek, size = 24 PC units, attributes = code 
.ca/build/502_DEBUGActiveCA/production/mcc_generated_files/uart1.o: Link Error: Could not allocate section .text.UART1_SetTxInterruptHandler, size = 24 PC units, attributes = code 
.ca/build/502_DEBUGActiveCA/production/mcc_generated_files/uart1.o: Link Error: Could not allocate section .text.UART1_SetRxInterruptHandler, size = 24 PC units, attributes = code 
.ca/build/502_DEBUGActiveCA/production/mcc_generated_files/system.o: Link Error: Could not allocate section .text.SYSTEM_Initialize, size = 22 PC units, attributes = code 
.ca/build/502_DEBUGActiveCA/production/mcc_generated_files/uart1.o: Link Error: Could not allocate section .text.UART1_IsRxReady, size = 22 PC units, attributes = code 
.ca/build/502_DEBUGActiveCA/production/mcc_generated_files/system.o: Link Error: Could not allocate section .text.SYSTEM_CORCONModeOperatingSet, size = 18 PC units, attributes = code 
.ca/build/502_DEBUGActiveCA/production/mcc_generated_files/boot/boot_process.o: Link Error: Could not allocate section .text.BOOT_StartApplication, size = 14 PC units, attributes = code 
.ca/build/502_DEBUGActiveCA/production/mcc_generated_files/traps.o: Link Error: Could not allocate section .text.use_failsafe_stack, size = 14 PC units, attributes = code 
.ca/build/502_DEBUGActiveCA/production/mcc_generated_files/system.o: Link Error: Could not allocate section .text.INTERRUPT_GlobalEnable, size = 12 PC units, attributes = code 
.ca/build/502_DEBUGActiveCA/production/mcc_generated_files/traps.o: Link Error: Could not allocate section .text.TRAPS_halt_on_error, size = 10 PC units, attributes = code 
.ca/build/502_DEBUGActiveCA/production/main.o: Link Error: Could not allocate section .text.main, size = 10 PC units, attributes = code 
.ca/build/502_DEBUGActiveCA/production/mcc_generated_files/boot/boot_process.o: Link Error: Could not allocate section .text.Reset, size = 8 PC units, attributes = code 
.ca/build/502_DEBUGActiveCA/production/mcc_generated_files/boot/boot_demo.o: Link Error: Could not allocate section .text.EnterBootloadMode, size = 8 PC units, attributes = code 
.ca/build/502_DEBUGActiveCA/production/mcc_generated_files/boot/boot_process.o: Link Error: Could not allocate section .text.BOOT_Initialize, size = 6 PC units, attributes = code 
.ca/build/502_DEBUGActiveCA/production/mcc_generated_files/boot/boot_demo.o: Link Error: Could not allocate section .text.BOOT_DEMO_Initialize, size = 6 PC units, attributes = code 
.ca/build/502_DEBUGActiveCA/production/mcc_generated_files/uart1.o: Link Error: Could not allocate section .text.UART1_Transmit_CallBack, size = 6 PC units, attributes = code 
.ca/build/502_DEBUGActiveCA/production/mcc_generated_files/uart1.o: Link Error: Could not allocate section .text.UART1_Receive_CallBack, size = 6 PC units, attributes = code 
.ca/build/502_DEBUGActiveCA/production/mcc_generated_files/boot/hardware_interrupt_table.o: Link Error: Could not allocate section .te[0m
[31mxt, size = 4 PC units, attributes = code 
.ca/build/502_DEBUGActiveCA/production/mcc_generated_files/boot/boot_process.o: Link Error: Could not allocate section .text.WriteFlash, size = 438 PC units, attributes = code 
.ca/build/502_DEBUGActiveCA/production/mcc_generated_files/boot/boot_process.o: Link Error: Could not allocate section .text.CalculateChecksum, size = 414 PC units, attributes = code 
.ca/build/502_DEBUGActiveCA/production/mcc_generated_files/boot/boot_process.o: Link Error: Could not allocate section .text.ReadFlash, size = 394 PC units, attributes = code 
.ca/build/502_DEBUGActiveCA/production/mcc_generated_files/memory/flash.o: Link Error: Could not allocate section .NVM_flash, size = 244 PC units, attributes = code 
.ca/build/502_DEBUGActiveCA/production/mcc_generated_files/boot/boot_process.o: Link Error: Could not allocate section .text.BOOT_ProcessCommand, size = 178 PC units, attributes = code 
.ca/build/502_DEBUGActiveCA/production/mcc_generated_files/pin_manager.o: Link Error: Could not allocate section .text.PIN_MANAGER_Initialize, size = 168 PC units, attributes = code 
.ca/build/502_DEBUGActiveCA/production/mcc_generated_files/clock.o: Link Error: Could not allocate section .text.CLOCK_Initialize, size = 78 PC units, attributes = code 
.ca/build/502_DEBUGActiveCA/production/mcc_generated_files/boot/boot_process.o: Link Error: Could not allocate section .text.SelfVerify, size = 76 PC units, attributes = code 
.ca/build/502_DEBUGActiveCA/production/mcc_generated_files/boot/boot_process.o: Link Error: Could not allocate section .const, size = 74 PC units, attributes = psv page 
data_init: Link Error: Could not allocate section .dinit, size = 70 PC units, attributes = code keep 
.ca/build/502_DEBUGActiveCA/production/mcc_generated_files/boot/com_adaptor_uart.o: Link Error: Could not allocate section .text.BOOT_COM_GetBytesReady, size = 66 PC units, attributes = code 
.ca/build/502_DEBUGActiveCA/production/mcc_generated_files/boot/com_adaptor_uart.o: Link Error: Could not allocate section .text.BOOT_COM_Read, size = 64 PC units, attributes = code 
.ca/build/502_DEBUGActiveCA/production/mcc_generated_files/boot/boot_demo.o: Link Error: Could not allocate section .text.BOOT_DEMO_Tasks, size = 62 PC units, attributes = code 
.ca/build/502_DEBUGActiveCA/production/mcc_generated_files/uart1.o: Link Error: Could not allocate section .text.UART1_IsTxReady, size = 60 PC units, attributes = code 
.ca/build/502_DEBUGActiveCA/production/mcc_generated_files/boot/com_adaptor_uart.o: Link Error: Could not allocate section .text.BOOT_COM_Write, size = 56 PC units, attributes = code 
.ca/build/502_DEBUGActiveCA/production/mcc_generated_files/uart1.o: Link Error: Could not allocate section .text.UART1_Initialize, size = 52 PC units, attributes = code 
.ca/build/502_DEBUGActiveCA/production/mcc_generated_files/boot/boot_verify_not_blank.o: Link Error: Could not allocate section .text.BOOT_ImageVerify, size = 50 PC units, attributes = code 
.ca/build/502_DEBUGActiveCA/production/mcc_generated_files/boot/boot_process.o: Link Error: Could not allocate section .text.ResetDevice, size = 48 PC units, attributes = code 
.ca/build/502_DEBUGActiveCA/production/mcc_generated_files/boot/boot_process.o: Link Error: Could not allocate section .text.BOOT_ImageAddressGet, size = 48 PC units, attributes = code 
.ca/build/502_DEBUGActiveCA/production/mcc_generated_files/boot/boot_process.o: Link Error: Could not allocate section .text.IsLegalRange, size = 46 PC units, attributes = code 
.ca/build/502_DEBUGActiveCA/production/mcc_generated_files/boot/boot_process.o: Link Error: Could not allocate section .text.IsLegalAddress, size = 44 PC units, attributes = code 
.ca/build/502_DEBUGActiveCA/production/mcc_generated_files/uart1.o: Link Error: Could not allocate section .text.UART1_Read, size = 44 PC units, attributes = code 
.ca/build/502_DEBUGActiveCA/production/mcc_generated_files/boot/boot_process.o: Link Error: Could not allocate section .text.CommandError, size = 42 PC units, attributes = code 
.ca/build/502_DEBUGActiveCA/production/mcc_generated_files/uart1.o: Link Error: Could not allocate section .text.UART1_Write, size = 42 PC units, attributes = code 
.ca/build/502_DEBUGActiveCA/production/mcc_generated_files/interrupt_manager.o: Link Error: Could not allocate section .text.INTERRUPT_Initialize, size = 36 PC units, attributes = code 
.ca/build/502_DEBUGActiveCA/production/mcc_generated_files/uart1.o: Link Error: Could not allocate section .text.UART1_IsTxDone, size = 34 PC units, attributes = code 
.ca/build/502_DEBUGActiveCA/production/mcc_generated_files/boot/boot_process.o: Link Error: Could not allocate section .text.ReadVersion, size = 30 PC units, attributes = code 
.ca/build/502_DEBUGActiveCA/production/mcc_generated_files/boot/boot_process.o: Link Error: Could not allocate section .text.GetMemoryAddressRange, size = 28 PC units, attributes = code 
.ca/build/502_DEBUGActiveCA/production/mcc_generated_files/boot/com_adaptor_uart.o: Link Error: Could not allocate section .text.BOOT_COM_Peek, size = 24 PC units, attributes = code 
.ca/build/502_DEBUGActiveCA/production/mcc_generated_files/uart1.o: Link Error: Could not allocate section .text.UART1_SetTxInterruptHandler, size = 24 PC units, attributes = code 
.ca/build/502_DEBUGActiveCA/production/mcc_generated_files/uart1.o: Link Error: Could not allocate section .text.UART1_SetRxInterruptHandler, size = 24 PC units, attributes = code 
.ca/build/502_DEBUGActiveCA/production/mcc_generated_files/system.o: Link Error: Could not allocate section .text.SYSTEM_Initialize, size = 22 PC units, attributes = code 
.ca/build/502_DEBUGActiveCA/production/mcc_generated_files/uart1.o: Link Error: Could not allocate section .text.UART1_IsRxReady, size = 22 PC units, attributes = code 
.ca/build/502_DEBUGActiveCA/production/mcc_generated_files/system.o: Link Error: Could not allocate section .text.SYSTEM_CORCONModeOperatingSet, size = 18 PC units, attributes = code 
.ca/build/502_DEBUGActiveCA/production/mcc_generated_files/boot/boot_process.o: Link Error: Could not allocate section .text.BOOT_StartApplication, size = 14 PC units, attributes = code 
.ca/build/502_DEBUGActiveCA/production/mcc_generated_files/traps.o: Link Error: Could not allocate section .text.use_failsafe_stack, size = 14 PC units, attributes = code 
.ca/build/502_DEBUGActiveCA/production/mcc_generated_files/system.o: Link Error: Could not allocate section .text.INTERRUPT_GlobalEnable, size = 12 PC units, attributes = code 
.ca/build/502_DEBUGActiveCA/production/mcc_generated_files/traps.o: Link Error: Could not allocate section .text.TRAPS_halt_on_error, size = 10 PC units, attributes = code 
.ca/build/502_DEBUGActiveCA/production/main.o: Link Error: Could not allocate section .text.main, size = 10 PC units, attributes = code 
.ca/build/502_DEBUGActiveCA/production/mcc_generated_files/boot/boot_process.o: Link Error: Could not allocate section .text.Reset, size = 8 PC units, attributes = code 
.ca/build/502_DEBUGActiveCA/production/mcc_generated_files/boot/boot_demo.o: Link Error: Could not allocate section .text.EnterBootloadMode, size = 8 PC units, attributes = code 
.ca/build/502_DEBUGActiveCA/production/mcc_generated_files/boot/boot_process.o: Link Error: Could not allocate section .text.BOOT_Initialize, size = 6 PC units, attributes = code 
.ca/build/502_DEBUGActiveCA/production/mcc_generated_files/boot/boot_demo.o: Link Error: Could not allocate section .text.BOOT_DEMO_Initialize, size = 6 PC units, attributes = code 
.ca/build/502_DEBUGActiveCA/production/mcc_generated_files/uart1.o: Link Error: Could not allocate section .text.UART1_Transmit_CallBack, size = 6 PC units, attributes = code 
.ca/build/502_DEBUGActiveCA/production/mcc_generated_files/uart1.o: Link Error: Could not allocate section .text.UART1_Receive_CallBack, size = 6 PC units, attributes = code 
.ca/build/502_DEBUGActiveCA/production/mcc_generated_files/boot/hardware_interrupt_table.o: Link Error: Could not allocate section .text, size = 4 PC units, attributes = code 
.ca/build/502_DEBUGActiveCA/production/mcc_generated_files/boot/boot_process.o: Link Error: C[0m
[31mould not allocate section .text.CalculateChecksum, size = 414 PC units, attributes = code 
.ca/build/502_DEBUGActiveCA/production/mcc_generated_files/boot/boot_process.o: Link Error: Could not allocate section .text.ReadFlash, size = 394 PC units, attributes = code 
.ca/build/502_DEBUGActiveCA/production/mcc_generated_files/memory/flash.o: Link Error: Could not allocate section .NVM_flash, size = 244 PC units, attributes = code 
.ca/build/502_DEBUGActiveCA/production/mcc_generated_files/boot/boot_process.o: Link Error: Could not allocate section .text.BOOT_ProcessCommand, size = 178 PC units, attributes = code 
.ca/build/502_DEBUGActiveCA/production/mcc_generated_files/pin_manager.o: Link Error: Could not allocate section .text.PIN_MANAGER_Initialize, size = 168 PC units, attributes = code 
.ca/build/502_DEBUGActiveCA/production/mcc_generated_files/clock.o: Link Error: Could not allocate section .text.CLOCK_Initialize, size = 78 PC units, attributes = code 
.ca/build/502_DEBUGActiveCA/production/mcc_generated_files/boot/boot_process.o: Link Error: Could not allocate section .text.SelfVerify, size = 76 PC units, attributes = code 
.ca/build/502_DEBUGActiveCA/production/mcc_generated_files/boot/boot_process.o: Link Error: Could not allocate section .const, size = 74 PC units, attributes = psv page 
data_init: Link Error: Could not allocate section .dinit, size = 70 PC units, attributes = code keep 
.ca/build/502_DEBUGActiveCA/production/mcc_generated_files/boot/com_adaptor_uart.o: Link Error: Could not allocate section .text.BOOT_COM_GetBytesReady, size = 66 PC units, attributes = code 
.ca/build/502_DEBUGActiveCA/production/mcc_generated_files/boot/com_adaptor_uart.o: Link Error: Could not allocate section .text.BOOT_COM_Read, size = 64 PC units, attributes = code 
.ca/build/502_DEBUGActiveCA/production/mcc_generated_files/boot/boot_demo.o: Link Error: Could not allocate section .text.BOOT_DEMO_Tasks, size = 62 PC units, attributes = code 
.ca/build/502_DEBUGActiveCA/production/mcc_generated_files/uart1.o: Link Error: Could not allocate section .text.UART1_IsTxReady, size = 60 PC units, attributes = code 
.ca/build/502_DEBUGActiveCA/production/mcc_generated_files/boot/com_adaptor_uart.o: Link Error: Could not allocate section .text.BOOT_COM_Write, size = 56 PC units, attributes = code 
.ca/build/502_DEBUGActiveCA/production/mcc_generated_files/uart1.o: Link Error: Could not allocate section .text.UART1_Initialize, size = 52 PC units, attributes = code 
.ca/build/502_DEBUGActiveCA/production/mcc_generated_files/boot/boot_verify_not_blank.o: Link Error: Could not allocate section .text.BOOT_ImageVerify, size = 50 PC units, attributes = code 
.ca/build/502_DEBUGActiveCA/production/mcc_generated_files/boot/boot_process.o: Link Error: Could not allocate section .text.ResetDevice, size = 48 PC units, attributes = code 
.ca/build/502_DEBUGActiveCA/production/mcc_generated_files/boot/boot_process.o: Link Error: Could not allocate section .text.BOOT_ImageAddressGet, size = 48 PC units, attributes = code 
.ca/build/502_DEBUGActiveCA/production/mcc_generated_files/boot/boot_process.o: Link Error: Could not allocate section .text.IsLegalRange, size = 46 PC units, attributes = code 
.ca/build/502_DEBUGActiveCA/production/mcc_generated_files/boot/boot_process.o: Link Error: Could not allocate section .text.IsLegalAddress, size = 44 PC units, attributes = code 
.ca/build/502_DEBUGActiveCA/production/mcc_generated_files/uart1.o: Link Error: Could not allocate section .text.UART1_Read, size = 44 PC units, attributes = code 
.ca/build/502_DEBUGActiveCA/production/mcc_generated_files/boot/boot_process.o: Link Error: Could not allocate section .text.CommandError, size = 42 PC units, attributes = code 
.ca/build/502_DEBUGActiveCA/production/mcc_generated_files/uart1.o: Link Error: Could not allocate section .text.UART1_Write, size = 42 PC units, attributes = code 
.ca/build/502_DEBUGActiveCA/production/mcc_generated_files/interrupt_manager.o: Link Error: Could not allocate section .text.INTERRUPT_Initialize, size = 36 PC units, attributes = code 
.ca/build/502_DEBUGActiveCA/production/mcc_generated_files/uart1.o: Link Error: Could not allocate section .text.UART1_IsTxDone, size = 34 PC units, attributes = code 
.ca/build/502_DEBUGActiveCA/production/mcc_generated_files/boot/boot_process.o: Link Error: Could not allocate section .text.ReadVersion, size = 30 PC units, attributes = code 
.ca/build/502_DEBUGActiveCA/production/mcc_generated_files/boot/boot_process.o: Link Error: Could not allocate section .text.GetMemoryAddressRange, size = 28 PC units, attributes = code 
.ca/build/502_DEBUGActiveCA/production/mcc_generated_files/boot/com_adaptor_uart.o: Link Error: Could not allocate section .text.BOOT_COM_Peek, size = 24 PC units, attributes = code 
.ca/build/502_DEBUGActiveCA/production/mcc_generated_files/uart1.o: Link Error: Could not allocate section .text.UART1_SetTxInterruptHandler, size = 24 PC units, attributes = code 
.ca/build/502_DEBUGActiveCA/production/mcc_generated_files/uart1.o: Link Error: Could not allocate section .text.UART1_SetRxInterruptHandler, size = 24 PC units, attributes = code 
.ca/build/502_DEBUGActiveCA/production/mcc_generated_files/system.o: Link Error: Could not allocate section .text.SYSTEM_Initialize, size = 22 PC units, attributes = code 
.ca/build/502_DEBUGActiveCA/production/mcc_generated_files/uart1.o: Link Error: Could not allocate section .text.UART1_IsRxReady, size = 22 PC units, attributes = code 
.ca/build/502_DEBUGActiveCA/production/mcc_generated_files/system.o: Link Error: Could not allocate section .text.SYSTEM_CORCONModeOperatingSet, size = 18 PC units, attributes = code 
.ca/build/502_DEBUGActiveCA/production/mcc_generated_files/boot/boot_process.o: Link Error: Could not allocate section .text.BOOT_StartApplication, size = 14 PC units, attributes = code 
.ca/build/502_DEBUGActiveCA/production/mcc_generated_files/traps.o: Link Error: Could not allocate section .text.use_failsafe_stack, size = 14 PC units, attributes = code 
.ca/build/502_DEBUGActiveCA/production/mcc_generated_files/system.o: Link Error: Could not allocate section .text.INTERRUPT_GlobalEnable, size = 12 PC units, attributes = code 
.ca/build/502_DEBUGActiveCA/production/mcc_generated_files/traps.o: Link Error: Could not allocate section .text.TRAPS_halt_on_error, size = 10 PC units, attributes = code 
.ca/build/502_DEBUGActiveCA/production/main.o: Link Error: Could not allocate section .text.main, size = 10 PC units, attributes = code 
.ca/build/502_DEBUGActiveCA/production/mcc_generated_files/boot/boot_process.o: Link Error: Could not allocate section .text.Reset, size = 8 PC units, attributes = code 
.ca/build/502_DEBUGActiveCA/production/mcc_generated_files/boot/boot_demo.o: Link Error: Could not allocate section .text.EnterBootloadMode, size = 8 PC units, attributes = code 
.ca/build/502_DEBUGActiveCA/production/mcc_generated_files/boot/boot_process.o: Link Error: Could not allocate section .text.BOOT_Initialize, size = 6 PC units, attributes = code 
.ca/build/502_DEBUGActiveCA/production/mcc_generated_files/boot/boot_demo.o: Link Error: Could not allocate section .text.BOOT_DEMO_Initialize, size = 6 PC units, attributes = code 
.ca/build/502_DEBUGActiveCA/production/mcc_generated_files/uart1.o: Link Error: Could not allocate section .text.UART1_Transmit_CallBack, size = 6 PC units, attributes = code 
.ca/build/502_DEBUGActiveCA/production/mcc_generated_files/uart1.o: Link Error: Could not allocate section .text.UART1_Receive_CallBack, size = 6 PC units, attributes = code 
.ca/build/502_DEBUGActiveCA/production/mcc_generated_files/boot/hardware_interrupt_table.o: Link Error: Could not allocate section .text, size = 4 PC units, attributes = code 
.ca/build/502_DEBUGActiveCA/production/mcc_generated_files/boot/boot_process.o: Link Error: Could not allocate section .text.ReadFlash, size = 394 PC units, attributes = code 
.ca/build/502_DEBUGActiveCA/production/mcc_generated_files/memory/flash.o: Link Error: Could not allocate section .NVM_flash, size = 244 PC units, attributes = code 
.ca/build/502_DEBUGActiveCA/production/mcc_generated_files/boot[0m
[31m/boot_process.o: Link Error: Could not allocate section .text.BOOT_ProcessCommand, size = 178 PC units, attributes = code 
.ca/build/502_DEBUGActiveCA/production/mcc_generated_files/pin_manager.o: Link Error: Could not allocate section .text.PIN_MANAGER_Initialize, size = 168 PC units, attributes = code 
.ca/build/502_DEBUGActiveCA/production/mcc_generated_files/clock.o: Link Error: Could not allocate section .text.CLOCK_Initialize, size = 78 PC units, attributes = code 
.ca/build/502_DEBUGActiveCA/production/mcc_generated_files/boot/boot_process.o: Link Error: Could not allocate section .text.SelfVerify, size = 76 PC units, attributes = code 
.ca/build/502_DEBUGActiveCA/production/mcc_generated_files/boot/boot_process.o: Link Error: Could not allocate section .const, size = 74 PC units, attributes = psv page 
data_init: Link Error: Could not allocate section .dinit, size = 70 PC units, attributes = code keep 
.ca/build/502_DEBUGActiveCA/production/mcc_generated_files/boot/com_adaptor_uart.o: Link Error: Could not allocate section .text.BOOT_COM_GetBytesReady, size = 66 PC units, attributes = code 
.ca/build/502_DEBUGActiveCA/production/mcc_generated_files/boot/com_adaptor_uart.o: Link Error: Could not allocate section .text.BOOT_COM_Read, size = 64 PC units, attributes = code 
.ca/build/502_DEBUGActiveCA/production/mcc_generated_files/boot/boot_demo.o: Link Error: Could not allocate section .text.BOOT_DEMO_Tasks, size = 62 PC units, attributes = code 
.ca/build/502_DEBUGActiveCA/production/mcc_generated_files/uart1.o: Link Error: Could not allocate section .text.UART1_IsTxReady, size = 60 PC units, attributes = code 
.ca/build/502_DEBUGActiveCA/production/mcc_generated_files/boot/com_adaptor_uart.o: Link Error: Could not allocate section .text.BOOT_COM_Write, size = 56 PC units, attributes = code 
.ca/build/502_DEBUGActiveCA/production/mcc_generated_files/uart1.o: Link Error: Could not allocate section .text.UART1_Initialize, size = 52 PC units, attributes = code 
.ca/build/502_DEBUGActiveCA/production/mcc_generated_files/boot/boot_verify_not_blank.o: Link Error: Could not allocate section .text.BOOT_ImageVerify, size = 50 PC units, attributes = code 
.ca/build/502_DEBUGActiveCA/production/mcc_generated_files/boot/boot_process.o: Link Error: Could not allocate section .text.ResetDevice, size = 48 PC units, attributes = code 
.ca/build/502_DEBUGActiveCA/production/mcc_generated_files/boot/boot_process.o: Link Error: Could not allocate section .text.BOOT_ImageAddressGet, size = 48 PC units, attributes = code 
.ca/build/502_DEBUGActiveCA/production/mcc_generated_files/boot/boot_process.o: Link Error: Could not allocate section .text.IsLegalRange, size = 46 PC units, attributes = code 
.ca/build/502_DEBUGActiveCA/production/mcc_generated_files/boot/boot_process.o: Link Error: Could not allocate section .text.IsLegalAddress, size = 44 PC units, attributes = code 
.ca/build/502_DEBUGActiveCA/production/mcc_generated_files/uart1.o: Link Error: Could not allocate section .text.UART1_Read, size = 44 PC units, attributes = code 
.ca/build/502_DEBUGActiveCA/production/mcc_generated_files/boot/boot_process.o: Link Error: Could not allocate section .text.CommandError, size = 42 PC units, attributes = code 
.ca/build/502_DEBUGActiveCA/production/mcc_generated_files/uart1.o: Link Error: Could not allocate section .text.UART1_Write, size = 42 PC units, attributes = code 
.ca/build/502_DEBUGActiveCA/production/mcc_generated_files/interrupt_manager.o: Link Error: Could not allocate section .text.INTERRUPT_Initialize, size = 36 PC units, attributes = code 
.ca/build/502_DEBUGActiveCA/production/mcc_generated_files/uart1.o: Link Error: Could not allocate section .text.UART1_IsTxDone, size = 34 PC units, attributes = code 
.ca/build/502_DEBUGActiveCA/production/mcc_generated_files/boot/boot_process.o: Link Error: Could not allocate section .text.ReadVersion, size = 30 PC units, attributes = code 
.ca/build/502_DEBUGActiveCA/production/mcc_generated_files/boot/boot_process.o: Link Error: Could not allocate section .text.GetMemoryAddressRange, size = 28 PC units, attributes = code 
.ca/build/502_DEBUGActiveCA/production/mcc_generated_files/boot/com_adaptor_uart.o: Link Error: Could not allocate section .text.BOOT_COM_Peek, size = 24 PC units, attributes = code 
.ca/build/502_DEBUGActiveCA/production/mcc_generated_files/uart1.o: Link Error: Could not allocate section .text.UART1_SetTxInterruptHandler, size = 24 PC units, attributes = code 
.ca/build/502_DEBUGActiveCA/production/mcc_generated_files/uart1.o: Link Error: Could not allocate section .text.UART1_SetRxInterruptHandler, size = 24 PC units, attributes = code 
.ca/build/502_DEBUGActiveCA/production/mcc_generated_files/system.o: Link Error: Could not allocate section .text.SYSTEM_Initialize, size = 22 PC units, attributes = code 
.ca/build/502_DEBUGActiveCA/production/mcc_generated_files/uart1.o: Link Error: Could not allocate section .text.UART1_IsRxReady, size = 22 PC units, attributes = code 
.ca/build/502_DEBUGActiveCA/production/mcc_generated_files/system.o: Link Error: Could not allocate section .text.SYSTEM_CORCONModeOperatingSet, size = 18 PC units, attributes = code 
.ca/build/502_DEBUGActiveCA/production/mcc_generated_files/boot/boot_process.o: Link Error: Could not allocate section .text.BOOT_StartApplication, size = 14 PC units, attributes = code 
.ca/build/502_DEBUGActiveCA/production/mcc_generated_files/traps.o: Link Error: Could not allocate section .text.use_failsafe_stack, size = 14 PC units, attributes = code 
.ca/build/502_DEBUGActiveCA/production/mcc_generated_files/system.o: Link Error: Could not allocate section .text.INTERRUPT_GlobalEnable, size = 12 PC units, attributes = code 
.ca/build/502_DEBUGActiveCA/production/mcc_generated_files/traps.o: Link Error: Could not allocate section .text.TRAPS_halt_on_error, size = 10 PC units, attributes = code 
.ca/build/502_DEBUGActiveCA/production/main.o: Link Error: Could not allocate section .text.main, size = 10 PC units, attributes = code 
.ca/build/502_DEBUGActiveCA/production/mcc_generated_files/boot/boot_process.o: Link Error: Could not allocate section .text.Reset, size = 8 PC units, attributes = code 
.ca/build/502_DEBUGActiveCA/production/mcc_generated_files/boot/boot_demo.o: Link Error: Could not allocate section .text.EnterBootloadMode, size = 8 PC units, attributes = code 
.ca/build/502_DEBUGActiveCA/production/mcc_generated_files/boot/boot_process.o: Link Error: Could not allocate section .text.BOOT_Initialize, size = 6 PC units, attributes = code 
.ca/build/502_DEBUGActiveCA/production/mcc_generated_files/boot/boot_demo.o: Link Error: Could not allocate section .text.BOOT_DEMO_Initialize, size = 6 PC units, attributes = code 
.ca/build/502_DEBUGActiveCA/production/mcc_generated_files/uart1.o: Link Error: Could not allocate section .text.UART1_Transmit_CallBack, size = 6 PC units, attributes = code 
.ca/build/502_DEBUGActiveCA/production/mcc_generated_files/uart1.o: Link Error: Could not allocate section .text.UART1_Receive_CallBack, size = 6 PC units, attributes = code 
.ca/build/502_DEBUGActiveCA/production/mcc_generated_files/boot/hardware_interrupt_table.o: Link Error: Could not allocate section .text, size = 4 PC units, attributes = code 
.ca/build/502_DEBUGActiveCA/production/mcc_generated_files/boot/boot_process.o: Link Error: Could not allocate section .text.BOOT_ProcessCommand, size = 178 PC units, attributes = code 
.ca/build/502_DEBUGActiveCA/production/mcc_generated_files/pin_manager.o: Link Error: Could not allocate section .text.PIN_MANAGER_Initialize, size = 168 PC units, attributes = code 
.ca/build/502_DEBUGActiveCA/production/mcc_generated_files/clock.o: Link Error: Could not allocate section .text.CLOCK_Initialize, size = 78 PC units, attributes = code 
.ca/build/502_DEBUGActiveCA/production/mcc_generated_files/boot/boot_process.o: Link Error: Could not allocate section .text.SelfVerify, size = 76 PC units, attributes = code 
.ca/build/502_DEBUGActiveCA/production/mcc_generated_files/boot/boot_process.o: Link Error: Could not allocate section .const, size = 74 PC units, attributes = psv page 
data_init: Link [0m
[31mError: Could not allocate section .dinit, size = 70 PC units, attributes = code keep 
.ca/build/502_DEBUGActiveCA/production/mcc_generated_files/boot/com_adaptor_uart.o: Link Error: Could not allocate section .text.BOOT_COM_GetBytesReady, size = 66 PC units, attributes = code 
.ca/build/502_DEBUGActiveCA/production/mcc_generated_files/boot/com_adaptor_uart.o: Link Error: Could not allocate section .text.BOOT_COM_Read, size = 64 PC units, attributes = code 
.ca/build/502_DEBUGActiveCA/production/mcc_generated_files/boot/boot_demo.o: Link Error: Could not allocate section .text.BOOT_DEMO_Tasks, size = 62 PC units, attributes = code 
.ca/build/502_DEBUGActiveCA/production/mcc_generated_files/uart1.o: Link Error: Could not allocate section .text.UART1_IsTxReady, size = 60 PC units, attributes = code 
.ca/build/502_DEBUGActiveCA/production/mcc_generated_files/boot/com_adaptor_uart.o: Link Error: Could not allocate section .text.BOOT_COM_Write, size = 56 PC units, attributes = code 
.ca/build/502_DEBUGActiveCA/production/mcc_generated_files/uart1.o: Link Error: Could not allocate section .text.UART1_Initialize, size = 52 PC units, attributes = code 
.ca/build/502_DEBUGActiveCA/production/mcc_generated_files/boot/boot_verify_not_blank.o: Link Error: Could not allocate section .text.BOOT_ImageVerify, size = 50 PC units, attributes = code 
.ca/build/502_DEBUGActiveCA/production/mcc_generated_files/boot/boot_process.o: Link Error: Could not allocate section .text.ResetDevice, size = 48 PC units, attributes = code 
.ca/build/502_DEBUGActiveCA/production/mcc_generated_files/boot/boot_process.o: Link Error: Could not allocate section .text.BOOT_ImageAddressGet, size = 48 PC units, attributes = code 
.ca/build/502_DEBUGActiveCA/production/mcc_generated_files/boot/boot_process.o: Link Error: Could not allocate section .text.IsLegalRange, size = 46 PC units, attributes = code 
.ca/build/502_DEBUGActiveCA/production/mcc_generated_files/boot/boot_process.o: Link Error: Could not allocate section .text.IsLegalAddress, size = 44 PC units, attributes = code 
.ca/build/502_DEBUGActiveCA/production/mcc_generated_files/uart1.o: Link Error: Could not allocate section .text.UART1_Read, size = 44 PC units, attributes = code 
.ca/build/502_DEBUGActiveCA/production/mcc_generated_files/boot/boot_process.o: Link Error: Could not allocate section .text.CommandError, size = 42 PC units, attributes = code 
.ca/build/502_DEBUGActiveCA/production/mcc_generated_files/uart1.o: Link Error: Could not allocate section .text.UART1_Write, size = 42 PC units, attributes = code 
.ca/build/502_DEBUGActiveCA/production/mcc_generated_files/interrupt_manager.o: Link Error: Could not allocate section .text.INTERRUPT_Initialize, size = 36 PC units, attributes = code 
.ca/build/502_DEBUGActiveCA/production/mcc_generated_files/uart1.o: Link Error: Could not allocate section .text.UART1_IsTxDone, size = 34 PC units, attributes = code 
.ca/build/502_DEBUGActiveCA/production/mcc_generated_files/boot/boot_process.o: Link Error: Could not allocate section .text.ReadVersion, size = 30 PC units, attributes = code 
.ca/build/502_DEBUGActiveCA/production/mcc_generated_files/boot/boot_process.o: Link Error: Could not allocate section .text.GetMemoryAddressRange, size = 28 PC units, attributes = code 
.ca/build/502_DEBUGActiveCA/production/mcc_generated_files/boot/com_adaptor_uart.o: Link Error: Could not allocate section .text.BOOT_COM_Peek, size = 24 PC units, attributes = code 
.ca/build/502_DEBUGActiveCA/production/mcc_generated_files/uart1.o: Link Error: Could not allocate section .text.UART1_SetTxInterruptHandler, size = 24 PC units, attributes = code 
.ca/build/502_DEBUGActiveCA/production/mcc_generated_files/uart1.o: Link Error: Could not allocate section .text.UART1_SetRxInterruptHandler, size = 24 PC units, attributes = code 
.ca/build/502_DEBUGActiveCA/production/mcc_generated_files/system.o: Link Error: Could not allocate section .text.SYSTEM_Initialize, size = 22 PC units, attributes = code 
.ca/build/502_DEBUGActiveCA/production/mcc_generated_files/uart1.o: Link Error: Could not allocate section .text.UART1_IsRxReady, size = 22 PC units, attributes = code 
.ca/build/502_DEBUGActiveCA/production/mcc_generated_files/system.o: Link Error: Could not allocate section .text.SYSTEM_CORCONModeOperatingSet, size = 18 PC units, attributes = code 
.ca/build/502_DEBUGActiveCA/production/mcc_generated_files/boot/boot_process.o: Link Error: Could not allocate section .text.BOOT_StartApplication, size = 14 PC units, attributes = code 
.ca/build/502_DEBUGActiveCA/production/mcc_generated_files/traps.o: Link Error: Could not allocate section .text.use_failsafe_stack, size = 14 PC units, attributes = code 
.ca/build/502_DEBUGActiveCA/production/mcc_generated_files/system.o: Link Error: Could not allocate section .text.INTERRUPT_GlobalEnable, size = 12 PC units, attributes = code 
.ca/build/502_DEBUGActiveCA/production/mcc_generated_files/traps.o: Link Error: Could not allocate section .text.TRAPS_halt_on_error, size = 10 PC units, attributes = code 
.ca/build/502_DEBUGActiveCA/production/main.o: Link Error: Could not allocate section .text.main, size = 10 PC units, attributes = code 
.ca/build/502_DEBUGActiveCA/production/mcc_generated_files/boot/boot_process.o: Link Error: Could not allocate section .text.Reset, size = 8 PC units, attributes = code 
.ca/build/502_DEBUGActiveCA/production/mcc_generated_files/boot/boot_demo.o: Link Error: Could not allocate section .text.EnterBootloadMode, size = 8 PC units, attributes = code 
.ca/build/502_DEBUGActiveCA/production/mcc_generated_files/boot/boot_process.o: Link Error: Could not allocate section .text.BOOT_Initialize, size = 6 PC units, attributes = code 
.ca/build/502_DEBUGActiveCA/production/mcc_generated_files/boot/boot_demo.o: Link Error: Could not allocate section .text.BOOT_DEMO_Initialize, size = 6 PC units, attributes = code 
.ca/build/502_DEBUGActiveCA/production/mcc_generated_files/uart1.o: Link Error: Could not allocate section .text.UART1_Transmit_CallBack, size = 6 PC units, attributes = code 
.ca/build/502_DEBUGActiveCA/production/mcc_generated_files/uart1.o: Link Error: Could not allocate section .text.UART1_Receive_CallBack, size = 6 PC units, attributes = code 
.ca/build/502_DEBUGActiveCA/production/mcc_generated_files/boot/hardware_interrupt_table.o: Link Error: Could not allocate section .text, size = 4 PC units, attributes = code 
.ca/build/502_DEBUGActiveCA/production/mcc_generated_files/pin_manager.o: Link Error: Could not allocate section .text.PIN_MANAGER_Initialize, size = 168 PC units, attributes = code 
.ca/build/502_DEBUGActiveCA/production/mcc_generated_files/clock.o: Link Error: Could not allocate section .text.CLOCK_Initialize, size = 78 PC units, attributes = code 
.ca/build/502_DEBUGActiveCA/production/mcc_generated_files/boot/boot_process.o: Link Error: Could not allocate section .text.SelfVerify, size = 76 PC units, attributes = code 
.ca/build/502_DEBUGActiveCA/production/mcc_generated_files/boot/boot_process.o: Link Error: Could not allocate section .const, size = 74 PC units, attributes = psv page 
data_init: Link Error: Could not allocate section .dinit, size = 70 PC units, attributes = code keep 
.ca/build/502_DEBUGActiveCA/production/mcc_generated_files/boot/com_adaptor_uart.o: Link Error: Could not allocate section .text.BOOT_COM_GetBytesReady, size = 66 PC units, attributes = code 
.ca/build/502_DEBUGActiveCA/production/mcc_generated_files/boot/com_adaptor_uart.o: Link Error: Could not allocate section .text.BOOT_COM_Read, size = 64 PC units, attributes = code 
.ca/build/502_DEBUGActiveCA/production/mcc_generated_files/boot/boot_demo.o: Link Error: Could not allocate section .text.BOOT_DEMO_Tasks, size = 62 PC units, attributes = code 
.ca/build/502_DEBUGActiveCA/production/mcc_generated_files/uart1.o: Link Error: Could not allocate section .text.UART1_IsTxReady, size = 60 PC units, attributes = code 
.ca/build/502_DEBUGActiveCA/production/mcc_generated_files/boot/com_adaptor_uart.o: Link Error: Could not allocate section .text.BOOT_COM_Write, size = 56 PC units, attributes = code 
.ca/build/502_DEBUGActiveCA/prod[0m
[31muction/mcc_generated_files/uart1.o: Link Error: Could not allocate section .text.UART1_Initialize, size = 52 PC units, attributes = code 
.ca/build/502_DEBUGActiveCA/production/mcc_generated_files/boot/boot_verify_not_blank.o: Link Error: Could not allocate section .text.BOOT_ImageVerify, size = 50 PC units, attributes = code 
.ca/build/502_DEBUGActiveCA/production/mcc_generated_files/boot/boot_process.o: Link Error: Could not allocate section .text.ResetDevice, size = 48 PC units, attributes = code 
.ca/build/502_DEBUGActiveCA/production/mcc_generated_files/boot/boot_process.o: Link Error: Could not allocate section .text.BOOT_ImageAddressGet, size = 48 PC units, attributes = code 
.ca/build/502_DEBUGActiveCA/production/mcc_generated_files/boot/boot_process.o: Link Error: Could not allocate section .text.IsLegalRange, size = 46 PC units, attributes = code 
.ca/build/502_DEBUGActiveCA/production/mcc_generated_files/boot/boot_process.o: Link Error: Could not allocate section .text.IsLegalAddress, size = 44 PC units, attributes = code 
.ca/build/502_DEBUGActiveCA/production/mcc_generated_files/uart1.o: Link Error: Could not allocate section .text.UART1_Read, size = 44 PC units, attributes = code 
.ca/build/502_DEBUGActiveCA/production/mcc_generated_files/boot/boot_process.o: Link Error: Could not allocate section .text.CommandError, size = 42 PC units, attributes = code 
.ca/build/502_DEBUGActiveCA/production/mcc_generated_files/uart1.o: Link Error: Could not allocate section .text.UART1_Write, size = 42 PC units, attributes = code 
.ca/build/502_DEBUGActiveCA/production/mcc_generated_files/interrupt_manager.o: Link Error: Could not allocate section .text.INTERRUPT_Initialize, size = 36 PC units, attributes = code 
.ca/build/502_DEBUGActiveCA/production/mcc_generated_files/uart1.o: Link Error: Could not allocate section .text.UART1_IsTxDone, size = 34 PC units, attributes = code 
.ca/build/502_DEBUGActiveCA/production/mcc_generated_files/boot/boot_process.o: Link Error: Could not allocate section .text.ReadVersion, size = 30 PC units, attributes = code 
.ca/build/502_DEBUGActiveCA/production/mcc_generated_files/boot/boot_process.o: Link Error: Could not allocate section .text.GetMemoryAddressRange, size = 28 PC units, attributes = code 
.ca/build/502_DEBUGActiveCA/production/mcc_generated_files/boot/com_adaptor_uart.o: Link Error: Could not allocate section .text.BOOT_COM_Peek, size = 24 PC units, attributes = code 
.ca/build/502_DEBUGActiveCA/production/mcc_generated_files/uart1.o: Link Error: Could not allocate section .text.UART1_SetTxInterruptHandler, size = 24 PC units, attributes = code 
.ca/build/502_DEBUGActiveCA/production/mcc_generated_files/uart1.o: Link Error: Could not allocate section .text.UART1_SetRxInterruptHandler, size = 24 PC units, attributes = code 
.ca/build/502_DEBUGActiveCA/production/mcc_generated_files/system.o: Link Error: Could not allocate section .text.SYSTEM_Initialize, size = 22 PC units, attributes = code 
.ca/build/502_DEBUGActiveCA/production/mcc_generated_files/uart1.o: Link Error: Could not allocate section .text.UART1_IsRxReady, size = 22 PC units, attributes = code 
.ca/build/502_DEBUGActiveCA/production/mcc_generated_files/system.o: Link Error: Could not allocate section .text.SYSTEM_CORCONModeOperatingSet, size = 18 PC units, attributes = code 
.ca/build/502_DEBUGActiveCA/production/mcc_generated_files/boot/boot_process.o: Link Error: Could not allocate section .text.BOOT_StartApplication, size = 14 PC units, attributes = code 
.ca/build/502_DEBUGActiveCA/production/mcc_generated_files/traps.o: Link Error: Could not allocate section .text.use_failsafe_stack, size = 14 PC units, attributes = code 
.ca/build/502_DEBUGActiveCA/production/mcc_generated_files/system.o: Link Error: Could not allocate section .text.INTERRUPT_GlobalEnable, size = 12 PC units, attributes = code 
.ca/build/502_DEBUGActiveCA/production/mcc_generated_files/traps.o: Link Error: Could not allocate section .text.TRAPS_halt_on_error, size = 10 PC units, attributes = code 
.ca/build/502_DEBUGActiveCA/production/main.o: Link Error: Could not allocate section .text.main, size = 10 PC units, attributes = code 
.ca/build/502_DEBUGActiveCA/production/mcc_generated_files/boot/boot_process.o: Link Error: Could not allocate section .text.Reset, size = 8 PC units, attributes = code 
.ca/build/502_DEBUGActiveCA/production/mcc_generated_files/boot/boot_demo.o: Link Error: Could not allocate section .text.EnterBootloadMode, size = 8 PC units, attributes = code 
.ca/build/502_DEBUGActiveCA/production/mcc_generated_files/boot/boot_process.o: Link Error: Could not allocate section .text.BOOT_Initialize, size = 6 PC units, attributes = code 
.ca/build/502_DEBUGActiveCA/production/mcc_generated_files/boot/boot_demo.o: Link Error: Could not allocate section .text.BOOT_DEMO_Initialize, size = 6 PC units, attributes = code 
.ca/build/502_DEBUGActiveCA/production/mcc_generated_files/uart1.o: Link Error: Could not allocate section .text.UART1_Transmit_CallBack, size = 6 PC units, attributes = code 
.ca/build/502_DEBUGActiveCA/production/mcc_generated_files/uart1.o: Link Error: Could not allocate section .text.UART1_Receive_CallBack, size = 6 PC units, attributes = code 
.ca/build/502_DEBUGActiveCA/production/mcc_generated_files/boot/hardware_interrupt_table.o: Link Error: Could not allocate section .text, size = 4 PC units, attributes = code 
.ca/build/502_DEBUGActiveCA/production/mcc_generated_files/boot/boot_process.o: Link Error: Could not allocate section .text.SelfVerify, size = 76 PC units, attributes = code 
.ca/build/502_DEBUGActiveCA/production/mcc_generated_files/boot/boot_process.o: Link Error: Could not allocate section .const, size = 74 PC units, attributes = psv page 
data_init: Link Error: Could not allocate section .dinit, size = 70 PC units, attributes = code keep 
.ca/build/502_DEBUGActiveCA/production/mcc_generated_files/boot/com_adaptor_uart.o: Link Error: Could not allocate section .text.BOOT_COM_GetBytesReady, size = 66 PC units, attributes = code 
.ca/build/502_DEBUGActiveCA/production/mcc_generated_files/boot/com_adaptor_uart.o: Link Error: Could not allocate section .text.BOOT_COM_Read, size = 64 PC units, attributes = code 
.ca/build/502_DEBUGActiveCA/production/mcc_generated_files/boot/boot_demo.o: Link Error: Could not allocate section .text.BOOT_DEMO_Tasks, size = 62 PC units, attributes = code 
.ca/build/502_DEBUGActiveCA/production/mcc_generated_files/uart1.o: Link Error: Could not allocate section .text.UART1_IsTxReady, size = 60 PC units, attributes = code 
.ca/build/502_DEBUGActiveCA/production/mcc_generated_files/boot/com_adaptor_uart.o: Link Error: Could not allocate section .text.BOOT_COM_Write, size = 56 PC units, attributes = code 
.ca/build/502_DEBUGActiveCA/production/mcc_generated_files/uart1.o: Link Error: Could not allocate section .text.UART1_Initialize, size = 52 PC units, attributes = code 
.ca/build/502_DEBUGActiveCA/production/mcc_generated_files/boot/boot_verify_not_blank.o: Link Error: Could not allocate section .text.BOOT_ImageVerify, size = 50 PC units, attributes = code 
.ca/build/502_DEBUGActiveCA/production/mcc_generated_files/boot/boot_process.o: Link Error: Could not allocate section .text.ResetDevice, size = 48 PC units, attributes = code 
.ca/build/502_DEBUGActiveCA/production/mcc_generated_files/boot/boot_process.o: Link Error: Could not allocate section .text.BOOT_ImageAddressGet, size = 48 PC units, attributes = code 
.ca/build/502_DEBUGActiveCA/production/mcc_generated_files/boot/boot_process.o: Link Error: Could not allocate section .text.IsLegalRange, size = 46 PC units, attributes = code 
.ca/build/502_DEBUGActiveCA/production/mcc_generated_files/boot/boot_process.o: Link Error: Could not allocate section .text.IsLegalAddress, size = 44 PC units, attributes = code 
.ca/build/502_DEBUGActiveCA/production/mcc_generated_files/uart1.o: Link Error: Could not allocate section .text.UART1_Read, size = 44 PC units, attributes = code 
.ca/build/502_DEBUGActiveCA/production/mcc_generated_files/boot/boot_process.o: Link Error: Could not allocate section .text.CommandError, size = 42 PC units, attr[0m
[31mibutes = code 
.ca/build/502_DEBUGActiveCA/production/mcc_generated_files/uart1.o: Link Error: Could not allocate section .text.UART1_Write, size = 42 PC units, attributes = code 
.ca/build/502_DEBUGActiveCA/production/mcc_generated_files/interrupt_manager.o: Link Error: Could not allocate section .text.INTERRUPT_Initialize, size = 36 PC units, attributes = code 
.ca/build/502_DEBUGActiveCA/production/mcc_generated_files/uart1.o: Link Error: Could not allocate section .text.UART1_IsTxDone, size = 34 PC units, attributes = code 
.ca/build/502_DEBUGActiveCA/production/mcc_generated_files/boot/boot_process.o: Link Error: Could not allocate section .text.ReadVersion, size = 30 PC units, attributes = code 
.ca/build/502_DEBUGActiveCA/production/mcc_generated_files/boot/boot_process.o: Link Error: Could not allocate section .text.GetMemoryAddressRange, size = 28 PC units, attributes = code 
.ca/build/502_DEBUGActiveCA/production/mcc_generated_files/boot/com_adaptor_uart.o: Link Error: Could not allocate section .text.BOOT_COM_Peek, size = 24 PC units, attributes = code 
.ca/build/502_DEBUGActiveCA/production/mcc_generated_files/uart1.o: Link Error: Could not allocate section .text.UART1_SetTxInterruptHandler, size = 24 PC units, attributes = code 
.ca/build/502_DEBUGActiveCA/production/mcc_generated_files/uart1.o: Link Error: Could not allocate section .text.UART1_SetRxInterruptHandler, size = 24 PC units, attributes = code 
.ca/build/502_DEBUGActiveCA/production/mcc_generated_files/system.o: Link Error: Could not allocate section .text.SYSTEM_Initialize, size = 22 PC units, attributes = code 
.ca/build/502_DEBUGActiveCA/production/mcc_generated_files/uart1.o: Link Error: Could not allocate section .text.UART1_IsRxReady, size = 22 PC units, attributes = code 
.ca/build/502_DEBUGActiveCA/production/mcc_generated_files/system.o: Link Error: Could not allocate section .text.SYSTEM_CORCONModeOperatingSet, size = 18 PC units, attributes = code 
.ca/build/502_DEBUGActiveCA/production/mcc_generated_files/boot/boot_process.o: Link Error: Could not allocate section .text.BOOT_StartApplication, size = 14 PC units, attributes = code 
.ca/build/502_DEBUGActiveCA/production/mcc_generated_files/traps.o: Link Error: Could not allocate section .text.use_failsafe_stack, size = 14 PC units, attributes = code 
.ca/build/502_DEBUGActiveCA/production/mcc_generated_files/system.o: Link Error: Could not allocate section .text.INTERRUPT_GlobalEnable, size = 12 PC units, attributes = code 
.ca/build/502_DEBUGActiveCA/production/mcc_generated_files/traps.o: Link Error: Could not allocate section .text.TRAPS_halt_on_error, size = 10 PC units, attributes = code 
.ca/build/502_DEBUGActiveCA/production/main.o: Link Error: Could not allocate section .text.main, size = 10 PC units, attributes = code 
.ca/build/502_DEBUGActiveCA/production/mcc_generated_files/boot/boot_process.o: Link Error: Could not allocate section .text.Reset, size = 8 PC units, attributes = code 
.ca/build/502_DEBUGActiveCA/production/mcc_generated_files/boot/boot_demo.o: Link Error: Could not allocate section .text.EnterBootloadMode, size = 8 PC units, attributes = code 
.ca/build/502_DEBUGActiveCA/production/mcc_generated_files/boot/boot_process.o: Link Error: Could not allocate section .text.BOOT_Initialize, size = 6 PC units, attributes = code 
.ca/build/502_DEBUGActiveCA/production/mcc_generated_files/boot/boot_demo.o: Link Error: Could not allocate section .text.BOOT_DEMO_Initialize, size = 6 PC units, attributes = code 
.ca/build/502_DEBUGActiveCA/production/mcc_generated_files/uart1.o: Link Error: Could not allocate section .text.UART1_Transmit_CallBack, size = 6 PC units, attributes = code 
.ca/build/502_DEBUGActiveCA/production/mcc_generated_files/uart1.o: Link Error: Could not allocate section .text.UART1_Receive_CallBack, size = 6 PC units, attributes = code 
.ca/build/502_DEBUGActiveCA/production/mcc_generated_files/boot/hardware_interrupt_table.o: Link Error: Could not allocate section .text, size = 4 PC units, attributes = code 
data_init: Link Error: Could not allocate section .dinit, size = 70 PC units, attributes = code keep 
.ca/build/502_DEBUGActiveCA/production/mcc_generated_files/boot/com_adaptor_uart.o: Link Error: Could not allocate section .text.BOOT_COM_GetBytesReady, size = 66 PC units, attributes = code 
.ca/build/502_DEBUGActiveCA/production/mcc_generated_files/boot/com_adaptor_uart.o: Link Error: Could not allocate section .text.BOOT_COM_Read, size = 64 PC units, attributes = code 
.ca/build/502_DEBUGActiveCA/production/mcc_generated_files/boot/boot_demo.o: Link Error: Could not allocate section .text.BOOT_DEMO_Tasks, size = 62 PC units, attributes = code 
.ca/build/502_DEBUGActiveCA/production/mcc_generated_files/uart1.o: Link Error: Could not allocate section .text.UART1_IsTxReady, size = 60 PC units, attributes = code 
.ca/build/502_DEBUGActiveCA/production/mcc_generated_files/boot/com_adaptor_uart.o: Link Error: Could not allocate section .text.BOOT_COM_Write, size = 56 PC units, attributes = code 
.ca/build/502_DEBUGActiveCA/production/mcc_generated_files/uart1.o: Link Error: Could not allocate section .text.UART1_Initialize, size = 52 PC units, attributes = code 
.ca/build/502_DEBUGActiveCA/production/mcc_generated_files/boot/boot_verify_not_blank.o: Link Error: Could not allocate section .text.BOOT_ImageVerify, size = 50 PC units, attributes = code 
.ca/build/502_DEBUGActiveCA/production/mcc_generated_files/boot/boot_process.o: Link Error: Could not allocate section .text.ResetDevice, size = 48 PC units, attributes = code 
.ca/build/502_DEBUGActiveCA/production/mcc_generated_files/boot/boot_process.o: Link Error: Could not allocate section .text.BOOT_ImageAddressGet, size = 48 PC units, attributes = code 
.ca/build/502_DEBUGActiveCA/production/mcc_generated_files/boot/boot_process.o: Link Error: Could not allocate section .text.IsLegalRange, size = 46 PC units, attributes = code 
.ca/build/502_DEBUGActiveCA/production/mcc_generated_files/boot/boot_process.o: Link Error: Could not allocate section .text.IsLegalAddress, size = 44 PC units, attributes = code 
.ca/build/502_DEBUGActiveCA/production/mcc_generated_files/uart1.o: Link Error: Could not allocate section .text.UART1_Read, size = 44 PC units, attributes = code 
.ca/build/502_DEBUGActiveCA/production/mcc_generated_files/boot/boot_process.o: Link Error: Could not allocate section .text.CommandError, size = 42 PC units, attributes = code 
.ca/build/502_DEBUGActiveCA/production/mcc_generated_files/uart1.o: Link Error: Could not allocate section .text.UART1_Write, size = 42 PC units, attributes = code 
.ca/build/502_DEBUGActiveCA/production/mcc_generated_files/interrupt_manager.o: Link Error: Could not allocate section .text.INTERRUPT_Initialize, size = 36 PC units, attributes = code 
.ca/build/502_DEBUGActiveCA/production/mcc_generated_files/uart1.o: Link Error: Could not allocate section .text.UART1_IsTxDone, size = 34 PC units, attributes = code 
.ca/build/502_DEBUGActiveCA/production/mcc_generated_files/boot/boot_process.o: Link Error: Could not allocate section .text.ReadVersion, size = 30 PC units, attributes = code 
.ca/build/502_DEBUGActiveCA/production/mcc_generated_files/boot/boot_process.o: Link Error: Could not allocate section .text.GetMemoryAddressRange, size = 28 PC units, attributes = code 
.ca/build/502_DEBUGActiveCA/production/mcc_generated_files/boot/com_adaptor_uart.o: Link Error: Could not allocate section .text.BOOT_COM_Peek, size = 24 PC units, attributes = code 
.ca/build/502_DEBUGActiveCA/production/mcc_generated_files/uart1.o: Link Error: Could not allocate section .text.UART1_SetTxInterruptHandler, size = 24 PC units, attributes = code 
.ca/build/502_DEBUGActiveCA/production/mcc_generated_files/uart1.o: Link Error: Could not allocate section .text.UART1_SetRxInterruptHandler, size = 24 PC units, attributes = code 
.ca/build/502_DEBUGActiveCA/production/mcc_generated_files/system.o: Link Error: Could not allocate section .text.SYSTEM_Initialize, size = 22 PC units, attributes = code 
.ca/build/502_DEBUGActiveCA/production/mcc_generated_files/uart1.o: Link Error: Could not allocate section .[0m
[31mtext.UART1_IsRxReady, size = 22 PC units, attributes = code 
.ca/build/502_DEBUGActiveCA/production/mcc_generated_files/system.o: Link Error: Could not allocate section .text.SYSTEM_CORCONModeOperatingSet, size = 18 PC units, attributes = code 
.ca/build/502_DEBUGActiveCA/production/mcc_generated_files/boot/boot_process.o: Link Error: Could not allocate section .text.BOOT_StartApplication, size = 14 PC units, attributes = code 
.ca/build/502_DEBUGActiveCA/production/mcc_generated_files/traps.o: Link Error: Could not allocate section .text.use_failsafe_stack, size = 14 PC units, attributes = code 
.ca/build/502_DEBUGActiveCA/production/mcc_generated_files/system.o: Link Error: Could not allocate section .text.INTERRUPT_GlobalEnable, size = 12 PC units, attributes = code 
.ca/build/502_DEBUGActiveCA/production/mcc_generated_files/traps.o: Link Error: Could not allocate section .text.TRAPS_halt_on_error, size = 10 PC units, attributes = code 
.ca/build/502_DEBUGActiveCA/production/main.o: Link Error: Could not allocate section .text.main, size = 10 PC units, attributes = code 
.ca/build/502_DEBUGActiveCA/production/mcc_generated_files/boot/boot_process.o: Link Error: Could not allocate section .text.Reset, size = 8 PC units, attributes = code 
.ca/build/502_DEBUGActiveCA/production/mcc_generated_files/boot/boot_demo.o: Link Error: Could not allocate section .text.EnterBootloadMode, size = 8 PC units, attributes = code 
.ca/build/502_DEBUGActiveCA/production/mcc_generated_files/boot/boot_process.o: Link Error: Could not allocate section .text.BOOT_Initialize, size = 6 PC units, attributes = code 
.ca/build/502_DEBUGActiveCA/production/mcc_generated_files/boot/boot_demo.o: Link Error: Could not allocate section .text.BOOT_DEMO_Initialize, size = 6 PC units, attributes = code 
.ca/build/502_DEBUGActiveCA/production/mcc_generated_files/uart1.o: Link Error: Could not allocate section .text.UART1_Transmit_CallBack, size = 6 PC units, attributes = code 
.ca/build/502_DEBUGActiveCA/production/mcc_generated_files/uart1.o: Link Error: Could not allocate section .text.UART1_Receive_CallBack, size = 6 PC units, attributes = code 
.ca/build/502_DEBUGActiveCA/production/mcc_generated_files/boot/hardware_interrupt_table.o: Link Error: Could not allocate section .text, size = 4 PC units, attributes = code 
.ca/build/502_DEBUGActiveCA/production/mcc_generated_files/boot/com_adaptor_uart.o: Link Error: Could not allocate section .text.BOOT_COM_GetBytesReady, size = 66 PC units, attributes = code 
.ca/build/502_DEBUGActiveCA/production/mcc_generated_files/boot/com_adaptor_uart.o: Link Error: Could not allocate section .text.BOOT_COM_Read, size = 64 PC units, attributes = code 
.ca/build/502_DEBUGActiveCA/production/mcc_generated_files/boot/boot_demo.o: Link Error: Could not allocate section .text.BOOT_DEMO_Tasks, size = 62 PC units, attributes = code 
.ca/build/502_DEBUGActiveCA/production/mcc_generated_files/uart1.o: Link Error: Could not allocate section .text.UART1_IsTxReady, size = 60 PC units, attributes = code 
.ca/build/502_DEBUGActiveCA/production/mcc_generated_files/boot/com_adaptor_uart.o: Link Error: Could not allocate section .text.BOOT_COM_Write, size = 56 PC units, attributes = code 
.ca/build/502_DEBUGActiveCA/production/mcc_generated_files/uart1.o: Link Error: Could not allocate section .text.UART1_Initialize, size = 52 PC units, attributes = code 
.ca/build/502_DEBUGActiveCA/production/mcc_generated_files/boot/boot_verify_not_blank.o: Link Error: Could not allocate section .text.BOOT_ImageVerify, size = 50 PC units, attributes = code 
.ca/build/502_DEBUGActiveCA/production/mcc_generated_files/boot/boot_process.o: Link Error: Could not allocate section .text.ResetDevice, size = 48 PC units, attributes = code 
.ca/build/502_DEBUGActiveCA/production/mcc_generated_files/boot/boot_process.o: Link Error: Could not allocate section .text.BOOT_ImageAddressGet, size = 48 PC units, attributes = code 
.ca/build/502_DEBUGActiveCA/production/mcc_generated_files/boot/boot_process.o: Link Error: Could not allocate section .text.IsLegalRange, size = 46 PC units, attributes = code 
.ca/build/502_DEBUGActiveCA/production/mcc_generated_files/boot/boot_process.o: Link Error: Could not allocate section .text.IsLegalAddress, size = 44 PC units, attributes = code 
.ca/build/502_DEBUGActiveCA/production/mcc_generated_files/uart1.o: Link Error: Could not allocate section .text.UART1_Read, size = 44 PC units, attributes = code 
.ca/build/502_DEBUGActiveCA/production/mcc_generated_files/boot/boot_process.o: Link Error: Could not allocate section .text.CommandError, size = 42 PC units, attributes = code 
.ca/build/502_DEBUGActiveCA/production/mcc_generated_files/uart1.o: Link Error: Could not allocate section .text.UART1_Write, size = 42 PC units, attributes = code 
.ca/build/502_DEBUGActiveCA/production/mcc_generated_files/interrupt_manager.o: Link Error: Could not allocate section .text.INTERRUPT_Initialize, size = 36 PC units, attributes = code 
.ca/build/502_DEBUGActiveCA/production/mcc_generated_files/uart1.o: Link Error: Could not allocate section .text.UART1_IsTxDone, size = 34 PC units, attributes = code 
.ca/build/502_DEBUGActiveCA/production/mcc_generated_files/boot/boot_process.o: Link Error: Could not allocate section .text.ReadVersion, size = 30 PC units, attributes = code 
.ca/build/502_DEBUGActiveCA/production/mcc_generated_files/boot/boot_process.o: Link Error: Could not allocate section .text.GetMemoryAddressRange, size = 28 PC units, attributes = code 
.ca/build/502_DEBUGActiveCA/production/mcc_generated_files/boot/com_adaptor_uart.o: Link Error: Could not allocate section .text.BOOT_COM_Peek, size = 24 PC units, attributes = code 
.ca/build/502_DEBUGActiveCA/production/mcc_generated_files/uart1.o: Link Error: Could not allocate section .text.UART1_SetTxInterruptHandler, size = 24 PC units, attributes = code 
.ca/build/502_DEBUGActiveCA/production/mcc_generated_files/uart1.o: Link Error: Could not allocate section .text.UART1_SetRxInterruptHandler, size = 24 PC units, attributes = code 
.ca/build/502_DEBUGActiveCA/production/mcc_generated_files/system.o: Link Error: Could not allocate section .text.SYSTEM_Initialize, size = 22 PC units, attributes = code 
.ca/build/502_DEBUGActiveCA/production/mcc_generated_files/uart1.o: Link Error: Could not allocate section .text.UART1_IsRxReady, size = 22 PC units, attributes = code 
.ca/build/502_DEBUGActiveCA/production/mcc_generated_files/system.o: Link Error: Could not allocate section .text.SYSTEM_CORCONModeOperatingSet, size = 18 PC units, attributes = code 
.ca/build/502_DEBUGActiveCA/production/mcc_generated_files/boot/boot_process.o: Link Error: Could not allocate section .text.BOOT_StartApplication, size = 14 PC units, attributes = code 
.ca/build/502_DEBUGActiveCA/production/mcc_generated_files/traps.o: Link Error: Could not allocate section .text.use_failsafe_stack, size = 14 PC units, attributes = code 
.ca/build/502_DEBUGActiveCA/production/mcc_generated_files/system.o: Link Error: Could not allocate section .text.INTERRUPT_GlobalEnable, size = 12 PC units, attributes = code 
.ca/build/502_DEBUGActiveCA/production/mcc_generated_files/traps.o: Link Error: Could not allocate section .text.TRAPS_halt_on_error, size = 10 PC units, attributes = code 
.ca/build/502_DEBUGActiveCA/production/main.o: Link Error: Could not allocate section .text.main, size = 10 PC units, attributes = code 
.ca/build/502_DEBUGActiveCA/production/mcc_generated_files/boot/boot_process.o: Link Error: Could not allocate section .text.Reset, size = 8 PC units, attributes = code 
.ca/build/502_DEBUGActiveCA/production/mcc_generated_files/boot/boot_demo.o: Link Error: Could not allocate section .text.EnterBootloadMode, size = 8 PC units, attributes = code 
.ca/build/502_DEBUGActiveCA/production/mcc_generated_files/boot/boot_process.o: Link Error: Could not allocate section .text.BOOT_Initialize, size = 6 PC units, attributes = code 
.ca/build/502_DEBUGActiveCA/production/mcc_generated_files/boot/boot_demo.o: Link Error: Could not allocate section .text.BOOT_DEMO_Initialize, size = 6 PC units, attributes = code 
.ca/build/502_DEBUGActi[0m
[31mveCA/production/mcc_generated_files/uart1.o: Link Error: Could not allocate section .text.UART1_Transmit_CallBack, size = 6 PC units, attributes = code 
.ca/build/502_DEBUGActiveCA/production/mcc_generated_files/uart1.o: Link Error: Could not allocate section .text.UART1_Receive_CallBack, size = 6 PC units, attributes = code 
.ca/build/502_DEBUGActiveCA/production/mcc_generated_files/boot/hardware_interrupt_table.o: Link Error: Could not allocate section .text, size = 4 PC units, attributes = code 
.ca/build/502_DEBUGActiveCA/production/mcc_generated_files/boot/com_adaptor_uart.o: Link Error: Could not allocate section .text.BOOT_COM_Read, size = 64 PC units, attributes = code 
.ca/build/502_DEBUGActiveCA/production/mcc_generated_files/boot/boot_demo.o: Link Error: Could not allocate section .text.BOOT_DEMO_Tasks, size = 62 PC units, attributes = code 
.ca/build/502_DEBUGActiveCA/production/mcc_generated_files/uart1.o: Link Error: Could not allocate section .text.UART1_IsTxReady, size = 60 PC units, attributes = code 
.ca/build/502_DEBUGActiveCA/production/mcc_generated_files/boot/com_adaptor_uart.o: Link Error: Could not allocate section .text.BOOT_COM_Write, size = 56 PC units, attributes = code 
.ca/build/502_DEBUGActiveCA/production/mcc_generated_files/uart1.o: Link Error: Could not allocate section .text.UART1_Initialize, size = 52 PC units, attributes = code 
.ca/build/502_DEBUGActiveCA/production/mcc_generated_files/boot/boot_verify_not_blank.o: Link Error: Could not allocate section .text.BOOT_ImageVerify, size = 50 PC units, attributes = code 
.ca/build/502_DEBUGActiveCA/production/mcc_generated_files/boot/boot_process.o: Link Error: Could not allocate section .text.ResetDevice, size = 48 PC units, attributes = code 
.ca/build/502_DEBUGActiveCA/production/mcc_generated_files/boot/boot_process.o: Link Error: Could not allocate section .text.BOOT_ImageAddressGet, size = 48 PC units, attributes = code 
.ca/build/502_DEBUGActiveCA/production/mcc_generated_files/boot/boot_process.o: Link Error: Could not allocate section .text.IsLegalRange, size = 46 PC units, attributes = code 
.ca/build/502_DEBUGActiveCA/production/mcc_generated_files/boot/boot_process.o: Link Error: Could not allocate section .text.IsLegalAddress, size = 44 PC units, attributes = code 
.ca/build/502_DEBUGActiveCA/production/mcc_generated_files/uart1.o: Link Error: Could not allocate section .text.UART1_Read, size = 44 PC units, attributes = code 
.ca/build/502_DEBUGActiveCA/production/mcc_generated_files/boot/boot_process.o: Link Error: Could not allocate section .text.CommandError, size = 42 PC units, attributes = code 
.ca/build/502_DEBUGActiveCA/production/mcc_generated_files/uart1.o: Link Error: Could not allocate section .text.UART1_Write, size = 42 PC units, attributes = code 
.ca/build/502_DEBUGActiveCA/production/mcc_generated_files/interrupt_manager.o: Link Error: Could not allocate section .text.INTERRUPT_Initialize, size = 36 PC units, attributes = code 
.ca/build/502_DEBUGActiveCA/production/mcc_generated_files/uart1.o: Link Error: Could not allocate section .text.UART1_IsTxDone, size = 34 PC units, attributes = code 
.ca/build/502_DEBUGActiveCA/production/mcc_generated_files/boot/boot_process.o: Link Error: Could not allocate section .text.ReadVersion, size = 30 PC units, attributes = code 
.ca/build/502_DEBUGActiveCA/production/mcc_generated_files/boot/boot_process.o: Link Error: Could not allocate section .text.GetMemoryAddressRange, size = 28 PC units, attributes = code 
.ca/build/502_DEBUGActiveCA/production/mcc_generated_files/boot/com_adaptor_uart.o: Link Error: Could not allocate section .text.BOOT_COM_Peek, size = 24 PC units, attributes = code 
.ca/build/502_DEBUGActiveCA/production/mcc_generated_files/uart1.o: Link Error: Could not allocate section .text.UART1_SetTxInterruptHandler, size = 24 PC units, attributes = code 
.ca/build/502_DEBUGActiveCA/production/mcc_generated_files/uart1.o: Link Error: Could not allocate section .text.UART1_SetRxInterruptHandler, size = 24 PC units, attributes = code 
.ca/build/502_DEBUGActiveCA/production/mcc_generated_files/system.o: Link Error: Could not allocate section .text.SYSTEM_Initialize, size = 22 PC units, attributes = code 
.ca/build/502_DEBUGActiveCA/production/mcc_generated_files/uart1.o: Link Error: Could not allocate section .text.UART1_IsRxReady, size = 22 PC units, attributes = code 
.ca/build/502_DEBUGActiveCA/production/mcc_generated_files/system.o: Link Error: Could not allocate section .text.SYSTEM_CORCONModeOperatingSet, size = 18 PC units, attributes = code 
.ca/build/502_DEBUGActiveCA/production/mcc_generated_files/boot/boot_process.o: Link Error: Could not allocate section .text.BOOT_StartApplication, size = 14 PC units, attributes = code 
.ca/build/502_DEBUGActiveCA/production/mcc_generated_files/traps.o: Link Error: Could not allocate section .text.use_failsafe_stack, size = 14 PC units, attributes = code 
.ca/build/502_DEBUGActiveCA/production/mcc_generated_files/system.o: Link Error: Could not allocate section .text.INTERRUPT_GlobalEnable, size = 12 PC units, attributes = code 
.ca/build/502_DEBUGActiveCA/production/mcc_generated_files/traps.o: Link Error: Could not allocate section .text.TRAPS_halt_on_error, size = 10 PC units, attributes = code 
.ca/build/502_DEBUGActiveCA/production/main.o: Link Error: Could not allocate section .text.main, size = 10 PC units, attributes = code 
.ca/build/502_DEBUGActiveCA/production/mcc_generated_files/boot/boot_process.o: Link Error: Could not allocate section .text.Reset, size = 8 PC units, attributes = code 
.ca/build/502_DEBUGActiveCA/production/mcc_generated_files/boot/boot_demo.o: Link Error: Could not allocate section .text.EnterBootloadMode, size = 8 PC units, attributes = code 
.ca/build/502_DEBUGActiveCA/production/mcc_generated_files/boot/boot_process.o: Link Error: Could not allocate section .text.BOOT_Initialize, size = 6 PC units, attributes = code 
.ca/build/502_DEBUGActiveCA/production/mcc_generated_files/boot/boot_demo.o: Link Error: Could not allocate section .text.BOOT_DEMO_Initialize, size = 6 PC units, attributes = code 
.ca/build/502_DEBUGActiveCA/production/mcc_generated_files/uart1.o: Link Error: Could not allocate section .text.UART1_Transmit_CallBack, size = 6 PC units, attributes = code 
.ca/build/502_DEBUGActiveCA/production/mcc_generated_files/uart1.o: Link Error: Could not allocate section .text.UART1_Receive_CallBack, size = 6 PC units, attributes = code 
.ca/build/502_DEBUGActiveCA/production/mcc_generated_files/boot/hardware_interrupt_table.o: Link Error: Could not allocate section .text, size = 4 PC units, attributes = code 
.ca/build/502_DEBUGActiveCA/production/mcc_generated_files/boot/boot_demo.o: Link Error: Could not allocate section .text.BOOT_DEMO_Tasks, size = 62 PC units, attributes = code 
.ca/build/502_DEBUGActiveCA/production/mcc_generated_files/uart1.o: Link Error: Could not allocate section .text.UART1_IsTxReady, size = 60 PC units, attributes = code 
.ca/build/502_DEBUGActiveCA/production/mcc_generated_files/boot/com_adaptor_uart.o: Link Error: Could not allocate section .text.BOOT_COM_Write, size = 56 PC units, attributes = code 
.ca/build/502_DEBUGActiveCA/production/mcc_generated_files/uart1.o: Link Error: Could not allocate section .text.UART1_Initialize, size = 52 PC units, attributes = code 
.ca/build/502_DEBUGActiveCA/production/mcc_generated_files/boot/boot_verify_not_blank.o: Link Error: Could not allocate section .text.BOOT_ImageVerify, size = 50 PC units, attributes = code 
.ca/build/502_DEBUGActiveCA/production/mcc_generated_files/boot/boot_process.o: Link Error: Could not allocate section .text.ResetDevice, size = 48 PC units, attributes = code 
.ca/build/502_DEBUGActiveCA/production/mcc_generated_files/boot/boot_process.o: Link Error: Could not allocate section .text.BOOT_ImageAddressGet, size = 48 PC units, attributes = code 
.ca/build/502_DEBUGActiveCA/production/mcc_generated_files/boot/boot_process.o: Link Error: Could not allocate section .text.IsLegalRange, size = 46 PC units, attributes = code 
.ca/build/502_DEBUGActiveCA/production/mcc_generated_files/boot/boot_process.o: [0m
[31mLink Error: Could not allocate section .text.IsLegalAddress, size = 44 PC units, attributes = code 
.ca/build/502_DEBUGActiveCA/production/mcc_generated_files/uart1.o: Link Error: Could not allocate section .text.UART1_Read, size = 44 PC units, attributes = code 
.ca/build/502_DEBUGActiveCA/production/mcc_generated_files/boot/boot_process.o: Link Error: Could not allocate section .text.CommandError, size = 42 PC units, attributes = code 
.ca/build/502_DEBUGActiveCA/production/mcc_generated_files/uart1.o: Link Error: Could not allocate section .text.UART1_Write, size = 42 PC units, attributes = code 
.ca/build/502_DEBUGActiveCA/production/mcc_generated_files/interrupt_manager.o: Link Error: Could not allocate section .text.INTERRUPT_Initialize, size = 36 PC units, attributes = code 
.ca/build/502_DEBUGActiveCA/production/mcc_generated_files/uart1.o: Link Error: Could not allocate section .text.UART1_IsTxDone, size = 34 PC units, attributes = code 
.ca/build/502_DEBUGActiveCA/production/mcc_generated_files/boot/boot_process.o: Link Error: Could not allocate section .text.ReadVersion, size = 30 PC units, attributes = code 
.ca/build/502_DEBUGActiveCA/production/mcc_generated_files/boot/boot_process.o: Link Error: Could not allocate section .text.GetMemoryAddressRange, size = 28 PC units, attributes = code 
.ca/build/502_DEBUGActiveCA/production/mcc_generated_files/boot/com_adaptor_uart.o: Link Error: Could not allocate section .text.BOOT_COM_Peek, size = 24 PC units, attributes = code 
.ca/build/502_DEBUGActiveCA/production/mcc_generated_files/uart1.o: Link Error: Could not allocate section .text.UART1_SetTxInterruptHandler, size = 24 PC units, attributes = code 
.ca/build/502_DEBUGActiveCA/production/mcc_generated_files/uart1.o: Link Error: Could not allocate section .text.UART1_SetRxInterruptHandler, size = 24 PC units, attributes = code 
.ca/build/502_DEBUGActiveCA/production/mcc_generated_files/system.o: Link Error: Could not allocate section .text.SYSTEM_Initialize, size = 22 PC units, attributes = code 
.ca/build/502_DEBUGActiveCA/production/mcc_generated_files/uart1.o: Link Error: Could not allocate section .text.UART1_IsRxReady, size = 22 PC units, attributes = code 
.ca/build/502_DEBUGActiveCA/production/mcc_generated_files/system.o: Link Error: Could not allocate section .text.SYSTEM_CORCONModeOperatingSet, size = 18 PC units, attributes = code 
.ca/build/502_DEBUGActiveCA/production/mcc_generated_files/boot/boot_process.o: Link Error: Could not allocate section .text.BOOT_StartApplication, size = 14 PC units, attributes = code 
.ca/build/502_DEBUGActiveCA/production/mcc_generated_files/traps.o: Link Error: Could not allocate section .text.use_failsafe_stack, size = 14 PC units, attributes = code 
.ca/build/502_DEBUGActiveCA/production/mcc_generated_files/system.o: Link Error: Could not allocate section .text.INTERRUPT_GlobalEnable, size = 12 PC units, attributes = code 
.ca/build/502_DEBUGActiveCA/production/mcc_generated_files/traps.o: Link Error: Could not allocate section .text.TRAPS_halt_on_error, size = 10 PC units, attributes = code 
.ca/build/502_DEBUGActiveCA/production/main.o: Link Error: Could not allocate section .text.main, size = 10 PC units, attributes = code 
.ca/build/502_DEBUGActiveCA/production/mcc_generated_files/boot/boot_process.o: Link Error: Could not allocate section .text.Reset, size = 8 PC units, attributes = code 
.ca/build/502_DEBUGActiveCA/production/mcc_generated_files/boot/boot_demo.o: Link Error: Could not allocate section .text.EnterBootloadMode, size = 8 PC units, attributes = code 
.ca/build/502_DEBUGActiveCA/production/mcc_generated_files/boot/boot_process.o: Link Error: Could not allocate section .text.BOOT_Initialize, size = 6 PC units, attributes = code 
.ca/build/502_DEBUGActiveCA/production/mcc_generated_files/boot/boot_demo.o: Link Error: Could not allocate section .text.BOOT_DEMO_Initialize, size = 6 PC units, attributes = code 
.ca/build/502_DEBUGActiveCA/production/mcc_generated_files/uart1.o: Link Error: Could not allocate section .text.UART1_Transmit_CallBack, size = 6 PC units, attributes = code 
.ca/build/502_DEBUGActiveCA/production/mcc_generated_files/uart1.o: Link Error: Could not allocate section .text.UART1_Receive_CallBack, size = 6 PC units, attributes = code 
.ca/build/502_DEBUGActiveCA/production/mcc_generated_files/boot/hardware_interrupt_table.o: Link Error: Could not allocate section .text, size = 4 PC units, attributes = code 
.ca/build/502_DEBUGActiveCA/production/mcc_generated_files/uart1.o: Link Error: Could not allocate section .text.UART1_IsTxReady, size = 60 PC units, attributes = code 
.ca/build/502_DEBUGActiveCA/production/mcc_generated_files/boot/com_adaptor_uart.o: Link Error: Could not allocate section .text.BOOT_COM_Write, size = 56 PC units, attributes = code 
.ca/build/502_DEBUGActiveCA/production/mcc_generated_files/uart1.o: Link Error: Could not allocate section .text.UART1_Initialize, size = 52 PC units, attributes = code 
.ca/build/502_DEBUGActiveCA/production/mcc_generated_files/boot/boot_verify_not_blank.o: Link Error: Could not allocate section .text.BOOT_ImageVerify, size = 50 PC units, attributes = code 
.ca/build/502_DEBUGActiveCA/production/mcc_generated_files/boot/boot_process.o: Link Error: Could not allocate section .text.ResetDevice, size = 48 PC units, attributes = code 
.ca/build/502_DEBUGActiveCA/production/mcc_generated_files/boot/boot_process.o: Link Error: Could not allocate section .text.BOOT_ImageAddressGet, size = 48 PC units, attributes = code 
.ca/build/502_DEBUGActiveCA/production/mcc_generated_files/boot/boot_process.o: Link Error: Could not allocate section .text.IsLegalRange, size = 46 PC units, attributes = code 
.ca/build/502_DEBUGActiveCA/production/mcc_generated_files/boot/boot_process.o: Link Error: Could not allocate section .text.IsLegalAddress, size = 44 PC units, attributes = code 
.ca/build/502_DEBUGActiveCA/production/mcc_generated_files/uart1.o: Link Error: Could not allocate section .text.UART1_Read, size = 44 PC units, attributes = code 
.ca/build/502_DEBUGActiveCA/production/mcc_generated_files/boot/boot_process.o: Link Error: Could not allocate section .text.CommandError, size = 42 PC units, attributes = code 
.ca/build/502_DEBUGActiveCA/production/mcc_generated_files/uart1.o: Link Error: Could not allocate section .text.UART1_Write, size = 42 PC units, attributes = code 
.ca/build/502_DEBUGActiveCA/production/mcc_generated_files/interrupt_manager.o: Link Error: Could not allocate section .text.INTERRUPT_Initialize, size = 36 PC units, attributes = code 
.ca/build/502_DEBUGActiveCA/production/mcc_generated_files/uart1.o: Link Error: Could not allocate section .text.UART1_IsTxDone, size = 34 PC units, attributes = code 
.ca/build/502_DEBUGActiveCA/production/mcc_generated_files/boot/boot_process.o: Link Error: Could not allocate section .text.ReadVersion, size = 30 PC units, attributes = code 
.ca/build/502_DEBUGActiveCA/production/mcc_generated_files/boot/boot_process.o: Link Error: Could not allocate section .text.GetMemoryAddressRange, size = 28 PC units, attributes = code 
.ca/build/502_DEBUGActiveCA/production/mcc_generated_files/boot/com_adaptor_uart.o: Link Error: Could not allocate section .text.BOOT_COM_Peek, size = 24 PC units, attributes = code 
.ca/build/502_DEBUGActiveCA/production/mcc_generated_files/uart1.o: Link Error: Could not allocate section .text.UART1_SetTxInterruptHandler, size = 24 PC units, attributes = code 
.ca/build/502_DEBUGActiveCA/production/mcc_generated_files/uart1.o: Link Error: Could not allocate section .text.UART1_SetRxInterruptHandler, size = 24 PC units, attributes = code 
.ca/build/502_DEBUGActiveCA/production/mcc_generated_files/system.o: Link Error: Could not allocate section .text.SYSTEM_Initialize, size = 22 PC units, attributes = code 
.ca/build/502_DEBUGActiveCA/production/mcc_generated_files/uart1.o: Link Error: Could not allocate section .text.UART1_IsRxReady, size = 22 PC units, attributes = code 
.ca/build/502_DEBUGActiveCA/production/mcc_generated_files/system.o: Link Error: Could not allocate section .text.SYSTEM_CORCONModeOperatingSet, size = 18 PC units, at[0m
[31mtributes = code 
.ca/build/502_DEBUGActiveCA/production/mcc_generated_files/boot/boot_process.o: Link Error: Could not allocate section .text.BOOT_StartApplication, size = 14 PC units, attributes = code 
.ca/build/502_DEBUGActiveCA/production/mcc_generated_files/traps.o: Link Error: Could not allocate section .text.use_failsafe_stack, size = 14 PC units, attributes = code 
.ca/build/502_DEBUGActiveCA/production/mcc_generated_files/system.o: Link Error: Could not allocate section .text.INTERRUPT_GlobalEnable, size = 12 PC units, attributes = code 
.ca/build/502_DEBUGActiveCA/production/mcc_generated_files/traps.o: Link Error: Could not allocate section .text.TRAPS_halt_on_error, size = 10 PC units, attributes = code 
.ca/build/502_DEBUGActiveCA/production/main.o: Link Error: Could not allocate section .text.main, size = 10 PC units, attributes = code 
.ca/build/502_DEBUGActiveCA/production/mcc_generated_files/boot/boot_process.o: Link Error: Could not allocate section .text.Reset, size = 8 PC units, attributes = code 
.ca/build/502_DEBUGActiveCA/production/mcc_generated_files/boot/boot_demo.o: Link Error: Could not allocate section .text.EnterBootloadMode, size = 8 PC units, attributes = code 
.ca/build/502_DEBUGActiveCA/production/mcc_generated_files/boot/boot_process.o: Link Error: Could not allocate section .text.BOOT_Initialize, size = 6 PC units, attributes = code 
.ca/build/502_DEBUGActiveCA/production/mcc_generated_files/boot/boot_demo.o: Link Error: Could not allocate section .text.BOOT_DEMO_Initialize, size = 6 PC units, attributes = code 
.ca/build/502_DEBUGActiveCA/production/mcc_generated_files/uart1.o: Link Error: Could not allocate section .text.UART1_Transmit_CallBack, size = 6 PC units, attributes = code 
.ca/build/502_DEBUGActiveCA/production/mcc_generated_files/uart1.o: Link Error: Could not allocate section .text.UART1_Receive_CallBack, size = 6 PC units, attributes = code 
.ca/build/502_DEBUGActiveCA/production/mcc_generated_files/boot/hardware_interrupt_table.o: Link Error: Could not allocate section .text, size = 4 PC units, attributes = code 
.ca/build/502_DEBUGActiveCA/production/mcc_generated_files/boot/com_adaptor_uart.o: Link Error: Could not allocate section .text.BOOT_COM_Write, size = 56 PC units, attributes = code 
.ca/build/502_DEBUGActiveCA/production/mcc_generated_files/uart1.o: Link Error: Could not allocate section .text.UART1_Initialize, size = 52 PC units, attributes = code 
.ca/build/502_DEBUGActiveCA/production/mcc_generated_files/boot/boot_verify_not_blank.o: Link Error: Could not allocate section .text.BOOT_ImageVerify, size = 50 PC units, attributes = code 
.ca/build/502_DEBUGActiveCA/production/mcc_generated_files/boot/boot_process.o: Link Error: Could not allocate section .text.ResetDevice, size = 48 PC units, attributes = code 
.ca/build/502_DEBUGActiveCA/production/mcc_generated_files/boot/boot_process.o: Link Error: Could not allocate section .text.BOOT_ImageAddressGet, size = 48 PC units, attributes = code 
.ca/build/502_DEBUGActiveCA/production/mcc_generated_files/boot/boot_process.o: Link Error: Could not allocate section .text.IsLegalRange, size = 46 PC units, attributes = code 
.ca/build/502_DEBUGActiveCA/production/mcc_generated_files/boot/boot_process.o: Link Error: Could not allocate section .text.IsLegalAddress, size = 44 PC units, attributes = code 
.ca/build/502_DEBUGActiveCA/production/mcc_generated_files/uart1.o: Link Error: Could not allocate section .text.UART1_Read, size = 44 PC units, attributes = code 
.ca/build/502_DEBUGActiveCA/production/mcc_generated_files/boot/boot_process.o: Link Error: Could not allocate section .text.CommandError, size = 42 PC units, attributes = code 
.ca/build/502_DEBUGActiveCA/production/mcc_generated_files/uart1.o: Link Error: Could not allocate section .text.UART1_Write, size = 42 PC units, attributes = code 
.ca/build/502_DEBUGActiveCA/production/mcc_generated_files/interrupt_manager.o: Link Error: Could not allocate section .text.INTERRUPT_Initialize, size = 36 PC units, attributes = code 
.ca/build/502_DEBUGActiveCA/production/mcc_generated_files/uart1.o: Link Error: Could not allocate section .text.UART1_IsTxDone, size = 34 PC units, attributes = code 
.ca/build/502_DEBUGActiveCA/production/mcc_generated_files/boot/boot_process.o: Link Error: Could not allocate section .text.ReadVersion, size = 30 PC units, attributes = code 
.ca/build/502_DEBUGActiveCA/production/mcc_generated_files/boot/boot_process.o: Link Error: Could not allocate section .text.GetMemoryAddressRange, size = 28 PC units, attributes = code 
.ca/build/502_DEBUGActiveCA/production/mcc_generated_files/boot/com_adaptor_uart.o: Link Error: Could not allocate section .text.BOOT_COM_Peek, size = 24 PC units, attributes = code 
.ca/build/502_DEBUGActiveCA/production/mcc_generated_files/uart1.o: Link Error: Could not allocate section .text.UART1_SetTxInterruptHandler, size = 24 PC units, attributes = code 
.ca/build/502_DEBUGActiveCA/production/mcc_generated_files/uart1.o: Link Error: Could not allocate section .text.UART1_SetRxInterruptHandler, size = 24 PC units, attributes = code 
.ca/build/502_DEBUGActiveCA/production/mcc_generated_files/system.o: Link Error: Could not allocate section .text.SYSTEM_Initialize, size = 22 PC units, attributes = code 
.ca/build/502_DEBUGActiveCA/production/mcc_generated_files/uart1.o: Link Error: Could not allocate section .text.UART1_IsRxReady, size = 22 PC units, attributes = code 
.ca/build/502_DEBUGActiveCA/production/mcc_generated_files/system.o: Link Error: Could not allocate section .text.SYSTEM_CORCONModeOperatingSet, size = 18 PC units, attributes = code 
.ca/build/502_DEBUGActiveCA/production/mcc_generated_files/boot/boot_process.o: Link Error: Could not allocate section .text.BOOT_StartApplication, size = 14 PC units, attributes = code 
.ca/build/502_DEBUGActiveCA/production/mcc_generated_files/traps.o: Link Error: Could not allocate section .text.use_failsafe_stack, size = 14 PC units, attributes = code 
.ca/build/502_DEBUGActiveCA/production/mcc_generated_files/system.o: Link Error: Could not allocate section .text.INTERRUPT_GlobalEnable, size = 12 PC units, attributes = code 
.ca/build/502_DEBUGActiveCA/production/mcc_generated_files/traps.o: Link Error: Could not allocate section .text.TRAPS_halt_on_error, size = 10 PC units, attributes = code 
.ca/build/502_DEBUGActiveCA/production/main.o: Link Error: Could not allocate section .text.main, size = 10 PC units, attributes = code 
.ca/build/502_DEBUGActiveCA/production/mcc_generated_files/boot/boot_process.o: Link Error: Could not allocate section .text.Reset, size = 8 PC units, attributes = code 
.ca/build/502_DEBUGActiveCA/production/mcc_generated_files/boot/boot_demo.o: Link Error: Could not allocate section .text.EnterBootloadMode, size = 8 PC units, attributes = code 
.ca/build/502_DEBUGActiveCA/production/mcc_generated_files/boot/boot_process.o: Link Error: Could not allocate section .text.BOOT_Initialize, size = 6 PC units, attributes = code 
.ca/build/502_DEBUGActiveCA/production/mcc_generated_files/boot/boot_demo.o: Link Error: Could not allocate section .text.BOOT_DEMO_Initialize, size = 6 PC units, attributes = code 
.ca/build/502_DEBUGActiveCA/production/mcc_generated_files/uart1.o: Link Error: Could not allocate section .text.UART1_Transmit_CallBack, size = 6 PC units, attributes = code 
.ca/build/502_DEBUGActiveCA/production/mcc_generated_files/uart1.o: Link Error: Could not allocate section .text.UART1_Receive_CallBack, size = 6 PC units, attributes = code 
.ca/build/502_DEBUGActiveCA/production/mcc_generated_files/boot/hardware_interrupt_table.o: Link Error: Could not allocate section .text, size = 4 PC units, attributes = code 
.ca/build/502_DEBUGActiveCA/production/mcc_generated_files/uart1.o: Link Error: Could not allocate section .text.UART1_Initialize, size = 52 PC units, attributes = code 
.ca/build/502_DEBUGActiveCA/production/mcc_generated_files/boot/boot_verify_not_blank.o: Link Error: Could not allocate section .text.BOOT_ImageVerify, size = 50 PC units, attributes = code 
.ca/build/502_DEBUGActiveCA/production/mcc_generated_files/boot/boot_process.o: Link [0m
[31mError: Could not allocate section .text.ResetDevice, size = 48 PC units, attributes = code 
.ca/build/502_DEBUGActiveCA/production/mcc_generated_files/boot/boot_process.o: Link Error: Could not allocate section .text.BOOT_ImageAddressGet, size = 48 PC units, attributes = code 
.ca/build/502_DEBUGActiveCA/production/mcc_generated_files/boot/boot_process.o: Link Error: Could not allocate section .text.IsLegalRange, size = 46 PC units, attributes = code 
.ca/build/502_DEBUGActiveCA/production/mcc_generated_files/boot/boot_process.o: Link Error: Could not allocate section .text.IsLegalAddress, size = 44 PC units, attributes = code 
.ca/build/502_DEBUGActiveCA/production/mcc_generated_files/uart1.o: Link Error: Could not allocate section .text.UART1_Read, size = 44 PC units, attributes = code 
.ca/build/502_DEBUGActiveCA/production/mcc_generated_files/boot/boot_process.o: Link Error: Could not allocate section .text.CommandError, size = 42 PC units, attributes = code 
.ca/build/502_DEBUGActiveCA/production/mcc_generated_files/uart1.o: Link Error: Could not allocate section .text.UART1_Write, size = 42 PC units, attributes = code 
.ca/build/502_DEBUGActiveCA/production/mcc_generated_files/interrupt_manager.o: Link Error: Could not allocate section .text.INTERRUPT_Initialize, size = 36 PC units, attributes = code 
.ca/build/502_DEBUGActiveCA/production/mcc_generated_files/uart1.o: Link Error: Could not allocate section .text.UART1_IsTxDone, size = 34 PC units, attributes = code 
.ca/build/502_DEBUGActiveCA/production/mcc_generated_files/boot/boot_process.o: Link Error: Could not allocate section .text.ReadVersion, size = 30 PC units, attributes = code 
.ca/build/502_DEBUGActiveCA/production/mcc_generated_files/boot/boot_process.o: Link Error: Could not allocate section .text.GetMemoryAddressRange, size = 28 PC units, attributes = code 
.ca/build/502_DEBUGActiveCA/production/mcc_generated_files/boot/com_adaptor_uart.o: Link Error: Could not allocate section .text.BOOT_COM_Peek, size = 24 PC units, attributes = code 
.ca/build/502_DEBUGActiveCA/production/mcc_generated_files/uart1.o: Link Error: Could not allocate section .text.UART1_SetTxInterruptHandler, size = 24 PC units, attributes = code 
.ca/build/502_DEBUGActiveCA/production/mcc_generated_files/uart1.o: Link Error: Could not allocate section .text.UART1_SetRxInterruptHandler, size = 24 PC units, attributes = code 
.ca/build/502_DEBUGActiveCA/production/mcc_generated_files/system.o: Link Error: Could not allocate section .text.SYSTEM_Initialize, size = 22 PC units, attributes = code 
.ca/build/502_DEBUGActiveCA/production/mcc_generated_files/uart1.o: Link Error: Could not allocate section .text.UART1_IsRxReady, size = 22 PC units, attributes = code 
.ca/build/502_DEBUGActiveCA/production/mcc_generated_files/system.o: Link Error: Could not allocate section .text.SYSTEM_CORCONModeOperatingSet, size = 18 PC units, attributes = code 
.ca/build/502_DEBUGActiveCA/production/mcc_generated_files/boot/boot_process.o: Link Error: Could not allocate section .text.BOOT_StartApplication, size = 14 PC units, attributes = code 
.ca/build/502_DEBUGActiveCA/production/mcc_generated_files/traps.o: Link Error: Could not allocate section .text.use_failsafe_stack, size = 14 PC units, attributes = code 
.ca/build/502_DEBUGActiveCA/production/mcc_generated_files/system.o: Link Error: Could not allocate section .text.INTERRUPT_GlobalEnable, size = 12 PC units, attributes = code 
.ca/build/502_DEBUGActiveCA/production/mcc_generated_files/traps.o: Link Error: Could not allocate section .text.TRAPS_halt_on_error, size = 10 PC units, attributes = code 
.ca/build/502_DEBUGActiveCA/production/main.o: Link Error: Could not allocate section .text.main, size = 10 PC units, attributes = code 
.ca/build/502_DEBUGActiveCA/production/mcc_generated_files/boot/boot_process.o: Link Error: Could not allocate section .text.Reset, size = 8 PC units, attributes = code 
.ca/build/502_DEBUGActiveCA/production/mcc_generated_files/boot/boot_demo.o: Link Error: Could not allocate section .text.EnterBootloadMode, size = 8 PC units, attributes = code 
.ca/build/502_DEBUGActiveCA/production/mcc_generated_files/boot/boot_process.o: Link Error: Could not allocate section .text.BOOT_Initialize, size = 6 PC units, attributes = code 
.ca/build/502_DEBUGActiveCA/production/mcc_generated_files/boot/boot_demo.o: Link Error: Could not allocate section .text.BOOT_DEMO_Initialize, size = 6 PC units, attributes = code 
.ca/build/502_DEBUGActiveCA/production/mcc_generated_files/uart1.o: Link Error: Could not allocate section .text.UART1_Transmit_CallBack, size = 6 PC units, attributes = code 
.ca/build/502_DEBUGActiveCA/production/mcc_generated_files/uart1.o: Link Error: Could not allocate section .text.UART1_Receive_CallBack, size = 6 PC units, attributes = code 
.ca/build/502_DEBUGActiveCA/production/mcc_generated_files/boot/hardware_interrupt_table.o: Link Error: Could not allocate section .text, size = 4 PC units, attributes = code 
.ca/build/502_DEBUGActiveCA/production/mcc_generated_files/boot/boot_verify_not_blank.o: Link Error: Could not allocate section .text.BOOT_ImageVerify, size = 50 PC units, attributes = code 
.ca/build/502_DEBUGActiveCA/production/mcc_generated_files/boot/boot_process.o: Link Error: Could not allocate section .text.ResetDevice, size = 48 PC units, attributes = code 
.ca/build/502_DEBUGActiveCA/production/mcc_generated_files/boot/boot_process.o: Link Error: Could not allocate section .text.BOOT_ImageAddressGet, size = 48 PC units, attributes = code 
.ca/build/502_DEBUGActiveCA/production/mcc_generated_files/boot/boot_process.o: Link Error: Could not allocate section .text.IsLegalRange, size = 46 PC units, attributes = code 
.ca/build/502_DEBUGActiveCA/production/mcc_generated_files/boot/boot_process.o: Link Error: Could not allocate section .text.IsLegalAddress, size = 44 PC units, attributes = code 
.ca/build/502_DEBUGActiveCA/production/mcc_generated_files/uart1.o: Link Error: Could not allocate section .text.UART1_Read, size = 44 PC units, attributes = code 
.ca/build/502_DEBUGActiveCA/production/mcc_generated_files/boot/boot_process.o: Link Error: Could not allocate section .text.CommandError, size = 42 PC units, attributes = code 
.ca/build/502_DEBUGActiveCA/production/mcc_generated_files/uart1.o: Link Error: Could not allocate section .text.UART1_Write, size = 42 PC units, attributes = code 
.ca/build/502_DEBUGActiveCA/production/mcc_generated_files/interrupt_manager.o: Link Error: Could not allocate section .text.INTERRUPT_Initialize, size = 36 PC units, attributes = code 
.ca/build/502_DEBUGActiveCA/production/mcc_generated_files/uart1.o: Link Error: Could not allocate section .text.UART1_IsTxDone, size = 34 PC units, attributes = code 
.ca/build/502_DEBUGActiveCA/production/mcc_generated_files/boot/boot_process.o: Link Error: Could not allocate section .text.ReadVersion, size = 30 PC units, attributes = code 
.ca/build/502_DEBUGActiveCA/production/mcc_generated_files/boot/boot_process.o: Link Error: Could not allocate section .text.GetMemoryAddressRange, size = 28 PC units, attributes = code 
.ca/build/502_DEBUGActiveCA/production/mcc_generated_files/boot/com_adaptor_uart.o: Link Error: Could not allocate section .text.BOOT_COM_Peek, size = 24 PC units, attributes = code 
.ca/build/502_DEBUGActiveCA/production/mcc_generated_files/uart1.o: Link Error: Could not allocate section .text.UART1_SetTxInterruptHandler, size = 24 PC units, attributes = code 
.ca/build/502_DEBUGActiveCA/production/mcc_generated_files/uart1.o: Link Error: Could not allocate section .text.UART1_SetRxInterruptHandler, size = 24 PC units, attributes = code 
.ca/build/502_DEBUGActiveCA/production/mcc_generated_files/system.o: Link Error: Could not allocate section .text.SYSTEM_Initialize, size = 22 PC units, attributes = code 
.ca/build/502_DEBUGActiveCA/production/mcc_generated_files/uart1.o: Link Error: Could not allocate section .text.UART1_IsRxReady, size = 22 PC units, attributes = code 
.ca/build/502_DEBUGActiveCA/production/mcc_generated_files/system.o: Link Error: Could not allocate section .text.SYSTEM_CORCONModeOperatingSet, size = 18[0m
[31m PC units, attributes = code 
.ca/build/502_DEBUGActiveCA/production/mcc_generated_files/boot/boot_process.o: Link Error: Could not allocate section .text.BOOT_StartApplication, size = 14 PC units, attributes = code 
.ca/build/502_DEBUGActiveCA/production/mcc_generated_files/traps.o: Link Error: Could not allocate section .text.use_failsafe_stack, size = 14 PC units, attributes = code 
.ca/build/502_DEBUGActiveCA/production/mcc_generated_files/system.o: Link Error: Could not allocate section .text.INTERRUPT_GlobalEnable, size = 12 PC units, attributes = code 
.ca/build/502_DEBUGActiveCA/production/mcc_generated_files/traps.o: Link Error: Could not allocate section .text.TRAPS_halt_on_error, size = 10 PC units, attributes = code 
.ca/build/502_DEBUGActiveCA/production/main.o: Link Error: Could not allocate section .text.main, size = 10 PC units, attributes = code 
.ca/build/502_DEBUGActiveCA/production/mcc_generated_files/boot/boot_process.o: Link Error: Could not allocate section .text.Reset, size = 8 PC units, attributes = code 
.ca/build/502_DEBUGActiveCA/production/mcc_generated_files/boot/boot_demo.o: Link Error: Could not allocate section .text.EnterBootloadMode, size = 8 PC units, attributes = code 
.ca/build/502_DEBUGActiveCA/production/mcc_generated_files/boot/boot_process.o: Link Error: Could not allocate section .text.BOOT_Initialize, size = 6 PC units, attributes = code 
.ca/build/502_DEBUGActiveCA/production/mcc_generated_files/boot/boot_demo.o: Link Error: Could not allocate section .text.BOOT_DEMO_Initialize, size = 6 PC units, attributes = code 
.ca/build/502_DEBUGActiveCA/production/mcc_generated_files/uart1.o: Link Error: Could not allocate section .text.UART1_Transmit_CallBack, size = 6 PC units, attributes = code 
.ca/build/502_DEBUGActiveCA/production/mcc_generated_files/uart1.o: Link Error: Could not allocate section .text.UART1_Receive_CallBack, size = 6 PC units, attributes = code 
.ca/build/502_DEBUGActiveCA/production/mcc_generated_files/boot/hardware_interrupt_table.o: Link Error: Could not allocate section .text, size = 4 PC units, attributes = code 
.ca/build/502_DEBUGActiveCA/production/mcc_generated_files/boot/boot_process.o: Link Error: Could not allocate section .text.ResetDevice, size = 48 PC units, attributes = code 
.ca/build/502_DEBUGActiveCA/production/mcc_generated_files/boot/boot_process.o: Link Error: Could not allocate section .text.BOOT_ImageAddressGet, size = 48 PC units, attributes = code 
.ca/build/502_DEBUGActiveCA/production/mcc_generated_files/boot/boot_process.o: Link Error: Could not allocate section .text.IsLegalRange, size = 46 PC units, attributes = code 
.ca/build/502_DEBUGActiveCA/production/mcc_generated_files/boot/boot_process.o: Link Error: Could not allocate section .text.IsLegalAddress, size = 44 PC units, attributes = code 
.ca/build/502_DEBUGActiveCA/production/mcc_generated_files/uart1.o: Link Error: Could not allocate section .text.UART1_Read, size = 44 PC units, attributes = code 
.ca/build/502_DEBUGActiveCA/production/mcc_generated_files/boot/boot_process.o: Link Error: Could not allocate section .text.CommandError, size = 42 PC units, attributes = code 
.ca/build/502_DEBUGActiveCA/production/mcc_generated_files/uart1.o: Link Error: Could not allocate section .text.UART1_Write, size = 42 PC units, attributes = code 
.ca/build/502_DEBUGActiveCA/production/mcc_generated_files/interrupt_manager.o: Link Error: Could not allocate section .text.INTERRUPT_Initialize, size = 36 PC units, attributes = code 
.ca/build/502_DEBUGActiveCA/production/mcc_generated_files/uart1.o: Link Error: Could not allocate section .text.UART1_IsTxDone, size = 34 PC units, attributes = code 
.ca/build/502_DEBUGActiveCA/production/mcc_generated_files/boot/boot_process.o: Link Error: Could not allocate section .text.ReadVersion, size = 30 PC units, attributes = code 
.ca/build/502_DEBUGActiveCA/production/mcc_generated_files/boot/boot_process.o: Link Error: Could not allocate section .text.GetMemoryAddressRange, size = 28 PC units, attributes = code 
.ca/build/502_DEBUGActiveCA/production/mcc_generated_files/boot/com_adaptor_uart.o: Link Error: Could not allocate section .text.BOOT_COM_Peek, size = 24 PC units, attributes = code 
.ca/build/502_DEBUGActiveCA/production/mcc_generated_files/uart1.o: Link Error: Could not allocate section .text.UART1_SetTxInterruptHandler, size = 24 PC units, attributes = code 
.ca/build/502_DEBUGActiveCA/production/mcc_generated_files/uart1.o: Link Error: Could not allocate section .text.UART1_SetRxInterruptHandler, size = 24 PC units, attributes = code 
.ca/build/502_DEBUGActiveCA/production/mcc_generated_files/system.o: Link Error: Could not allocate section .text.SYSTEM_Initialize, size = 22 PC units, attributes = code 
.ca/build/502_DEBUGActiveCA/production/mcc_generated_files/uart1.o: Link Error: Could not allocate section .text.UART1_IsRxReady, size = 22 PC units, attributes = code 
.ca/build/502_DEBUGActiveCA/production/mcc_generated_files/system.o: Link Error: Could not allocate section .text.SYSTEM_CORCONModeOperatingSet, size = 18 PC units, attributes = code 
.ca/build/502_DEBUGActiveCA/production/mcc_generated_files/boot/boot_process.o: Link Error: Could not allocate section .text.BOOT_StartApplication, size = 14 PC units, attributes = code 
.ca/build/502_DEBUGActiveCA/production/mcc_generated_files/traps.o: Link Error: Could not allocate section .text.use_failsafe_stack, size = 14 PC units, attributes = code 
.ca/build/502_DEBUGActiveCA/production/mcc_generated_files/system.o: Link Error: Could not allocate section .text.INTERRUPT_GlobalEnable, size = 12 PC units, attributes = code 
.ca/build/502_DEBUGActiveCA/production/mcc_generated_files/traps.o: Link Error: Could not allocate section .text.TRAPS_halt_on_error, size = 10 PC units, attributes = code 
.ca/build/502_DEBUGActiveCA/production/main.o: Link Error: Could not allocate section .text.main, size = 10 PC units, attributes = code 
.ca/build/502_DEBUGActiveCA/production/mcc_generated_files/boot/boot_process.o: Link Error: Could not allocate section .text.Reset, size = 8 PC units, attributes = code 
.ca/build/502_DEBUGActiveCA/production/mcc_generated_files/boot/boot_demo.o: Link Error: Could not allocate section .text.EnterBootloadMode, size = 8 PC units, attributes = code 
.ca/build/502_DEBUGActiveCA/production/mcc_generated_files/boot/boot_process.o: Link Error: Could not allocate section .text.BOOT_Initialize, size = 6 PC units, attributes = code 
.ca/build/502_DEBUGActiveCA/production/mcc_generated_files/boot/boot_demo.o: Link Error: Could not allocate section .text.BOOT_DEMO_Initialize, size = 6 PC units, attributes = code 
.ca/build/502_DEBUGActiveCA/production/mcc_generated_files/uart1.o: Link Error: Could not allocate section .text.UART1_Transmit_CallBack, size = 6 PC units, attributes = code 
.ca/build/502_DEBUGActiveCA/production/mcc_generated_files/uart1.o: Link Error: Could not allocate section .text.UART1_Receive_CallBack, size = 6 PC units, attributes = code 
.ca/build/502_DEBUGActiveCA/production/mcc_generated_files/boot/hardware_interrupt_table.o: Link Error: Could not allocate section .text, size = 4 PC units, attributes = code 
.ca/build/502_DEBUGActiveCA/production/mcc_generated_files/boot/boot_process.o: Link Error: Could not allocate section .text.BOOT_ImageAddressGet, size = 48 PC units, attributes = code 
.ca/build/502_DEBUGActiveCA/production/mcc_generated_files/boot/boot_process.o: Link Error: Could not allocate section .text.IsLegalRange, size = 46 PC units, attributes = code 
.ca/build/502_DEBUGActiveCA/production/mcc_generated_files/boot/boot_process.o: Link Error: Could not allocate section .text.IsLegalAddress, size = 44 PC units, attributes = code 
.ca/build/502_DEBUGActiveCA/production/mcc_generated_files/uart1.o: Link Error: Could not allocate section .text.UART1_Read, size = 44 PC units, attributes = code 
.ca/build/502_DEBUGActiveCA/production/mcc_generated_files/boot/boot_process.o: Link Error: Could not allocate section .text.CommandError, size = 42 PC units, attributes = code 
.ca/build/502_DEBUGActiveCA/production/mcc_generated_files/uart1.o: Link Error: Could not al[0m
[31mlocate section .text.UART1_Write, size = 42 PC units, attributes = code 
.ca/build/502_DEBUGActiveCA/production/mcc_generated_files/interrupt_manager.o: Link Error: Could not allocate section .text.INTERRUPT_Initialize, size = 36 PC units, attributes = code 
.ca/build/502_DEBUGActiveCA/production/mcc_generated_files/uart1.o: Link Error: Could not allocate section .text.UART1_IsTxDone, size = 34 PC units, attributes = code 
.ca/build/502_DEBUGActiveCA/production/mcc_generated_files/boot/boot_process.o: Link Error: Could not allocate section .text.ReadVersion, size = 30 PC units, attributes = code 
.ca/build/502_DEBUGActiveCA/production/mcc_generated_files/boot/boot_process.o: Link Error: Could not allocate section .text.GetMemoryAddressRange, size = 28 PC units, attributes = code 
.ca/build/502_DEBUGActiveCA/production/mcc_generated_files/boot/com_adaptor_uart.o: Link Error: Could not allocate section .text.BOOT_COM_Peek, size = 24 PC units, attributes = code 
.ca/build/502_DEBUGActiveCA/production/mcc_generated_files/uart1.o: Link Error: Could not allocate section .text.UART1_SetTxInterruptHandler, size = 24 PC units, attributes = code 
.ca/build/502_DEBUGActiveCA/production/mcc_generated_files/uart1.o: Link Error: Could not allocate section .text.UART1_SetRxInterruptHandler, size = 24 PC units, attributes = code 
.ca/build/502_DEBUGActiveCA/production/mcc_generated_files/system.o: Link Error: Could not allocate section .text.SYSTEM_Initialize, size = 22 PC units, attributes = code 
.ca/build/502_DEBUGActiveCA/production/mcc_generated_files/uart1.o: Link Error: Could not allocate section .text.UART1_IsRxReady, size = 22 PC units, attributes = code 
.ca/build/502_DEBUGActiveCA/production/mcc_generated_files/system.o: Link Error: Could not allocate section .text.SYSTEM_CORCONModeOperatingSet, size = 18 PC units, attributes = code 
.ca/build/502_DEBUGActiveCA/production/mcc_generated_files/boot/boot_process.o: Link Error: Could not allocate section .text.BOOT_StartApplication, size = 14 PC units, attributes = code 
.ca/build/502_DEBUGActiveCA/production/mcc_generated_files/traps.o: Link Error: Could not allocate section .text.use_failsafe_stack, size = 14 PC units, attributes = code 
.ca/build/502_DEBUGActiveCA/production/mcc_generated_files/system.o: Link Error: Could not allocate section .text.INTERRUPT_GlobalEnable, size = 12 PC units, attributes = code 
.ca/build/502_DEBUGActiveCA/production/mcc_generated_files/traps.o: Link Error: Could not allocate section .text.TRAPS_halt_on_error, size = 10 PC units, attributes = code 
.ca/build/502_DEBUGActiveCA/production/main.o: Link Error: Could not allocate section .text.main, size = 10 PC units, attributes = code 
.ca/build/502_DEBUGActiveCA/production/mcc_generated_files/boot/boot_process.o: Link Error: Could not allocate section .text.Reset, size = 8 PC units, attributes = code 
.ca/build/502_DEBUGActiveCA/production/mcc_generated_files/boot/boot_demo.o: Link Error: Could not allocate section .text.EnterBootloadMode, size = 8 PC units, attributes = code 
.ca/build/502_DEBUGActiveCA/production/mcc_generated_files/boot/boot_process.o: Link Error: Could not allocate section .text.BOOT_Initialize, size = 6 PC units, attributes = code 
.ca/build/502_DEBUGActiveCA/production/mcc_generated_files/boot/boot_demo.o: Link Error: Could not allocate section .text.BOOT_DEMO_Initialize, size = 6 PC units, attributes = code 
.ca/build/502_DEBUGActiveCA/production/mcc_generated_files/uart1.o: Link Error: Could not allocate section .text.UART1_Transmit_CallBack, size = 6 PC units, attributes = code 
.ca/build/502_DEBUGActiveCA/production/mcc_generated_files/uart1.o: Link Error: Could not allocate section .text.UART1_Receive_CallBack, size = 6 PC units, attributes = code 
.ca/build/502_DEBUGActiveCA/production/mcc_generated_files/boot/hardware_interrupt_table.o: Link Error: Could not allocate section .text, size = 4 PC units, attributes = code 
.ca/build/502_DEBUGActiveCA/production/mcc_generated_files/boot/boot_process.o: Link Error: Could not allocate section .text.IsLegalAddress, size = 44 PC units, attributes = code 
.ca/build/502_DEBUGActiveCA/production/mcc_generated_files/uart1.o: Link Error: Could not allocate section .text.UART1_Read, size = 44 PC units, attributes = code 
.ca/build/502_DEBUGActiveCA/production/mcc_generated_files/boot/boot_process.o: Link Error: Could not allocate section .text.CommandError, size = 42 PC units, attributes = code 
.ca/build/502_DEBUGActiveCA/production/mcc_generated_files/uart1.o: Link Error: Could not allocate section .text.UART1_Write, size = 42 PC units, attributes = code 
.ca/build/502_DEBUGActiveCA/production/mcc_generated_files/interrupt_manager.o: Link Error: Could not allocate section .text.INTERRUPT_Initialize, size = 36 PC units, attributes = code 
.ca/build/502_DEBUGActiveCA/production/mcc_generated_files/uart1.o: Link Error: Could not allocate section .text.UART1_IsTxDone, size = 34 PC units, attributes = code 
.ca/build/502_DEBUGActiveCA/production/mcc_generated_files/boot/boot_process.o: Link Error: Could not allocate section .text.ReadVersion, size = 30 PC units, attributes = code 
.ca/build/502_DEBUGActiveCA/production/mcc_generated_files/boot/boot_process.o: Link Error: Could not allocate section .text.GetMemoryAddressRange, size = 28 PC units, attributes = code 
.ca/build/502_DEBUGActiveCA/production/mcc_generated_files/boot/com_adaptor_uart.o: Link Error: Could not allocate section .text.BOOT_COM_Peek, size = 24 PC units, attributes = code 
.ca/build/502_DEBUGActiveCA/production/mcc_generated_files/uart1.o: Link Error: Could not allocate section .text.UART1_SetTxInterruptHandler, size = 24 PC units, attributes = code 
.ca/build/502_DEBUGActiveCA/production/mcc_generated_files/uart1.o: Link Error: Could not allocate section .text.UART1_SetRxInterruptHandler, size = 24 PC units, attributes = code 
.ca/build/502_DEBUGActiveCA/production/mcc_generated_files/system.o: Link Error: Could not allocate section .text.SYSTEM_Initialize, size = 22 PC units, attributes = code 
.ca/build/502_DEBUGActiveCA/production/mcc_generated_files/uart1.o: Link Error: Could not allocate section .text.UART1_IsRxReady, size = 22 PC units, attributes = code 
.ca/build/502_DEBUGActiveCA/production/mcc_generated_files/system.o: Link Error: Could not allocate section .text.SYSTEM_CORCONModeOperatingSet, size = 18 PC units, attributes = code 
.ca/build/502_DEBUGActiveCA/production/mcc_generated_files/boot/boot_process.o: Link Error: Could not allocate section .text.BOOT_StartApplication, size = 14 PC units, attributes = code 
.ca/build/502_DEBUGActiveCA/production/mcc_generated_files/traps.o: Link Error: Could not allocate section .text.use_failsafe_stack, size = 14 PC units, attributes = code 
.ca/build/502_DEBUGActiveCA/production/mcc_generated_files/system.o: Link Error: Could not allocate section .text.INTERRUPT_GlobalEnable, size = 12 PC units, attributes = code 
.ca/build/502_DEBUGActiveCA/production/mcc_generated_files/traps.o: Link Error: Could not allocate section .text.TRAPS_halt_on_error, size = 10 PC units, attributes = code 
.ca/build/502_DEBUGActiveCA/production/main.o: Link Error: Could not allocate section .text.main, size = 10 PC units, attributes = code 
.ca/build/502_DEBUGActiveCA/production/mcc_generated_files/boot/boot_process.o: Link Error: Could not allocate section .text.Reset, size = 8 PC units, attributes = code 
.ca/build/502_DEBUGActiveCA/production/mcc_generated_files/boot/boot_demo.o: Link Error: Could not allocate section .text.EnterBootloadMode, size = 8 PC units, attributes = code 
.ca/build/502_DEBUGActiveCA/production/mcc_generated_files/boot/boot_process.o: Link Error: Could not allocate section .text.BOOT_Initialize, size = 6 PC units, attributes = code 
.ca/build/502_DEBUGActiveCA/production/mcc_generated_files/boot/boot_demo.o: Link Error: Could not allocate section .text.BOOT_DEMO_Initialize, size = 6 PC units, attributes = code 
.ca/build/502_DEBUGActiveCA/production/mcc_generated_files/uart1.o: Link Error: Could not allocate section .text.UART1_Transmit_CallBack, size = 6 PC units, attributes = code 
.ca/build/502_DEBUGActiveCA/production/[0m
[31mmcc_generated_files/uart1.o: Link Error: Could not allocate section .text.UART1_Receive_CallBack, size = 6 PC units, attributes = code 
.ca/build/502_DEBUGActiveCA/production/mcc_generated_files/boot/hardware_interrupt_table.o: Link Error: Could not allocate section .text, size = 4 PC units, attributes = code 
.ca/build/502_DEBUGActiveCA/production/mcc_generated_files/uart1.o: Link Error: Could not allocate section .text.UART1_Read, size = 44 PC units, attributes = code 
.ca/build/502_DEBUGActiveCA/production/mcc_generated_files/boot/boot_process.o: Link Error: Could not allocate section .text.CommandError, size = 42 PC units, attributes = code 
.ca/build/502_DEBUGActiveCA/production/mcc_generated_files/uart1.o: Link Error: Could not allocate section .text.UART1_Write, size = 42 PC units, attributes = code 
.ca/build/502_DEBUGActiveCA/production/mcc_generated_files/interrupt_manager.o: Link Error: Could not allocate section .text.INTERRUPT_Initialize, size = 36 PC units, attributes = code 
.ca/build/502_DEBUGActiveCA/production/mcc_generated_files/uart1.o: Link Error: Could not allocate section .text.UART1_IsTxDone, size = 34 PC units, attributes = code 
.ca/build/502_DEBUGActiveCA/production/mcc_generated_files/boot/boot_process.o: Link Error: Could not allocate section .text.ReadVersion, size = 30 PC units, attributes = code 
.ca/build/502_DEBUGActiveCA/production/mcc_generated_files/boot/boot_process.o: Link Error: Could not allocate section .text.GetMemoryAddressRange, size = 28 PC units, attributes = code 
.ca/build/502_DEBUGActiveCA/production/mcc_generated_files/boot/com_adaptor_uart.o: Link Error: Could not allocate section .text.BOOT_COM_Peek, size = 24 PC units, attributes = code 
.ca/build/502_DEBUGActiveCA/production/mcc_generated_files/uart1.o: Link Error: Could not allocate section .text.UART1_SetTxInterruptHandler, size = 24 PC units, attributes = code 
.ca/build/502_DEBUGActiveCA/production/mcc_generated_files/uart1.o: Link Error: Could not allocate section .text.UART1_SetRxInterruptHandler, size = 24 PC units, attributes = code 
.ca/build/502_DEBUGActiveCA/production/mcc_generated_files/system.o: Link Error: Could not allocate section .text.SYSTEM_Initialize, size = 22 PC units, attributes = code 
.ca/build/502_DEBUGActiveCA/production/mcc_generated_files/uart1.o: Link Error: Could not allocate section .text.UART1_IsRxReady, size = 22 PC units, attributes = code 
.ca/build/502_DEBUGActiveCA/production/mcc_generated_files/system.o: Link Error: Could not allocate section .text.SYSTEM_CORCONModeOperatingSet, size = 18 PC units, attributes = code 
.ca/build/502_DEBUGActiveCA/production/mcc_generated_files/boot/boot_process.o: Link Error: Could not allocate section .text.BOOT_StartApplication, size = 14 PC units, attributes = code 
.ca/build/502_DEBUGActiveCA/production/mcc_generated_files/traps.o: Link Error: Could not allocate section .text.use_failsafe_stack, size = 14 PC units, attributes = code 
.ca/build/502_DEBUGActiveCA/production/mcc_generated_files/system.o: Link Error: Could not allocate section .text.INTERRUPT_GlobalEnable, size = 12 PC units, attributes = code 
.ca/build/502_DEBUGActiveCA/production/mcc_generated_files/traps.o: Link Error: Could not allocate section .text.TRAPS_halt_on_error, size = 10 PC units, attributes = code 
.ca/build/502_DEBUGActiveCA/production/main.o: Link Error: Could not allocate section .text.main, size = 10 PC units, attributes = code 
.ca/build/502_DEBUGActiveCA/production/mcc_generated_files/boot/boot_process.o: Link Error: Could not allocate section .text.Reset, size = 8 PC units, attributes = code 
.ca/build/502_DEBUGActiveCA/production/mcc_generated_files/boot/boot_demo.o: Link Error: Could not allocate section .text.EnterBootloadMode, size = 8 PC units, attributes = code 
.ca/build/502_DEBUGActiveCA/production/mcc_generated_files/boot/boot_process.o: Link Error: Could not allocate section .text.BOOT_Initialize, size = 6 PC units, attributes = code 
.ca/build/502_DEBUGActiveCA/production/mcc_generated_files/boot/boot_demo.o: Link Error: Could not allocate section .text.BOOT_DEMO_Initialize, size = 6 PC units, attributes = code 
.ca/build/502_DEBUGActiveCA/production/mcc_generated_files/uart1.o: Link Error: Could not allocate section .text.UART1_Transmit_CallBack, size = 6 PC units, attributes = code 
.ca/build/502_DEBUGActiveCA/production/mcc_generated_files/uart1.o: Link Error: Could not allocate section .text.UART1_Receive_CallBack, size = 6 PC units, attributes = code 
.ca/build/502_DEBUGActiveCA/production/mcc_generated_files/boot/hardware_interrupt_table.o: Link Error: Could not allocate section .text, size = 4 PC units, attributes = code 
.ca/build/502_DEBUGActiveCA/production/mcc_generated_files/boot/boot_process.o: Link Error: Could not allocate section .text.CommandError, size = 42 PC units, attributes = code 
.ca/build/502_DEBUGActiveCA/production/mcc_generated_files/uart1.o: Link Error: Could not allocate section .text.UART1_Write, size = 42 PC units, attributes = code 
.ca/build/502_DEBUGActiveCA/production/mcc_generated_files/interrupt_manager.o: Link Error: Could not allocate section .text.INTERRUPT_Initialize, size = 36 PC units, attributes = code 
.ca/build/502_DEBUGActiveCA/production/mcc_generated_files/uart1.o: Link Error: Could not allocate section .text.UART1_IsTxDone, size = 34 PC units, attributes = code 
.ca/build/502_DEBUGActiveCA/production/mcc_generated_files/boot/boot_process.o: Link Error: Could not allocate section .text.ReadVersion, size = 30 PC units, attributes = code 
.ca/build/502_DEBUGActiveCA/production/mcc_generated_files/boot/boot_process.o: Link Error: Could not allocate section .text.GetMemoryAddressRange, size = 28 PC units, attributes = code 
.ca/build/502_DEBUGActiveCA/production/mcc_generated_files/boot/com_adaptor_uart.o: Link Error: Could not allocate section .text.BOOT_COM_Peek, size = 24 PC units, attributes = code 
.ca/build/502_DEBUGActiveCA/production/mcc_generated_files/uart1.o: Link Error: Could not allocate section .text.UART1_SetTxInterruptHandler, size = 24 PC units, attributes = code 
.ca/build/502_DEBUGActiveCA/production/mcc_generated_files/uart1.o: Link Error: Could not allocate section .text.UART1_SetRxInterruptHandler, size = 24 PC units, attributes = code 
.ca/build/502_DEBUGActiveCA/production/mcc_generated_files/system.o: Link Error: Could not allocate section .text.SYSTEM_Initialize, size = 22 PC units, attributes = code 
.ca/build/502_DEBUGActiveCA/production/mcc_generated_files/uart1.o: Link Error: Could not allocate section .text.UART1_IsRxReady, size = 22 PC units, attributes = code 
.ca/build/502_DEBUGActiveCA/production/mcc_generated_files/system.o: Link Error: Could not allocate section .text.SYSTEM_CORCONModeOperatingSet, size = 18 PC units, attributes = code 
.ca/build/502_DEBUGActiveCA/production/mcc_generated_files/boot/boot_process.o: Link Error: Could not allocate section .text.BOOT_StartApplication, size = 14 PC units, attributes = code 
.ca/build/502_DEBUGActiveCA/production/mcc_generated_files/traps.o: Link Error: Could not allocate section .text.use_failsafe_stack, size = 14 PC units, attributes = code 
.ca/build/502_DEBUGActiveCA/production/mcc_generated_files/system.o: Link Error: Could not allocate section .text.INTERRUPT_GlobalEnable, size = 12 PC units, attributes = code 
.ca/build/502_DEBUGActiveCA/production/mcc_generated_files/traps.o: Link Error: Could not allocate section .text.TRAPS_halt_on_error, size = 10 PC units, attributes = code 
.ca/build/502_DEBUGActiveCA/production/main.o: Link Error: Could not allocate section .text.main, size = 10 PC units, attributes = code 
.ca/build/502_DEBUGActiveCA/production/mcc_generated_files/boot/boot_process.o: Link Error: Could not allocate section .text.Reset, size = 8 PC units, attributes = code 
.ca/build/502_DEBUGActiveCA/production/mcc_generated_files/boot/boot_demo.o: Link Error: Could not allocate section .text.EnterBootloadMode, size = 8 PC units, attributes = code 
.ca/build/502_DEBUGActiveCA/production/mcc_generated_files/boot/boot_process.o: Link Error: Could not allocate section .text.BOOT_Initialize, size = 6 PC units, attributes = c[0m
[31mode 
.ca/build/502_DEBUGActiveCA/production/mcc_generated_files/boot/boot_demo.o: Link Error: Could not allocate section .text.BOOT_DEMO_Initialize, size = 6 PC units, attributes = code 
.ca/build/502_DEBUGActiveCA/production/mcc_generated_files/uart1.o: Link Error: Could not allocate section .text.UART1_Transmit_CallBack, size = 6 PC units, attributes = code 
.ca/build/502_DEBUGActiveCA/production/mcc_generated_files/uart1.o: Link Error: Could not allocate section .text.UART1_Receive_CallBack, size = 6 PC units, attributes = code 
.ca/build/502_DEBUGActiveCA/production/mcc_generated_files/boot/hardware_interrupt_table.o: Link Error: Could not allocate section .text, size = 4 PC units, attributes = code 
.ca/build/502_DEBUGActiveCA/production/mcc_generated_files/uart1.o: Link Error: Could not allocate section .text.UART1_Write, size = 42 PC units, attributes = code 
.ca/build/502_DEBUGActiveCA/production/mcc_generated_files/interrupt_manager.o: Link Error: Could not allocate section .text.INTERRUPT_Initialize, size = 36 PC units, attributes = code 
.ca/build/502_DEBUGActiveCA/production/mcc_generated_files/uart1.o: Link Error: Could not allocate section .text.UART1_IsTxDone, size = 34 PC units, attributes = code 
.ca/build/502_DEBUGActiveCA/production/mcc_generated_files/boot/boot_process.o: Link Error: Could not allocate section .text.ReadVersion, size = 30 PC units, attributes = code 
.ca/build/502_DEBUGActiveCA/production/mcc_generated_files/boot/boot_process.o: Link Error: Could not allocate section .text.GetMemoryAddressRange, size = 28 PC units, attributes = code 
.ca/build/502_DEBUGActiveCA/production/mcc_generated_files/boot/com_adaptor_uart.o: Link Error: Could not allocate section .text.BOOT_COM_Peek, size = 24 PC units, attributes = code 
.ca/build/502_DEBUGActiveCA/production/mcc_generated_files/uart1.o: Link Error: Could not allocate section .text.UART1_SetTxInterruptHandler, size = 24 PC units, attributes = code 
.ca/build/502_DEBUGActiveCA/production/mcc_generated_files/uart1.o: Link Error: Could not allocate section .text.UART1_SetRxInterruptHandler, size = 24 PC units, attributes = code 
.ca/build/502_DEBUGActiveCA/production/mcc_generated_files/system.o: Link Error: Could not allocate section .text.SYSTEM_Initialize, size = 22 PC units, attributes = code 
.ca/build/502_DEBUGActiveCA/production/mcc_generated_files/uart1.o: Link Error: Could not allocate section .text.UART1_IsRxReady, size = 22 PC units, attributes = code 
.ca/build/502_DEBUGActiveCA/production/mcc_generated_files/system.o: Link Error: Could not allocate section .text.SYSTEM_CORCONModeOperatingSet, size = 18 PC units, attributes = code 
.ca/build/502_DEBUGActiveCA/production/mcc_generated_files/boot/boot_process.o: Link Error: Could not allocate section .text.BOOT_StartApplication, size = 14 PC units, attributes = code 
.ca/build/502_DEBUGActiveCA/production/mcc_generated_files/traps.o: Link Error: Could not allocate section .text.use_failsafe_stack, size = 14 PC units, attributes = code 
.ca/build/502_DEBUGActiveCA/production/mcc_generated_files/system.o: Link Error: Could not allocate section .text.INTERRUPT_GlobalEnable, size = 12 PC units, attributes = code 
.ca/build/502_DEBUGActiveCA/production/mcc_generated_files/traps.o: Link Error: Could not allocate section .text.TRAPS_halt_on_error, size = 10 PC units, attributes = code 
.ca/build/502_DEBUGActiveCA/production/main.o: Link Error: Could not allocate section .text.main, size = 10 PC units, attributes = code 
.ca/build/502_DEBUGActiveCA/production/mcc_generated_files/boot/boot_process.o: Link Error: Could not allocate section .text.Reset, size = 8 PC units, attributes = code 
.ca/build/502_DEBUGActiveCA/production/mcc_generated_files/boot/boot_demo.o: Link Error: Could not allocate section .text.EnterBootloadMode, size = 8 PC units, attributes = code 
.ca/build/502_DEBUGActiveCA/production/mcc_generated_files/boot/boot_process.o: Link Error: Could not allocate section .text.BOOT_Initialize, size = 6 PC units, attributes = code 
.ca/build/502_DEBUGActiveCA/production/mcc_generated_files/boot/boot_demo.o: Link Error: Could not allocate section .text.BOOT_DEMO_Initialize, size = 6 PC units, attributes = code 
.ca/build/502_DEBUGActiveCA/production/mcc_generated_files/uart1.o: Link Error: Could not allocate section .text.UART1_Transmit_CallBack, size = 6 PC units, attributes = code 
.ca/build/502_DEBUGActiveCA/production/mcc_generated_files/uart1.o: Link Error: Could not allocate section .text.UART1_Receive_CallBack, size = 6 PC units, attributes = code 
.ca/build/502_DEBUGActiveCA/production/mcc_generated_files/boot/hardware_interrupt_table.o: Link Error: Could not allocate section .text, size = 4 PC units, attributes = code 
.ca/build/502_DEBUGActiveCA/production/mcc_generated_files/interrupt_manager.o: Link Error: Could not allocate section .text.INTERRUPT_Initialize, size = 36 PC units, attributes = code 
.ca/build/502_DEBUGActiveCA/production/mcc_generated_files/uart1.o: Link Error: Could not allocate section .text.UART1_IsTxDone, size = 34 PC units, attributes = code 
.ca/build/502_DEBUGActiveCA/production/mcc_generated_files/boot/boot_process.o: Link Error: Could not allocate section .text.ReadVersion, size = 30 PC units, attributes = code 
.ca/build/502_DEBUGActiveCA/production/mcc_generated_files/boot/boot_process.o: Link Error: Could not allocate section .text.GetMemoryAddressRange, size = 28 PC units, attributes = code 
.ca/build/502_DEBUGActiveCA/production/mcc_generated_files/boot/com_adaptor_uart.o: Link Error: Could not allocate section .text.BOOT_COM_Peek, size = 24 PC units, attributes = code 
.ca/build/502_DEBUGActiveCA/production/mcc_generated_files/uart1.o: Link Error: Could not allocate section .text.UART1_SetTxInterruptHandler, size = 24 PC units, attributes = code 
.ca/build/502_DEBUGActiveCA/production/mcc_generated_files/uart1.o: Link Error: Could not allocate section .text.UART1_SetRxInterruptHandler, size = 24 PC units, attributes = code 
.ca/build/502_DEBUGActiveCA/production/mcc_generated_files/system.o: Link Error: Could not allocate section .text.SYSTEM_Initialize, size = 22 PC units, attributes = code 
.ca/build/502_DEBUGActiveCA/production/mcc_generated_files/uart1.o: Link Error: Could not allocate section .text.UART1_IsRxReady, size = 22 PC units, attributes = code 
.ca/build/502_DEBUGActiveCA/production/mcc_generated_files/system.o: Link Error: Could not allocate section .text.SYSTEM_CORCONModeOperatingSet, size = 18 PC units, attributes = code 
.ca/build/502_DEBUGActiveCA/production/mcc_generated_files/boot/boot_process.o: Link Error: Could not allocate section .text.BOOT_StartApplication, size = 14 PC units, attributes = code 
.ca/build/502_DEBUGActiveCA/production/mcc_generated_files/traps.o: Link Error: Could not allocate section .text.use_failsafe_stack, size = 14 PC units, attributes = code 
.ca/build/502_DEBUGActiveCA/production/mcc_generated_files/system.o: Link Error: Could not allocate section .text.INTERRUPT_GlobalEnable, size = 12 PC units, attributes = code 
.ca/build/502_DEBUGActiveCA/production/mcc_generated_files/traps.o: Link Error: Could not allocate section .text.TRAPS_halt_on_error, size = 10 PC units, attributes = code 
.ca/build/502_DEBUGActiveCA/production/main.o: Link Error: Could not allocate section .text.main, size = 10 PC units, attributes = code 
.ca/build/502_DEBUGActiveCA/production/mcc_generated_files/boot/boot_process.o: Link Error: Could not allocate section .text.Reset, size = 8 PC units, attributes = code 
.ca/build/502_DEBUGActiveCA/production/mcc_generated_files/boot/boot_demo.o: Link Error: Could not allocate section .text.EnterBootloadMode, size = 8 PC units, attributes = code 
.ca/build/502_DEBUGActiveCA/production/mcc_generated_files/boot/boot_process.o: Link Error: Could not allocate section .text.BOOT_Initialize, size = 6 PC units, attributes = code 
.ca/build/502_DEBUGActiveCA/production/mcc_generated_files/boot/boot_demo.o: Link Error: Could not allocate section .text.BOOT_DEMO_Initialize, size = 6 PC units, attributes = code 
.ca/build/502_DEBUGActiveCA/production/mcc_generated_files/uart1.o: Link Error: Could not alloca[0m
[31mte section .text.UART1_Transmit_CallBack, size = 6 PC units, attributes = code 
.ca/build/502_DEBUGActiveCA/production/mcc_generated_files/uart1.o: Link Error: Could not allocate section .text.UART1_Receive_CallBack, size = 6 PC units, attributes = code 
.ca/build/502_DEBUGActiveCA/production/mcc_generated_files/boot/hardware_interrupt_table.o: Link Error: Could not allocate section .text, size = 4 PC units, attributes = code 
.ca/build/502_DEBUGActiveCA/production/mcc_generated_files/uart1.o: Link Error: Could not allocate section .text.UART1_IsTxDone, size = 34 PC units, attributes = code 
.ca/build/502_DEBUGActiveCA/production/mcc_generated_files/boot/boot_process.o: Link Error: Could not allocate section .text.ReadVersion, size = 30 PC units, attributes = code 
.ca/build/502_DEBUGActiveCA/production/mcc_generated_files/boot/boot_process.o: Link Error: Could not allocate section .text.GetMemoryAddressRange, size = 28 PC units, attributes = code 
.ca/build/502_DEBUGActiveCA/production/mcc_generated_files/boot/com_adaptor_uart.o: Link Error: Could not allocate section .text.BOOT_COM_Peek, size = 24 PC units, attributes = code 
.ca/build/502_DEBUGActiveCA/production/mcc_generated_files/uart1.o: Link Error: Could not allocate section .text.UART1_SetTxInterruptHandler, size = 24 PC units, attributes = code 
.ca/build/502_DEBUGActiveCA/production/mcc_generated_files/uart1.o: Link Error: Could not allocate section .text.UART1_SetRxInterruptHandler, size = 24 PC units, attributes = code 
.ca/build/502_DEBUGActiveCA/production/mcc_generated_files/system.o: Link Error: Could not allocate section .text.SYSTEM_Initialize, size = 22 PC units, attributes = code 
.ca/build/502_DEBUGActiveCA/production/mcc_generated_files/uart1.o: Link Error: Could not allocate section .text.UART1_IsRxReady, size = 22 PC units, attributes = code 
.ca/build/502_DEBUGActiveCA/production/mcc_generated_files/system.o: Link Error: Could not allocate section .text.SYSTEM_CORCONModeOperatingSet, size = 18 PC units, attributes = code 
.ca/build/502_DEBUGActiveCA/production/mcc_generated_files/boot/boot_process.o: Link Error: Could not allocate section .text.BOOT_StartApplication, size = 14 PC units, attributes = code 
.ca/build/502_DEBUGActiveCA/production/mcc_generated_files/traps.o: Link Error: Could not allocate section .text.use_failsafe_stack, size = 14 PC units, attributes = code 
.ca/build/502_DEBUGActiveCA/production/mcc_generated_files/system.o: Link Error: Could not allocate section .text.INTERRUPT_GlobalEnable, size = 12 PC units, attributes = code 
.ca/build/502_DEBUGActiveCA/production/mcc_generated_files/traps.o: Link Error: Could not allocate section .text.TRAPS_halt_on_error, size = 10 PC units, attributes = code 
.ca/build/502_DEBUGActiveCA/production/main.o: Link Error: Could not allocate section .text.main, size = 10 PC units, attributes = code 
.ca/build/502_DEBUGActiveCA/production/mcc_generated_files/boot/boot_process.o: Link Error: Could not allocate section .text.Reset, size = 8 PC units, attributes = code 
.ca/build/502_DEBUGActiveCA/production/mcc_generated_files/boot/boot_demo.o: Link Error: Could not allocate section .text.EnterBootloadMode, size = 8 PC units, attributes = code 
.ca/build/502_DEBUGActiveCA/production/mcc_generated_files/boot/boot_process.o: Link Error: Could not allocate section .text.BOOT_Initialize, size = 6 PC units, attributes = code 
.ca/build/502_DEBUGActiveCA/production/mcc_generated_files/boot/boot_demo.o: Link Error: Could not allocate section .text.BOOT_DEMO_Initialize, size = 6 PC units, attributes = code 
.ca/build/502_DEBUGActiveCA/production/mcc_generated_files/uart1.o: Link Error: Could not allocate section .text.UART1_Transmit_CallBack, size = 6 PC units, attributes = code 
.ca/build/502_DEBUGActiveCA/production/mcc_generated_files/uart1.o: Link Error: Could not allocate section .text.UART1_Receive_CallBack, size = 6 PC units, attributes = code 
.ca/build/502_DEBUGActiveCA/production/mcc_generated_files/boot/hardware_interrupt_table.o: Link Error: Could not allocate section .text, size = 4 PC units, attributes = code 
.ca/build/502_DEBUGActiveCA/production/mcc_generated_files/boot/boot_process.o: Link Error: Could not allocate section .text.ReadVersion, size = 30 PC units, attributes = code 
.ca/build/502_DEBUGActiveCA/production/mcc_generated_files/boot/boot_process.o: Link Error: Could not allocate section .text.GetMemoryAddressRange, size = 28 PC units, attributes = code 
.ca/build/502_DEBUGActiveCA/production/mcc_generated_files/boot/com_adaptor_uart.o: Link Error: Could not allocate section .text.BOOT_COM_Peek, size = 24 PC units, attributes = code 
.ca/build/502_DEBUGActiveCA/production/mcc_generated_files/uart1.o: Link Error: Could not allocate section .text.UART1_SetTxInterruptHandler, size = 24 PC units, attributes = code 
.ca/build/502_DEBUGActiveCA/production/mcc_generated_files/uart1.o: Link Error: Could not allocate section .text.UART1_SetRxInterruptHandler, size = 24 PC units, attributes = code 
.ca/build/502_DEBUGActiveCA/production/mcc_generated_files/system.o: Link Error: Could not allocate section .text.SYSTEM_Initialize, size = 22 PC units, attributes = code 
.ca/build/502_DEBUGActiveCA/production/mcc_generated_files/uart1.o: Link Error: Could not allocate section .text.UART1_IsRxReady, size = 22 PC units, attributes = code 
.ca/build/502_DEBUGActiveCA/production/mcc_generated_files/system.o: Link Error: Could not allocate section .text.SYSTEM_CORCONModeOperatingSet, size = 18 PC units, attributes = code 
.ca/build/502_DEBUGActiveCA/production/mcc_generated_files/boot/boot_process.o: Link Error: Could not allocate section .text.BOOT_StartApplication, size = 14 PC units, attributes = code 
.ca/build/502_DEBUGActiveCA/production/mcc_generated_files/traps.o: Link Error: Could not allocate section .text.use_failsafe_stack, size = 14 PC units, attributes = code 
.ca/build/502_DEBUGActiveCA/production/mcc_generated_files/system.o: Link Error: Could not allocate section .text.INTERRUPT_GlobalEnable, size = 12 PC units, attributes = code 
.ca/build/502_DEBUGActiveCA/production/mcc_generated_files/traps.o: Link Error: Could not allocate section .text.TRAPS_halt_on_error, size = 10 PC units, attributes = code 
.ca/build/502_DEBUGActiveCA/production/main.o: Link Error: Could not allocate section .text.main, size = 10 PC units, attributes = code 
.ca/build/502_DEBUGActiveCA/production/mcc_generated_files/boot/boot_process.o: Link Error: Could not allocate section .text.Reset, size = 8 PC units, attributes = code 
.ca/build/502_DEBUGActiveCA/production/mcc_generated_files/boot/boot_demo.o: Link Error: Could not allocate section .text.EnterBootloadMode, size = 8 PC units, attributes = code 
.ca/build/502_DEBUGActiveCA/production/mcc_generated_files/boot/boot_process.o: Link Error: Could not allocate section .text.BOOT_Initialize, size = 6 PC units, attributes = code 
.ca/build/502_DEBUGActiveCA/production/mcc_generated_files/boot/boot_demo.o: Link Error: Could not allocate section .text.BOOT_DEMO_Initialize, size = 6 PC units, attributes = code 
.ca/build/502_DEBUGActiveCA/production/mcc_generated_files/uart1.o: Link Error: Could not allocate section .text.UART1_Transmit_CallBack, size = 6 PC units, attributes = code 
.ca/build/502_DEBUGActiveCA/production/mcc_generated_files/uart1.o: Link Error: Could not allocate section .text.UART1_Receive_CallBack, size = 6 PC units, attributes = code 
.ca/build/502_DEBUGActiveCA/production/mcc_generated_files/boot/hardware_interrupt_table.o: Link Error: Could not allocate section .text, size = 4 PC units, attributes = code 
.ca/build/502_DEBUGActiveCA/production/mcc_generated_files/boot/boot_process.o: Link Error: Could not allocate section .text.GetMemoryAddressRange, size = 28 PC units, attributes = code 
.ca/build/502_DEBUGActiveCA/production/mcc_generated_files/boot/com_adaptor_uart.o: Link Error: Could not allocate section .text.BOOT_COM_Peek, size = 24 PC units, attributes = code 
.ca/build/502_DEBUGActiveCA/production/mcc_generated_files/uart1.o: Link Error: Could not allocate section .text.UART1_SetTxInterruptHandler, size = 24 PC units, attributes = code 
.ca/bu[0m
[31mild/502_DEBUGActiveCA/production/mcc_generated_files/uart1.o: Link Error: Could not allocate section .text.UART1_SetRxInterruptHandler, size = 24 PC units, attributes = code 
.ca/build/502_DEBUGActiveCA/production/mcc_generated_files/system.o: Link Error: Could not allocate section .text.SYSTEM_Initialize, size = 22 PC units, attributes = code 
.ca/build/502_DEBUGActiveCA/production/mcc_generated_files/uart1.o: Link Error: Could not allocate section .text.UART1_IsRxReady, size = 22 PC units, attributes = code 
.ca/build/502_DEBUGActiveCA/production/mcc_generated_files/system.o: Link Error: Could not allocate section .text.SYSTEM_CORCONModeOperatingSet, size = 18 PC units, attributes = code 
.ca/build/502_DEBUGActiveCA/production/mcc_generated_files/boot/boot_process.o: Link Error: Could not allocate section .text.BOOT_StartApplication, size = 14 PC units, attributes = code 
.ca/build/502_DEBUGActiveCA/production/mcc_generated_files/traps.o: Link Error: Could not allocate section .text.use_failsafe_stack, size = 14 PC units, attributes = code 
.ca/build/502_DEBUGActiveCA/production/mcc_generated_files/system.o: Link Error: Could not allocate section .text.INTERRUPT_GlobalEnable, size = 12 PC units, attributes = code 
.ca/build/502_DEBUGActiveCA/production/mcc_generated_files/traps.o: Link Error: Could not allocate section .text.TRAPS_halt_on_error, size = 10 PC units, attributes = code 
.ca/build/502_DEBUGActiveCA/production/main.o: Link Error: Could not allocate section .text.main, size = 10 PC units, attributes = code 
.ca/build/502_DEBUGActiveCA/production/mcc_generated_files/boot/boot_process.o: Link Error: Could not allocate section .text.Reset, size = 8 PC units, attributes = code 
.ca/build/502_DEBUGActiveCA/production/mcc_generated_files/boot/boot_demo.o: Link Error: Could not allocate section .text.EnterBootloadMode, size = 8 PC units, attributes = code 
.ca/build/502_DEBUGActiveCA/production/mcc_generated_files/boot/boot_process.o: Link Error: Could not allocate section .text.BOOT_Initialize, size = 6 PC units, attributes = code 
.ca/build/502_DEBUGActiveCA/production/mcc_generated_files/boot/boot_demo.o: Link Error: Could not allocate section .text.BOOT_DEMO_Initialize, size = 6 PC units, attributes = code 
.ca/build/502_DEBUGActiveCA/production/mcc_generated_files/uart1.o: Link Error: Could not allocate section .text.UART1_Transmit_CallBack, size = 6 PC units, attributes = code 
.ca/build/502_DEBUGActiveCA/production/mcc_generated_files/uart1.o: Link Error: Could not allocate section .text.UART1_Receive_CallBack, size = 6 PC units, attributes = code 
.ca/build/502_DEBUGActiveCA/production/mcc_generated_files/boot/hardware_interrupt_table.o: Link Error: Could not allocate section .text, size = 4 PC units, attributes = code 
.ca/build/502_DEBUGActiveCA/production/mcc_generated_files/boot/com_adaptor_uart.o: Link Error: Could not allocate section .text.BOOT_COM_Peek, size = 24 PC units, attributes = code 
.ca/build/502_DEBUGActiveCA/production/mcc_generated_files/uart1.o: Link Error: Could not allocate section .text.UART1_SetTxInterruptHandler, size = 24 PC units, attributes = code 
.ca/build/502_DEBUGActiveCA/production/mcc_generated_files/uart1.o: Link Error: Could not allocate section .text.UART1_SetRxInterruptHandler, size = 24 PC units, attributes = code 
.ca/build/502_DEBUGActiveCA/production/mcc_generated_files/system.o: Link Error: Could not allocate section .text.SYSTEM_Initialize, size = 22 PC units, attributes = code 
.ca/build/502_DEBUGActiveCA/production/mcc_generated_files/uart1.o: Link Error: Could not allocate section .text.UART1_IsRxReady, size = 22 PC units, attributes = code 
.ca/build/502_DEBUGActiveCA/production/mcc_generated_files/system.o: Link Error: Could not allocate section .text.SYSTEM_CORCONModeOperatingSet, size = 18 PC units, attributes = code 
.ca/build/502_DEBUGActiveCA/production/mcc_generated_files/boot/boot_process.o: Link Error: Could not allocate section .text.BOOT_StartApplication, size = 14 PC units, attributes = code 
.ca/build/502_DEBUGActiveCA/production/mcc_generated_files/traps.o: Link Error: Could not allocate section .text.use_failsafe_stack, size = 14 PC units, attributes = code 
.ca/build/502_DEBUGActiveCA/production/mcc_generated_files/system.o: Link Error: Could not allocate section .text.INTERRUPT_GlobalEnable, size = 12 PC units, attributes = code 
.ca/build/502_DEBUGActiveCA/production/mcc_generated_files/traps.o: Link Error: Could not allocate section .text.TRAPS_halt_on_error, size = 10 PC units, attributes = code 
.ca/build/502_DEBUGActiveCA/production/main.o: Link Error: Could not allocate section .text.main, size = 10 PC units, attributes = code 
.ca/build/502_DEBUGActiveCA/production/mcc_generated_files/boot/boot_process.o: Link Error: Could not allocate section .text.Reset, size = 8 PC units, attributes = code 
.ca/build/502_DEBUGActiveCA/production/mcc_generated_files/boot/boot_demo.o: Link Error: Could not allocate section .text.EnterBootloadMode, size = 8 PC units, attributes = code 
.ca/build/502_DEBUGActiveCA/production/mcc_generated_files/boot/boot_process.o: Link Error: Could not allocate section .text.BOOT_Initialize, size = 6 PC units, attributes = code 
.ca/build/502_DEBUGActiveCA/production/mcc_generated_files/boot/boot_demo.o: Link Error: Could not allocate section .text.BOOT_DEMO_Initialize, size = 6 PC units, attributes = code 
.ca/build/502_DEBUGActiveCA/production/mcc_generated_files/uart1.o: Link Error: Could not allocate section .text.UART1_Transmit_CallBack, size = 6 PC units, attributes = code 
.ca/build/502_DEBUGActiveCA/production/mcc_generated_files/uart1.o: Link Error: Could not allocate section .text.UART1_Receive_CallBack, size = 6 PC units, attributes = code 
.ca/build/502_DEBUGActiveCA/production/mcc_generated_files/boot/hardware_interrupt_table.o: Link Error: Could not allocate section .text, size = 4 PC units, attributes = code 
.ca/build/502_DEBUGActiveCA/production/mcc_generated_files/uart1.o: Link Error: Could not allocate section .text.UART1_SetTxInterruptHandler, size = 24 PC units, attributes = code 
.ca/build/502_DEBUGActiveCA/production/mcc_generated_files/uart1.o: Link Error: Could not allocate section .text.UART1_SetRxInterruptHandler, size = 24 PC units, attributes = code 
.ca/build/502_DEBUGActiveCA/production/mcc_generated_files/system.o: Link Error: Could not allocate section .text.SYSTEM_Initialize, size = 22 PC units, attributes = code 
.ca/build/502_DEBUGActiveCA/production/mcc_generated_files/uart1.o: Link Error: Could not allocate section .text.UART1_IsRxReady, size = 22 PC units, attributes = code 
.ca/build/502_DEBUGActiveCA/production/mcc_generated_files/system.o: Link Error: Could not allocate section .text.SYSTEM_CORCONModeOperatingSet, size = 18 PC units, attributes = code 
.ca/build/502_DEBUGActiveCA/production/mcc_generated_files/boot/boot_process.o: Link Error: Could not allocate section .text.BOOT_StartApplication, size = 14 PC units, attributes = code 
.ca/build/502_DEBUGActiveCA/production/mcc_generated_files/traps.o: Link Error: Could not allocate section .text.use_failsafe_stack, size = 14 PC units, attributes = code 
.ca/build/502_DEBUGActiveCA/production/mcc_generated_files/system.o: Link Error: Could not allocate section .text.INTERRUPT_GlobalEnable, size = 12 PC units, attributes = code 
.ca/build/502_DEBUGActiveCA/production/mcc_generated_files/traps.o: Link Error: Could not allocate section .text.TRAPS_halt_on_error, size = 10 PC units, attributes = code 
.ca/build/502_DEBUGActiveCA/production/main.o: Link Error: Could not allocate section .text.main, size = 10 PC units, attributes = code 
.ca/build/502_DEBUGActiveCA/production/mcc_generated_files/boot/boot_process.o: Link Error: Could not allocate section .text.Reset, size = 8 PC units, attributes = code 
.ca/build/502_DEBUGActiveCA/production/mcc_generated_files/boot/boot_demo.o: Link Error: Could not allocate section .text.EnterBootloadMode, size = 8 PC units, attributes = code 
.ca/build/502_DEBUGActiveCA/production/mcc_generated_files/boot/boot_process.o: Link Error: Could not allocate section .text.BOOT_Initialize, size = 6 PC units, attributes [0m
[31m= code 
.ca/build/502_DEBUGActiveCA/production/mcc_generated_files/boot/boot_demo.o: Link Error: Could not allocate section .text.BOOT_DEMO_Initialize, size = 6 PC units, attributes = code 
.ca/build/502_DEBUGActiveCA/production/mcc_generated_files/uart1.o: Link Error: Could not allocate section .text.UART1_Transmit_CallBack, size = 6 PC units, attributes = code 
.ca/build/502_DEBUGActiveCA/production/mcc_generated_files/uart1.o: Link Error: Could not allocate section .text.UART1_Receive_CallBack, size = 6 PC units, attributes = code 
.ca/build/502_DEBUGActiveCA/production/mcc_generated_files/boot/hardware_interrupt_table.o: Link Error: Could not allocate section .text, size = 4 PC units, attributes = code 
.ca/build/502_DEBUGActiveCA/production/mcc_generated_files/uart1.o: Link Error: Could not allocate section .text.UART1_SetRxInterruptHandler, size = 24 PC units, attributes = code 
.ca/build/502_DEBUGActiveCA/production/mcc_generated_files/system.o: Link Error: Could not allocate section .text.SYSTEM_Initialize, size = 22 PC units, attributes = code 
.ca/build/502_DEBUGActiveCA/production/mcc_generated_files/uart1.o: Link Error: Could not allocate section .text.UART1_IsRxReady, size = 22 PC units, attributes = code 
.ca/build/502_DEBUGActiveCA/production/mcc_generated_files/system.o: Link Error: Could not allocate section .text.SYSTEM_CORCONModeOperatingSet, size = 18 PC units, attributes = code 
.ca/build/502_DEBUGActiveCA/production/mcc_generated_files/boot/boot_process.o: Link Error: Could not allocate section .text.BOOT_StartApplication, size = 14 PC units, attributes = code 
.ca/build/502_DEBUGActiveCA/production/mcc_generated_files/traps.o: Link Error: Could not allocate section .text.use_failsafe_stack, size = 14 PC units, attributes = code 
.ca/build/502_DEBUGActiveCA/production/mcc_generated_files/system.o: Link Error: Could not allocate section .text.INTERRUPT_GlobalEnable, size = 12 PC units, attributes = code 
.ca/build/502_DEBUGActiveCA/production/mcc_generated_files/traps.o: Link Error: Could not allocate section .text.TRAPS_halt_on_error, size = 10 PC units, attributes = code 
.ca/build/502_DEBUGActiveCA/production/main.o: Link Error: Could not allocate section .text.main, size = 10 PC units, attributes = code 
.ca/build/502_DEBUGActiveCA/production/mcc_generated_files/boot/boot_process.o: Link Error: Could not allocate section .text.Reset, size = 8 PC units, attributes = code 
.ca/build/502_DEBUGActiveCA/production/mcc_generated_files/boot/boot_demo.o: Link Error: Could not allocate section .text.EnterBootloadMode, size = 8 PC units, attributes = code 
.ca/build/502_DEBUGActiveCA/production/mcc_generated_files/boot/boot_process.o: Link Error: Could not allocate section .text.BOOT_Initialize, size = 6 PC units, attributes = code 
.ca/build/502_DEBUGActiveCA/production/mcc_generated_files/boot/boot_demo.o: Link Error: Could not allocate section .text.BOOT_DEMO_Initialize, size = 6 PC units, attributes = code 
.ca/build/502_DEBUGActiveCA/production/mcc_generated_files/uart1.o: Link Error: Could not allocate section .text.UART1_Transmit_CallBack, size = 6 PC units, attributes = code 
.ca/build/502_DEBUGActiveCA/production/mcc_generated_files/uart1.o: Link Error: Could not allocate section .text.UART1_Receive_CallBack, size = 6 PC units, attributes = code 
.ca/build/502_DEBUGActiveCA/production/mcc_generated_files/boot/hardware_interrupt_table.o: Link Error: Could not allocate section .text, size = 4 PC units, attributes = code 
.ca/build/502_DEBUGActiveCA/production/mcc_generated_files/system.o: Link Error: Could not allocate section .text.SYSTEM_Initialize, size = 22 PC units, attributes = code 
.ca/build/502_DEBUGActiveCA/production/mcc_generated_files/uart1.o: Link Error: Could not allocate section .text.UART1_IsRxReady, size = 22 PC units, attributes = code 
.ca/build/502_DEBUGActiveCA/production/mcc_generated_files/system.o: Link Error: Could not allocate section .text.SYSTEM_CORCONModeOperatingSet, size = 18 PC units, attributes = code 
.ca/build/502_DEBUGActiveCA/production/mcc_generated_files/boot/boot_process.o: Link Error: Could not allocate section .text.BOOT_StartApplication, size = 14 PC units, attributes = code 
.ca/build/502_DEBUGActiveCA/production/mcc_generated_files/traps.o: Link Error: Could not allocate section .text.use_failsafe_stack, size = 14 PC units, attributes = code 
.ca/build/502_DEBUGActiveCA/production/mcc_generated_files/system.o: Link Error: Could not allocate section .text.INTERRUPT_GlobalEnable, size = 12 PC units, attributes = code 
.ca/build/502_DEBUGActiveCA/production/mcc_generated_files/traps.o: Link Error: Could not allocate section .text.TRAPS_halt_on_error, size = 10 PC units, attributes = code 
.ca/build/502_DEBUGActiveCA/production/main.o: Link Error: Could not allocate section .text.main, size = 10 PC units, attributes = code 
.ca/build/502_DEBUGActiveCA/production/mcc_generated_files/boot/boot_process.o: Link Error: Could not allocate section .text.Reset, size = 8 PC units, attributes = code 
.ca/build/502_DEBUGActiveCA/production/mcc_generated_files/boot/boot_demo.o: Link Error: Could not allocate section .text.EnterBootloadMode, size = 8 PC units, attributes = code 
.ca/build/502_DEBUGActiveCA/production/mcc_generated_files/boot/boot_process.o: Link Error: Could not allocate section .text.BOOT_Initialize, size = 6 PC units, attributes = code 
.ca/build/502_DEBUGActiveCA/production/mcc_generated_files/boot/boot_demo.o: Link Error: Could not allocate section .text.BOOT_DEMO_Initialize, size = 6 PC units, attributes = code 
.ca/build/502_DEBUGActiveCA/production/mcc_generated_files/uart1.o: Link Error: Could not allocate section .text.UART1_Transmit_CallBack, size = 6 PC units, attributes = code 
.ca/build/502_DEBUGActiveCA/production/mcc_generated_files/uart1.o: Link Error: Could not allocate section .text.UART1_Receive_CallBack, size = 6 PC units, attributes = code 
.ca/build/502_DEBUGActiveCA/production/mcc_generated_files/boot/hardware_interrupt_table.o: Link Error: Could not allocate section .text, size = 4 PC units, attributes = code 
.ca/build/502_DEBUGActiveCA/production/mcc_generated_files/uart1.o: Link Error: Could not allocate section .text.UART1_IsRxReady, size = 22 PC units, attributes = code 
.ca/build/502_DEBUGActiveCA/production/mcc_generated_files/system.o: Link Error: Could not allocate section .text.SYSTEM_CORCONModeOperatingSet, size = 18 PC units, attributes = code 
.ca/build/502_DEBUGActiveCA/production/mcc_generated_files/boot/boot_process.o: Link Error: Could not allocate section .text.BOOT_StartApplication, size = 14 PC units, attributes = code 
.ca/build/502_DEBUGActiveCA/production/mcc_generated_files/traps.o: Link Error: Could not allocate section .text.use_failsafe_stack, size = 14 PC units, attributes = code 
.ca/build/502_DEBUGActiveCA/production/mcc_generated_files/system.o: Link Error: Could not allocate section .text.INTERRUPT_GlobalEnable, size = 12 PC units, attributes = code 
.ca/build/502_DEBUGActiveCA/production/mcc_generated_files/traps.o: Link Error: Could not allocate section .text.TRAPS_halt_on_error, size = 10 PC units, attributes = code 
.ca/build/502_DEBUGActiveCA/production/main.o: Link Error: Could not allocate section .text.main, size = 10 PC units, attributes = code 
.ca/build/502_DEBUGActiveCA/production/mcc_generated_files/boot/boot_process.o: Link Error: Could not allocate section .text.Reset, size = 8 PC units, attributes = code 
.ca/build/502_DEBUGActiveCA/production/mcc_generated_files/boot/boot_demo.o: Link Error: Could not allocate section .text.EnterBootloadMode, size = 8 PC units, attributes = code 
.ca/build/502_DEBUGActiveCA/production/mcc_generated_files/boot/boot_process.o: Link Error: Could not allocate section .text.BOOT_Initialize, size = 6 PC units, attributes = code 
.ca/build/502_DEBUGActiveCA/production/mcc_generated_files/boot/boot_demo.o: Link Error: Could not allocate section .text.BOOT_DEMO_Initialize, size = 6 PC units, attributes = code 
.ca/build/502_DEBUGActiveCA/production/mcc_generated_files/uart1.o: Link Error: Could not allocate section .text.UART1_Transmit_CallBack, size = 6 PC units, attribute[0m
[31ms = code 
.ca/build/502_DEBUGActiveCA/production/mcc_generated_files/uart1.o: Link Error: Could not allocate section .text.UART1_Receive_CallBack, size = 6 PC units, attributes = code 
.ca/build/502_DEBUGActiveCA/production/mcc_generated_files/boot/hardware_interrupt_table.o: Link Error: Could not allocate section .text, size = 4 PC units, attributes = code 
.ca/build/502_DEBUGActiveCA/production/mcc_generated_files/system.o: Link Error: Could not allocate section .text.SYSTEM_CORCONModeOperatingSet, size = 18 PC units, attributes = code 
.ca/build/502_DEBUGActiveCA/production/mcc_generated_files/boot/boot_process.o: Link Error: Could not allocate section .text.BOOT_StartApplication, size = 14 PC units, attributes = code 
.ca/build/502_DEBUGActiveCA/production/mcc_generated_files/traps.o: Link Error: Could not allocate section .text.use_failsafe_stack, size = 14 PC units, attributes = code 
.ca/build/502_DEBUGActiveCA/production/mcc_generated_files/system.o: Link Error: Could not allocate section .text.INTERRUPT_GlobalEnable, size = 12 PC units, attributes = code 
.ca/build/502_DEBUGActiveCA/production/mcc_generated_files/traps.o: Link Error: Could not allocate section .text.TRAPS_halt_on_error, size = 10 PC units, attributes = code 
.ca/build/502_DEBUGActiveCA/production/main.o: Link Error: Could not allocate section .text.main, size = 10 PC units, attributes = code 
.ca/build/502_DEBUGActiveCA/production/mcc_generated_files/boot/boot_process.o: Link Error: Could not allocate section .text.Reset, size = 8 PC units, attributes = code 
.ca/build/502_DEBUGActiveCA/production/mcc_generated_files/boot/boot_demo.o: Link Error: Could not allocate section .text.EnterBootloadMode, size = 8 PC units, attributes = code 
.ca/build/502_DEBUGActiveCA/production/mcc_generated_files/boot/boot_process.o: Link Error: Could not allocate section .text.BOOT_Initialize, size = 6 PC units, attributes = code 
.ca/build/502_DEBUGActiveCA/production/mcc_generated_files/boot/boot_demo.o: Link Error: Could not allocate section .text.BOOT_DEMO_Initialize, size = 6 PC units, attributes = code 
.ca/build/502_DEBUGActiveCA/production/mcc_generated_files/uart1.o: Link Error: Could not allocate section .text.UART1_Transmit_CallBack, size = 6 PC units, attributes = code 
.ca/build/502_DEBUGActiveCA/production/mcc_generated_files/uart1.o: Link Error: Could not allocate section .text.UART1_Receive_CallBack, size = 6 PC units, attributes = code 
.ca/build/502_DEBUGActiveCA/production/mcc_generated_files/boot/hardware_interrupt_table.o: Link Error: Could not allocate section .text, size = 4 PC units, attributes = code 
.ca/build/502_DEBUGActiveCA/production/mcc_generated_files/boot/boot_process.o: Link Error: Could not allocate section .text.BOOT_StartApplication, size = 14 PC units, attributes = code 
.ca/build/502_DEBUGActiveCA/production/mcc_generated_files/traps.o: Link Error: Could not allocate section .text.use_failsafe_stack, size = 14 PC units, attributes = code 
.ca/build/502_DEBUGActiveCA/production/mcc_generated_files/system.o: Link Error: Could not allocate section .text.INTERRUPT_GlobalEnable, size = 12 PC units, attributes = code 
.ca/build/502_DEBUGActiveCA/production/mcc_generated_files/traps.o: Link Error: Could not allocate section .text.TRAPS_halt_on_error, size = 10 PC units, attributes = code 
.ca/build/502_DEBUGActiveCA/production/main.o: Link Error: Could not allocate section .text.main, size = 10 PC units, attributes = code 
.ca/build/502_DEBUGActiveCA/production/mcc_generated_files/boot/boot_process.o: Link Error: Could not allocate section .text.Reset, size = 8 PC units, attributes = code 
.ca/build/502_DEBUGActiveCA/production/mcc_generated_files/boot/boot_demo.o: Link Error: Could not allocate section .text.EnterBootloadMode, size = 8 PC units, attributes = code 
.ca/build/502_DEBUGActiveCA/production/mcc_generated_files/boot/boot_process.o: Link Error: Could not allocate section .text.BOOT_Initialize, size = 6 PC units, attributes = code 
.ca/build/502_DEBUGActiveCA/production/mcc_generated_files/boot/boot_demo.o: Link Error: Could not allocate section .text.BOOT_DEMO_Initialize, size = 6 PC units, attributes = code 
.ca/build/502_DEBUGActiveCA/production/mcc_generated_files/uart1.o: Link Error: Could not allocate section .text.UART1_Transmit_CallBack, size = 6 PC units, attributes = code 
.ca/build/502_DEBUGActiveCA/production/mcc_generated_files/uart1.o: Link Error: Could not allocate section .text.UART1_Receive_CallBack, size = 6 PC units, attributes = code 
.ca/build/502_DEBUGActiveCA/production/mcc_generated_files/boot/hardware_interrupt_table.o: Link Error: Could not allocate section .text, size = 4 PC units, attributes = code 
.ca/build/502_DEBUGActiveCA/production/mcc_generated_files/traps.o: Link Error: Could not allocate section .text.use_failsafe_stack, size = 14 PC units, attributes = code 
.ca/build/502_DEBUGActiveCA/production/mcc_generated_files/system.o: Link Error: Could not allocate section .text.INTERRUPT_GlobalEnable, size = 12 PC units, attributes = code 
.ca/build/502_DEBUGActiveCA/production/mcc_generated_files/traps.o: Link Error: Could not allocate section .text.TRAPS_halt_on_error, size = 10 PC units, attributes = code 
.ca/build/502_DEBUGActiveCA/production/main.o: Link Error: Could not allocate section .text.main, size = 10 PC units, attributes = code 
.ca/build/502_DEBUGActiveCA/production/mcc_generated_files/boot/boot_process.o: Link Error: Could not allocate section .text.Reset, size = 8 PC units, attributes = code 
.ca/build/502_DEBUGActiveCA/production/mcc_generated_files/boot/boot_demo.o: Link Error: Could not allocate section .text.EnterBootloadMode, size = 8 PC units, attributes = code 
.ca/build/502_DEBUGActiveCA/production/mcc_generated_files/boot/boot_process.o: Link Error: Could not allocate section .text.BOOT_Initialize, size = 6 PC units, attributes = code 
.ca/build/502_DEBUGActiveCA/production/mcc_generated_files/boot/boot_demo.o: Link Error: Could not allocate section .text.BOOT_DEMO_Initialize, size = 6 PC units, attributes = code 
.ca/build/502_DEBUGActiveCA/production/mcc_generated_files/uart1.o: Link Error: Could not allocate section .text.UART1_Transmit_CallBack, size = 6 PC units, attributes = code 
.ca/build/502_DEBUGActiveCA/production/mcc_generated_files/uart1.o: Link Error: Could not allocate section .text.UART1_Receive_CallBack, size = 6 PC units, attributes = code 
.ca/build/502_DEBUGActiveCA/production/mcc_generated_files/boot/hardware_interrupt_table.o: Link Error: Could not allocate section .text, size = 4 PC units, attributes = code 
.ca/build/502_DEBUGActiveCA/production/mcc_generated_files/system.o: Link Error: Could not allocate section .text.INTERRUPT_GlobalEnable, size = 12 PC units, attributes = code 
.ca/build/502_DEBUGActiveCA/production/mcc_generated_files/traps.o: Link Error: Could not allocate section .text.TRAPS_halt_on_error, size = 10 PC units, attributes = code 
.ca/build/502_DEBUGActiveCA/production/main.o: Link Error: Could not allocate section .text.main, size = 10 PC units, attributes = code 
.ca/build/502_DEBUGActiveCA/production/mcc_generated_files/boot/boot_process.o: Link Error: Could not allocate section .text.Reset, size = 8 PC units, attributes = code 
.ca/build/502_DEBUGActiveCA/production/mcc_generated_files/boot/boot_demo.o: Link Error: Could not allocate section .text.EnterBootloadMode, size = 8 PC units, attributes = code 
.ca/build/502_DEBUGActiveCA/production/mcc_generated_files/boot/boot_process.o: Link Error: Could not allocate section .text.BOOT_Initialize, size = 6 PC units, attributes = code 
.ca/build/502_DEBUGActiveCA/production/mcc_generated_files/boot/boot_demo.o: Link Error: Could not allocate section .text.BOOT_DEMO_Initialize, size = 6 PC units, attributes = code 
.ca/build/502_DEBUGActiveCA/production/mcc_generated_files/uart1.o: Link Error: Could not allocate section .text.UART1_Transmit_CallBack, size = 6 PC units, attributes = code 
.ca/build/502_DEBUGActiveCA/production/mcc_generated_files/uart1.o: Link Error: Could not allocate section .text.UART1_Receive_CallBack, size = 6 PC units, attributes = code 
.ca/build/502_DEBUGActiveCA/produ[0m
[31mction/mcc_generated_files/boot/hardware_interrupt_table.o: Link Error: Could not allocate section .text, size = 4 PC units, attributes = code 
.ca/build/502_DEBUGActiveCA/production/mcc_generated_files/traps.o: Link Error: Could not allocate section .text.TRAPS_halt_on_error, size = 10 PC units, attributes = code 
.ca/build/502_DEBUGActiveCA/production/main.o: Link Error: Could not allocate section .text.main, size = 10 PC units, attributes = code 
.ca/build/502_DEBUGActiveCA/production/mcc_generated_files/boot/boot_process.o: Link Error: Could not allocate section .text.Reset, size = 8 PC units, attributes = code 
.ca/build/502_DEBUGActiveCA/production/mcc_generated_files/boot/boot_demo.o: Link Error: Could not allocate section .text.EnterBootloadMode, size = 8 PC units, attributes = code 
.ca/build/502_DEBUGActiveCA/production/mcc_generated_files/boot/boot_process.o: Link Error: Could not allocate section .text.BOOT_Initialize, size = 6 PC units, attributes = code 
.ca/build/502_DEBUGActiveCA/production/mcc_generated_files/boot/boot_demo.o: Link Error: Could not allocate section .text.BOOT_DEMO_Initialize, size = 6 PC units, attributes = code 
.ca/build/502_DEBUGActiveCA/production/mcc_generated_files/uart1.o: Link Error: Could not allocate section .text.UART1_Transmit_CallBack, size = 6 PC units, attributes = code 
.ca/build/502_DEBUGActiveCA/production/mcc_generated_files/uart1.o: Link Error: Could not allocate section .text.UART1_Receive_CallBack, size = 6 PC units, attributes = code 
.ca/build/502_DEBUGActiveCA/production/mcc_generated_files/boot/hardware_interrupt_table.o: Link Error: Could not allocate section .text, size = 4 PC units, attributes = code 
.ca/build/502_DEBUGActiveCA/production/main.o: Link Error: Could not allocate section .text.main, size = 10 PC units, attributes = code 
.ca/build/502_DEBUGActiveCA/production/mcc_generated_files/boot/boot_process.o: Link Error: Could not allocate section .text.Reset, size = 8 PC units, attributes = code 
.ca/build/502_DEBUGActiveCA/production/mcc_generated_files/boot/boot_demo.o: Link Error: Could not allocate section .text.EnterBootloadMode, size = 8 PC units, attributes = code 
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
.ca/build/502_DEBUGActiveCA/production/mcc_generated_files/uart1.o: Link Error: Could not allocate section .text.UART1_Transmit_CallBack, size = 6 PC units, attributes = code 
.ca/build/502_DEBUGActiveCA/production/mcc_generated_files/uart1.o: Link Error: Could not allocate section .text.UART1_Receive_CallBack, size = 6 PC units, attributes = code 
.ca/build/502_DEBUGActiveCA/production/mcc_generated_files/boot/hardware_interrupt_table.o: Link Error: Could not allocate section .text, size = 4 PC units, attributes = code 
.ca/build/502_DEBUGActiveCA/production/mcc_generated_files/uart1.o: Link Error: Could not allocate section .text.UART1_Transmit_CallBack, size = 6 PC units, attributes = code 
.ca/build/502_DEBUGActiveCA/production/mcc_generated_files/uart1.o: Link Error: Could not allocate section .text.UART1_Receive_CallBack, size = 6 PC units, attributes = code 
.ca/build/502_DEBUGActiveCA/production/mcc_generated_files/boot/hardware_interrupt_table.o: Link Error: Could not allocate section .text, size = 4 PC units, attributes = code 
.ca/build/502_DEBUGActiveCA/production/mcc_generated_files/uart1.o: Link Error: Could not allocate section .text.UART1_Receive_CallBack, size = 6 PC units, attributes = code 
.ca/build/502_DEBUGActiveCA/production/mcc_generated_files/boot/hardware_interrupt_table.o: Link Error: Could not allocate section .text, size = 4 PC units, attributes = code 
.ca/build/502_DEBUGActiveCA/production/mcc_generated_files/boot/hardware_interrupt_table.o: Link Error: Could not allocate section .text, size = 4 PC units, attributes = code 
 Link Error: Could not allocate program memory[0m
nbproject/Makefile-502_DEBUGActiveCA.mk:350: recipe for target '.ca/dist/502_DEBUGActiveCA/production/BMS_Controller_BL.production.hex' failed
make[2]: Leaving directory 'C:/Users/kid group/Documents/Repos/E_Moto/Firmware/Projects/BMS_Controller_BL'
nbproject/Makefile-502_DEBUGActiveCA.mk:91: recipe for target '.build-conf' failed
make[1]: Leaving directory 'C:/Users/kid group/Documents/Repos/E_Moto/Firmware/Projects/BMS_Controller_BL'
nbproject/Makefile-impl.mk:39: recipe for target '.build-impl' failed
[31m
Info: Loading file: C:/Program Files/Microchip/MPLABX/v6.00/packs/Microchip/dsPIC33E-GM-GP-MC-GU-MU_DFP/1.3.85/xc16/bin/../support/dsPIC33E/gld\\p33EP64GP506.gld
make[2]: *** [.ca/dist/502_DEBUGActiveCA/production/BMS_Controller_BL.production.hex] Error 255
make[1]: *** [.build-conf] Error 2
make: *** [.build-impl] Error 2[0m
[31mBUILD FAILED (exit value 2, total time: 3s)[0m
