zachleedogg/E_Moto/CAD/Battery/Welder/Spot Welder_v1.pdf

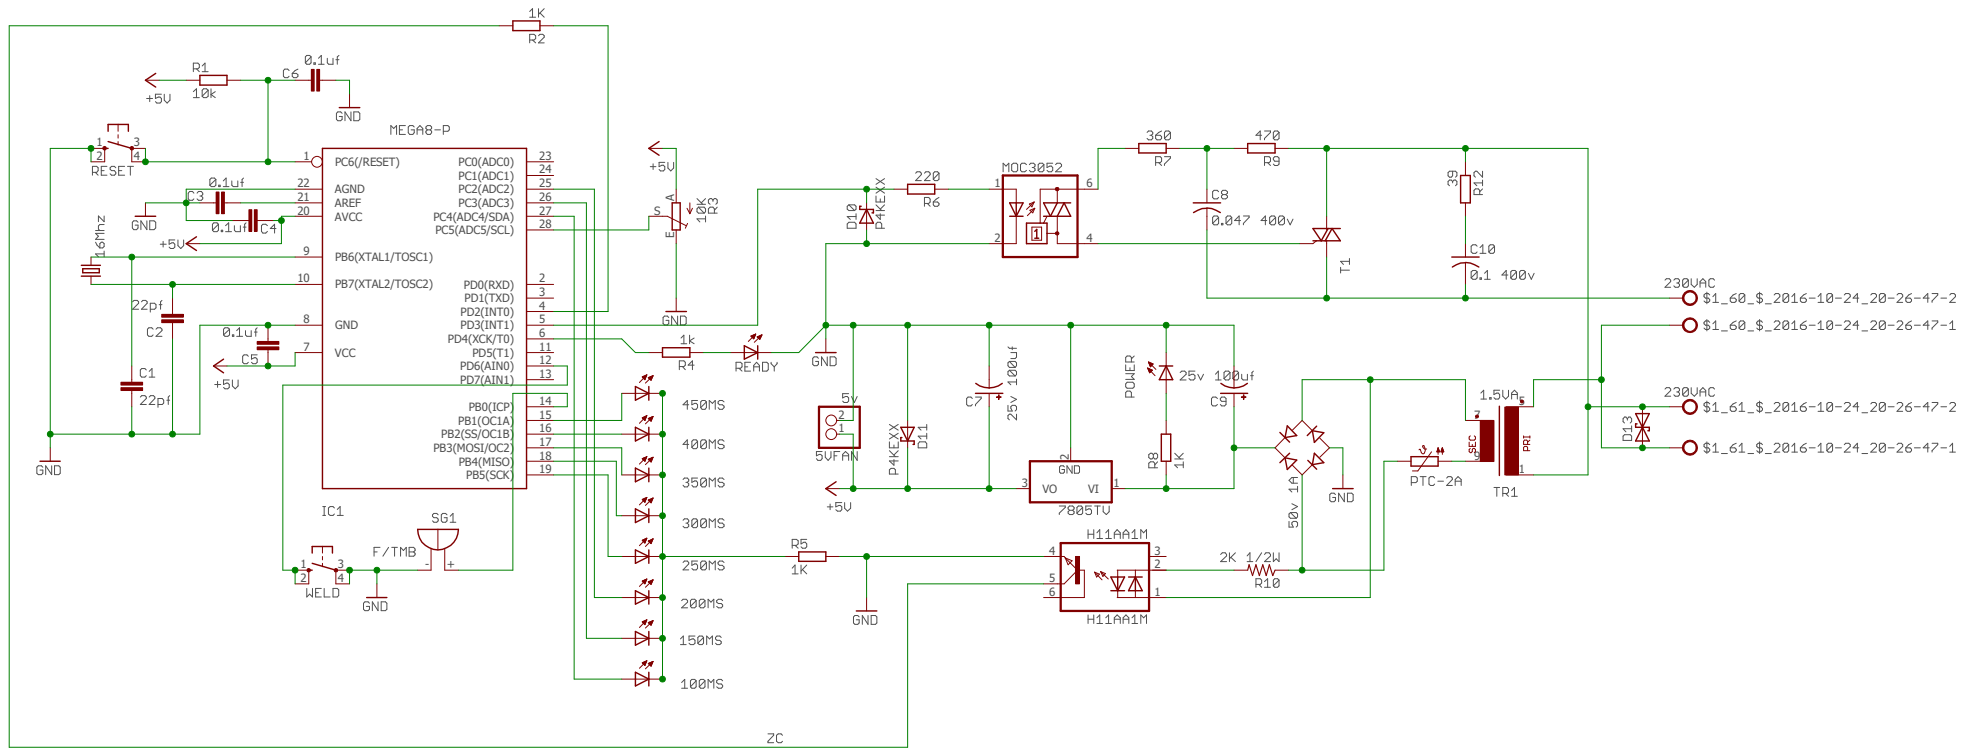
[picture p84: page 1]
PB5(SCK); PB7(XTAL2/TOSC2) 10; PB6(XTAL1/TOSC1); GND; VCC; AGND 22 AREF 21 AVCC 20; PB4(MISO); 18 PB3(MOSI/OC2); 15 PB0(ICP); PD7(AIN1); 13 PD6(AIN0); 11 PD4(XCK/T0); 4 PD1(TXD); 3 PD0(RXD); PC5(ADC5/SCL); 28 PC4(ADC4/SDA); 27 PC3(ADC3); 26 PC2(ADC2); 25 PC1(ADC1); 24 PC0(ADC0); 23 PC6(/RESET)

5 PD2(INT0)

7 | 6 PD3(INT1)
