zachleedogg/E_Moto/Hardware/Simulations/Draft7.asc

C1: cap; 10n
C2: cap; 10n
Q1: npn; 2N2222
Q2: npn; 2N2222
R1: res; 10k
R2: res; 10k
R3: res; 10k
R5: res; 10k
R6: res; 100k
V1: voltage; 5
V2: voltage; PWL(0 0 1m 0 1.001m 5 2m 5 2.001m 0)
Named nets: 0, 5v, out1, out2
.tran 5m
