zachleedogg/E_Moto/Hardware/Simulations/Draft5.asc

D1: schottky; RB088BM100
M1: pmos; Si7489DP
R1: res; 100k
R2: res; 20k
S1: sw; START
S2: sw; KILL
V1: voltage; 48
V2: voltage; PULSE(0 5 0 0.01m 0.01m 10m 20m)
Named nets: 0, VBAT, OUT, START_SW
.model START SW(Ron=1 Roff=1Meg)
.tran 40m
.model KILL SW()
