zachleedogg/E_Moto/Hardware/Simulations/Welder_AC_Input.asc

C1: cap; 57µ
C2: cap; 10n
C3: cap; 10n
C4: cap; .1µ
C5: cap; 10n
D1: diode; 1N4148
D2: diode; 1N4148
D3: diode; 1N4148
D4: diode; 1N4148
D5: schottky; 1N5817
D6: schottky; 1N5817
L1: ind2; 400µ
L2: ind2; 1µ; Rser=4
L3: ind2; 400µ
L4: ind2; 1µ; Rser=4
R1: res; 10k
R2: res; 1k
R3: res; 500
R4: res; 495k
R5: res; 14k7
R6: res; 39
R7: res; 10k
R8: res; .01
R9: res; 495k
R10: res; 14k7
R11: res; 10k
V1: voltage; SINE(0 339 60); Rser=.1
Named nets: vout, 0, AN_SECONDARY, AN_Primary_L, AN_Primary_H
K1 L1 L2 1
.tran 1
K2 L3 L4 1
