zachleedogg/E_Moto/Hardware/Simulations/DCDC_Feedback_Adjustable.asc

C1: cap; .1µ
R1: res; 100k
R2: res; 10k
R3: res; {pot+1}
R4: res; {10k-pot+1}
R5: res; 22k
U1: UniversalOpamp2
U2: UniversalOpamp2
V1: voltage; 20
V2: voltage; 1.2
V3: voltage; 3.3
Named nets: 0, 20V, 1v2, 5V, Vout
.tran 1m
.step param pot 0k 10k 1k
