zachleedogg/E_Moto/Hardware/Simulations/SoftStart+revPol_highVoltage.asc

C1: cap; 2µ2
C2: cap; 10µ
C3: cap; 100µ; Rser=.2
C4: cap; 10µ
C5: cap; 10µ
C6: cap; 10µ
C7: cap; 10µ
D1: schottky; RB218NS150
D2: schottky; RB218NS150
D3: zener; UDZV16B
D4: schottky; RB218NS150
M1: nmos; BSC320N20NS3
M2: nmos; BSC320N20NS3
R1: res; 2k
R2: res; 10k
R3: res; 100k
V1: voltage; 120V
V2: voltage; PULSE(0 5 .1 0 0 1m 2m)
Named nets: 0, 120V, vout, vgate
.tran 1
.ic v(vout) = 0
.ic v(vgate) = 0
