zachleedogg/E_Moto/Hardware/Simulations/IsolatedGateDriver_simple.asc

C2: cap; {Creset}
C3: cap; 25p
C4: cap; 25p
D1: zener; BZX84C15L
D2: schottky; 1N5819
D3: schottky; 1N5819
D4: zener; BZX84C15L
D5: schottky; 1N5819
D6: schottky; 1N5819
D7: schottky; 1N5819
D8: schottky; 1N5819
D9: schottky; 1N5819
L1: ind2; {Xformer}; Rser=1
L2: ind2; {Xformer}; Rser=1
L3: ind2; {Xformer}; Rser=1
L4: ind2; 300n
M1: nmos; IPB065N15N3
M2: nmos; IPB065N15N3
R1: res; 10
R3: res; 20
R4: res; 3
R7: res; 2
V1: voltage; 100V
V2: voltage; PULSE(0 12 0 0 0 10u 20u); Rser=0
Named nets: 0, V_PACK, PWM_IN, GATE_H, SOURCE_H, V_Prim, V_Sec_high, GATE_L, SOURCE_L, V_Sec_low
.tran 3m
K L1 L2 L3 1
.step param Creset .5u 2u .5u
.param Creset 100n
.param xFormer 300u
