zachleedogg/E_Moto/Hardware/Simulations/IsolatedGateDriver.asc

C1: cap; 1n
C2: cap; 2.2µ
C3: cap; 25p
C4: cap; 25p
D1: zener; BZX84C15L
D2: schottky; 1N5819
D4: zener; BZX84C15L
D5: schottky; 1N5819
L1: ind2; 200µ; Rser=.001
L2: ind2; 800µ; Rser=.02
L3: ind2; 800µ; Rser=.02
L4: ind2; 1µ; Rpar=40m
L5: ind; .5µ
L6: ind; .5µ
M1: nmos; IPB065N15N3
M2: nmos; IPB065N15N3
Q1: pnp; 2N2907
Q2: pnp; 2N2907
R1: res; 10
R2: res; 20
R3: res; 0
R4: res; 0
R5: res; 0
R6: res; 20
R7: res; 0
R8: res; 0
U1: UCC27528_TRANS
V1: voltage; 100V
V2: voltage; PULSE(0 10 0 10n 10n 5u 10u); Rser=0
V3: voltage; 12
Named nets: 0, V_PACK, PWM_IN, GATE_H, SOURCE_H, V_Prim, V_Sec_high, GATE_L, SOURCE_L, V_Sec_low, 12V
.tran .5m
K L1 L2 L3 1
