zachleedogg/E_Moto/Hardware/Simulations/Draft2.asc

R1: res; 340k
R2: res; 47k
V1: voltage; PWL(0 6 1m 18)
Named nets: 0
.tran 2m
