zachleedogg/E_Moto/Hardware/Simulations/INA28X_currentShunt.asc

C1: cap; 1µ
D1: diode
I1: load; PWL(0 0 1m 5)
R1: res; .001
R2: res; 10
R3: res; 10
U1: INA28X; TR_Mode=1 G=1000
V1: voltage; {vbat}
V3: voltage; 3.3
Named nets: out, shunt, vbatt, 0
.tran 0 1m 0 .1m
.PARAM vbat = 13.5
