zachleedogg/E_Moto/(list of files, drawings)

Other design files:
Hardware/InterfaceController/InterfaceController_01.dch
Hardware/Proto1A/Proto1a.dch
Hardware/Proto1A/Proto1a.dip
