zachleedogg/E_Moto/Hardware/Welder/Welder/Welder.kicad_pcb

## KiCad design Hardware/Welder/Welder/Welder.kicad_pcb (2020-02-11)

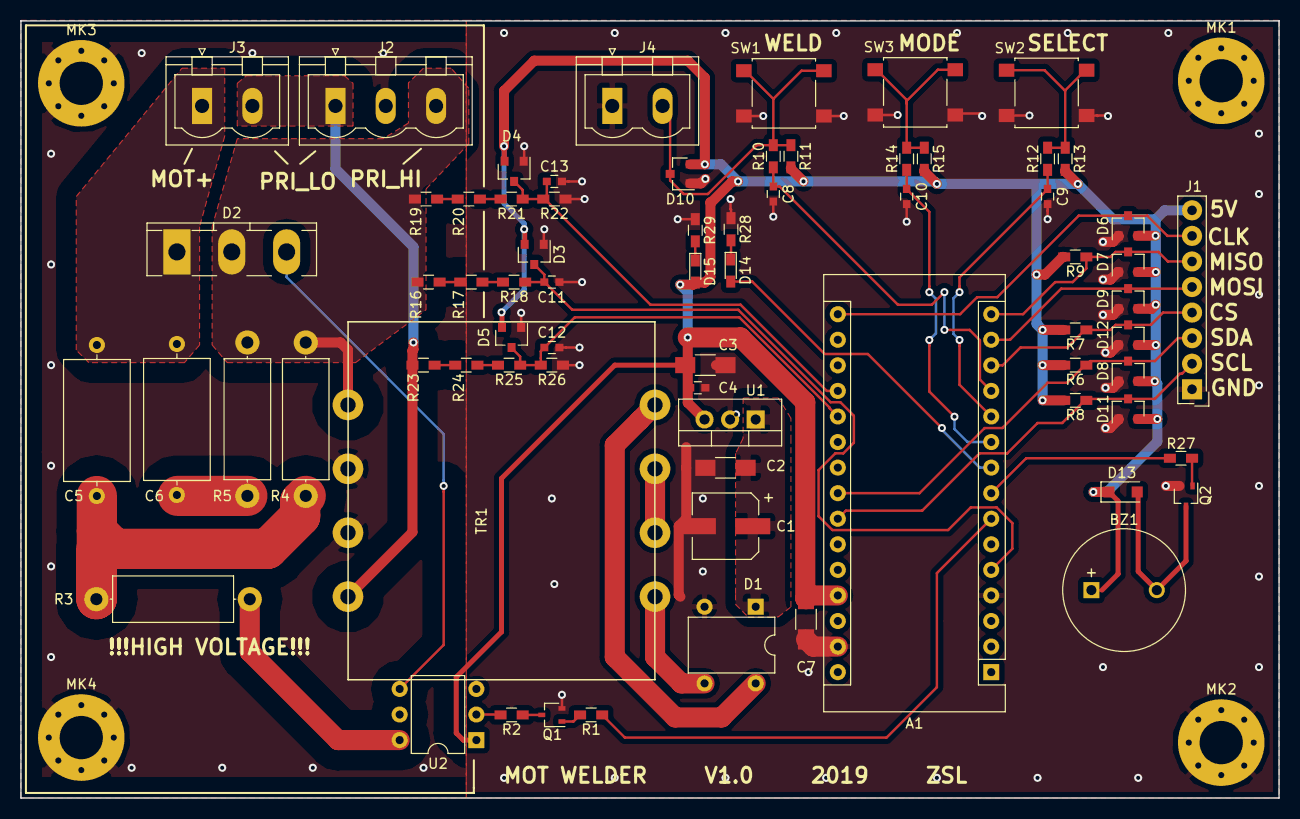
[picture p86: board Welder.kicad_pcb from above]

Board: 2 copper layers, 125.0 x 77.2 mm, 75 parts (0 on the bottom side), 44 nets.

Parts:
A1: Arduino_Nano_v3.x; Arduino_Nano
BZ1: Buzzer; MagneticBuzzer_ProSignal_ABT-410-RC
C1: 47u; CP_Elec_6.3x7.7
C2, C3, C7: 10uF; C_1206_HandSoldering
C4, C8, C9, C10, C11, C12, C13: 10nF; C_0603
C5: 0.047uF; C_Axial_L12.0mm_D6.5mm_P15.00mm_Horizontal
C6: 0.1uF; C_Axial_L12.0mm_D6.5mm_P15.00mm_Horizontal
D1: D_Bridge_+-AA; Diode_Bridge_DIP-4_W7.62mm_P5.08mm
D2: Q_TRIAC_A1A2G; TO-280_Vertical
D3, D4, D5, D6, D7, D8, D9, D10, D11, D12: D_Schottky_x2_Serial_AKC; SOT-23
D13: D; D_SOD-123F
D14, D15: LED; LED_0603_HandSoldering
J1: Conn_01x08; SL-108-X-XX_1x08
J2: Screw_Terminal_01x03; PhoenixContact_MSTBVA-G_03x5.00mm_Vertical
J3, J4: Screw_Terminal_01x02; PhoenixContact_MSTBVA-G_02x5.00mm_Vertical
MK1, MK2, MK3, MK4: Mounting_Hole_PAD; MountingHole_4.3mm_M4_Pad_Via
Q1, Q2: Q_NMOS_GSD; SOT-323_SC-70
R1, R6, R7, R8, R9, R10, R11, R12, R13, R14, R15, R27: 10k; R_0603_HandSoldering
R2: 220R; R_0603_HandSoldering
R3: 360R; R_Axial_DIN0414_L11.9mm_D4.5mm_P15.24mm_Horizontal
R4: 470R; R_Axial_DIN0414_L11.9mm_D4.5mm_P15.24mm_Horizontal
R5: 39R; R_Axial_DIN0414_L11.9mm_D4.5mm_P15.24mm_Horizontal
R16, R17, R18, R19, R20, R21, R23, R24, R25: 165k; R_0603_HandSoldering
R22, R26: 14k7; R_0603_HandSoldering
R28, R29: 360R; R_0603_HandSoldering
SW1, SW2, SW3: SW_Push; SW_SPST_B3S-1000
TR1: TRANSF6; FS20-120-C2
U1: LM7805_TO220; TO-220-3_Vertical
U2: MOC3052M; DIP-6_W7.62mm

Connections:
+5V: A1.27, BZ1.1, C3.1, C4.1, C7.1, D3.2, D4.2, D5.2, D6.2, D7.2, D8.2, D9.2, D10.2, D11.2, D12.2, D13.1, D15.2, J1.8, R6.2, R7.2, R8.2, R9.2, R11.2, R13.2, R15.2, U1.3, U2.1
BUZZ_PWM: A1.8, R27.1
CLK: A1.16, D6.3, J1.7
CS: A1.13, D12.3, J1.4, R7.1
DEBUG_LED_EN: A1.9, D14.2
GND: A1.4, A1.29, C1.2, C2.2, C3.2, C4.2, C7.2, C8.2, C9.2, C10.2, C11.2, C12.2, C13.2, D1.2, D3.1, D4.1, D5.1, D6.1, D7.1, D8.1, D9.1, D10.1, D11.1, D12.1, J1.1, J2.2, J4.1, MK1.1, MK2.1, MK3.1, MK4.1, Q1.2, Q2.2, R22.1, R26.1, R28.1, R29.1, SW1.2, SW2.2, SW3.2, TR1.2, TR1.3, U1.2
MISO: A1.15, D7.3, J1.6, R9.1
MODE_BUTTON: A1.10, C10.1, R14.1
MOSI: A1.14, D9.3, J1.5
MOT_+: C5.2, C6.2, D2.1, J3.1
MOT_EN: A1.7, R1.1
unnamed: BZ1.2, D13.2, Q2.3
unnamed: C1.1, C2.1, D1.1, U1.1
unnamed: C5.1, R3.1, R4.2
unnamed: C6.1, R5.2
unnamed: D1.3, TR1.8
unnamed: D1.4, TR1.5
unnamed: D2.3, U2.4
unnamed: D14.1, R28.2
unnamed: D15.1, R29.2
unnamed: Q1.1, R1.2
unnamed: Q1.3, R2.1
unnamed: Q2.1, R27.2
unnamed: R2.2, U2.2
unnamed: R3.2, U2.6
unnamed: R12.2, R13.1, SW2.1
unnamed: R14.2, R15.1, SW3.1
unnamed: R16.1, R17.2
unnamed: R17.1, R18.2
unnamed: R19.1, R20.2
unnamed: R20.1, R21.2
unnamed: R23.1, R24.2
unnamed: R24.1, R25.2
unnamed: TR1.6, TR1.7
PRIMARY_A_AI: A1.19, C13.1, D4.3, R21.1, R22.2
PRIMARY_B_AI: A1.20, C12.1, D5.3, R25.1, R26.2
PRI_HI: D2.2, J2.3, R4.1, R5.1, R16.2, R19.2, TR1.1
PRI_LO: J2.1, J3.2, R23.2, TR1.4
SCL: A1.24, D11.3, J1.2, R8.1
SDA: A1.23, D8.3, J1.3, R6.1
SELECT_BUTTON: A1.11, C9.1, R12.1
WELD_BUTTON: A1.12, C8.1, R10.1
WELD_BUTTON_OUT: D10.3, J4.2, R10.2, R11.1, SW1.1
ZERO_CROSS: A1.5, C11.1, D3.3, R18.1
