zachleedogg/E_Moto/Hardware/BodyController/BodyController_01/BodyController_01.kicad_pcb

## KiCad design Hardware/BodyController/BodyController_01/BodyController_01.kicad_pcb (2018-05-31)

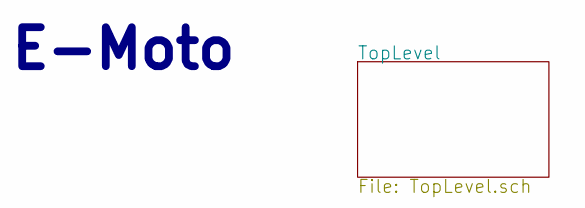
[picture p88: schematic BodyController_01.sch]

Notes on the sheet:
E-Moto
