zachleedogg/E_Moto/Hardware/BodyController/BodyController_01/BodyController_01.kicad_pcb

## KiCad design Hardware/BodyController/BodyController_01/BodyController_01.kicad_pcb (continued)

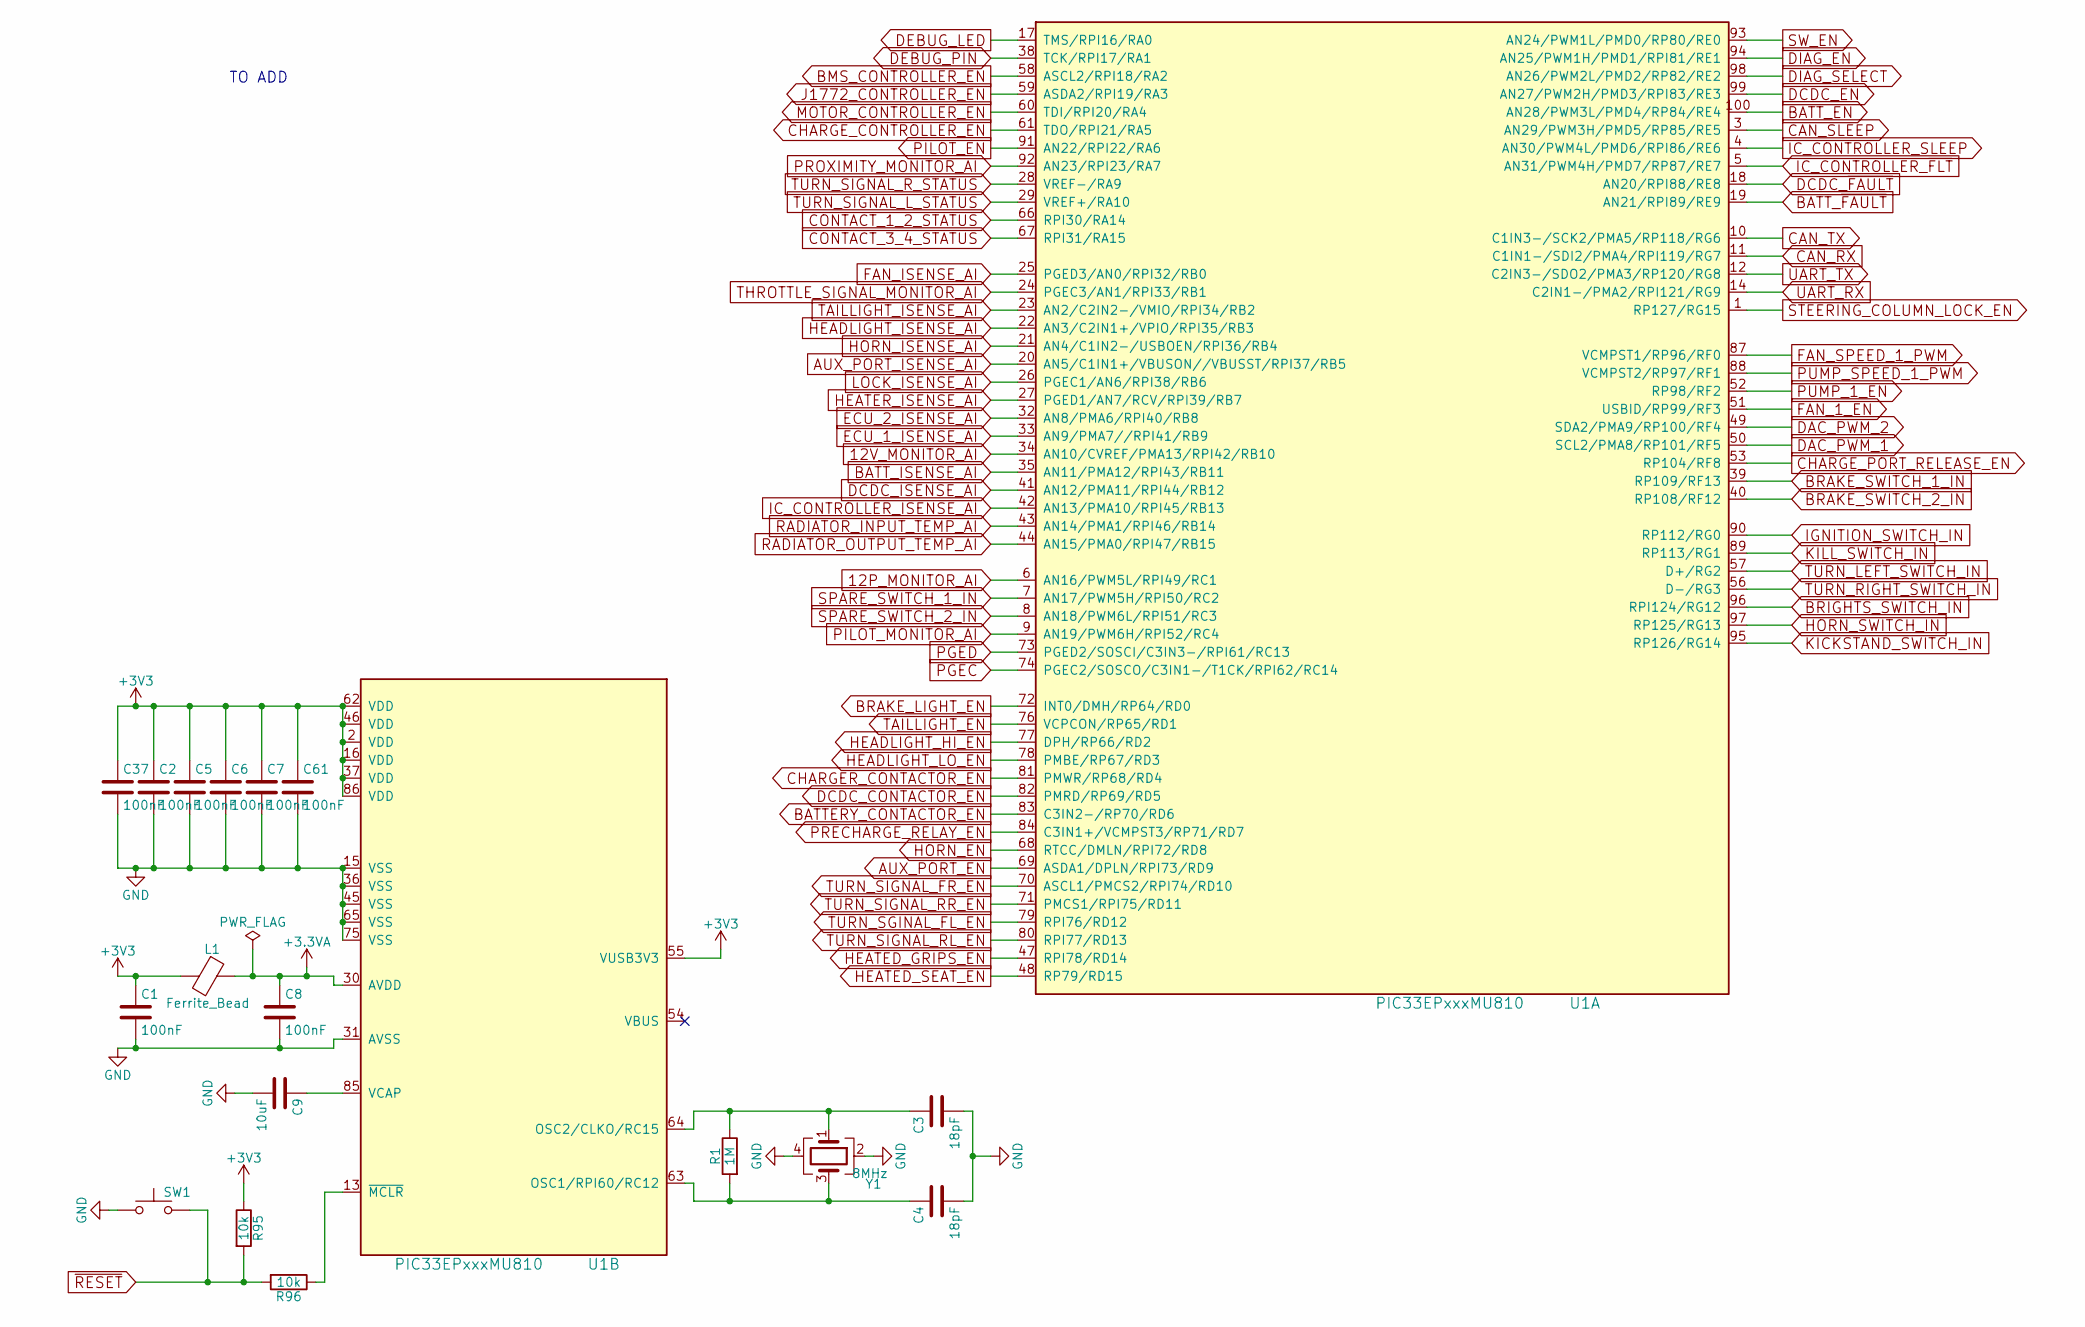
[picture p89: schematic MicroController.sch]

Parts:
C1, C2, C5, C6, C7, C8, C37, C61: 100nF; C_0603; MPN GCM188R71H104KA57D
C3, C4: 18pF; C_0603; MPN CGA3E2C0G1H180J080AA
C9: 10uF; C_1206; MPN C1206C106M3RACAUTO
L1: Ferrite_Bead; L_0603; MPN MPZ1608S300ATDH5
R1: 1M; R_0603; MPN AC0603FR-071ML
R95, R96: 10k; R_0603; MPN AC0603FR-0710KL
SW1: PTS645SM43SMTR92 LFS; SW_SPST_EVQP0; MPN PTS645SM43SMTR92 LFS
U1: PIC33EPxxxMU810; TQFP-100_14x14mm_Pitch0.5mm; MPN DSPIC33EP512MU810-E/PF
Y1: 8MHz; Crystal_SMD_7050-4pin_7.0x5.0mm; MPN ECS-80-18-20BQ-DS

Connections:
12P_MONITOR_AI: U1.6 (AN16/PWM5L/RPI49/RC1); also elsewhere on the board
12V_MONITOR_AI: U1.34 (AN10/CVREF/PMA13/RPI42/RB10); also elsewhere on the board
+3.3VA: C8.1, L1.1, U1.30 (AVDD)
AUX_PORT_EN: U1.69 (ASDA1/DPLN/RPI73/RD9); also elsewhere on the board
AUX_PORT_ISENSE_AI: U1.20 (AN5/C1IN1+/VBUSON//VBUSST/RPI37/RB5); also elsewhere on the board
BATTERY_CONTACTOR_EN: U1.83 (C3IN2-/RP70/RD6); also elsewhere on the board
BATT_EN: U1.100 (AN28/PWM3L/PMD4/RP84/RE4); also elsewhere on the board
BATT_ISENSE_AI: U1.35 (AN11/PMA12/RPI43/RB11); also elsewhere on the board
BATT_~FAULT: U1.19 (AN21/RPI89/RE9); also elsewhere on the board
BMS_CONTROLLER_EN: U1.58 (ASCL2/RPI18/RA2); also elsewhere on the board
BRAKE_LIGHT_EN: U1.72 (INT0/DMH/RP64/RD0); also elsewhere on the board
BRAKE_SWITCH_1_IN: U1.39 (RP109/RF13); also elsewhere on the board
BRAKE_SWITCH_2_IN: U1.40 (RP108/RF12); also elsewhere on the board
BRIGHTS_SWITCH_IN: U1.96 (RPI124/RG12); also elsewhere on the board
CAN_RX: U1.11 (C1IN1-/SDI2/PMA4/RPI119/RG7); also elsewhere on the board
CAN_SLEEP: U1.3 (AN29/PWM3H/PMD5/RP85/RE5); also elsewhere on the board
CAN_TX: U1.10 (C1IN3-/SCK2/PMA5/RP118/RG6); also elsewhere on the board
CHARGER_CONTACTOR_EN: U1.81 (PMWR/RP68/RD4); also elsewhere on the board
CHARGE_CONTROLLER_EN: U1.61 (TDO/RPI21/RA5); also elsewhere on the board
CHARGE_PORT_RELEASE_EN: U1.53 (RP104/RF8); also elsewhere on the board
CONTACT_1_2_STATUS: U1.66 (RPI30/RA14); also elsewhere on the board
CONTACT_3_4_STATUS: U1.67 (RPI31/RA15); also elsewhere on the board
DAC_PWM_1: U1.50 (SCL2/PMA8/RP101/RF5); also elsewhere on the board
DAC_PWM_2: U1.49 (SDA2/PMA9/RP100/RF4); also elsewhere on the board
DCDC_CONTACTOR_EN: U1.82 (PMRD/RP69/RD5); also elsewhere on the board
DCDC_EN: U1.99 (AN27/PWM2H/PMD3/RPI83/RE3); also elsewhere on the board
DCDC_ISENSE_AI: U1.41 (AN12/PMA11/RPI44/RB12); also elsewhere on the board
DCDC_~FAULT: U1.18 (AN20/RPI88/RE8); also elsewhere on the board
DEBUG_LED: U1.17 (TMS/RPI16/RA0); also elsewhere on the board
DEBUG_PIN: U1.38 (TCK/RPI17/RA1); also elsewhere on the board
DIAG_EN: U1.94 (AN25/PWM1H/PMD1/RPI81/RE1); also elsewhere on the board
DIAG_SELECT: U1.98 (AN26/PWM2L/PMD2/RP82/RE2); also elsewhere on the board
ECU_1_ISENSE_AI: U1.33 (AN9/PMA7//RPI41/RB9); also elsewhere on the board
ECU_2_ISENSE_AI: U1.32 (AN8/PMA6/RPI40/RB8); also elsewhere on the board
FAN_1_EN: U1.51 (USBID/RP99/RF3); also elsewhere on the board
FAN_ISENSE_AI: U1.25 (PGED3/AN0/RPI32/RB0); also elsewhere on the board
FAN_SPEED_1_PWM: U1.87 (VCMPST1/RP96/RF0); also elsewhere on the board
GND: C1.2, C2.2, C3.2, C4.2, C5.2, C6.2, C7.2, C8.2, C9.2, C37.2, C61.2, SW1.1, U1.15 (VSS), U1.31 (AVSS), U1.36 (VSS), U1.45 (VSS), U1.65 (VSS), U1.75 (VSS), Y1.2, Y1.4; also elsewhere on the board
HEADLIGHT_HI_EN: U1.77 (DPH/RP66/RD2); also elsewhere on the board
HEADLIGHT_ISENSE_AI: U1.22 (AN3/C2IN1+/VPIO/RPI35/RB3); also elsewhere on the board
HEADLIGHT_LO_EN: U1.78 (PMBE/RP67/RD3); also elsewhere on the board
HEATED_GRIPS_EN: U1.47 (RPI78/RD14); also elsewhere on the board
HEATED_SEAT_EN: U1.48 (RP79/RD15); also elsewhere on the board
HEATER_ISENSE_AI: U1.27 (PGED1/AN7/RCV/RPI39/RB7); also elsewhere on the board
HORN_EN: U1.68 (RTCC/DMLN/RPI72/RD8); also elsewhere on the board
HORN_ISENSE_AI: U1.21 (AN4/C1IN2-/USBOEN/RPI36/RB4); also elsewhere on the board
HORN_SWITCH_IN: U1.97 (RP125/RG13); also elsewhere on the board
IC_CONTROLLER_ISENSE_AI: U1.42 (AN13/PMA10/RPI45/RB13); also elsewhere on the board
IC_CONTROLLER_SLEEP: U1.4 (AN30/PWM4L/PMD6/RPI86/RE6); also elsewhere on the board
IC_CONTROLLER_~FLT: U1.5 (AN31/PWM4H/PMD7/RP87/RE7); also elsewhere on the board
IGNITION_SWITCH_IN: U1.90 (RP112/RG0); also elsewhere on the board
J1772_CONTROLLER_EN: U1.59 (ASDA2/RPI19/RA3); also elsewhere on the board
KICKSTAND_SWITCH_IN: U1.95 (RP126/RG14); also elsewhere on the board
KILL_SWITCH_IN: U1.89 (RP113/RG1); also elsewhere on the board
LOCK_ISENSE_AI: U1.26 (PGEC1/AN6/RPI38/RB6); also elsewhere on the board
MOTOR_CONTROLLER_EN: U1.60 (TDI/RPI20/RA4); also elsewhere on the board
unnamed: C3.1, R1.1, U1.64 (OSC2/CLKO/RC15), Y1.1
unnamed: C4.1, R1.2, U1.63 (OSC1/RPI60/RC12), Y1.3
unnamed: C9.1, U1.85 (VCAP)
unnamed: R96.1, U1.13 (~MCLR)
PGEC: U1.74 (PGEC2/SOSCO/C3IN1-/T1CK/RPI62/RC14); also elsewhere on the board
PGED: U1.73 (PGED2/SOSCI/C3IN3-/RPI61/RC13); also elsewhere on the board
PILOT_EN: U1.91 (AN22/RPI22/RA6); also elsewhere on the board
PILOT_MONITOR_AI: U1.9 (AN19/PWM6H/RPI52/RC4); also elsewhere on the board
PRECHARGE_RELAY_EN: U1.84 (C3IN1+/VCMPST3/RP71/RD7); also elsewhere on the board
PROXIMITY_MONITOR_AI: U1.92 (AN23/RPI23/RA7); also elsewhere on the board
PUMP_1_EN: U1.52 (RP98/RF2); also elsewhere on the board
PUMP_SPEED_1_PWM: U1.88 (VCMPST2/RP97/RF1); also elsewhere on the board
RADIATOR_INPUT_TEMP_AI: U1.43 (AN14/PMA1/RPI46/RB14); also elsewhere on the board
RADIATOR_OUTPUT_TEMP_AI: U1.44 (AN15/PMA0/RPI47/RB15); also elsewhere on the board
SPARE_SWITCH_1_IN: U1.7 (AN17/PWM5H/RPI50/RC2); also elsewhere on the board
SPARE_SWITCH_2_IN: U1.8 (AN18/PWM6L/RPI51/RC3); also elsewhere on the board
STEERING_COLUMN_LOCK_EN: U1.1 (RP127/RG15); also elsewhere on the board
SW_EN: U1.93 (AN24/PWM1L/PMD0/RP80/RE0); also elsewhere on the board
TAILLIGHT_EN: U1.76 (VCPCON/RP65/RD1); also elsewhere on the board
TAILLIGHT_ISENSE_AI: U1.23 (AN2/C2IN2-/VMIO/RPI34/RB2); also elsewhere on the board
THROTTLE_SIGNAL_MONITOR_AI: U1.24 (PGEC3/AN1/RPI33/RB1); also elsewhere on the board
TURN_LEFT_SWITCH_IN: U1.57 (D+/RG2); also elsewhere on the board
TURN_RIGHT_SWITCH_IN: U1.56 (D-/RG3); also elsewhere on the board
TURN_SGINAL_FL_EN: U1.79 (RPI76/RD12); also elsewhere on the board
TURN_SIGNAL_FR_EN: U1.70 (ASCL1/PMCS2/RPI74/RD10); also elsewhere on the board
TURN_SIGNAL_L_STATUS: U1.29 (VREF+/RA10); also elsewhere on the board
TURN_SIGNAL_RL_EN: U1.80 (RPI77/RD13); also elsewhere on the board
TURN_SIGNAL_RR_EN: U1.71 (PMCS1/RPI75/RD11); also elsewhere on the board
TURN_SIGNAL_R_STATUS: U1.28 (VREF-/RA9); also elsewhere on the board
UART_RX: U1.14 (C2IN1-/PMA2/RPI121/RG9); also elsewhere on the board
UART_TX: U1.12 (C2IN3-/SDO2/PMA3/RP120/RG8); also elsewhere on the board
~RESET: R95.2, R96.2, SW1.2; also elsewhere on the board

Notes on the sheet:
TO ADD

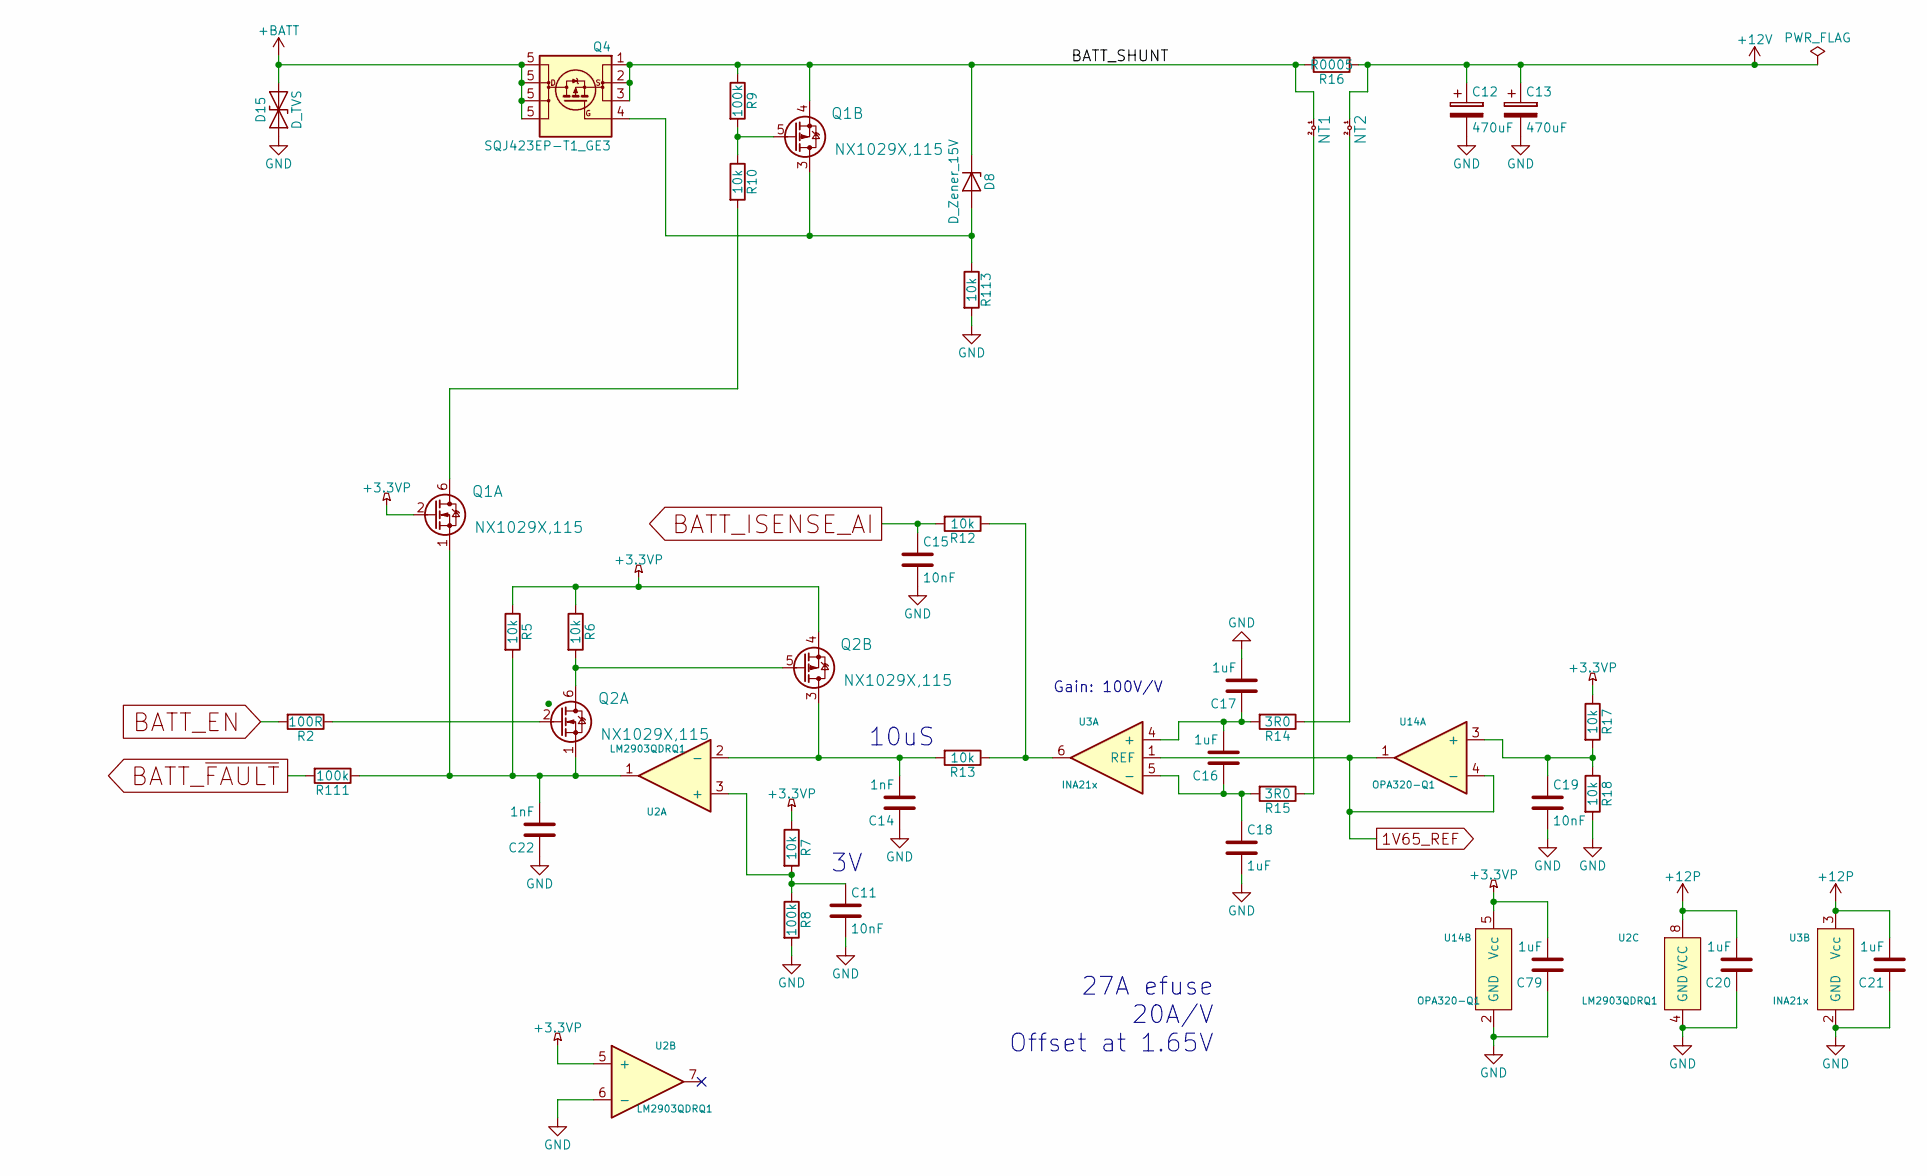
[picture p90: schematic PowerInput.sch]

Parts:
C11, C15, C19: 10nF; C_0603; MPN CGA3E2X7R1H103K080AA
C12, C13: 470uF; CP_Elec_10x10; MPN MAL214699004E3
C14, C22: 1nF; C_0603; MPN CGA3E2X7R1H102K080AA
C16, C17, C18, C20, C21, C79: 1uF; C_0805; MPN CGA4J3X7R1H105M125AE
D8: D_Zener_15V; D_SOD-123; MPN MMSZ5245BT1G
D15: D_TVS; D_SMC; MPN TPSMC33A
NT1, NT2: Net_Tie-0.5mm
Q1, Q2: NX1029X,115; SOT-666; MPN NX1029X,115
Q4: SQJ423EP-T1_GE3; TDSON-8-1; MPN SQJ423EP-T1_GE3
R2: 100R; R_0603; MPN AC0603FR-07100RL
R5, R6, R7, R10, R12, R13, R17, R18, R113: 10k; R_0603; MPN AC0603FR-0710KL
R8, R9, R111: 100k; R_0603; MPN AC0603FR-07100KL
R14, R15: 3R0; R_0603; MPN ERJ-3GEYJ3R0V
R16: R0005; SMD-2512_Pol; MPN HCS2512FTL500
U2: LM2903QDRQ1; TSSOP-8_3x4.4mm_Pitch0.65mm; MPN LM2903AVQPWRG4Q1
U3: INA21x; SOT-363_SC-70-6; MPN INA214AQDCKRQ1
U14: OPA320-Q1; SOT-23-5; MPN OPA320AQDBVRQ1

Connections:
1V65_REF: U3.1 (REF), U14.1, U14.4 (-); also elsewhere on the board
+3.3VP: C79.2, Q1.2, Q2.4, R5.1, R6.1, R7.1, R17.1, U2.5 (+), U14.5 (Vcc); also elsewhere on the board
+12P: C20.2, C21.2, U2.8 (VCC), U3.3 (Vcc); also elsewhere on the board
+12V: C12.1, C13.1, NT2.1, R16.1; also elsewhere on the board
+BATT: D15.2 (A2), Q4.5 (D); also elsewhere on the board
/TopLevel/PowerInput/BATT_SHUNT: D8.1 (K), NT1.1, Q1.4, Q4.1 (S), Q4.2 (S), Q4.3 (S), R9.1, R16.2
BATT_EN: R2.2; also elsewhere on the board
BATT_ISENSE_AI: C15.1, R12.2; also elsewhere on the board
BATT_~FAULT: R111.2; also elsewhere on the board
GND: C11.2, C12.2, C13.2, C14.1, C15.2, C17.2, C18.2, C19.2, C20.1, C21.1, C22.1, C79.1, D15.1 (A1), R8.2, R18.2, R113.2, U2.4 (GND), U2.6 (-), U3.2 (GND), U14.2 (GND); also elsewhere on the board
unnamed: C11.1, R7.2, R8.1, U2.3 (+)
unnamed: C14.2, Q2.3, R13.2, U2.2 (-)
unnamed: C16.1, C18.1, R15.2, U3.5 (-)
unnamed: C16.2, C17.1, R14.2, U3.4 (+)
unnamed: C19.1, R17.2, R18.1, U14.3 (+)
unnamed: C22.2, Q1.1, Q2.1, R5.2, R111.1, U2.1
unnamed: D8.2 (A), Q1.3, Q4.4 (G), R113.1
unnamed: NT1.2, R15.1
unnamed: NT2.2, R14.1
unnamed: Q1.5, R9.2, R10.1
unnamed: Q1.6, R10.2
unnamed: Q2.2, R2.1
unnamed: Q2.5, Q2.6, R6.2
unnamed: R12.1, R13.1, U3.6

Notes on the sheet:
27A efuse 20A/V Offset at 1.65V
10uS
Gain: 100V/V

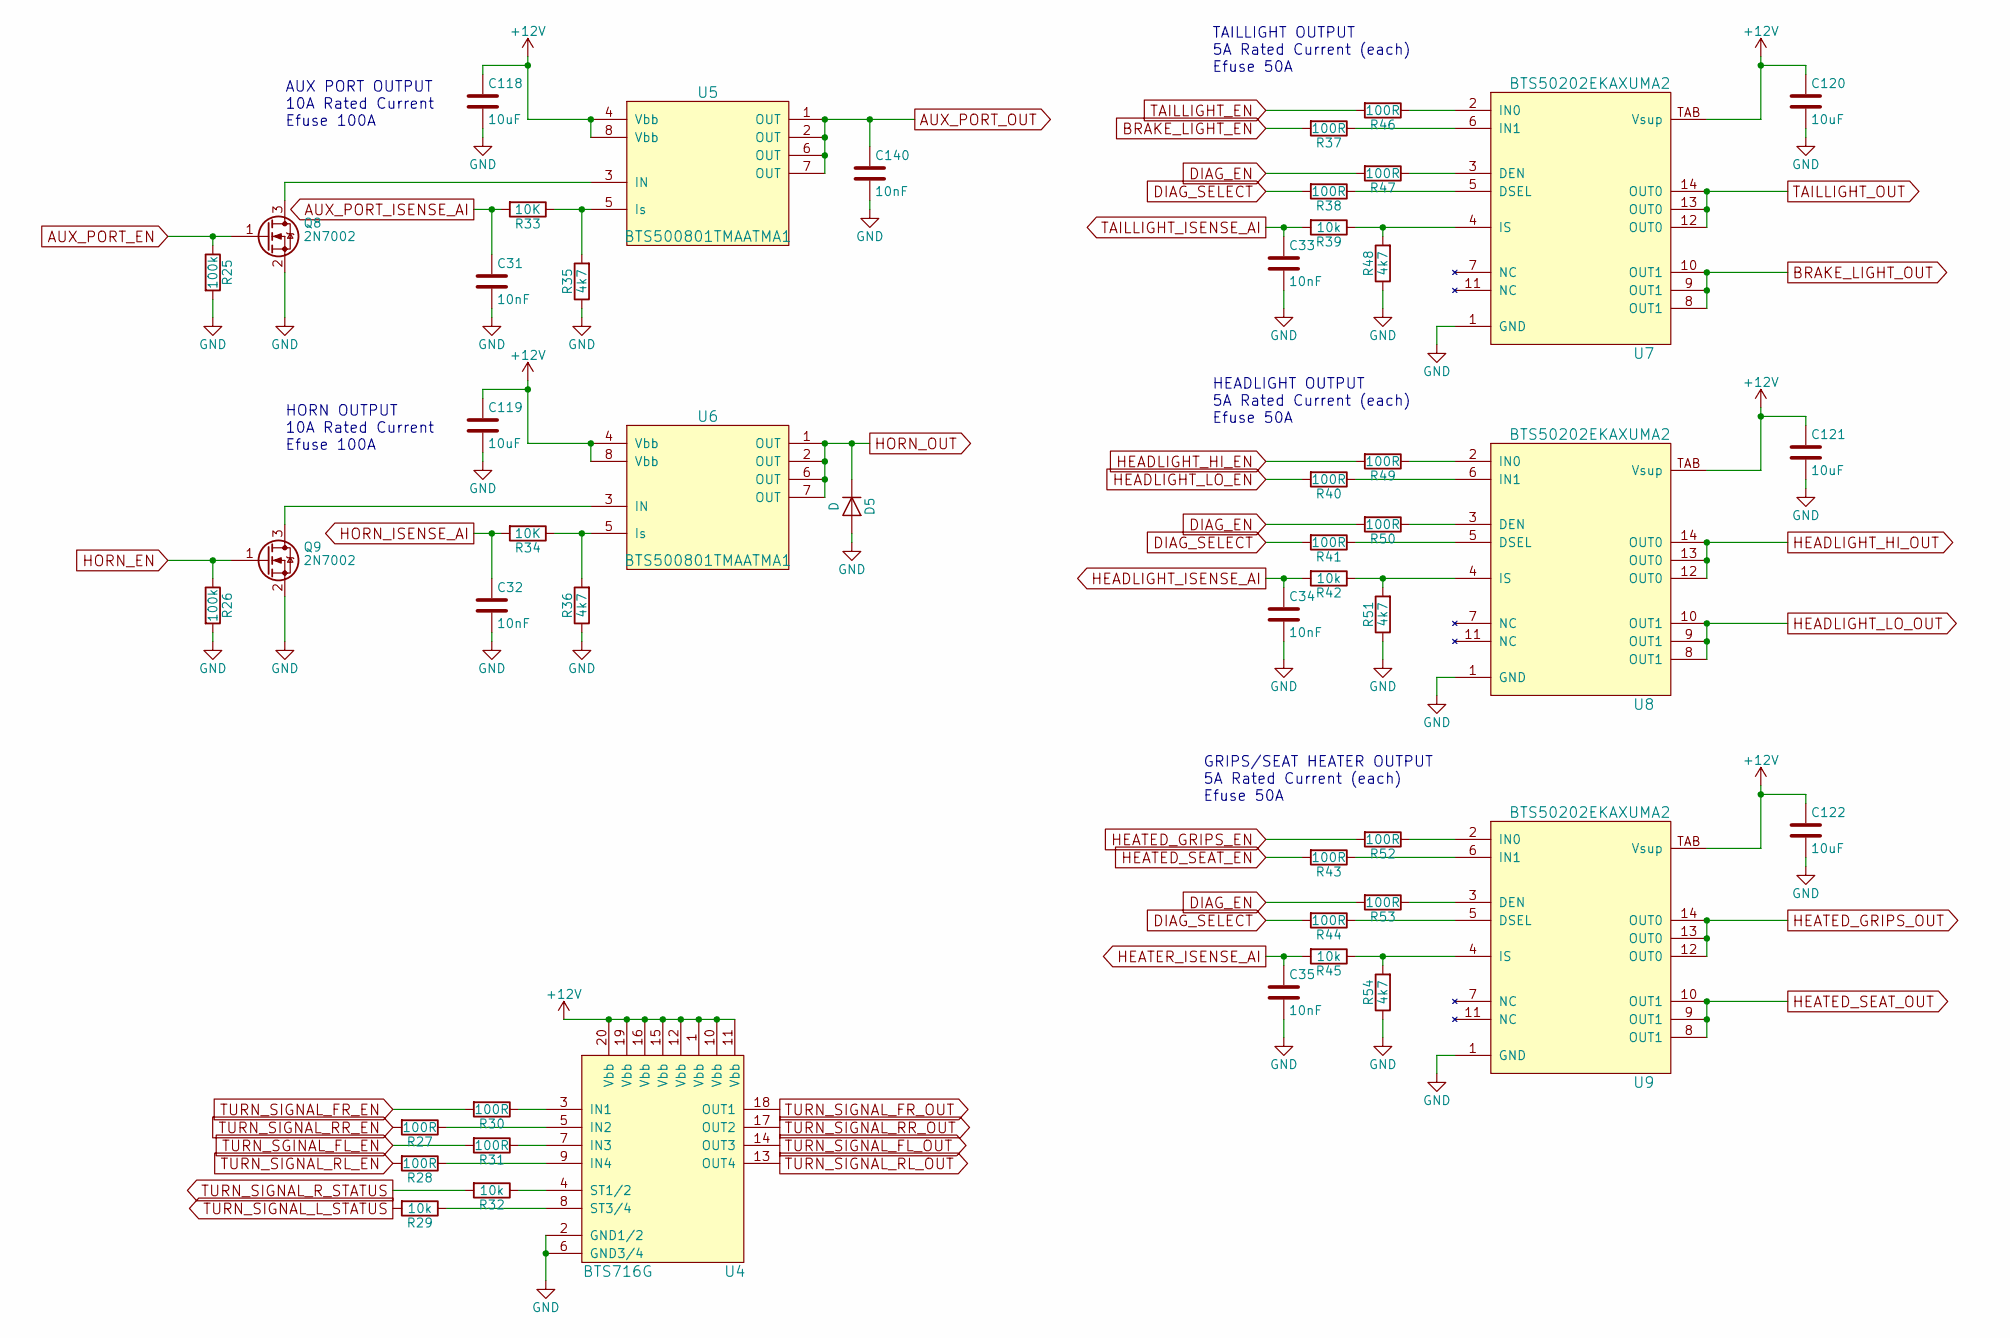
[picture p91: schematic HighSideDrivers_1.sch]

Parts:
C31, C32, C33, C34, C35, C140: 10nF; C_0603; MPN CGA3E2X7R1H103K080AA
C118, C119, C120, C121, C122: 10uF; C_1206; MPN C1206C106M3RACAUTO
D5: D; SOT1289; MPN PMEG060V100EPDZ
Q8, Q9: 2N7002; SOT-23; MPN 2N7002P,215
R25, R26: 100k; R_0603; MPN AC0603FR-07100KL
R27, R28, R30, R31, R37, R38, R40, R41, R43, R44, R46, R47, R49, R50, R52, R53: 100R; R_0603; MPN AC0603FR-07100RL
R29, R32, R39, R42, R45: 10k; R_0603; MPN AC0603FR-0710KL
R33, R34: 10K; R_0603; MPN AC0603FR-0710KL
R35, R36, R48, R51, R54: 4k7; R_0603; MPN AC0603FR-074K7L
U4: BTS716G; SOIC-20W_7.5x12.8mm_Pitch1.27mm; MPN BTS716GXUMA1
U5, U6: BTS500801TMAATMA1; TO-220-7Lead_TabPin8; MPN BTS500801TMAATMA1
U7, U8, U9: BTS50202EKAXUMA2; PG_DSO_14_40_EP; MPN BTS50202EKAXUMA2

Connections:
+12V: C118.1, C119.1, C120.1, C121.1, C122.1, U4.1 (Vbb), U4.10 (Vbb), U4.11 (Vbb), U4.12 (Vbb), U4.15 (Vbb), U4.16 (Vbb), U4.19 (Vbb), U4.20 (Vbb), U5.4 (Vbb), U5.8 (Vbb), U6.4 (Vbb), U6.8 (Vbb), U7.TAB (Vsup), U8.TAB (Vsup), U9.TAB (Vsup); also elsewhere on the board
AUX_PORT_EN: Q8.1 (G), R25.1; also elsewhere on the board
AUX_PORT_ISENSE_AI: C31.1, R33.2; also elsewhere on the board
AUX_PORT_OUT: C140.1, U5.1 (OUT), U5.2 (OUT), U5.6 (OUT), U5.7 (OUT); also elsewhere on the board
BRAKE_LIGHT_EN: R37.2; also elsewhere on the board
BRAKE_LIGHT_OUT: U7.8 (OUT1), U7.9 (OUT1), U7.10 (OUT1); also elsewhere on the board
DIAG_EN: R47.2, R50.2, R53.2; also elsewhere on the board
DIAG_SELECT: R38.2, R41.2, R44.2; also elsewhere on the board
GND: C31.2, C32.2, C33.2, C34.2, C35.2, C118.2, C119.2, C120.2, C121.2, C122.2, C140.2, D5.2 (A), Q8.2 (S), Q9.2 (S), R25.2, R26.2, R35.1, R36.1, R48.1, R51.1, R54.1, U4.2 (GND1/2), U4.6 (GND3/4), U7.1 (GND), U8.1 (GND), U9.1 (GND); also elsewhere on the board
HEADLIGHT_HI_EN: R49.2; also elsewhere on the board
HEADLIGHT_HI_OUT: U8.12 (OUT0), U8.13 (OUT0), U8.14 (OUT0); also elsewhere on the board
HEADLIGHT_ISENSE_AI: C34.1, R42.2; also elsewhere on the board
HEADLIGHT_LO_EN: R40.2; also elsewhere on the board
HEADLIGHT_LO_OUT: U8.8 (OUT1), U8.9 (OUT1), U8.10 (OUT1); also elsewhere on the board
HEATED_GRIPS_EN: R52.2; also elsewhere on the board
HEATED_GRIPS_OUT: U9.12 (OUT0), U9.13 (OUT0), U9.14 (OUT0); also elsewhere on the board
HEATED_SEAT_EN: R43.2; also elsewhere on the board
HEATED_SEAT_OUT: U9.8 (OUT1), U9.9 (OUT1), U9.10 (OUT1); also elsewhere on the board
HEATER_ISENSE_AI: C35.1, R45.2; also elsewhere on the board
HORN_EN: Q9.1 (G), R26.1; also elsewhere on the board
HORN_ISENSE_AI: C32.1, R34.2; also elsewhere on the board
HORN_OUT: D5.1 (K), U6.1 (OUT), U6.2 (OUT), U6.6 (OUT), U6.7 (OUT); also elsewhere on the board
unnamed: Q8.3 (D), U5.3 (IN)
unnamed: Q9.3 (D), U6.3 (IN)
unnamed: R27.1, U4.5 (IN2)
unnamed: R28.1, U4.9 (IN4)
unnamed: R29.1, U4.8 (ST3/4)
unnamed: R30.1, U4.3 (IN1)
unnamed: R31.1, U4.7 (IN3)
unnamed: R32.1, U4.4 (ST1/2)
unnamed: R33.1, R35.2, U5.5 (Is)
unnamed: R34.1, R36.2, U6.5 (Is)
unnamed: R37.1, U7.6 (IN1)
unnamed: R38.1, U7.5 (DSEL)
unnamed: R39.1, R48.2, U7.4 (IS)
unnamed: R40.1, U8.6 (IN1)
unnamed: R41.1, U8.5 (DSEL)
unnamed: R42.1, R51.2, U8.4 (IS)
unnamed: R43.1, U9.6 (IN1)
unnamed: R44.1, U9.5 (DSEL)
unnamed: R45.1, R54.2, U9.4 (IS)
unnamed: R46.1, U7.2 (IN0)
unnamed: R47.1, U7.3 (DEN)
unnamed: R49.1, U8.2 (IN0)
unnamed: R50.1, U8.3 (DEN)
unnamed: R52.1, U9.2 (IN0)
unnamed: R53.1, U9.3 (DEN)
TAILLIGHT_EN: R46.2; also elsewhere on the board
TAILLIGHT_ISENSE_AI: C33.1, R39.2; also elsewhere on the board
TAILLIGHT_OUT: U7.12 (OUT0), U7.13 (OUT0), U7.14 (OUT0); also elsewhere on the board
TURN_SGINAL_FL_EN: R31.2; also elsewhere on the board
TURN_SIGNAL_FL_OUT: U4.14 (OUT3); also elsewhere on the board
TURN_SIGNAL_FR_EN: R30.2; also elsewhere on the board
TURN_SIGNAL_FR_OUT: U4.18 (OUT1); also elsewhere on the board
TURN_SIGNAL_L_STATUS: R29.2; also elsewhere on the board
TURN_SIGNAL_RL_EN: R28.2; also elsewhere on the board
TURN_SIGNAL_RL_OUT: U4.13 (OUT4); also elsewhere on the board
TURN_SIGNAL_RR_EN: R27.2; also elsewhere on the board
TURN_SIGNAL_RR_OUT: U4.17 (OUT2); also elsewhere on the board
TURN_SIGNAL_R_STATUS: R32.2; also elsewhere on the board

Notes on the sheet:
AUX PORT OUTPUT 10A Rated Current Efuse 100A
HEADLIGHT OUTPUT 5A Rated Current (each) Efuse 50A
GRIPS/SEAT HEATER OUTPUT 5A Rated Current (each) Efuse 50A
TAILLIGHT OUTPUT 5A Rated Current (each) Efuse 50A
HORN OUTPUT 10A Rated Current Efuse 100A

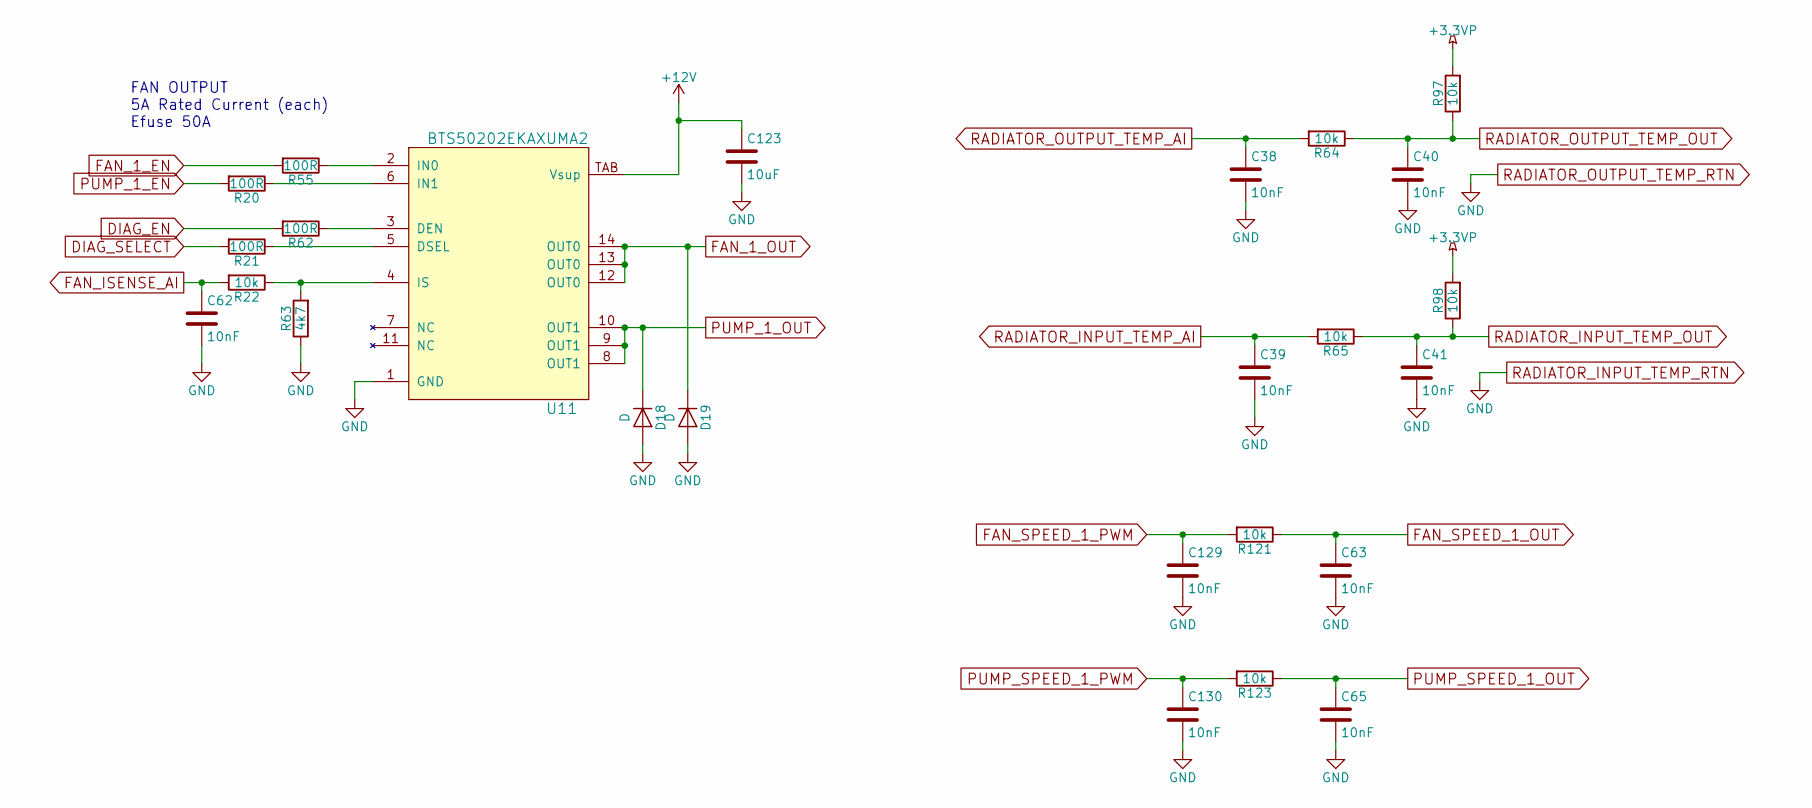
[picture p92: schematic HighSideDrivers_2.sch]

Parts:
C38, C39, C40, C41, C62, C63, C65, C129, C130: 10nF; C_0603; MPN CGA3E2X7R1H103K080AA
C123: 10uF; C_1206; MPN C1206C106M3RACAUTO
D18, D19: D; D_PowerDI-123; MPN DFLS1100Q-7
R20, R21, R55, R62: 100R; R_0603; MPN AC0603FR-07100RL
R22, R64, R65, R97, R98, R121, R123: 10k; R_0603; MPN AC0603FR-0710KL
R63: 4k7; R_0603; MPN AC0603FR-074K7L
U11: BTS50202EKAXUMA2; PG_DSO_14_40_EP; MPN BTS50202EKAXUMA2

Connections:
+3.3VP: R97.2, R98.2; also elsewhere on the board
+12V: C123.1, U11.TAB (Vsup); also elsewhere on the board
DIAG_EN: R62.2; also elsewhere on the board
DIAG_SELECT: R21.2; also elsewhere on the board
FAN_1_EN: R55.2; also elsewhere on the board
FAN_1_OUT: D19.1 (K), U11.12 (OUT0), U11.13 (OUT0), U11.14 (OUT0); also elsewhere on the board
FAN_ISENSE_AI: C62.1, R22.2; also elsewhere on the board
FAN_SPEED_1_OUT: C63.1, R121.1; also elsewhere on the board
FAN_SPEED_1_PWM: C129.1, R121.2; also elsewhere on the board
GND: C38.2, C39.2, C40.2, C41.2, C62.2, C63.2, C65.2, C123.2, C129.2, C130.2, D18.2 (A), D19.2 (A), R63.1, U11.1 (GND); also elsewhere on the board
unnamed: R20.1, U11.6 (IN1)
unnamed: R21.1, U11.5 (DSEL)
unnamed: R22.1, R63.2, U11.4 (IS)
unnamed: R55.1, U11.2 (IN0)
unnamed: R62.1, U11.3 (DEN)
PUMP_1_EN: R20.2; also elsewhere on the board
PUMP_1_OUT: D18.1 (K), U11.8 (OUT1), U11.9 (OUT1), U11.10 (OUT1); also elsewhere on the board
PUMP_SPEED_1_OUT: C65.1, R123.1; also elsewhere on the board
PUMP_SPEED_1_PWM: C130.1, R123.2; also elsewhere on the board
RADIATOR_INPUT_TEMP_AI: C39.1, R65.2; also elsewhere on the board
RADIATOR_INPUT_TEMP_OUT: C41.1, R65.1, R98.1; also elsewhere on the board
RADIATOR_OUTPUT_TEMP_AI: C38.1, R64.2; also elsewhere on the board
RADIATOR_OUTPUT_TEMP_OUT: C40.1, R64.1, R97.1; also elsewhere on the board

Notes on the sheet:
FAN OUTPUT 5A Rated Current (each) Efuse 50A
