zachleedogg/E_Moto/Firmware/Projects/Main_Controller_Bringup.X/HeatedGrips.c

/******************************************************************************
 * Includes
 *******************************************************************************/
#include "HeatedGrips.h"
#include "IO.h"
#include "MCU_dbc.h"
#include <stdint.h>

/******************************************************************************
 * Constants
 *******************************************************************************/

/******************************************************************************
 * Macros
 *******************************************************************************/

/******************************************************************************
 * Configuration
 *******************************************************************************/

/******************************************************************************
 * Typedefs
 *******************************************************************************/

/******************************************************************************
 * Variable Declarations
 *******************************************************************************/

/******************************************************************************
 * Function Prototypes
 *******************************************************************************/

/******************************************************************************
 * Function Definitions
 *******************************************************************************/

void HeatedGripControl_Init(void) {
    SET_HEATED_GRIPS_EN(LOW);
    SET_HEATED_SEAT_EN(LOW);
}

void HeatedGripControl_Run_100ms(void) {

    if (GET_SPARE_SWITCH_2_IN()) {
        SET_HEATED_GRIPS_EN(HIGH);
        SET_HEATED_SEAT_EN(HIGH);
    } else {
        SET_HEATED_GRIPS_EN(LOW);
        SET_HEATED_SEAT_EN(LOW);
    }
    
    //CAN_mcu_status_horn_set(GET_HORN_EN()); change this to heated grip status
}

void HeatedGripControl_Halt(void) {
    SET_HEATED_GRIPS_EN(LOW);
    SET_HEATED_SEAT_EN(LOW);
}

/*** End of File **************************************************************/
