zachleedogg/E_Moto/Firmware/Projects/Main_Controller_Bringup.X/HeatedGrips.h

/* 
 * File:   HeatedGrips.h
 * Author: kid group
 *
 * Created on June 23, 2019, 10:13 PM
 */

#ifndef HEATEDGRIPS_H
#define	HEATEDGRIPS_H

void HeatedGripControl_Init(void);

void HeatedGripControl_Run_100ms(void);

void HeatedGripControl_Halt(void);

#endif	/* HEATEDGRIPS_H */
