zachleedogg/E_Moto/Firmware/Projects/Main_Controller_Bringup.X/HornControl.h

/* 
 * File:   HornControl.h
 * Author: kid group
 *
 * Created on June 15, 2018, 10:03 PM
 */

#ifndef HORNCONTROL_H
#define	HORNCONTROL_H

void HornControl_Init(void);

void HornControl_Run_10ms(void);

void HornControl_Halt(void);

#endif	/* HORNCONTROL_H */
