zachleedogg/E_Moto/Firmware/Projects/Main_Controller_Bringup.X/IgnitionControl.h

/* 
 * File:   IgnitionControl.h
 * Author: kid group
 *
 * Created on June 12, 2018, 10:38 PM
 */

#ifndef IGNITIONCONTROL_H
#define	IGNITIONCONTROL_H

void IgnitionControl_Init(void);

void IgnitionControl_Run_10ms(void);


#endif	/* IGNITIONCONTROL_H */
