zachleedogg/E_Moto/Firmware/Projects/Main_Controller_Bringup.X/LightsControl.h

/* 
 * File:   LightsControl.h
 * Author: kid group
 *
 * Created on June 3, 2018, 11:39 AM
 */

#ifndef LIGHTSCONTROL_H
#define	LIGHTSCONTROL_H

void LightsControl_Init(void);

void LightsControl_Run_100ms(void);

void LightsControl_Halt(void);
#endif	/* LIGHTSCONTROL_H */
