zachleedogg/E_Moto/Firmware/Projects/Framework/main.c

/* 
 * File:   main.c
 * Author: Zach Levenberg
 *
 * Created on June 15, 2016, 5:07 PM
 */


#include "Defines.h"
#include "framework.h"
#include "bolt_init.h"

/*
 * 
 */
int main(void) {
    
    /*PIC33 Register setup*/
    Micro_Init();
    /*Clock PLL*/
    clockInit(DEFINES_SYSTEM_CLOCK_FREQ, DEFINES_SYSTEM_CLOCK_SOURCE);
    /*UART IO*/
    Uart1Init(DEFINES_UART_TX, DEFINES_UART_RX, DEFINES_UART_BAUD);
    Uart1Write("\nWelcome To Monday Motorbikes\n\n");
    /*Call the framework, we do not return from here*/
    FRAMEWORK_run(clockFreq());

    return 0;
}
