zachleedogg/E_Moto/Firmware/Projects/Main_Controller_Bringup.X/StateMachine.c

/******************************************************************************
 * Includes
 *******************************************************************************/
#include "IO.h"
#include "pinSetup.h"
#include "bolt_ADC.h"
#include "pins.h"

/******************************************************************************
 * Constants
 *******************************************************************************/

/******************************************************************************
 * Macros
 *******************************************************************************/

/******************************************************************************
 * Configuration
 *******************************************************************************/

/******************************************************************************
 * Typedefs
 *******************************************************************************/

/******************************************************************************
 * Variable Declarations
 *******************************************************************************/

/******************************************************************************
 * Function Prototypes
 *******************************************************************************/

/******************************************************************************
 * Function Definitions
 *******************************************************************************/
void StateMachine_Init(void){
    
}

void StateMachine_Run(void){
    
}

/*** End of File **************************************************************/
