zachleedogg/E_Moto/Firmware/Projects/BMS_App.X/StateMachine.h

/* 
 * File:   StateMachine.h
 * Author: kid group
 *
 * Created on March 14, 2018, 8:12 AM
 */

#ifndef STATEMACHINE_H
#define	STATEMACHINE_H

void StateMachine_Init(void);

void StateMachine_Run(void);

#endif	/* STATEMACHINE_H */
