zachleedogg/E_Moto/Firmware/Projects/BMS_App.X/IO.c

/******************************************************************************
 * Includes
 *******************************************************************************/
#include "IO.h"
#include "pinSetup.h"
#include "bolt_ADC.h"


/******************************************************************************
 * Constants
 *******************************************************************************/

/******************************************************************************
 * Macros
 *******************************************************************************/
#define ADC_BIT_DEPTH 1023.0
#define ADC_REF_VOLTAGE 3.0
#define ADC_FACTOR (ADC_REF_VOLTAGE/ADC_BIT_DEPTH)

/******************************************************************************
 * Configuration
 *******************************************************************************/

/******************************************************************************
 * Typedefs
 *******************************************************************************/

/******************************************************************************
 * Variable Declarations
 *******************************************************************************/

/******************************************************************************
 * Function Prototypes
 *******************************************************************************/

/******************************************************************************
 * Function Definitions
 *******************************************************************************/

void IO_SET_DEBUG_LED_EN(uint8_t state){
    PINS_write(DEBUG_LED_EN, state);
}

void IO_SET_SW_EN(uint8_t state) {
    PINS_write(SW_EN, state);
}

void IO_SET_DCDC_EN(uint8_t state) {
    PINS_write(DCDC_EN, state);
}

void IO_SET_EV_CHARGER_EN(uint8_t state) {
    PINS_write(EV_CHARGER_EN, state);
}

void IO_SET_DISCHARGE_EN(uint8_t state) {
    PINS_write(DISCHARGE_EN, state);
}

void IO_SET_PRE_CHARGE_EN(uint8_t state) {
    PINS_write(PRE_CHARGE_EN, state);
}

void IO_SET_MUX_A(uint8_t state) {
    PINS_write(MUX_A, state);
}

void IO_SET_MUX_B(uint8_t state) {
    PINS_write(MUX_B, state);
}

void IO_SET_MUX_C(uint8_t state) {
    PINS_write(MUX_C, state);
}

void IO_SET_SPI_CS(uint8_t state){
    PINS_write(SPI_CS, state);
}

/*INPUTS*/

uint8_t IO_GET_DEBUG_LED_EN(void) {
    return PINS_read(DEBUG_LED_EN);
}

uint8_t IO_GET_SW_EN(void) {
    return PINS_read(SW_EN);
}

uint8_t IO_GET_DCDC_EN(void) {
    return PINS_read(DCDC_EN);
}

uint8_t IO_GET_EV_CHARGER_EN(void) {
    return PINS_read(EV_CHARGER_EN);
}

uint8_t IO_GET_DISCHARGE_EN(void) {
    return PINS_read(DISCHARGE_EN);
}

uint8_t IO_GET_PRE_CHARGE_EN(void) {
    return PINS_read(PRE_CHARGE_EN);
}

uint8_t IO_GET_MUX_A(void) {
    return PINS_read(MUX_A);
}

uint8_t IO_GET_MUX_B(void) {
    return PINS_read(MUX_B);
}

uint8_t IO_GET_MUX_C(void) {
    return PINS_read(MUX_C);
}

uint8_t IO_GET_V12_POWER_STATUS(void) {
    return PINS_read(V12_POWER_STATUS);
}

uint8_t IO_GET_V5_SW_FAULT(void) {
    return !PINS_read(V5_SW_nFAULT);
}

uint8_t IO_GET_DCDC_FAULT(void) {
    return !PINS_read(DCDC_nFAULT);
}

uint8_t IO_GET_EV_CHARGER_FAULT(void) {
    return !PINS_read(EV_CHARGER_nFAULT);
}


/* Analog */

uint32_t IO_GET_ISOLATION_VOLTAGE(void){
    return ADC_GetValue(ISOLATION_VOLTAGE_AI)*1000.0*31.0*ADC_FACTOR;
}

uint32_t IO_GET_HV_BUS_VOLTAGE(void){
    return ADC_GetValue(HV_BUS_VOLTAGE_AI)*1000.0*31.0*ADC_FACTOR;
}

uint32_t IO_GET_EV_CHARGER_VOLTAGE(void){
    return ADC_GetValue(EV_CHARGER_VOLTAGE_AI)*1000.0*31.0*ADC_FACTOR;
}

uint32_t IO_GET_DCDC_OUTPUT_VOLTAGE(void){
    return ADC_GetValue(DCDC_OUTPUT_VOLTAGE_AI)*1000.0*31.0*ADC_FACTOR;
}

uint32_t IO_GET_MUX_1_VOLTAGE(void){
    return ADC_GetValue(MUX_1_AI)*1000.0*ADC_FACTOR;
}

uint32_t IO_GET_MUX_2_VOLTAGE(void){
    return ADC_GetValue(MUX_2_AI)*1000.0*ADC_FACTOR;
}

uint32_t IO_GET_MUX_3_VOLTAGE(void){
    return ADC_GetValue(MUX_3_AI)*1000.0*ADC_FACTOR;
}

uint32_t IO_GET_DCDC_CURRENT(void){
    return ADC_GetValue(DCDC_OUTPUT_CURRENT_AI)*1000.0*5*ADC_FACTOR;
}

uint32_t IO_GET_EV_CHARGER_CURRENT(void){
    return ADC_GetValue(EV_CHARGER_CURRENT_AI)*1000.0*20*ADC_FACTOR;
}

uint32_t IO_GET_SHUNT_HIGH_CURRENT(void){
    return 0;
}

uint32_t IO_GET_SHUNT_LOW_CURRENT(void){
    return 0;
}

uint32_t IO_GET_TRANSDUCER_CURRENT(void){
    return 0;
}




/*** End of File **************************************************************/
