zachleedogg/E_Moto/Firmware/Projects/BMS_App.X/ltc_6802.h

/* 
 * File:   
 * Author: 
 * Comments:
 * Revision history: 
 */

// This is a guard condition so that contents of this file are not included
// more than once.  
#ifndef LTC_6802_H
#define	LTC_6802_H

#include "bolt_spi.h"

void LTC_set_CDC(uint8_t cdc);
void LTC_set_CELL10(uint8_t cell10);
void LTC_set_LVPL(uint8_t lvpl);
void LTC_set_GPIO1(uint8_t gpio1);
void LTC_set_GPIO2(uint8_t gpio2);
void LTC_set_WDT(uint8_t wdt);
void LTC_set_cell_discharge(uint8_t cell);
void LTC_set_MCI(uint8_t cell);
void LTC_set_VUV(float underVoltage);
void LTC_set_VOV(float overVoltage);

void LTC_writeConfig(void);
void LTC_start_all_cell_ADC(void);
uint8_t LTC_check_ADC_status(void);
uint8_t LTC_read_all_cell_ADC(void);
uint16_t LTC_get_cell_voltage(uint8_t cell);


#endif	/* XC_HEADER_TEMPLATE_H */
