zachleedogg/E_Moto/Firmware/Projects/BMS_App.X/SerialDebugger.h

/* 
 * File:   SerialDebugger.h
 * Author: kid group
 *
 * Created on March 10, 2018, 4:10 PM
 */

#ifndef SERIALDEBUGGER_H
#define	SERIALDEBUGGER_H

/*Debugging print statement*/
void SerialConsole_Run_100ms(void);

#endif	/* SERIALDEBUGGER_H */
