zachleedogg/E_Moto/Firmware/Projects/Main_Controller_Bringup.X/j1772.h

/* 
 * File:   j1772.h
 * Author: kid group
 *
 * Created on June 17, 2018, 7:46 AM
 */

#ifndef J1772_H
#define	J1772_H

void j1772Control_Init(void);

void j1772Control_Run_100ms(void);

void j1772Control_Halt(void);

#endif	/* J1772_H */
