zachleedogg/E_Moto/Firmware/Projects/BMS_App.X/can.c

/******************************************************************************
 * Includes
 *******************************************************************************/

#include "pinSetup.h"

/******************************************************************************
 * Constants
 *******************************************************************************/

/******************************************************************************
 * Macros
 *******************************************************************************/

/******************************************************************************
 * Configuration
 *******************************************************************************/

/******************************************************************************
 * Typedefs
 *******************************************************************************/

/******************************************************************************
 * Variable Declarations
 *******************************************************************************/

/******************************************************************************
 * Function Prototypes
 *******************************************************************************/


/******************************************************************************
 * Function Definitions
 *******************************************************************************/


/*** End of File **************************************************************/
