zachleedogg/E_Moto/Firmware/Projects/BMS_Bootloader.X/.ca/buildLog/Config_1.txt

make -f nbproject/Makefile-Config_1.mk SUBPROJECTS= .clean-conf
make[1]: Entering directory 'C:/Users/kid group/Documents/Repos/E_Moto/Firmware/Projects/BMS_Controller_BL'
rm -f  -r .ca/build/Config_1/production
rm -f  -r .ca/dist/Config_1/production
make[1]: Leaving directory 'C:/Users/kid group/Documents/Repos/E_Moto/Firmware/Projects/BMS_Controller_BL'
[32mCLEAN SUCCESSFUL (total time: 153ms)[0m
make -f nbproject/Makefile-Config_1.mk SUBPROJECTS= .build-conf
make[1]: Entering directory 'C:/Users/kid group/Documents/Repos/E_Moto/Firmware/Projects/BMS_Controller_BL'
make  -f nbproject/Makefile-Config_1.mk .ca/dist/Config_1/production/BMS_Controller_BL.production.hex
make[2]: Entering directory 'C:/Users/kid group/Documents/Repos/E_Moto/Firmware/Projects/BMS_Controller_BL'
"C:\Program Files\Microchip\xc16\v2.00\bin\xc16-gcc.exe"   mcc_generated_files/boot/boot_application_header.c  -o .ca/build/Config_1/production/mcc_generated_files/boot/boot_application_header.o  -c -mcpu=33EP64GP506  -MP -MMD -MF ".ca/build/Config_1/production/mcc_generated_files/boot/boot_application_header.o.d"      -mno-eds-warn  -g -omf=elf -DXPRJ_Config_1=Config_1      -ffunction-sections -O1 -I"." -I"../../RTOS/Scheduler" -I"../../Libraries/PIC33_plib/inc" -I"../../Libraries/PIC33_plib/src" -I"../../CAN/generated" -I"../../Libraries/Standard" -I"../../Libraries/Drivers/TFT_LCD/inc" -I"../../Libraries/Drivers/TFT_LCD/src" -DDEBUG_502 -msmart-io=1 -Wall -msfr-warn=off    -mdfp="C:/Program Files/Microchip/MPLABX/v6.00/packs/Microchip/dsPIC33E-GM-GP-MC-GU-MU_DFP/1.3.85/xc16"
"C:\Program Files\Microchip\xc16\v2.00\bin\xc16-gcc.exe"   mcc_generated_files/traps.c  -o .ca/build/Config_1/production/mcc_generated_files/traps.o  -c -mcpu=33EP64GP506  -MP -MMD -MF ".ca/build/Config_1/production/mcc_generated_files/traps.o.d"      -mno-eds-warn  -g -omf=elf -DXPRJ_Config_1=Config_1      -ffunction-sections -O1 -I"." -I"../../RTOS/Scheduler" -I"../../Libraries/PIC33_plib/inc" -I"../../Libraries/PIC33_plib/src" -I"../../CAN/generated" -I"../../Libraries/Standard" -I"../../Libraries/Drivers/TFT_LCD/inc" -I"../../Libraries/Drivers/TFT_LCD/src" -DDEBUG_502 -msmart-io=1 -Wall -msfr-warn=off    -mdfp="C:/Program Files/Microchip/MPLABX/v6.00/packs/Microchip/dsPIC33E-GM-GP-MC-GU-MU_DFP/1.3.85/xc16"
"C:\Program Files\Microchip\xc16\v2.00\bin\xc16-gcc.exe"   mcc_generated_files/boot/boot_process.c  -o .ca/build/Config_1/production/mcc_generated_files/boot/boot_process.o  -c -mcpu=33EP64GP506  -MP -MMD -MF ".ca/build/Config_1/production/mcc_generated_files/boot/boot_process.o.d"      -mno-eds-warn  -g -omf=elf -DXPRJ_Config_1=Config_1      -ffunction-sections -O1 -I"." -I"../../RTOS/Scheduler" -I"../../Libraries/PIC33_plib/inc" -I"../../Libraries/PIC33_plib/src" -I"../../CAN/generated" -I"../../Libraries/Standard" -I"../../Libraries/Drivers/TFT_LCD/inc" -I"../../Libraries/Drivers/TFT_LCD/src" -DDEBUG_502 -msmart-io=1 -Wall -msfr-warn=off    -mdfp="C:/Program Files/Microchip/MPLABX/v6.00/packs/Microchip/dsPIC33E-GM-GP-MC-GU-MU_DFP/1.3.85/xc16"
"C:\Program Files\Microchip\xc16\v2.00\bin\xc16-gcc.exe"   mcc_generated_files/memory/flash_demo.c  -o .ca/build/Config_1/production/mcc_generated_files/memory/flash_demo.o  -c -mcpu=33EP64GP506  -MP -MMD -MF ".ca/build/Config_1/production/mcc_generated_files/memory/flash_demo.o.d"      -mno-eds-warn  -g -omf=elf -DXPRJ_Config_1=Config_1      -ffunction-sections -O1 -I"." -I"../../RTOS/Scheduler" -I"../../Libraries/PIC33_plib/inc" -I"../../Libraries/PIC33_plib/src" -I"../../CAN/generated" -I"../../Libraries/Standard" -I"../../Libraries/Drivers/TFT_LCD/inc" -I"../../Libraries/Drivers/TFT_LCD/src" -DDEBUG_502 -msmart-io=1 -Wall -msfr-warn=off    -mdfp="C:/Program Files/Microchip/MPLABX/v6.00/packs/Microchip/dsPIC33E-GM-GP-MC-GU-MU_DFP/1.3.85/xc16"
"C:\Program Files\Microchip\xc16\v2.00\bin\xc16-gcc.exe"   mcc_generated_files/boot/boot_demo.c  -o .ca/build/Config_1/production/mcc_generated_files/boot/boot_demo.o  -c -mcpu=33EP64GP506  -MP -MMD -MF ".ca/build/Config_1/production/mcc_generated_files/boot/boot_demo.o.d"      -mno-eds-warn  -g -omf=elf -DXPRJ_Config_1=Config_1      -ffunction-sections -O1 -I"." -I"../../RTOS/Scheduler" -I"../../Libraries/PIC33_plib/inc" -I"../../Libraries/PIC33_plib/src" -I"../../CAN/generated" -I"../../Libraries/Standard" -I"../../Libraries/Drivers/TFT_LCD/inc" -I"../../Libraries/Drivers/TFT_LCD/src" -DDEBUG_502 -msmart-io=1 -Wall -msfr-warn=off    -mdfp="C:/Program Files/Microchip/MPLABX/v6.00/packs/Microchip/dsPIC33E-GM-GP-MC-GU-MU_DFP/1.3.85/xc16"
"C:\Program Files\Microchip\xc16\v2.00\bin\xc16-gcc.exe"   mcc_generated_files/boot/com_adaptor_uart.c  -o .ca/build/Config_1/production/mcc_generated_files/boot/com_adaptor_uart.o  -c -mcpu=33EP64GP506  -MP -MMD -MF ".ca/build/Config_1/production/mcc_generated_files/boot/com_adaptor_uart.o.d"      -mno-eds-warn  -g -omf=elf -DXPRJ_Config_1=Config_1      -ffunction-sections -O1 -I"." -I"../../RTOS/Scheduler" -I"../../Libraries/PIC33_plib/inc" -I"../../Libraries/PIC33_plib/src" -I"../../CAN/generated" -I"../../Libraries/Standard" -I"../../Libraries/Drivers/TFT_LCD/inc" -I"../../Libraries/Drivers/TFT_LCD/src" -DDEBUG_502 -msmart-io=1 -Wall -msfr-warn=off    -mdfp="C:/Program Files/Microchip/MPLABX/v6.00/packs/Microchip/dsPIC33E-GM-GP-MC-GU-MU_DFP/1.3.85/xc16"
"C:\Program Files\Microchip\xc16\v2.00\bin\xc16-gcc.exe"   mcc_generated_files/boot/interrupts.S  -o .ca/build/Config_1/production/mcc_generated_files/boot/interrupts.o  -c -mcpu=33EP64GP506  -MP -MMD -MF ".ca/build/Config_1/production/mcc_generated_files/boot/interrupts.o.d"  -omf=elf -DXPRJ_Config_1=Config_1    -Wa,-MD,".ca/build/Config_1/production/mcc_generated_files/boot/interrupts.o.asm.d",--defsym=__MPLAB_BUILD=1,-g,--no-relax  -mdfp="C:/Program Files/Microchip/MPLABX/v6.00/packs/Microchip/dsPIC33E-GM-GP-MC-GU-MU_DFP/1.3.85/xc16"
"C:\Program Files\Microchip\xc16\v2.00\bin\xc16-gcc.exe"   mcc_generated_files/mcc.c  -o .ca/build/Config_1/production/mcc_generated_files/mcc.o  -c -mcpu=33EP64GP506  -MP -MMD -MF ".ca/build/Config_1/production/mcc_generated_files/mcc.o.d"      -mno-eds-warn  -g -omf=elf -DXPRJ_Config_1=Config_1      -ffunction-sections -O1 -I"." -I"../../RTOS/Scheduler" -I"../../Libraries/PIC33_plib/inc" -I"../../Libraries/PIC33_plib/src" -I"../../CAN/generated" -I"../../Libraries/Standard" -I"../../Libraries/Drivers/TFT_LCD/inc" -I"../../Libraries/Drivers/TFT_LCD/src" -DDEBUG_502 -msmart-io=1 -Wall -msfr-warn=off    -mdfp="C:/Program Files/Microchip/MPLABX/v6.00/packs/Microchip/dsPIC33E-GM-GP-MC-GU-MU_DFP/1.3.85/xc16"
"C:\Program Files\Microchip\xc16\v2.00\bin\xc16-gcc.exe"   mcc_generated_files/clock.c  -o .ca/build/Config_1/production/mcc_generated_files/clock.o  -c -mcpu=33EP64GP506  -MP -MMD -MF ".ca/build/Config_1/production/mcc_generated_files/clock.o.d"      -mno-eds-warn  -g -omf=elf -DXPRJ_Config_1=Config_1      -ffunction-sections -O1 -I"." -I"../../RTOS/Scheduler" -I"../../Libraries/PIC33_plib/inc" -I"../../Libraries/PIC33_plib/src" -I"../../CAN/generated" -I"../../Libraries/Standard" -I"../../Libraries/Drivers/TFT_LCD/inc" -I"../../Libraries/Drivers/TFT_LCD/src" -DDEBUG_502 -msmart-io=1 -Wall -msfr-warn=off    -mdfp="C:/Program Files/Microchip/MPLABX/v6.00/packs/Microchip/dsPIC33E-GM-GP-MC-GU-MU_DFP/1.3.85/xc16"
"C:\Program Files\Microchip\xc16\v2.00\bin\xc16-gcc.exe"   mcc_generated_files/boot/memory_partition.S  -o .ca/build/Config_1/production/mcc_generated_files/boot/memory_partition.o  -c -mcpu=33EP64GP506  -MP -MMD -MF ".ca/build/Config_1/production/mcc_generated_files/boot/memory_partition.o.d"  -omf=elf -DXPRJ_Config_1=Config_1    -Wa,-MD,".ca/build/Config_1/production/mcc_generated_files/boot/memory_partition.o.asm.d",--defsym=__MPLAB_BUILD=1,-g,--no-relax  -mdfp="C:/Program Files/Microchip/MPLABX/v6.00/packs/Microchip/dsPIC33E-GM-GP-MC-GU-MU_DFP/1.3.85/xc16"
"C:\Program Files\Microchip\xc16\v2.00\bin\xc16-gcc.exe"   mcc_generated_files/boot/boot_verify_not_blank.c  -o .ca/build/Config_1/production/mcc_generated_files/boot/boot_verify_not_blank.o  -c -mcpu=33EP64GP506  -MP -MMD -MF ".ca/build/Config_1/production/mcc_generated_files/boot/boot_verify_not_blank.o.d"      -mno-eds-warn  -g -omf=elf -DXPRJ_Config_1=Config_1      -ffunction-sections -O1 -I"." -I"../../RTOS/Scheduler" -I"../../Libraries/PIC33_plib/inc" -I"../../Libraries/PIC33_plib/src" -I"../../CAN/generated" -I"../../Libraries/Standard" -I"../../Libraries/Drivers/TFT_LCD/inc" -I"../../Libraries/Drivers/TFT_LCD/src" -DDEBUG_502 -msmart-io=1 -Wall -msfr-warn=off    -mdfp="C:/Program Files/Microchip/MPLABX/v6.00/packs/Microchip/dsPIC33E-GM-GP-MC-GU-MU_DFP/1.3.85/xc16"
"C:\Program Files\Microchip\xc16\v2.00\bin\xc16-gcc.exe"   mcc_generated_files/reset.c  -o .ca/build/Config_1/production/mcc_generated_files/reset.o  -c -mcpu=33EP64GP506  -MP -MMD -MF ".ca/build/Config_1/production/mcc_generated_files/reset.o.d"      -mno-eds-warn  -g -omf=elf -DXPRJ_Config_1=Config_1      -ffunction-sections -O1 -I"." -I"../../RTOS/Scheduler" -I"../../Libraries/PIC33_plib/inc" -I"../../Libraries/PIC33_plib/src" -I"../../CAN/generated" -I"../../Libraries/Standard" -I"../../Libraries/Drivers/TFT_LCD/inc" -I"../../Libraries/Drivers/TFT_LCD/src" -DDEBUG_502 -msmart-io=1 -Wall -msfr-warn=off    -mdfp="C:/Program Files/Microchip/MPLABX/v6.00/packs/Microchip/dsPIC33E-GM-GP-MC-GU-MU_DFP/1.3.85/xc16"
"C:\Program Files\Microchip\xc16\v2.00\bin\xc16-gcc.exe"   mcc_generated_files/memory/flash.s  -o .ca/build/Config_1/production/mcc_generated_files/memory/flash.o  -c -mcpu=33EP64GP506  -omf=elf -DXPRJ_Config_1=Config_1    -Wa,-MD,".ca/build/Config_1/production/mcc_generated_files/memory/flash.o.d",--defsym=__MPLAB_BUILD=1,-g,--no-relax  -mdfp="C:/Program Files/Microchip/MPLABX/v6.00/packs/Microchip/dsPIC33E-GM-GP-MC-GU-MU_DFP/1.3.85/xc16"
"C:\Program Files\Microchip\xc16\v2.00\bin\xc16-gcc.exe"   mcc_generated_files/system.c  -o .ca/build/Config_1/production/mcc_generated_files/system.o  -c -mcpu=33EP64GP506  -MP -MMD -MF ".ca/build/Config_1/production/mcc_generated_files/system.o.d"      -mno-eds-warn  -g -omf=elf -DXPRJ_Config_1=Config_1      -ffunction-sections -O1 -I"." -I"../../RTOS/Scheduler" -I"../../Libraries/PIC33_plib/inc" -I"../../Libraries/PIC33_plib/src" -I"../../CAN/generated" -I"../../Libraries/Standard" -I"../../Libraries/Drivers/TFT_LCD/inc" -I"../../Libraries/Drivers/TFT_LCD/src" -DDEBUG_502 -msmart-io=1 -Wall -msfr-warn=off    -mdfp="C:/Program Files/Microchip/MPLABX/v6.00/packs/Microchip/dsPIC33E-GM-GP-MC-GU-MU_DFP/1.3.85/xc16"
"C:\Program Files\Microchip\xc16\v2.00\bin\xc16-gcc.exe"   mcc_generated_files/pin_manager.c  -o .ca/build/Config_1/production/mcc_generated_files/pin_manager.o  -c -mcpu=33EP64GP506  -MP -MMD -MF ".ca/build/Config_1/production/mcc_generated_files/pin_manager.o.d"      -mno-eds-warn  -g -omf=elf -DXPRJ_Config_1=Config_1      -ffunction-sections -O1 -I"." -I"../../RTOS/Scheduler" -I"../../Libraries/PIC33_plib/inc" -I"../../Libraries/PIC33_plib/src" -I"../../CAN/generated" -I"../../Libraries/Standard" -I"../../Libraries/Drivers/TFT_LCD/inc" -I"../../Libraries/Drivers/TFT_LCD/src" -DDEBUG_502 -msmart-io=1 -Wall -msfr-warn=off    -mdfp="C:/Program Files/Microchip/MPLABX/v6.00/packs/Microchip/dsPIC33E-GM-GP-MC-GU-MU_DFP/1.3.85/xc16"
"C:\Program Files\Microchip\xc16\v2.00\bin\xc16-gcc.exe"   mcc_generated_files/boot/hardware_interrupt_table.S  -o .ca/build/Config_1/production/mcc_generated_files/boot/hardware_interrupt_table.o  -c -mcpu=33EP64GP506  -MP -MMD -MF ".ca/build/Config_1/production/mcc_generated_files/boot/hardware_interrupt_table.o.d"  -omf=elf -DXPRJ_Config_1=Config_1    -Wa,-MD,".ca/build/Config_1/production/mcc_generated_files/boot/hardware_interrupt_table.o.asm.d",--defsym=__MPLAB_BUILD=1,-g,--no-relax  -mdfp="C:/Program Files/Microchip/MPLABX/v6.00/packs/Microchip/dsPIC33E-GM-GP-MC-GU-MU_DFP/1.3.85/xc16"
"C:\Program Files\Microchip\xc16\v2.00\bin\xc16-gcc.exe"   mcc_generated_files/interrupt_manager.c  -o .ca/build/Config_1/production/mcc_generated_files/interrupt_manager.o  -c -mcpu=33EP64GP506  -MP -MMD -MF ".ca/build/Config_1/production/mcc_generated_files/interrupt_manager.o.d"      -mno-eds-warn  -g -omf=elf -DXPRJ_Config_1=Config_1      -ffunction-sections -O1 -I"." -I"../../RTOS/Scheduler" -I"../../Libraries/PIC33_plib/inc" -I"../../Libraries/PIC33_plib/src" -I"../../CAN/generated" -I"../../Libraries/Standard" -I"../../Libraries/Drivers/TFT_LCD/inc" -I"../../Libraries/Drivers/TFT_LCD/src" -DDEBUG_502 -msmart-io=1 -Wall -msfr-warn=off    -mdfp="C:/Program Files/Microchip/MPLABX/v6.00/packs/Microchip/dsPIC33E-GM-GP-MC-GU-MU_DFP/1.3.85/xc16"
"C:\Program Files\Microchip\xc16\v2.00\bin\xc16-gcc.exe"   mcc_generated_files/uart1.c  -o .ca/build/Config_1/production/mcc_generated_files/uart1.o  -c -mcpu=33EP64GP506  -MP -MMD -MF ".ca/build/Config_1/production/mcc_generated_files/uart1.o.d"      -mno-eds-warn  -g -omf=elf -DXPRJ_Config_1=Config_1      -ffunction-sections -O1 -I"." -I"../../RTOS/Scheduler" -I"../../Libraries/PIC33_plib/inc" -I"../../Libraries/PIC33_plib/src" -I"../../CAN/generated" -I"../../Libraries/Standard" -I"../../Libraries/Drivers/TFT_LCD/inc" -I"../../Libraries/Drivers/TFT_LCD/src" -DDEBUG_502 -msmart-io=1 -Wall -msfr-warn=off    -mdfp="C:/Program Files/Microchip/MPLABX/v6.00/packs/Microchip/dsPIC33E-GM-GP-MC-GU-MU_DFP/1.3.85/xc16"
"C:\Program Files\Microchip\xc16\v2.00\bin\xc16-gcc.exe"   main.c  -o .ca/build/Config_1/production/main.o  -c -mcpu=33EP64GP506  -MP -MMD -MF ".ca/build/Config_1/production/main.o.d"      -mno-eds-warn  -g -omf=elf -DXPRJ_Config_1=Config_1      -ffunction-sections -O1 -I"." -I"../../RTOS/Scheduler" -I"../../Libraries/PIC33_plib/inc" -I"../../Libraries/PIC33_plib/src" -I"../../CAN/generated" -I"../../Libraries/Standard" -I"../../Libraries/Drivers/TFT_LCD/inc" -I"../../Libraries/Drivers/TFT_LCD/src" -DDEBUG_502 -msmart-io=1 -Wall -msfr-warn=off    -mdfp="C:/Program Files/Microchip/MPLABX/v6.00/packs/Microchip/dsPIC33E-GM-GP-MC-GU-MU_DFP/1.3.85/xc16"
"C:\Program Files\Microchip\xc16\v2.00\bin\xc16-gcc.exe"   -o .ca/dist/Config_1/production/BMS_Controller_BL.production.elf  .ca/build/Config_1/production/mcc_generated_files/boot/memory_partition.o .ca/build/Config_1/production/mcc_generated_files/boot/boot_application_header.o .ca/build/Config_1/production/mcc_generated_files/boot/boot_process.o .ca/build/Config_1/production/mcc_generated_files/boot/interrupts.o .ca/build/Config_1/production/mcc_generated_files/boot/com_adaptor_uart.o .ca/build/Config_1/production/mcc_generated_files/boot/boot_demo.o .ca/build/Config_1/production/mcc_generated_files/boot/boot_verify_not_blank.o .ca/build/Config_1/production/mcc_generated_files/boot/hardware_interrupt_table.o .ca/build/Config_1/production/mcc_generated_files/memory/flash.o .ca/build/Config_1/production/mcc_generated_files/memory/flash_demo.o .ca/build/Config_1/production/mcc_generated_files/pin_manager.o .ca/build/Config_1/production/mcc_generated_files/traps.o .ca/build/Config_1/production/mcc_generated_files/mcc.o .ca/build/Config_1/production/mcc_generated_files/clock.o .ca/build/Config_1/production/mcc_generated_files/reset.o .ca/build/Config_1/production/mcc_generated_files/system.o .ca/build/Config_1/production/mcc_generated_files/interrupt_manager.o .ca/build/Config_1/production/mcc_generated_files/uart1.o .ca/build/Config_1/production/main.o      -mcpu=33EP64GP506        -omf=elf -DXPRJ_Config_1=Config_1      -Wl,--local-stack,,--defsym=__MPLAB_BUILD=1,,--script=p33EP64GP506.gld,--stack=16,--check-sections,--data-init,--pack-data,--handles,--isr,--gc-sections,--fill-upper=0,--stackguard=16,--no-force-link,--smart-io,-Map=".ca/dist/Config_1/production/BMS_Controller_BL.production.map",--report-mem,--memorysummary,.ca/dist/Config_1/production/memoryfile.xml  -mdfp="C:/Program Files/Microchip/MPLABX/v6.00/packs/Microchip/dsPIC33E-GM-GP-MC-GU-MU_DFP/1.3.85/xc16" 
[31m.ca/build/Config_1/production/mcc_generated_files/boot/boot_process.o: Link Error: Could not allocate section .text.CalculateChecksum, size = 252 PC units, attributes = code 
.ca/build/Config_1/production/mcc_generated_files/memory/flash.o: Link Error: Could not allocate section .NVM_flash, size = 244 PC units, attributes = code 
.ca/build/Config_1/production/mcc_generated_files/boot/boot_process.o: Link Error: Could not allocate section .text.ReadFlash, size = 228 PC units, attributes = code 
.ca/build/Config_1/production/mcc_generated_files/pin_manager.o: Link Error: Could not allocate section .text.PIN_MANAGER_Initialize, size = 152 PC units, attributes = code 
.ca/build/Config_1/production/mcc_generated_files/boot/boot_process.o: Link Error: Could not allocate section .text.BOOT_ProcessCommand, size = 136 PC units, attributes = code 
.ca/build/Config_1/production/mcc_generated_files/boot/boot_process.o: Link Error: Could not allocate section .const, size = 74 PC units, attributes = psv page 
.ca/build/Config_1/production/mcc_generated_files/boot/boot_process.o: Link Error: Could not allocate section .text.SelfVerify, size = 64 PC units, attributes = code 
.ca/build/Config_1/production/mcc_generated_files/clock.o: Link Error: Could not allocate section .text.CLOCK_Initialize, size = 64 PC units, attributes = code 
data_init: Link Error: Could not allocate section .dinit, size = 62 PC units, attributes = code keep 
.ca/build/Config_1/production/mcc_generated_files/boot/com_adaptor_uart.o: Link Error: Could not allocate section .text.BOOT_COM_GetBytesReady, size = 56 PC units, attributes = code 
.ca/build/Config_1/production/mcc_generated_files/boot/com_adaptor_uart.o: Link Error: Could not allocate section .text.BOOT_COM_Read, size = 50 PC units, attributes = code 
.ca/build/Config_1/production/mcc_generated_files/boot/boot_process.o: Link Error: Could not allocate section .text.ResetDevice, size = 44 PC units, attributes = code 
.ca/build/Config_1/production/mcc_generated_files/uart1.o: Link Error: Could not allocate section .text.UART1_Initialize, size = 44 PC units, attributes = code 
.ca/build/Config_1/production/mcc_generated_files/boot/boot_demo.o: Link Error: Could not allocate section .text.BOOT_DEMO_Tasks, size = 42 PC units, attributes = code 
.ca/build/Config_1/production/mcc_generated_files/boot/boot_verify_not_blank.o: Link Error: Could not allocate section .text.BOOT_ImageVerify, size = 38 PC units, attributes = code 
.ca/build/Config_1/production/mcc_generated_files/boot/boot_process.o: Link Error: Could not allocate section .text.CommandError, size = 36 PC units, attributes = code 
.ca/build/Config_1/production/mcc_generated_files/boot/boot_process.o: Link Error: Could not allocate section .text.ReadVersion, size = 34 PC units, attributes = code 
.ca/build/Config_1/production/mcc_generated_files/boot/com_adaptor_uart.o: Link Error: Could not allocate section .text.BOOT_COM_Write, size = 34 PC units, attributes = code 
.ca/build/Config_1/production/mcc_generated_files/uart1.o: Link Error: Could not allocate section .text.UART1_Write, size = 32 PC units, attributes = code 
.ca/build/Config_1/production/mcc_generated_files/boot/boot_process.o: Link Error: Could not allocate section .text.GetMemoryAddressRange, size = 28 PC units, attributes = code 
.ca/build/Config_1/production/mcc_generated_files/uart1.o: Link Error: Could not allocate section .text.UART1_IsTxReady, size = 28 PC units, attributes = code 
.ca/build/Config_1/production/mcc_generated_files/boot/boot_process.o: Link Error: Could not allocate section .text.IsLegalRange, size = 26 PC units, attributes = code 
.ca/build/Config_1/production/mcc_generated_files/interrupt_manager.o: Link Error: Could not allocate section .text.INTERRUPT_Initialize, size = 26 PC units, attributes = code 
.ca/build/Config_1/production/mcc_generated_files/uart1.o: Link Error: Could not allocate section .text.UART1_Read, size = 24 PC units, attributes = code 
.ca/build/Config_1/production/mcc_generated_files/boot/boot_process.o: Link Error: Could not allocate section .text.IsLegalAddress, size = 22 PC units, attributes = code 
.ca/build/Config_1/production/mcc_generated_files/boot/boot_process.o: Link Error: Could not allocate section .text.BOOT_ImageAddressGet, size = 20 PC units, attributes = code 
.ca/build/Config_1/production/mcc_generated_files/uart1.o: Link Error: Could not allocate section .text.UART1_IsTxDone, size = 20 PC units, attributes = code 
.ca/build/Config_1/production/mcc_generated_files/boot/com_adaptor_uart.o: Link Error: Could not allocate section .text.BOOT_COM_Peek, size = 18 PC units, attributes = code 
.ca/build/Config_1/production/mcc_generated_files/system.o: Link Error: Could not allocate section .text.SYSTEM_Initialize, size = 18 PC units, attributes = code 
.ca/build/Config_1/production/mcc_generated_files/uart1.o: Link Error: Could not allocate section .text.UART1_SetTxInterruptHandler, size = 14 PC units, attributes = code 
.ca/build/Config_1/production/mcc_generated_files/uart1.o: Link Error: Could not allocate section .text.UART1_SetRxInterruptHandler, size = 14 PC units, attributes = code 
.ca/build/Config_1/production/mcc_generated_files/uart1.o: Link Error: Could not allocate section .text.UART1_IsRxReady, size = 14 PC units, attributes = code 
.ca/build/Config_1/production/mcc_generated_files/system.o: Link Error: Could not allocate section .text.SYSTEM_CORCONModeOperatingSet, size = 12 PC units, attributes = code 
.ca/build/Config_1/production/mcc_generated_files/traps.o: Link Error: Could not allocate section .text.use_failsafe_stack, size = 10 PC units, attributes = code 
.ca/build/Config_1/production/mcc_generated_files/system.o: Link Error: Could not allocate section .text.INTERRUPT_GlobalEnable, size = 8 PC units, attributes = code 
.ca/build/Config_1/production/main.o: Link Error: Could not allocate section .text.main, size = 8 PC units, attributes = code 
.ca/build/Config_1/production/mcc_generated_files/boot/boot_process.o: Link Error: Could not allocate section .text.BOOT_StartApplication, size = 6 PC units, attributes = code 
.ca/build/Config_1/production/mcc_generated_files/boot/boot_process.o: Link Error: Could not allocate section .text.Reset, size = 4 PC units, attributes = code 
.ca/build/Config_1/production/mcc_generated_files/boot/boot_demo.o: Link Error: Could not allocate section .text.EnterBootloadMode, size = 4 PC units, attributes = code 
.ca/build/Config_1/production/mcc_generated_files/boot/hardware_interrupt_table.o: Link Error: Could not allocate section .text, size = 4 PC units, attributes = code 
.ca/build/Config_1/production/mcc_generated_files/traps.o: Link Error: Could not allocate section .text.TRAPS_halt_on_error, size = 4 PC units, attributes = code 
.ca/build/Config_1/production/mcc_generated_files/boot/boot_process.o: Link Error: Could not allocate section .text.BOOT_Initialize, size = 2 PC units, attributes = code 
.ca/build/Config_1/production/mcc_generated_files/boot/boot_demo.o: Link Error: Could not allocate section .text.BOOT_DEMO_Initialize, size = 2 PC units, attributes = code 
.ca/build/Config_1/production/mcc_generated_files/uart1.o: Link Error: Could not allocate section .text.UART1_Transmit_CallBack, size = 2 PC units, attributes = code 
.ca/build/Config_1/production/mcc_generated_files/uart1.o: Link Error: Could not allocate section .text.UART1_Receive_CallBack, size = 2 PC units, attributes = code 
.ca/build/Config_1/production/mcc_generated_files/memory/flash.o: Link Error: Could not allocate section .NVM_flash, size = 244 PC units, attributes = code 
.ca/build/Config_1/production/mcc_generated_files/boot/boot_process.o: Link Error: Could not allocate section .text.ReadFlash, size = 228 PC units, attributes = code 
.ca/build/Config_1/production/mcc_generated_files/pin_manager.o: Link Error: Could not allocate section .text.PIN_MANAGER_Initialize, size = 152 PC units, attributes = code 
.ca/build/Config_1/production/mcc_generated_files/boot/boot_process.o: Link Error: Could not allocate section .text.BOOT_ProcessCommand, size = 136 PC units, attributes = code 
.ca/build/Config_1/production/mcc_gen[0m
[31merated_files/boot/boot_process.o: Link Error: Could not allocate section .const, size = 74 PC units, attributes = psv page 
.ca/build/Config_1/production/mcc_generated_files/boot/boot_process.o: Link Error: Could not allocate section .text.SelfVerify, size = 64 PC units, attributes = code 
.ca/build/Config_1/production/mcc_generated_files/clock.o: Link Error: Could not allocate section .text.CLOCK_Initialize, size = 64 PC units, attributes = code 
data_init: Link Error: Could not allocate section .dinit, size = 62 PC units, attributes = code keep 
.ca/build/Config_1/production/mcc_generated_files/boot/com_adaptor_uart.o: Link Error: Could not allocate section .text.BOOT_COM_GetBytesReady, size = 56 PC units, attributes = code 
.ca/build/Config_1/production/mcc_generated_files/boot/com_adaptor_uart.o: Link Error: Could not allocate section .text.BOOT_COM_Read, size = 50 PC units, attributes = code 
.ca/build/Config_1/production/mcc_generated_files/boot/boot_process.o: Link Error: Could not allocate section .text.ResetDevice, size = 44 PC units, attributes = code 
.ca/build/Config_1/production/mcc_generated_files/uart1.o: Link Error: Could not allocate section .text.UART1_Initialize, size = 44 PC units, attributes = code 
.ca/build/Config_1/production/mcc_generated_files/boot/boot_demo.o: Link Error: Could not allocate section .text.BOOT_DEMO_Tasks, size = 42 PC units, attributes = code 
.ca/build/Config_1/production/mcc_generated_files/boot/boot_verify_not_blank.o: Link Error: Could not allocate section .text.BOOT_ImageVerify, size = 38 PC units, attributes = code 
.ca/build/Config_1/production/mcc_generated_files/boot/boot_process.o: Link Error: Could not allocate section .text.CommandError, size = 36 PC units, attributes = code 
.ca/build/Config_1/production/mcc_generated_files/boot/boot_process.o: Link Error: Could not allocate section .text.ReadVersion, size = 34 PC units, attributes = code 
.ca/build/Config_1/production/mcc_generated_files/boot/com_adaptor_uart.o: Link Error: Could not allocate section .text.BOOT_COM_Write, size = 34 PC units, attributes = code 
.ca/build/Config_1/production/mcc_generated_files/uart1.o: Link Error: Could not allocate section .text.UART1_Write, size = 32 PC units, attributes = code 
.ca/build/Config_1/production/mcc_generated_files/boot/boot_process.o: Link Error: Could not allocate section .text.GetMemoryAddressRange, size = 28 PC units, attributes = code 
.ca/build/Config_1/production/mcc_generated_files/uart1.o: Link Error: Could not allocate section .text.UART1_IsTxReady, size = 28 PC units, attributes = code 
.ca/build/Config_1/production/mcc_generated_files/boot/boot_process.o: Link Error: Could not allocate section .text.IsLegalRange, size = 26 PC units, attributes = code 
.ca/build/Config_1/production/mcc_generated_files/interrupt_manager.o: Link Error: Could not allocate section .text.INTERRUPT_Initialize, size = 26 PC units, attributes = code 
.ca/build/Config_1/production/mcc_generated_files/uart1.o: Link Error: Could not allocate section .text.UART1_Read, size = 24 PC units, attributes = code 
.ca/build/Config_1/production/mcc_generated_files/boot/boot_process.o: Link Error: Could not allocate section .text.IsLegalAddress, size = 22 PC units, attributes = code 
.ca/build/Config_1/production/mcc_generated_files/boot/boot_process.o: Link Error: Could not allocate section .text.BOOT_ImageAddressGet, size = 20 PC units, attributes = code 
.ca/build/Config_1/production/mcc_generated_files/uart1.o: Link Error: Could not allocate section .text.UART1_IsTxDone, size = 20 PC units, attributes = code 
.ca/build/Config_1/production/mcc_generated_files/boot/com_adaptor_uart.o: Link Error: Could not allocate section .text.BOOT_COM_Peek, size = 18 PC units, attributes = code 
.ca/build/Config_1/production/mcc_generated_files/system.o: Link Error: Could not allocate section .text.SYSTEM_Initialize, size = 18 PC units, attributes = code 
.ca/build/Config_1/production/mcc_generated_files/uart1.o: Link Error: Could not allocate section .text.UART1_SetTxInterruptHandler, size = 14 PC units, attributes = code 
.ca/build/Config_1/production/mcc_generated_files/uart1.o: Link Error: Could not allocate section .text.UART1_SetRxInterruptHandler, size = 14 PC units, attributes = code 
.ca/build/Config_1/production/mcc_generated_files/uart1.o: Link Error: Could not allocate section .text.UART1_IsRxReady, size = 14 PC units, attributes = code 
.ca/build/Config_1/production/mcc_generated_files/system.o: Link Error: Could not allocate section .text.SYSTEM_CORCONModeOperatingSet, size = 12 PC units, attributes = code 
.ca/build/Config_1/production/mcc_generated_files/traps.o: Link Error: Could not allocate section .text.use_failsafe_stack, size = 10 PC units, attributes = code 
.ca/build/Config_1/production/mcc_generated_files/system.o: Link Error: Could not allocate section .text.INTERRUPT_GlobalEnable, size = 8 PC units, attributes = code 
.ca/build/Config_1/production/main.o: Link Error: Could not allocate section .text.main, size = 8 PC units, attributes = code 
.ca/build/Config_1/production/mcc_generated_files/boot/boot_process.o: Link Error: Could not allocate section .text.BOOT_StartApplication, size = 6 PC units, attributes = code 
.ca/build/Config_1/production/mcc_generated_files/boot/boot_process.o: Link Error: Could not allocate section .text.Reset, size = 4 PC units, attributes = code 
.ca/build/Config_1/production/mcc_generated_files/boot/boot_demo.o: Link Error: Could not allocate section .text.EnterBootloadMode, size = 4 PC units, attributes = code 
.ca/build/Config_1/production/mcc_generated_files/boot/hardware_interrupt_table.o: Link Error: Could not allocate section .text, size = 4 PC units, attributes = code 
.ca/build/Config_1/production/mcc_generated_files/traps.o: Link Error: Could not allocate section .text.TRAPS_halt_on_error, size = 4 PC units, attributes = code 
.ca/build/Config_1/production/mcc_generated_files/boot/boot_process.o: Link Error: Could not allocate section .text.BOOT_Initialize, size = 2 PC units, attributes = code 
.ca/build/Config_1/production/mcc_generated_files/boot/boot_demo.o: Link Error: Could not allocate section .text.BOOT_DEMO_Initialize, size = 2 PC units, attributes = code 
.ca/build/Config_1/production/mcc_generated_files/uart1.o: Link Error: Could not allocate section .text.UART1_Transmit_CallBack, size = 2 PC units, attributes = code 
.ca/build/Config_1/production/mcc_generated_files/uart1.o: Link Error: Could not allocate section .text.UART1_Receive_CallBack, size = 2 PC units, attributes = code 
.ca/build/Config_1/production/mcc_generated_files/boot/boot_process.o: Link Error: Could not allocate section .text.ReadFlash, size = 228 PC units, attributes = code 
.ca/build/Config_1/production/mcc_generated_files/pin_manager.o: Link Error: Could not allocate section .text.PIN_MANAGER_Initialize, size = 152 PC units, attributes = code 
.ca/build/Config_1/production/mcc_generated_files/boot/boot_process.o: Link Error: Could not allocate section .text.BOOT_ProcessCommand, size = 136 PC units, attributes = code 
.ca/build/Config_1/production/mcc_generated_files/boot/boot_process.o: Link Error: Could not allocate section .const, size = 74 PC units, attributes = psv page 
.ca/build/Config_1/production/mcc_generated_files/boot/boot_process.o: Link Error: Could not allocate section .text.SelfVerify, size = 64 PC units, attributes = code 
.ca/build/Config_1/production/mcc_generated_files/clock.o: Link Error: Could not allocate section .text.CLOCK_Initialize, size = 64 PC units, attributes = code 
data_init: Link Error: Could not allocate section .dinit, size = 62 PC units, attributes = code keep 
.ca/build/Config_1/production/mcc_generated_files/boot/com_adaptor_uart.o: Link Error: Could not allocate section .text.BOOT_COM_GetBytesReady, size = 56 PC units, attributes = code 
.ca/build/Config_1/production/mcc_generated_files/boot/com_adaptor_uart.o: Link Error: Could not allocate section .text.BOOT_COM_Read, size = 50 PC units, attributes = code 
.ca/build/Config_1/production/mcc_generated_files/boot/boot_process.o: Link Error: Could not allocate section .text.ResetDevice, size[0m
[31m = 44 PC units, attributes = code 
.ca/build/Config_1/production/mcc_generated_files/uart1.o: Link Error: Could not allocate section .text.UART1_Initialize, size = 44 PC units, attributes = code 
.ca/build/Config_1/production/mcc_generated_files/boot/boot_demo.o: Link Error: Could not allocate section .text.BOOT_DEMO_Tasks, size = 42 PC units, attributes = code 
.ca/build/Config_1/production/mcc_generated_files/boot/boot_verify_not_blank.o: Link Error: Could not allocate section .text.BOOT_ImageVerify, size = 38 PC units, attributes = code 
.ca/build/Config_1/production/mcc_generated_files/boot/boot_process.o: Link Error: Could not allocate section .text.CommandError, size = 36 PC units, attributes = code 
.ca/build/Config_1/production/mcc_generated_files/boot/boot_process.o: Link Error: Could not allocate section .text.ReadVersion, size = 34 PC units, attributes = code 
.ca/build/Config_1/production/mcc_generated_files/boot/com_adaptor_uart.o: Link Error: Could not allocate section .text.BOOT_COM_Write, size = 34 PC units, attributes = code 
.ca/build/Config_1/production/mcc_generated_files/uart1.o: Link Error: Could not allocate section .text.UART1_Write, size = 32 PC units, attributes = code 
.ca/build/Config_1/production/mcc_generated_files/boot/boot_process.o: Link Error: Could not allocate section .text.GetMemoryAddressRange, size = 28 PC units, attributes = code 
.ca/build/Config_1/production/mcc_generated_files/uart1.o: Link Error: Could not allocate section .text.UART1_IsTxReady, size = 28 PC units, attributes = code 
.ca/build/Config_1/production/mcc_generated_files/boot/boot_process.o: Link Error: Could not allocate section .text.IsLegalRange, size = 26 PC units, attributes = code 
.ca/build/Config_1/production/mcc_generated_files/interrupt_manager.o: Link Error: Could not allocate section .text.INTERRUPT_Initialize, size = 26 PC units, attributes = code 
.ca/build/Config_1/production/mcc_generated_files/uart1.o: Link Error: Could not allocate section .text.UART1_Read, size = 24 PC units, attributes = code 
.ca/build/Config_1/production/mcc_generated_files/boot/boot_process.o: Link Error: Could not allocate section .text.IsLegalAddress, size = 22 PC units, attributes = code 
.ca/build/Config_1/production/mcc_generated_files/boot/boot_process.o: Link Error: Could not allocate section .text.BOOT_ImageAddressGet, size = 20 PC units, attributes = code 
.ca/build/Config_1/production/mcc_generated_files/uart1.o: Link Error: Could not allocate section .text.UART1_IsTxDone, size = 20 PC units, attributes = code 
.ca/build/Config_1/production/mcc_generated_files/boot/com_adaptor_uart.o: Link Error: Could not allocate section .text.BOOT_COM_Peek, size = 18 PC units, attributes = code 
.ca/build/Config_1/production/mcc_generated_files/system.o: Link Error: Could not allocate section .text.SYSTEM_Initialize, size = 18 PC units, attributes = code 
.ca/build/Config_1/production/mcc_generated_files/uart1.o: Link Error: Could not allocate section .text.UART1_SetTxInterruptHandler, size = 14 PC units, attributes = code 
.ca/build/Config_1/production/mcc_generated_files/uart1.o: Link Error: Could not allocate section .text.UART1_SetRxInterruptHandler, size = 14 PC units, attributes = code 
.ca/build/Config_1/production/mcc_generated_files/uart1.o: Link Error: Could not allocate section .text.UART1_IsRxReady, size = 14 PC units, attributes = code 
.ca/build/Config_1/production/mcc_generated_files/system.o: Link Error: Could not allocate section .text.SYSTEM_CORCONModeOperatingSet, size = 12 PC units, attributes = code 
.ca/build/Config_1/production/mcc_generated_files/traps.o: Link Error: Could not allocate section .text.use_failsafe_stack, size = 10 PC units, attributes = code 
.ca/build/Config_1/production/mcc_generated_files/system.o: Link Error: Could not allocate section .text.INTERRUPT_GlobalEnable, size = 8 PC units, attributes = code 
.ca/build/Config_1/production/main.o: Link Error: Could not allocate section .text.main, size = 8 PC units, attributes = code 
.ca/build/Config_1/production/mcc_generated_files/boot/boot_pr[0m
[31mocess.o: Link Error: Could not allocate section .text.BOOT_StartApplication, size = 6 PC units, attributes = code 
.ca/build/Config_1/production/mcc_generated_files/boot/boot_process.o: Link Error: Could not allocate section .text.Reset, size = 4 PC units, attributes = code 
.ca/build/Config_1/production/mcc_generated_files/boot/boot_demo.o: Link Error: Could not allocate section .text.EnterBootloadMode, size = 4 PC units, attributes = code 
.ca/build/Config_1/production/mcc_generated_files/boot/hardware_interrupt_table.o: Link Error: Could not allocate section .text, size = 4 PC units, attributes = code 
.ca/build/Config_1/production/mcc_generated_files/traps.o: Link Error: Could not allocate section .text.TRAPS_halt_on_error, size = 4 PC units, attributes = code 
.ca/build/Config_1/production/mcc_generated_files/boot/boot_process.o: Link Error: Could not allocate section .text.BOOT_Initialize, size = 2 PC units, attributes = code 
.ca/build/Config_1/production/mcc_generated_files/boot/boot_demo.o: Link Error: Could not allocate section .text.BOOT_DEMO_Initialize, size = 2 PC units, attributes = code 
.ca/build/Config_1/production/mcc_generated_files/uart1.o: Link Error: Could not allocate section .text.UART1_Transmit_CallBack, size = 2 PC units, attributes = code 
.ca/build/Config_1/production/mcc_generated_files/uart1.o: Link Error: Could not allocate section .text.UART1_Receive_CallBack, size = 2 PC units, attributes = code 
.ca/build/Config_1/production/mcc_generated_files/pin_manager.o: Link Error: Could not allocate section .text.PIN_MANAGER_Initialize, size = 152 PC units, attributes = code 
.ca/build/Config_1/production/mcc_generated_files/boot/boot_process.o: Link Error: Could not allocate section .text.BOOT_ProcessCommand, size = 136 PC units, attributes = code 
.ca/build/Config_1/production/mcc_generated_files/boot/boot_process.o: Link Error: Could not allocate section .const, size = 74 PC units, attributes = psv page 
.ca/build/Config_1/production/mcc_generated_files/boot/boot_process.o: Link Error: Could not allocate section .text.SelfVerify, size = 64 PC units, attributes = code 
.ca/build/Config_1/production/mcc_generated_files/clock.o: Link Error: Could not allocate section .text.CLOCK_Initialize, size = 64 PC units, attributes = code 
data_init: Link Error: Could not allocate section .dinit, size = 62 PC units, attributes = code keep 
.ca/build/Config_1/production/mcc_generated_files/boot/com_adaptor_uart.o: Link Error: Could not allocate section .text.BOOT_COM_GetBytesReady, size = 56 PC units, attributes = code 
.ca/build/Config_1/production/mcc_generated_files/boot/com_adaptor_uart.o: Link Error: Could not allocate section .text.BOOT_COM_Read, size = 50 PC units, attributes = code 
.ca/build/Config_1/production/mcc_generated_files/boot/boot_process.o: Link Error: Could not allocate section .text.ResetDevice, size = 44 PC units, attributes = code 
.ca/build/Config_1/production/mcc_generated_files/uart1.o: Link Error: Could not allocate section .text.UART1_Initialize, size = 44 PC units, attributes = code 
.ca/build/Config_1/production/mcc_generated_files/boot/boot_demo.o: Link Error: Could not allocate section .text.BOOT_DEMO_Tasks, size = 42 PC units, attributes = code 
.ca/build/Config_1/production/mcc_generated_files/boot/boot_verify_not_blank.o: Link Error: Could not allocate section .text.BOOT_ImageVerify, size = 38 PC units, attributes = code 
.ca/build/Config_1/production/mcc_generated_files/boot/boot_process.o: Link Error: Could not allocate section .text.CommandError, size = 36 PC units, attributes = code 
.ca/build/Config_1/production/mcc_generated_files/boot/boot_process.o: Link Error: Could not allocate section .text.ReadVersion, size = 34 PC units, attributes = code 
.ca/build/Config_1/production/mcc_generated_files/boot/com_adaptor_uart.o: Link Error: Could not allocate section .text.BOOT_COM_Write, size = 34 PC units, attributes = code 
.ca/build/Config_1/production/mcc_generated_files/uart1.o: Link Error: Could not allocate section .text.UART1_Write, size = 32 PC units, attributes = code 
.ca/build/Config_1/production/mcc_generated_files/boot/boot_process.o: Link Error: Could not allocate section .text.GetMemoryAddressRange, size = 28 PC units, attributes = code 
.ca/build/Config_1/production/mcc_generated_files/uart1.o: Link Error: Could not allocate section .text.UART1_IsTxReady, size = 28 PC units, attributes = code 
.ca/build/Config_1/production/mcc_generated_files/boot/boot_process.o: Link Error: Could not allocate section .text.IsLegalRange, size = 26 PC units, attributes = code 
.ca/build/Config_1/production/mcc_generated_files/interrupt_manager.o: Link Error: Could not allocate section .text.INTERRUPT_Initialize, size = 26 PC units, attributes = code 
.ca/build/Config_1/production/mcc_generated_files/uart1.o: Link Error: Could not allocate section .text.UART1_Read, size = 24 PC units, attributes = code 
.ca/build/Config_1/production/mcc_generated_files/boot/boot_process.o: Link Error: Could not allocate section .text.IsLegalAddress, size = 22 PC units, attributes = code 
.ca/build/Config_1/production/mcc_generated_files/boot/boot_process.o: Link Error: Could not allocate section .text.BOOT_ImageAddressGet, size = 20 PC units, attributes = code 
.ca/build/Config_1/production/mcc_generated_files/uart1.o: Link Error: Could not allocate section .text.UART1_IsTxDone, size = 20 PC units, attributes = code 
.ca/build/Config_1/production/mcc_generated_files/boot/com_adaptor_uart.o: Link Error: Could not allocate section .text.BOOT_COM_Peek, size = 18 PC units, attributes = code 
.ca/build/Config_1/production/mcc_generated_files/system.o: Link Error: Could not allocate section .text.SYSTEM_Initialize, size = 18 PC units, attributes = code 
.ca/build/Config_1/production/mcc_generated_files/uart1.o: Link Error: Could not allocate section .text.UART1_SetTxInterruptHandler, size = 14 PC units, attributes = code 
.ca/build/Config_1/production/mcc_generated_files/uart1.o: Link Error: Could not allocate section .text.UART1_SetRxInterruptHandler, size = 14 PC units, attributes = code 
.ca/build/Config_1/production/mcc_generated_files/uart1.o: Link Error: Could not allocate section .text.UART1_IsRxReady, size = 14 PC units, attributes = code 
.ca/build/Config_1/production/mcc_generated_files/system.o: Link Error: Could not allocate section .text.SYSTEM_CORCONModeOperatingSet, size = 12 PC units, attributes = code 
.ca/build/Config_1/production/mcc_generated_files/traps.o: Link Error: Could not allocate section .text.use_failsafe_stack, size = 10 PC units, attributes = code 
.ca/build/Config_1/production/mcc_generated_files/system.o: Link Error: Could not allocate section .text.INTERRUPT_GlobalEnable, size = 8 PC units, attributes = code 
.ca/build/Config_1/production/main.o: Link Error: Could not allocate section .text.main, size = 8 PC units, attributes = code 
.ca/build/Config_1/production/mcc_generated_files/boot/boot_process.o: Link Error: Could not allocate section .text.BOOT_StartApplication, size = 6 PC units, attributes = code 
.ca/build/Config_1/production/mcc_generated_files/boot/boot_process.o: Link Error: Could not allocate section .text.Reset, size = 4 PC units, attributes = code 
.ca/build/Config_1/production/mcc_generated_files/boot/boot_demo.o: Link Error: Could not allocate section .text.EnterBootloadMode, size = 4 PC units, attributes = code 
.ca/build/Config_1/production/mcc_generated_files/boot/hardware_interrupt_table.o: Link Error: Could not allocate section .text, size = 4 PC units, attributes = code 
.ca/build/Config_1/production/mcc_generated_files/traps.o: Link Error: Could not allocate section .text.TRAPS_halt_on_error, size = 4 PC units, attributes = code 
.ca/build/Config_1/production/mcc_generated_files/boot/boot_process.o: Link Error: Could not allocate section .text.BOOT_Initialize, size = 2 PC units, attributes = code 
.ca/build/Config_1/production/mcc_generated_files/boot/boot_demo.o: Link Error: Could not allocate section .text.BOOT_DEMO_Initialize, size = 2 PC units, attributes = code 
.ca/build/Config_1/production/mcc_generated_files/uart1.o: Link Error: Could not allocate s[0m
[31mection .text.UART1_Transmit_CallBack, size = 2 PC units, attributes = code 
.ca/build/Config_1/production/mcc_generated_files/uart1.o: Link Error: Could not allocate section .text.UART1_Receive_CallBack, size = 2 PC units, attributes = code 
.ca/build/Config_1/production/mcc_generated_files/boot/boot_process.o: Link Error: Could not allocate section .text.BOOT_ProcessCommand, size = 136 PC units, attributes = code 
.ca/build/Config_1/production/mcc_generated_files/boot/boot_process.o: Link Error: Could not allocate section .const, size = 74 PC units, attributes = psv page 
.ca/build/Config_1/production/mcc_generated_files/boot/boot_process.o: Link Error: Could not allocate section .text.SelfVerify, size = 64 PC units, attributes = code 
.ca/build/Config_1/production/mcc_generated_files/clock.o: Link Error: Could not allocate section .text.CLOCK_Initialize, size = 64 PC units, attributes = code 
data_init: Link Error: Could not allocate section .dinit, size = 62 PC units, attributes = code keep 
.ca/build/Config_1/production/mcc_generated_files/boot/com_adaptor_uart.o: Link Error: Could not allocate section .text.BOOT_COM_GetBytesReady, size = 56 PC units, attributes = code 
.ca/build/Config_1/production/mcc_generated_files/boot/com_adaptor_uart.o: Link Error: Could not allocate section .text.BOOT_COM_Read, size = 50 PC units, attributes = code 
.ca/build/Config_1/production/mcc_generated_files/boot/boot_process.o: Link Error: Could not allocate section .text.ResetDevice, size = 44 PC units, attributes = code 
.ca/build/Config_1/production/mcc_generated_files/uart1.o: Link Error: Could not allocate section .text.UART1_Initialize, size = 44 PC units, attributes = code 
.ca/build/Config_1/production/mcc_generated_files/boot/boot_demo.o: Link Error: Could not allocate section .text.BOOT_DEMO_Tasks, size = 42 PC units, attributes = code 
.ca/build/Config_1/production/mcc_generated_files/boot/boot_verify_not_blank.o: Link Error: Could not allocate section .text.BOOT_ImageVerify, size = 38 PC units, attributes = code 
.ca/build/Config_1/production/mcc_generated_files/boot/boot_process.o: Link Error: Could not allocate section .text.CommandError, size = 36 PC units, attributes = code 
.ca/build/Config_1/production/mcc_generated_files/boot/boot_process.o: Link Error: Could not allocate section .text.ReadVersion, size = 34 PC units, attributes = code 
.ca/build/Config_1/production/mcc_generated_files/boot/com_adaptor_uart.o: Link Error: Could not allocate section .text.BOOT_COM_Write, size = 34 PC units, attributes = code 
.ca/build/Config_1/production/mcc_generated_files/uart1.o: Link Error: Could not allocate section .text.UART1_Write, size = 32 PC units, attributes = code 
.ca/build/Config_1/production/mcc_generated_files/boot/boot_process.o: Link Error: Could not allocate section .text.GetMemoryAddressRange, size = 28 PC units, attributes = code 
.ca/build/Config_1/production/mcc_generated_files/uart1.o: Link Error: Could not allocate section .text.UART1_IsTxReady, size = 28 PC units, attributes = code 
.ca/build/Config_1/production/mcc_generated_files/boot/boot_process.o: Link Error: Could not allocate section .text.IsLegalRange, size = 26 PC units, attributes = code 
.ca/build/Config_1/production/mcc_generated_files/interrupt_manager.o: Link Error: Could not allocate section .text.INTERRUPT_Initialize, size = 26 PC units, attributes = code 
.ca/build/Config_1/production/mcc_generated_files/uart1.o: Link Error: Could not allocate section .text.UART1_Read, size = 24 PC units, attributes = code 
.ca/build/Config_1/production/mcc_generated_files/boot/boot_process.o: Link Error: Could not allocate section .text.IsLegalAddress, size = 22 PC units, attributes = code 
.ca/build/Config_1/production/mcc_generated_files/boot/boot_process.o: Link Error: Could not allocate section .text.BOOT_ImageAddressGet, size = 20 PC units, attributes = code 
.ca/build/Config_1/production/mcc_generated_files/uart1.o: Link Error: Could not allocate section .text.UART1_IsTxDone, size = 20 PC units, attributes = code 
.ca/build/Config_1/production/mcc_generated_files/boot/com_adaptor_uart.o: Link Error: Could not allocate section .text.BOOT_COM_Peek, size = 18 PC units, attributes = code 
.ca/build/Config_1/production/mcc_generated_files/system.o: Link Error: Could not allocate section .text.SYSTEM_Initialize, size = 18 PC units, attributes = code 
.ca/build/Config_1/production/mcc_generated_files/uart1.o: Link Error: Could not allocate section .text.UART1_SetTxInterruptHandler, size = 14 PC units, attributes = code 
.ca/build/Config_1/production/mcc_generated_files/uart1.o: Link Error: Could not allocate section .text.UART1_SetRxInterruptHandler, size = 14 PC units, attributes = code 
.ca/build/Config_1/production/mcc_generated_files/uart1.o: Link Error: Could not allocate section .text.UART1_IsRxReady, size = 14 PC units, attributes = code 
.ca/build/Config_1/production/mcc_generated_files/system.o: Link Error: Could not allocate section .text.SYSTEM_CORCONModeOperatingSet, size = 12 PC units, attributes = code 
.ca/build/Config_1/production/mcc_generated_files/traps.o: Link Error: Could not allocate section .text.use_failsafe_stack, size = 10 PC units, attributes = code 
.ca/build/Config_1/production/mcc_generated_files/system.o: Link Error: Could not allocate section .text.INTERRUPT_GlobalEnable, size = 8 PC units, attributes = code 
.ca/build/Config_1/production/main.o: Link Error: Could not allocate section .text.main, size = 8 PC units, attributes = code 
.ca/build/Config_1/production/mcc_generated_files/boot/boot_process.o: Link Error: Could not allocate section .text.BOOT_StartApplication, size = 6 PC units, attributes = code 
.ca/build/Config_1/production/mcc_generated_files/boot/boot_process.o: Link Error: Could not allocate section .text.Reset, size = 4 PC units, attributes = code 
.ca/build/Config_1/production/mcc_generated_files/boot/boot_demo.o: Link Error: Could not allocate section .text.EnterBootloadMode, size = 4 PC units, attributes = code 
.ca/build/Config_1/production/mcc_generated_files/boot/hardware_interrupt_table.o: Link Error: Could not allocate section .text, size = 4 PC units, attributes = code 
.ca/build/Config_1/production/mcc_generated_files/traps.o: Link Error: Could not allocate section .text.TRAPS_halt_on_error, size = 4 PC units, attributes = code 
.ca/build/Config_1/production/mcc_generated_files/boot/boot_process.o: Link Error: Could not allocate section .text.BOOT_Initialize, size = 2 PC units, attributes = code 
.ca/build/Config_1/production/mcc_generated_files/boot/boot_demo.o: Link Error: Could not allocate section .text.BOOT_DEMO_Initialize, size = 2 PC units, attributes = code 
.ca/build/Config_1/production/mcc_generated_files/uart1.o: Link Error: Could not allocate section .text.UART1_Transmit_CallBack, size = 2 PC units, attributes = code 
.ca/build/Config_1/production/mcc_generated_files/uart1.o: Link Error: Could not allocate section .text.UART1_Receive_CallBack, size = 2 PC units, attributes = code 
.ca/build/Config_1/production/mcc_generated_files/clock.o: Link Error: Could not allocate section .text.CLOCK_Initialize, size = 64 PC units, attributes = code 
data_init: Link Error: Could not allocate section .dinit, size = 62 PC units, attributes = code keep 
.ca/build/Config_1/production/mcc_generated_files/boot/com_adaptor_uart.o: Link Error: Could not allocate section .text.BOOT_COM_GetBytesReady, size = 56 PC units, attributes = code 
.ca/build/Config_1/production/mcc_generated_files/boot/com_adaptor_uart.o: Link Error: Could not allocate section .text.BOOT_COM_Read, size = 50 PC units, attributes = code 
.ca/build/Config_1/production/mcc_generated_files/boot/boot_process.o: Link Error: Could not allocate section .text.ResetDevice, size = 44 PC units, attributes = code 
.ca/build/Config_1/production/mcc_generated_files/uart1.o: Link Error: Could not allocate section .text.UART1_Initialize, size = 44 PC units, attributes = code 
.ca/build/Config_1/production/mcc_generated_files/boot/boot_demo.o: Link Error: Could not allocate section .text.BOOT_DEMO_Tasks, size = 42 PC units, attributes = code 
.ca/build/Config_1/produc[0m
[31mtion/mcc_generated_files/boot/boot_verify_not_blank.o: Link Error: Could not allocate section .text.BOOT_ImageVerify, size = 38 PC units, attributes = code 
.ca/build/Config_1/production/mcc_generated_files/boot/boot_process.o: Link Error: Could not allocate section .text.CommandError, size = 36 PC units, attributes = code 
.ca/build/Config_1/production/mcc_generated_files/boot/boot_process.o: Link Error: Could not allocate section .text.ReadVersion, size = 34 PC units, attributes = code 
.ca/build/Config_1/production/mcc_generated_files/boot/com_adaptor_uart.o: Link Error: Could not allocate section .text.BOOT_COM_Write, size = 34 PC units, attributes = code 
.ca/build/Config_1/production/mcc_generated_files/uart1.o: Link Error: Could not allocate section .text.UART1_Write, size = 32 PC units, attributes = code 
.ca/build/Config_1/production/mcc_generated_files/boot/boot_process.o: Link Error: Could not allocate section .text.GetMemoryAddressRange, size = 28 PC units, attributes = code 
.ca/build/Config_1/production/mcc_generated_files/uart1.o: Link Error: Could not allocate section .text.UART1_IsTxReady, size = 28 PC units, attributes = code 
.ca/build/Config_1/production/mcc_generated_files/boot/boot_process.o: Link Error: Could not allocate section .text.IsLegalRange, size = 26 PC units, attributes = code 
.ca/build/Config_1/production/mcc_generated_files/interrupt_manager.o: Link Error: Could not allocate section .text.INTERRUPT_Initialize, size = 26 PC units, attributes = code 
.ca/build/Config_1/production/mcc_generated_files/uart1.o: Link Error: Could not allocate section .text.UART1_Read, size = 24 PC units, attributes = code 
.ca/build/Config_1/production/mcc_generated_files/boot/boot_process.o: Link Error: Could not allocate section .text.IsLegalAddress, size = 22 PC units, attributes = code 
.ca/build/Config_1/production/mcc_generated_files/boot/boot_process.o: Link Error: Could not allocate section .text.BOOT_ImageAddressGet, size = 20 PC units, attributes = code 
.ca/build/Config_1/production/mcc_generated_files/uart1.o: Link Error: Could not allocate section .text.UART1_IsTxDone, size = 20 PC units, attributes = code 
.ca/build/Config_1/production/mcc_generated_files/boot/com_adaptor_uart.o: Link Error: Could not allocate section .text.BOOT_COM_Peek, size = 18 PC units, attributes = code 
.ca/build/Config_1/production/mcc_generated_files/system.o: Link Error: Could not allocate section .text.SYSTEM_Initialize, size = 18 PC units, attributes = code 
.ca/build/Config_1/production/mcc_generated_files/uart1.o: Link Error: Could not allocate section .text.UART1_SetTxInterruptHandler, size = 14 PC units, attributes = code 
.ca/build/Config_1/production/mcc_generated_files/uart1.o: Link Error: Could not allocate section .text.UART1_SetRxInterruptHandler, size = 14 PC units, attributes = code 
.ca/build/Config_1/production/mcc_generated_files/uart1.o: Link Error: Could not allocate section .text.UART1_IsRxReady, size = 14 PC units, attributes = code 
.ca/build/Config_1/production/mcc_generated_files/system.o: Link Error: Could not allocate section .text.SYSTEM_CORCONModeOperatingSet, size = 12 PC units, attributes = code 
.ca/build/Config_1/production/mcc_generated_files/traps.o: Link Error: Could not allocate section .text.use_failsafe_stack, size = 10 PC units, attributes = code 
.ca/build/Config_1/production/mcc_generated_files/system.o: Link Error: Could not allocate section .text.INTERRUPT_GlobalEnable, size = 8 PC units, attributes = code 
.ca/build/Config_1/production/main.o: Link Error: Could not allocate section .text.main, size = 8 PC units, attributes = code 
.ca/build/Config_1/production/mcc_generated_files/boot/boot_process.o: Link Error: Could not allocate section .text.BOOT_StartApplication, size = 6 PC units, attributes = code 
.ca/build/Config_1/production/mcc_generated_files/boot/boot_process.o: Link Error: Could not allocate section .text.Reset, size = 4 PC units, attributes = code 
.ca/build/Config_1/production/mcc_generated_files/boot/boot_demo.o: Link Error: Could not allocate section .text.EnterBootloadMode, size = 4 PC units, attributes = code 
.ca/build/Config_1/production/mcc_generated_files/boot/hardware_interrupt_table.o: Link Error: Could not allocate section .text, size = 4 PC units, attributes = code 
.ca/build/Config_1/production/mcc_generated_files/traps.o: Link Error: Could not allocate section .text.TRAPS_halt_on_error, size = 4 PC units, attributes = code 
.ca/build/Config_1/production/mcc_generated_files/boot/boot_process.o: Link Error: Could not allocate section .text.BOOT_Initialize, size = 2 PC units, attributes = code 
.ca/build/Config_1/production/mcc_generated_files/boot/boot_demo.o: Link Error: Could not allocate section .text.BOOT_DEMO_Initialize, size = 2 PC units, attributes = code 
.ca/build/Config_1/production/mcc_generated_files/uart1.o: Link Error: Could not allocate section .text.UART1_Transmit_CallBack, size = 2 PC units, attributes = code 
.ca/build/Config_1/production/mcc_generated_files/uart1.o: Link Error: Could not allocate section .text.UART1_Receive_CallBack, size = 2 PC units, attributes = code 
data_init: Link Error: Could not allocate section .dinit, size = 62 PC units, attributes = code keep 
.ca/build/Config_1/production/mcc_generated_files/boot/com_adaptor_uart.o: Link Error: Could not allocate section .text.BOOT_COM_GetBytesReady, size = 56 PC units, attributes = code 
.ca/build/Config_1/production/mcc_generated_files/boot/com_adaptor_uart.o: Link Error: Could not allocate section .text.BOOT_COM_Read, size = 50 PC units, attributes = code 
.ca/build/Config_1/production/mcc_generated_files/boot/boot_process.o: Link Error: Could not allocate section .text.ResetDevice, size = 44 PC units, attributes = code 
.ca/build/Config_1/production/mcc_generated_files/uart1.o: Link Error: Could not allocate section .text.UART1_Initialize, size = 44 PC units, attributes = code 
.ca/build/Config_1/production/mcc_generated_files/boot/boot_demo.o: Link Error: Could not allocate section .text.BOOT_DEMO_Tasks, size = 42 PC units, attributes = code 
.ca/build/Config_1/production/mcc_generated_files/boot/boot_verify_not_blank.o: Link Error: Could not allocate section .text.BOOT_ImageVerify, size = 38 PC units, attributes = code 
.ca/build/Config_1/production/mcc_generated_files/boot/boot_process.o: Link Error: Could not allocate section .text.CommandError, size = 36 PC units, attributes = code 
.ca/build/Config_1/production/mcc_generated_files/boot/boot_process.o: Link Error: Could not allocate section .text.ReadVersion, size = 34 PC units, attributes = code 
.ca/build/Config_1/production/mcc_generated_files/boot/com_adaptor_uart.o: Link Error: Could not allocate section .text.BOOT_COM_Write, size = 34 PC units, attributes = code 
.ca/build/Config_1/production/mcc_generated_files/uart1.o: Link Error: Could not allocate section .text.UART1_Write, size = 32 PC units, attributes = code 
.ca/build/Config_1/production/mcc_generated_files/boot/boot_process.o: Link Error: Could not allocate section .text.GetMemoryAddressRange, size = 28 PC units, attributes = code 
.ca/build/Config_1/production/mcc_generated_files/uart1.o: Link Error: Could not allocate section .text.UART1_IsTxReady, size = 28 PC units, attributes = code 
.ca/build/Config_1/production/mcc_generated_files/boot/boot_process.o: Link Error: Could not allocate section .text.IsLegalRange, size = 26 PC units, attributes = code 
.ca/build/Config_1/production/mcc_generated_files/interrupt_manager.o: Link Error: Could not allocate section .text.INTERRUPT_Initialize, size = 26 PC units, attributes = code 
.ca/build/Config_1/production/mcc_generated_files/uart1.o: Link Error: Could not allocate section .text.UART1_Read, size = 24 PC units, attributes = code 
.ca/build/Config_1/production/mcc_generated_files/boot/boot_process.o: Link Error: Could not allocate section .text.IsLegalAddress, size = 22 PC units, attributes = code 
.ca/build/Config_1/production/mcc_generated_files/boot/boot_process.o: Link Error: Could not allocate section .text.BOOT_ImageAddressGet, size = 20 PC units, attributes = code 
.ca/build/Config_1/production/mcc_gener[0m
[31mated_files/uart1.o: Link Error: Could not allocate section .text.UART1_IsTxDone, size = 20 PC units, attributes = code 
.ca/build/Config_1/production/mcc_generated_files/boot/com_adaptor_uart.o: Link Error: Could not allocate section .text.BOOT_COM_Peek, size = 18 PC units, attributes = code 
.ca/build/Config_1/production/mcc_generated_files/system.o: Link Error: Could not allocate section .text.SYSTEM_Initialize, size = 18 PC units, attributes = code 
.ca/build/Config_1/production/mcc_generated_files/uart1.o: Link Error: Could not allocate section .text.UART1_SetTxInterruptHandler, size = 14 PC units, attributes = code 
.ca/build/Config_1/production/mcc_generated_files/uart1.o: Link Error: Could not allocate section .text.UART1_SetRxInterruptHandler, size = 14 PC units, attributes = code 
.ca/build/Config_1/production/mcc_generated_files/uart1.o: Link Error: Could not allocate section .text.UART1_IsRxReady, size = 14 PC units, attributes = code 
.ca/build/Config_1/production/mcc_generated_files/system.o: Link Error: Could not allocate section .text.SYSTEM_CORCONModeOperatingSet, size = 12 PC units, attributes = code 
.ca/build/Config_1/production/mcc_generated_files/traps.o: Link Error: Could not allocate section .text.use_failsafe_stack, size = 10 PC units, attributes = code 
.ca/build/Config_1/production/mcc_generated_files/system.o: Link Error: Could not allocate section .text.INTERRUPT_GlobalEnable, size = 8 PC units, attributes = code 
.ca/build/Config_1/production/main.o: Link Error: Could not allocate section .text.main, size = 8 PC units, attributes = code 
.ca/build/Config_1/production/mcc_generated_files/boot/boot_process.o: Link Error: Could not allocate section .text.BOOT_StartApplication, size = 6 PC units, attributes = code 
.ca/build/Config_1/production/mcc_generated_files/boot/boot_process.o: Link Error: Could not allocate section .text.Reset, size = 4 PC units, attributes = code 
.ca/build/Config_1/production/mcc_generated_files/boot/boot_demo.o: Link Error: Could not allocate section .text.EnterBootloadMode, size = 4 PC units, attributes = code 
.ca/build/Config_1/production/mcc_generated_files/boot/hardware_interrupt_table.o: Link Error: Could not allocate section .text, size = 4 PC units, attributes = code 
.ca/build/Config_1/production/mcc_generated_files/traps.o: Link Error: Could not allocate section .text.TRAPS_halt_on_error, size = 4 PC units, attributes = code 
.ca/build/Config_1/production/mcc_generated_files/boot/boot_process.o: Link Error: Could not allocate section .text.BOOT_Initialize, size = 2 PC units, attributes = code 
.ca/build/Config_1/production/mcc_generated_files/boot/boot_demo.o: Link Error: Could not allocate section .text.BOOT_DEMO_Initialize, size = 2 PC units, attributes = code 
.ca/build/Config_1/production/mcc_generated_files/uart1.o: Link Error: Could not allocate section .text.UART1_Transmit_CallBack, size = 2 PC units, attributes = code 
.ca/build/Config_1/production/mcc_generated_files/uart1.o: Link Error: Could not allocate section .text.UART1_Receive_CallBack, size = 2 PC units, attributes = code 
.ca/build/Config_1/production/mcc_generated_files/boot/com_adaptor_uart.o: Link Error: Could not allocate section .text.BOOT_COM_GetBytesReady, size = 56 PC units, attributes = code 
.ca/build/Config_1/production/mcc_generated_files/boot/com_adaptor_uart.o: Link Error: Could not allocate section .text.BOOT_COM_Read, size = 50 PC units, attributes = code 
.ca/build/Config_1/production/mcc_generated_files/boot/boot_process.o: Link Error: Could not allocate section .text.ResetDevice, size = 44 PC units, attributes = code 
.ca/build/Config_1/production/mcc_generated_files/uart1.o: Link Error: Could not allocate section .text.UART1_Initialize, size = 44 PC units, attributes = code 
.ca/build/Config_1/production/mcc_generated_files/boot/boot_demo.o: Link Error: Could not allocate section .text.BOOT_DEMO_Tasks, size = 42 PC units, attributes = code 
.ca/build/Config_1/production/mcc_generated_files/boot/boot_verify_not_blank.o: Link Error: Could not allocate section .text.BOOT_ImageVerify, size = 38 PC units, attributes = code 
.ca/build/Config_1/production/mcc_generated_files/boot/boot_process.o: Link Error: Could not allocate section .text.CommandError, size = 36 PC units, attributes = code 
.ca/build/Config_1/production/mcc_generated_files/boot/boot_process.o: Link Error: Could not allocate section .text.ReadVersion, size = 34 PC units, attributes = code 
.ca/build/Config_1/production/mcc_generated_files/boot/com_adaptor_uart.o: Link Error: Could not allocate section .text.BOOT_COM_Write, size = 34 PC units, attributes = code 
.ca/build/Config_1/production/mcc_generated_files/uart1.o: Link Error: Could not allocate section .text.UART1_Write, size = 32 PC units, attributes = code 
.ca/build/Config_1/production/mcc_generated_files/boot/boot_process.o: Link Error: Could not allocate section .text.GetMemoryAddressRange, size = 28 PC units, attributes = code 
.ca/build/Config_1/production/mcc_generated_files/uart1.o: Link Error: Could not allocate section .text.UART1_IsTxReady, size = 28 PC units, attributes = code 
.ca/build/Config_1/production/mcc_generated_files/boot/boot_process.o: Link Error: Could not allocate section .text.IsLegalRange, size = 26 PC units, attributes = code 
.ca/build/Config_1/production/mcc_generated_files/interrupt_manager.o: Link Error: Could not allocate section .text.INTERRUPT_Initialize, size = 26 PC units, attributes = code 
.ca/build/Config_1/production/mcc_generated_files/uart1.o: Link Error: Could not allocate section .text.UART1_Read, size = 24 PC units, attributes = code 
.ca/build/Config_1/production/mcc_generated_files/boot/boot_process.o: Link Error: Could not allocate section .text.IsLegalAddress, size = 22 PC units, attributes = code 
.ca/build/Config_1/production/mcc_generated_files/boot/boot_process.o: Link Error: Could not allocate section .text.BOOT_ImageAddressGet, size = 20 PC units, attributes = code 
.ca/build/Config_1/production/mcc_generated_files/uart1.o: Link Error: Could not allocate section .text.UART1_IsTxDone, size = 20 PC units, attributes = code 
.ca/build/Config_1/production/mcc_generated_files/boot/com_adaptor_uart.o: Link Error: Could not allocate section .text.BOOT_COM_Peek, size = 18 PC units, attributes = code 
.ca/build/Config_1/production/mcc_generated_files/system.o: Link Error: Could not allocate section .text.SYSTEM_Initialize, size = 18 PC units, attributes = code 
.ca/build/Config_1/production/mcc_generated_files/uart1.o: Link Error: Could not allocate section .text.UART1_SetTxInterruptHandler, size = 14 PC units, attributes = code 
.ca/build/Config_1/production/mcc_generated_files/uart1.o: Link Error: Could not allocate section .text.UART1_SetRxInterruptHandler, size = 14 PC units, attributes = code 
.ca/build/Config_1/production/mcc_generated_files/uart1.o: Link Error: Could not allocate section .text.UART1_IsRxReady, size = 14 PC units, attributes = code 
.ca/build/Config_1/production/mcc_generated_files/system.o: Link Error: Could not allocate section .text.SYSTEM_CORCONModeOperatingSet, size = 12 PC units, attributes = code 
.ca/build/Config_1/production/mcc_generated_files/traps.o: Link Error: Could not allocate section .text.use_failsafe_stack, size = 10 PC units, attributes = code 
.ca/build/Config_1/production/mcc_generated_files/system.o: Link Error: Could not allocate section .text.INTERRUPT_GlobalEnable, size = 8 PC units, attributes = code 
.ca/build/Config_1/production/main.o: Link Error: Could not allocate section .text.main, size = 8 PC units, attributes = code 
.ca/build/Config_1/production/mcc_generated_files/boot/boot_process.o: Link Error: Could not allocate section .text.BOOT_StartApplication, size = 6 PC units, attributes = code 
.ca/build/Config_1/production/mcc_generated_files/boot/boot_process.o: Link Error: Could not allocate section .text.Reset, size = 4 PC units, attributes = code 
.ca/build/Config_1/production/mcc_generated_files/boot/boot_demo.o: Link Error: Could not allocate section .text.EnterBootloadMode, size = 4 PC units, attributes = code 
.ca/build/Config_1/production/mcc_generated_files/bo[0m
[31mot/hardware_interrupt_table.o: Link Error: Could not allocate section .text, size = 4 PC units, attributes = code 
.ca/build/Config_1/production/mcc_generated_files/traps.o: Link Error: Could not allocate section .text.TRAPS_halt_on_error, size = 4 PC units, attributes = code 
.ca/build/Config_1/production/mcc_generated_files/boot/boot_process.o: Link Error: Could not allocate section .text.BOOT_Initialize, size = 2 PC units, attributes = code 
.ca/build/Config_1/production/mcc_generated_files/boot/boot_demo.o: Link Error: Could not allocate section .text.BOOT_DEMO_Initialize, size = 2 PC units, attributes = code 
.ca/build/Config_1/production/mcc_generated_files/uart1.o: Link Error: Could not allocate section .text.UART1_Transmit_CallBack, size = 2 PC units, attributes = code 
.ca/build/Config_1/production/mcc_generated_files/uart1.o: Link Error: Could not allocate section .text.UART1_Receive_CallBack, size = 2 PC units, attributes = code 
.ca/build/Config_1/production/mcc_generated_files/boot/com_adaptor_uart.o: Link Error: Could not allocate section .text.BOOT_COM_Read, size = 50 PC units, attributes = code 
.ca/build/Config_1/production/mcc_generated_files/boot/boot_process.o: Link Error: Could not allocate section .text.ResetDevice, size = 44 PC units, attributes = code 
.ca/build/Config_1/production/mcc_generated_files/uart1.o: Link Error: Could not allocate section .text.UART1_Initialize, size = 44 PC units, attributes = code 
.ca/build/Config_1/production/mcc_generated_files/boot/boot_demo.o: Link Error: Could not allocate section .text.BOOT_DEMO_Tasks, size = 42 PC units, attributes = code 
.ca/build/Config_1/production/mcc_generated_files/boot/boot_verify_not_blank.o: Link Error: Could not allocate section .text.BOOT_ImageVerify, size = 38 PC units, attributes = code 
.ca/build/Config_1/production/mcc_generated_files/boot/boot_process.o: Link Error: Could not allocate section .text.CommandError, size = 36 PC units, attributes = code 
.ca/build/Config_1/production/mcc_generated_files/boot/boot_process.o: Link Error: Could not allocate section .text.ReadVersion, size = 34 PC units, attributes = code 
.ca/build/Config_1/production/mcc_generated_files/boot/com_adaptor_uart.o: Link Error: Could not allocate section .text.BOOT_COM_Write, size = 34 PC units, attributes = code 
.ca/build/Config_1/production/mcc_generated_files/uart1.o: Link Error: Could not allocate section .text.UART1_Write, size = 32 PC units, attributes = code 
.ca/build/Config_1/production/mcc_generated_files/boot/boot_process.o: Link Error: Could not allocate section .text.GetMemoryAddressRange, size = 28 PC units, attributes = code 
.ca/build/Config_1/production/mcc_generated_files/uart1.o: Link Error: Could not allocate section .text.UART1_IsTxReady, size = 28 PC units, attributes = code 
.ca/build/Config_1/production/mcc_generated_files/boot/boot_process.o: Link Error: Could not allocate section .text.IsLegalRange, size = 26 PC units, attributes = code 
.ca/build/Config_1/production/mcc_generated_files/interrupt_manager.o: Link Error: Could not allocate section .text.INTERRUPT_Initialize, size = 26 PC units, attributes = code 
.ca/build/Config_1/production/mcc_generated_files/uart1.o: Link Error: Could not allocate section .text.UART1_Read, size = 24 PC units, attributes = code 
.ca/build/Config_1/production/mcc_generated_files/boot/boot_process.o: Link Error: Could not allocate section .text.IsLegalAddress, size = 22 PC units, attributes = code 
.ca/build/Config_1/production/mcc_generated_files/boot/boot_process.o: Link Error: Could not allocate section .text.BOOT_ImageAddressGet, size = 20 PC units, attributes = code 
.ca/build/Config_1/production/mcc_generated_files/uart1.o: Link Error: Could not allocate section .text.UART1_IsTxDone, size = 20 PC units, attributes = code 
.ca/build/Config_1/production/mcc_generated_files/boot/com_adaptor_uart.o: Link Error: Could not allocate section .text.BOOT_COM_Peek, size = 18 PC units, attributes = code 
.ca/build/Config_1/production/mcc_generated_files/system.o: Link Error: Could not allocate section .text.SYSTEM_Initialize, size = 18 PC units, attributes = code 
.ca/build/Config_1/production/mcc_generated_files/uart1.o: Link Error: Could not allocate section .text.UART1_SetTxInterruptHandler, size = 14 PC units, attributes = code 
.ca/build/Config_1/production/mcc_generated_files/uart1.o: Link Error: Could not allocate section .text.UART1_SetRxInterruptHandler, size = 14 PC units, attributes = code 
.ca/build/Config_1/production/mcc_generated_files/uart1.o: Link Error: Could not allocate section .text.UART1_IsRxReady, size = 14 PC units, attributes = code 
.ca/build/Config_1/production/mcc_generated_files/system.o: Link Error: Could not allocate section .text.SYSTEM_CORCONModeOperatingSet, size = 12 PC units, attributes = code 
.ca/build/Config_1/production/mcc_generated_files/traps.o: Link Error: Could not allocate section .text.use_failsafe_stack, size = 10 PC units, attributes = code 
.ca/build/Config_1/production/mcc_generated_files/system.o: Link Error: Could not allocate section .text.INTERRUPT_GlobalEnable, size = 8 PC units, attributes = code 
.ca/build/Config_1/production/main.o: Link Error: Could not allocate section .text.main, size = 8 PC units, attributes = code 
.ca/build/Config_1/production/mcc_generated_files/boot/boot_process.o: Link Error: Could not allocate section .text.BOOT_StartApplication, size = 6 PC units, attributes = code 
.ca/build/Config_1/production/mcc_generated_files/boot/boot_process.o: Link Error: Could not allocate section .text.Reset, size = 4 PC units, attributes = code 
.ca/build/Config_1/production/mcc_generated_files/boot/boot_demo.o: Link Error: Could not allocate section .text.EnterBootloadMode, size = 4 PC units, attributes = code 
.ca/build/Config_1/production/mcc_generated_files/boot/hardware_interrupt_table.o: Link Error: Could not allocate section .text, size = 4 PC units, attributes = code 
.ca/build/Config_1/production/mcc_generated_files/traps.o: Link Error: Could not allocate section .text.TRAPS_halt_on_error, size = 4 PC units, attributes = code 
.ca/build/Config_1/production/mcc_generated_files/boot/boot_process.o: Link Error: Could not allocate section .text.BOOT_Initialize, size = 2 PC units, attributes = code 
.ca/build/Config_1/production/mcc_generated_files/boot/boot_demo.o: Link Error: Could not allocate section .text.BOOT_DEMO_Initialize, size = 2 PC units, attributes = code 
.ca/build/Config_1/production/mcc_generated_files/uart1.o: Link Error: Could not allocate section .text.UART1_Transmit_CallBack, size = 2 PC units, attributes = code 
.ca/build/Config_1/production/mcc_generated_files/uart1.o: Link Error: Could not allocate section .text.UART1_Receive_CallBack, size = 2 PC units, attributes = code 
.ca/build/Config_1/production/mcc_generated_files/boot/boot_process.o: Link Error: Could not allocate section .text.ResetDevice, size = 44 PC units, attributes = code 
.ca/build/Config_1/production/mcc_generated_files/uart1.o: Link Error: Could not allocate section .text.UART1_Initialize, size = 44 PC units, attributes = code 
.ca/build/Config_1/production/mcc_generated_files/boot/boot_demo.o: Link Error: Could not allocate section .text.BOOT_DEMO_Tasks, size = 42 PC units, attributes = code 
.ca/build/Config_1/production/mcc_generated_files/boot/boot_verify_not_blank.o: Link Error: Could not allocate section .text.BOOT_ImageVerify, size = 38 PC units, attributes = code 
.ca/build/Config_1/production/mcc_generated_files/boot/boot_process.o: Link Error: Could not allocate section .text.CommandError, size = 36 PC units, attributes = code 
.ca/build/Config_1/production/mcc_generated_files/boot/boot_process.o: Link Error: Could not allocate section .text.ReadVersion, size = 34 PC units, attributes = code 
.ca/build/Config_1/production/mcc_generated_files/boot/com_adaptor_uart.o: Link Error: Could not allocate section .text.BOOT_COM_Write, size = 34 PC units, attributes = code 
.ca/build/Config_1/production/mcc_generated_files/uart1.o: Link Error: Could not allocate section .text.UART1_Write, size = 32 PC units, attributes = code 
.ca/build/Config_1/production/mcc[0m
[31m_generated_files/boot/boot_process.o: Link Error: Could not allocate section .text.GetMemoryAddressRange, size = 28 PC units, attributes = code 
.ca/build/Config_1/production/mcc_generated_files/uart1.o: Link Error: Could not allocate section .text.UART1_IsTxReady, size = 28 PC units, attributes = code 
.ca/build/Config_1/production/mcc_generated_files/boot/boot_process.o: Link Error: Could not allocate section .text.IsLegalRange, size = 26 PC units, attributes = code 
.ca/build/Config_1/production/mcc_generated_files/interrupt_manager.o: Link Error: Could not allocate section .text.INTERRUPT_Initialize, size = 26 PC units, attributes = code 
.ca/build/Config_1/production/mcc_generated_files/uart1.o: Link Error: Could not allocate section .text.UART1_Read, size = 24 PC units, attributes = code 
.ca/build/Config_1/production/mcc_generated_files/boot/boot_process.o: Link Error: Could not allocate section .text.IsLegalAddress, size = 22 PC units, attributes = code 
.ca/build/Config_1/production/mcc_generated_files/boot/boot_process.o: Link Error: Could not allocate section .text.BOOT_ImageAddressGet, size = 20 PC units, attributes = code 
.ca/build/Config_1/production/mcc_generated_files/uart1.o: Link Error: Could not allocate section .text.UART1_IsTxDone, size = 20 PC units, attributes = code 
.ca/build/Config_1/production/mcc_generated_files/boot/com_adaptor_uart.o: Link Error: Could not allocate section .text.BOOT_COM_Peek, size = 18 PC units, attributes = code 
.ca/build/Config_1/production/mcc_generated_files/system.o: Link Error: Could not allocate section .text.SYSTEM_Initialize, size = 18 PC units, attributes = code 
.ca/build/Config_1/production/mcc_generated_files/uart1.o: Link Error: Could not allocate section .text.UART1_SetTxInterruptHandler, size = 14 PC units, attributes = code 
.ca/build/Config_1/production/mcc_generated_files/uart1.o: Link Error: Could not allocate section .text.UART1_SetRxInterruptHandler, size = 14 PC units, attributes = code 
.ca/build/Config_1/production/mcc_generated_files/uart1.o: Link Error: Could not allocate section .text.UART1_IsRxReady, size = 14 PC units, attributes = code 
.ca/build/Config_1/production/mcc_generated_files/system.o: Link Error: Could not allocate section .text.SYSTEM_CORCONModeOperatingSet, size = 12 PC units, attributes = code 
.ca/build/Config_1/production/mcc_generated_files/traps.o: Link Error: Could not allocate section .text.use_failsafe_stack, size = 10 PC units, attributes = code 
.ca/build/Config_1/production/mcc_generated_files/system.o: Link Error: Could not allocate section .text.INTERRUPT_GlobalEnable, size = 8 PC units, attributes = code 
.ca/build/Config_1/production/main.o: Link Error: Could not allocate section .text.main, size = 8 PC units, attributes = code 
.ca/build/Config_1/production/mcc_generated_files/boot/boot_process.o: Link Error: Could not allocate section .text.BOOT_StartApplication, size = 6 PC units, attributes = code 
.ca/build/Config_1/production/mcc_generated_files/boot/boot_process.o: Link Error: Could not allocate section .text.Reset, size = 4 PC units, attributes = code 
.ca/build/Config_1/production/mcc_generated_files/boot/boot_demo.o: Link Error: Could not allocate section .text.EnterBootloadMode, size = 4 PC units, attributes = code 
.ca/build/Config_1/production/mcc_generated_files/boot/hardware_interrupt_table.o: Link Error: Could not allocate section .text, size = 4 PC units, attributes = code 
.ca/build/Config_1/production/mcc_generated_files/traps.o: Link Error: Could not allocate section .text.TRAPS_halt_on_error, size = 4 PC units, attributes = code 
.ca/build/Config_1/production/mcc_generated_files/boot/boot_process.o: Link Error: Could not allocate section .text.BOOT_Initialize, size = 2 PC units, attributes = code 
.ca/build/Config_1/production/mcc_generated_files/boot/boot_demo.o: Link Error: Could not allocate section .text.BOOT_DEMO_Initialize, size = 2 PC units, attributes = code 
.ca/build/Config_1/production/mcc_generated_files/uart1.o: Link Error: Could not allocate section .text.UART1_Transmit_CallBack, size = 2 PC units, attributes = code 
.ca/build/Config_1/production/mcc_generated_files/uart1.o: Link Error: Could not allocate section .text.UART1_Receive_CallBack, size = 2 PC units, attributes = code 
.ca/build/Config_1/production/mcc_generated_files/uart1.o: Link Error: Could not allocate section .text.UART1_Initialize, size = 44 PC units, attributes = code 
.ca/build/Config_1/production/mcc_generated_files/boot/boot_demo.o: Link Error: Could not allocate section .text.BOOT_DEMO_Tasks, size = 42 PC units, attributes = code 
.ca/build/Config_1/production/mcc_generated_files/boot/boot_verify_not_blank.o: Link Error: Could not allocate section .text.BOOT_ImageVerify, size = 38 PC units, attributes = code 
.ca/build/Config_1/production/mcc_generated_files/boot/boot_process.o: Link Error: Could not allocate section .text.CommandError, size = 36 PC units, attributes = code 
.ca/build/Config_1/production/mcc_generated_files/boot/boot_process.o: Link Error: Could not allocate section .text.ReadVersion, size = 34 PC units, attributes = code 
.ca/build/Config_1/production/mcc_generated_files/boot/com_adaptor_uart.o: Link Error: Could not allocate section .text.BOOT_COM_Write, size = 34 PC units, attributes = code 
.ca/build/Config_1/production/mcc_generated_files/uart1.o: Link Error: Could not allocate section .text.UART1_Write, size = 32 PC units, attributes = code 
.ca/build/Config_1/production/mcc_generated_files/boot/boot_process.o: Link Error: Could not allocate section .text.GetMemoryAddressRange, size = 28 PC units, attributes = code 
.ca/build/Config_1/production/mcc_generated_files/uart1.o: Link Error: Could not allocate section .text.UART1_IsTxReady, size = 28 PC units, attributes = code 
.ca/build/Config_1/production/mcc_generated_files/boot/boot_process.o: Link Error: Could not allocate section .text.IsLegalRange, size = 26 PC units, attributes = code 
.ca/build/Config_1/production/mcc_generated_files/interrupt_manager.o: Link Error: Could not allocate section .text.INTERRUPT_Initialize, size = 26 PC units, attributes = code 
.ca/build/Config_1/production/mcc_generated_files/uart1.o: Link Error: Could not allocate section .text.UART1_Read, size = 24 PC units, attributes = code 
.ca/build/Config_1/production/mcc_generated_files/boot/boot_process.o: Link Error: Could not allocate section .text.IsLegalAddress, size = 22 PC units, attributes = code 
.ca/build/Config_1/production/mcc_generated_files/boot/boot_process.o: Link Error: Could not allocate section .text.BOOT_ImageAddressGet, size = 20 PC units, attributes = code 
.ca/build/Config_1/production/mcc_generated_files/uart1.o: Link Error: Could not allocate section .text.UART1_IsTxDone, size = 20 PC units, attributes = code 
.ca/build/Config_1/production/mcc_generated_files/boot/com_adaptor_uart.o: Link Error: Could not allocate section .text.BOOT_COM_Peek, size = 18 PC units, attributes = code 
.ca/build/Config_1/production/mcc_generated_files/system.o: Link Error: Could not allocate section .text.SYSTEM_Initialize, size = 18 PC units, attributes = code 
.ca/build/Config_1/production/mcc_generated_files/uart1.o: Link Error: Could not allocate section .text.UART1_SetTxInterruptHandler, size = 14 PC units, attributes = code 
.ca/build/Config_1/production/mcc_generated_files/uart1.o: Link Error: Could not allocate section .text.UART1_SetRxInterruptHandler, size = 14 PC units, attributes = code 
.ca/build/Config_1/production/mcc_generated_files/uart1.o: Link Error: Could not allocate section .text.UART1_IsRxReady, size = 14 PC units, attributes = code 
.ca/build/Config_1/production/mcc_generated_files/system.o: Link Error: Could not allocate section .text.SYSTEM_CORCONModeOperatingSet, size = 12 PC units, attributes = code 
.ca/build/Config_1/production/mcc_generated_files/traps.o: Link Error: Could not allocate section .text.use_failsafe_stack, size = 10 PC units, attributes = code 
.ca/build/Config_1/production/mcc_generated_files/system.o: Link Error: Could not allocate section .text.INTERRUPT_GlobalEnable, size = 8 PC units, attributes = code 
.ca/build/Config_1/[0m
[31mproduction/main.o: Link Error: Could not allocate section .text.main, size = 8 PC units, attributes = code 
.ca/build/Config_1/production/mcc_generated_files/boot/boot_process.o: Link Error: Could not allocate section .text.BOOT_StartApplication, size = 6 PC units, attributes = code 
.ca/build/Config_1/production/mcc_generated_files/boot/boot_process.o: Link Error: Could not allocate section .text.Reset, size = 4 PC units, attributes = code 
.ca/build/Config_1/production/mcc_generated_files/boot/boot_demo.o: Link Error: Could not allocate section .text.EnterBootloadMode, size = 4 PC units, attributes = code 
.ca/build/Config_1/production/mcc_generated_files/boot/hardware_interrupt_table.o: Link Error: Could not allocate section .text, size = 4 PC units, attributes = code 
.ca/build/Config_1/production/mcc_generated_files/traps.o: Link Error: Could not allocate section .text.TRAPS_halt_on_error, size = 4 PC units, attributes = code 
.ca/build/Config_1/production/mcc_generated_files/boot/boot_process.o: Link Error: Could not allocate section .text.BOOT_Initialize, size = 2 PC units, attributes = code 
.ca/build/Config_1/production/mcc_generated_files/boot/boot_demo.o: Link Error: Could not allocate section .text.BOOT_DEMO_Initialize, size = 2 PC units, attributes = code 
.ca/build/Config_1/production/mcc_generated_files/uart1.o: Link Error: Could not allocate section .text.UART1_Transmit_CallBack, size = 2 PC units, attributes = code 
.ca/build/Config_1/production/mcc_generated_files/uart1.o: Link Error: Could not allocate section .text.UART1_Receive_CallBack, size = 2 PC units, attributes = code 
.ca/build/Config_1/production/mcc_generated_files/boot/boot_demo.o: Link Error: Could not allocate section .text.BOOT_DEMO_Tasks, size = 42 PC units, attributes = code 
.ca/build/Config_1/production/mcc_generated_files/boot/boot_verify_not_blank.o: Link Error: Could not allocate section .text.BOOT_ImageVerify, size = 38 PC units, attributes = code 
.ca/build/Config_1/production/mcc_generated_files/boot/boot_process.o: Link Error: Could not allocate section .text.CommandError, size = 36 PC units, attributes = code 
.ca/build/Config_1/production/mcc_generated_files/boot/boot_process.o: Link Error: Could not allocate section .text.ReadVersion, size = 34 PC units, attributes = code 
.ca/build/Config_1/production/mcc_generated_files/boot/com_adaptor_uart.o: Link Error: Could not allocate section .text.BOOT_COM_Write, size = 34 PC units, attributes = code 
.ca/build/Config_1/production/mcc_generated_files/uart1.o: Link Error: Could not allocate section .text.UART1_Write, size = 32 PC units, attributes = code 
.ca/build/Config_1/production/mcc_generated_files/boot/boot_process.o: Link Error: Could not allocate section .text.GetMemoryAddressRange, size = 28 PC units, attributes = code 
.ca/build/Config_1/production/mcc_generated_files/uart1.o: Link Error: Could not allocate section .text.UART1_IsTxReady, size = 28 PC units, attributes = code 
.ca/build/Config_1/production/mcc_generated_files/boot/boot_process.o: Link Error: Could not allocate section .text.IsLegalRange, size = 26 PC units, attributes = code 
.ca/build/Config_1/production/mcc_generated_files/interrupt_manager.o: Link Error: Could not allocate section .text.INTERRUPT_Initialize, size = 26 PC units, attributes = code 
.ca/build/Config_1/production/mcc_generated_files/uart1.o: Link Error: Could not allocate section .text.UART1_Read, size = 24 PC units, attributes = code 
.ca/build/Config_1/production/mcc_generated_files/boot/boot_process.o: Link Error: Could not allocate section .text.IsLegalAddress, size = 22 PC units, attributes = code 
.ca/build/Config_1/production/mcc_generated_files/boot/boot_process.o: Link Error: Could not allocate section .text.BOOT_ImageAddressGet, size = 20 PC units, attributes = code 
.ca/build/Config_1/production/mcc_generated_files/uart1.o: Link Error: Could not allocate section .text.UART1_IsTxDone, size = 20 PC units, attributes = code 
.ca/build/Config_1/production/mcc_generated_files/boot/com_adaptor_uart.o: Link Error: Could not allocate section .text.BOOT_COM_Peek, size = 18 PC units, attributes = code 
.ca/build/Config_1/production/mcc_generated_files/system.o: Link Error: Could not allocate section .text.SYSTEM_Initialize, size = 18 PC units, attributes = code 
.ca/build/Config_1/production/mcc_generated_files/uart1.o: Link Error: Could not allocate section .text.UART1_SetTxInterruptHandler, size = 14 PC units, attributes = code 
.ca/build/Config_1/production/mcc_generated_files/uart1.o: Link Error: Could not allocate section .text.UART1_SetRxInterruptHandler, size = 14 PC units, attributes = code 
.ca/build/Config_1/production/mcc_generated_files/uart1.o: Link Error: Could not allocate section .text.UART1_IsRxReady, size = 14 PC units, attributes = code 
.ca/build/Config_1/production/mcc_generated_files/system.o: Link Error: Could not allocate section .text.SYSTEM_CORCONModeOperatingSet, size = 12 PC units, attributes = code 
.ca/build/Config_1/production/mcc_generated_files/traps.o: Link Error: Could not allocate section .text.use_failsafe_stack, size = 10 PC units, attributes = code 
.ca/build/Config_1/production/mcc_generated_files/system.o: Link Error: Could not allocate section .text.INTERRUPT_GlobalEnable, size = 8 PC units, attributes = code 
.ca/build/Config_1/production/main.o: Link Error: Could not allocate section .text.main, size = 8 PC units, attributes = code 
.ca/build/Config_1/production/mcc_generated_files/boot/boot_process.o: Link Error: Could not allocate section .text.BOOT_StartApplication, size = 6 PC units, attributes = code 
.ca/build/Config_1/production/mcc_generated_files/boot/boot_process.o: Link Error: Could not allocate section .text.Reset, size = 4 PC units, attributes = code 
.ca/build/Config_1/production/mcc_generated_files/boot/boot_demo.o: Link Error: Could not allocate section .text.EnterBootloadMode, size = 4 PC units, attributes = code 
.ca/build/Config_1/production/mcc_generated_files/boot/hardware_interrupt_table.o: Link Error: Could not allocate section .text, size = 4 PC units, attributes = code 
.ca/build/Config_1/production/mcc_generated_files/traps.o: Link Error: Could not allocate section .text.TRAPS_halt_on_error, size = 4 PC units, attributes = code 
.ca/build/Config_1/production/mcc_generated_files/boot/boot_process.o: Link Error: Could not allocate section .text.BOOT_Initialize, size = 2 PC units, attributes = code 
.ca/build/Config_1/production/mcc_generated_files/boot/boot_demo.o: Link Error: Could not allocate section .text.BOOT_DEMO_Initialize, size = 2 PC units, attributes = code 
.ca/build/Config_1/production/mcc_generated_files/uart1.o: Link Error: Could not allocate section .text.UART1_Transmit_CallBack, size = 2 PC units, attributes = code 
.ca/build/Config_1/production/mcc_generated_files/uart1.o: Link Error: Could not allocate section .text.UART1_Receive_CallBack, size = 2 PC units, attributes = code 
.ca/build/Config_1/production/mcc_generated_files/boot/boot_verify_not_blank.o: Link Error: Could not allocate section .text.BOOT_ImageVerify, size = 38 PC units, attributes = code 
.ca/build/Config_1/production/mcc_generated_files/boot/boot_process.o: Link Error: Could not allocate section .text.CommandError, size = 36 PC units, attributes = code 
.ca/build/Config_1/production/mcc_generated_files/boot/boot_process.o: Link Error: Could not allocate section .text.ReadVersion, size = 34 PC units, attributes = code 
.ca/build/Config_1/production/mcc_generated_files/boot/com_adaptor_uart.o: Link Error: Could not allocate section .text.BOOT_COM_Write, size = 34 PC units, attributes = code 
.ca/build/Config_1/production/mcc_generated_files/uart1.o: Link Error: Could not allocate section .text.UART1_Write, size = 32 PC units, attributes = code 
.ca/build/Config_1/production/mcc_generated_files/boot/boot_process.o: Link Error: Could not allocate section .text.GetMemoryAddressRange, size = 28 PC units, attributes = code 
.ca/build/Config_1/production/mcc_generated_files/uart1.o: Link Error: Could not allocate section .text.UART1_IsTxReady, size = 28 PC units, attributes = code 
.ca/build/Config_1/productio[0m
[31mn/mcc_generated_files/boot/boot_process.o: Link Error: Could not allocate section .text.IsLegalRange, size = 26 PC units, attributes = code 
.ca/build/Config_1/production/mcc_generated_files/interrupt_manager.o: Link Error: Could not allocate section .text.INTERRUPT_Initialize, size = 26 PC units, attributes = code 
.ca/build/Config_1/production/mcc_generated_files/uart1.o: Link Error: Could not allocate section .text.UART1_Read, size = 24 PC units, attributes = code 
.ca/build/Config_1/production/mcc_generated_files/boot/boot_process.o: Link Error: Could not allocate section .text.IsLegalAddress, size = 22 PC units, attributes = code 
.ca/build/Config_1/production/mcc_generated_files/boot/boot_process.o: Link Error: Could not allocate section .text.BOOT_ImageAddressGet, size = 20 PC units, attributes = code 
.ca/build/Config_1/production/mcc_generated_files/uart1.o: Link Error: Could not allocate section .text.UART1_IsTxDone, size = 20 PC units, attributes = code 
.ca/build/Config_1/production/mcc_generated_files/boot/com_adaptor_uart.o: Link Error: Could not allocate section .text.BOOT_COM_Peek, size = 18 PC units, attributes = code 
.ca/build/Config_1/production/mcc_generated_files/system.o: Link Error: Could not allocate section .text.SYSTEM_Initialize, size = 18 PC units, attributes = code 
.ca/build/Config_1/production/mcc_generated_files/uart1.o: Link Error: Could not allocate section .text.UART1_SetTxInterruptHandler, size = 14 PC units, attributes = code 
.ca/build/Config_1/production/mcc_generated_files/uart1.o: Link Error: Could not allocate section .text.UART1_SetRxInterruptHandler, size = 14 PC units, attributes = code 
.ca/build/Config_1/production/mcc_generated_files/uart1.o: Link Error: Could not allocate section .text.UART1_IsRxReady, size = 14 PC units, attributes = code 
.ca/build/Config_1/production/mcc_generated_files/system.o: Link Error: Could not allocate section .text.SYSTEM_CORCONModeOperatingSet, size = 12 PC units, attributes = code 
.ca/build/Config_1/production/mcc_generated_files/traps.o: Link Error: Could not allocate section .text.use_failsafe_stack, size = 10 PC units, attributes = code 
.ca/build/Config_1/production/mcc_generated_files/system.o: Link Error: Could not allocate section .text.INTERRUPT_GlobalEnable, size = 8 PC units, attributes = code 
.ca/build/Config_1/production/main.o: Link Error: Could not allocate section .text.main, size = 8 PC units, attributes = code 
.ca/build/Config_1/production/mcc_generated_files/boot/boot_process.o: Link Error: Could not allocate section .text.BOOT_StartApplication, size = 6 PC units, attributes = code 
.ca/build/Config_1/production/mcc_generated_files/boot/boot_process.o: Link Error: Could not allocate section .text.Reset, size = 4 PC units, attributes = code 
.ca/build/Config_1/production/mcc_generated_files/boot/boot_demo.o: Link Error: Could not allocate section .text.EnterBootloadMode, size = 4 PC units, attributes = code 
.ca/build/Config_1/production/mcc_generated_files/boot/hardware_interrupt_table.o: Link Error: Could not allocate section .text, size = 4 PC units, attributes = code 
.ca/build/Config_1/production/mcc_generated_files/traps.o: Link Error: Could not allocate section .text.TRAPS_halt_on_error, size = 4 PC units, attributes = code 
.ca/build/Config_1/production/mcc_generated_files/boot/boot_process.o: Link Error: Could not allocate section .text.BOOT_Initialize, size = 2 PC units, attributes = code 
.ca/build/Config_1/production/mcc_generated_files/boot/boot_demo.o: Link Error: Could not allocate section .text.BOOT_DEMO_Initialize, size = 2 PC units, attributes = code 
.ca/build/Config_1/production/mcc_generated_files/uart1.o: Link Error: Could not allocate section .text.UART1_Transmit_CallBack, size = 2 PC units, attributes = code 
.ca/build/Config_1/production/mcc_generated_files/uart1.o: Link Error: Could not allocate section .text.UART1_Receive_CallBack, size = 2 PC units, attributes = code 
.ca/build/Config_1/production/mcc_generated_files/boot/boot_process.o: Link Error: Could not allocate section .text.CommandError, size = 36 PC units, attributes = code 
.ca/build/Config_1/production/mcc_generated_files/boot/boot_process.o: Link Error: Could not allocate section .text.ReadVersion, size = 34 PC units, attributes = code 
.ca/build/Config_1/production/mcc_generated_files/boot/com_adaptor_uart.o: Link Error: Could not allocate section .text.BOOT_COM_Write, size = 34 PC units, attributes = code 
.ca/build/Config_1/production/mcc_generated_files/uart1.o: Link Error: Could not allocate section .text.UART1_Write, size = 32 PC units, attributes = code 
.ca/build/Config_1/production/mcc_generated_files/boot/boot_process.o: Link Error: Could not allocate section .text.GetMemoryAddressRange, size = 28 PC units, attributes = code 
.ca/build/Config_1/production/mcc_generated_files/uart1.o: Link Error: Could not allocate section .text.UART1_IsTxReady, size = 28 PC units, attributes = code 
.ca/build/Config_1/production/mcc_generated_files/boot/boot_process.o: Link Error: Could not allocate section .text.IsLegalRange, size = 26 PC units, attributes = code 
.ca/build/Config_1/production/mcc_generated_files/interrupt_manager.o: Link Error: Could not allocate section .text.INTERRUPT_Initialize, size = 26 PC units, attributes = code 
.ca/build/Config_1/production/mcc_generated_files/uart1.o: Link Error: Could not allocate section .text.UART1_Read, size = 24 PC units, attributes = code 
.ca/build/Config_1/production/mcc_generated_files/boot/boot_process.o: Link Error: Could not allocate section .text.IsLegalAddress, size = 22 PC units, attributes = code 
.ca/build/Config_1/production/mcc_generated_files/boot/boot_process.o: Link Error: Could not allocate section .text.BOOT_ImageAddressGet, size = 20 PC units, attributes = code 
.ca/build/Config_1/production/mcc_generated_files/uart1.o: Link Error: Could not allocate section .text.UART1_IsTxDone, size = 20 PC units, attributes = code 
.ca/build/Config_1/production/mcc_generated_files/boot/com_adaptor_uart.o: Link Error: Could not allocate section .text.BOOT_COM_Peek, size = 18 PC units, attributes = code 
.ca/build/Config_1/production/mcc_generated_files/system.o: Link Error: Could not allocate section .text.SYSTEM_Initialize, size = 18 PC units, attributes = code 
.ca/build/Config_1/production/mcc_generated_files/uart1.o: Link Error: Could not allocate section .text.UART1_SetTxInterruptHandler, size = 14 PC units, attributes = code 
.ca/build/Config_1/production/mcc_generated_files/uart1.o: Link Error: Could not allocate section .text.UART1_SetRxInterruptHandler, size = 14 PC units, attributes = code 
.ca/build/Config_1/production/mcc_generated_files/uart1.o: Link Error: Could not allocate section .text.UART1_IsRxReady, size = 14 PC units, attributes = code 
.ca/build/Config_1/production/mcc_generated_files/system.o: Link Error: Could not allocate section .text.SYSTEM_CORCONModeOperatingSet, size = 12 PC units, attributes = code 
.ca/build/Config_1/production/mcc_generated_files/traps.o: Link Error: Could not allocate section .text.use_failsafe_stack, size = 10 PC units, attributes = code 
.ca/build/Config_1/production/mcc_generated_files/system.o: Link Error: Could not allocate section .text.INTERRUPT_GlobalEnable, size = 8 PC units, attributes = code 
.ca/build/Config_1/production/main.o: Link Error: Could not allocate section .text.main, size = 8 PC units, attributes = code 
.ca/build/Config_1/production/mcc_generated_files/boot/boot_process.o: Link Error: Could not allocate section .text.BOOT_StartApplication, size = 6 PC units, attributes = code 
.ca/build/Config_1/production/mcc_generated_files/boot/boot_process.o: Link Error: Could not allocate section .text.Reset, size = 4 PC units, attributes = code 
.ca/build/Config_1/production/mcc_generated_files/boot/boot_demo.o: Link Error: Could not allocate section .text.EnterBootloadMode, size = 4 PC units, attributes = code 
.ca/build/Config_1/production/mcc_generated_files/boot/hardware_interrupt_table.o: Link Error: Could not allocate section .text, size = 4 PC units, attributes = code 
.ca/build/Config_1/production/mcc_generated_files/traps.o: Lin[0m
[31mk Error: Could not allocate section .text.TRAPS_halt_on_error, size = 4 PC units, attributes = code 
.ca/build/Config_1/production/mcc_generated_files/boot/boot_process.o: Link Error: Could not allocate section .text.BOOT_Initialize, size = 2 PC units, attributes = code 
.ca/build/Config_1/production/mcc_generated_files/boot/boot_demo.o: Link Error: Could not allocate section .text.BOOT_DEMO_Initialize, size = 2 PC units, attributes = code 
.ca/build/Config_1/production/mcc_generated_files/uart1.o: Link Error: Could not allocate section .text.UART1_Transmit_CallBack, size = 2 PC units, attributes = code 
.ca/build/Config_1/production/mcc_generated_files/uart1.o: Link Error: Could not allocate section .text.UART1_Receive_CallBack, size = 2 PC units, attributes = code 
.ca/build/Config_1/production/mcc_generated_files/boot/boot_process.o: Link Error: Could not allocate section .text.ReadVersion, size = 34 PC units, attributes = code 
.ca/build/Config_1/production/mcc_generated_files/boot/com_adaptor_uart.o: Link Error: Could not allocate section .text.BOOT_COM_Write, size = 34 PC units, attributes = code 
.ca/build/Config_1/production/mcc_generated_files/uart1.o: Link Error: Could not allocate section .text.UART1_Write, size = 32 PC units, attributes = code 
.ca/build/Config_1/production/mcc_generated_files/boot/boot_process.o: Link Error: Could not allocate section .text.GetMemoryAddressRange, size = 28 PC units, attributes = code 
.ca/build/Config_1/production/mcc_generated_files/uart1.o: Link Error: Could not allocate section .text.UART1_IsTxReady, size = 28 PC units, attributes = code 
.ca/build/Config_1/production/mcc_generated_files/boot/boot_process.o: Link Error: Could not allocate section .text.IsLegalRange, size = 26 PC units, attributes = code 
.ca/build/Config_1/production/mcc_generated_files/interrupt_manager.o: Link Error: Could not allocate section .text.INTERRUPT_Initialize, size = 26 PC units, attributes = code 
.ca/build/Config_1/production/mcc_generated_files/uart1.o: Link Error: Could not allocate section .text.UART1_Read, size = 24 PC units, attributes = code 
.ca/build/Config_1/production/mcc_generated_files/boot/boot_process.o: Link Error: Could not allocate section .text.IsLegalAddress, size = 22 PC units, attributes = code 
.ca/build/Config_1/production/mcc_generated_files/boot/boot_process.o: Link Error: Could not allocate section .text.BOOT_ImageAddressGet, size = 20 PC units, attributes = code 
.ca/build/Config_1/production/mcc_generated_files/uart1.o: Link Error: Could not allocate section .text.UART1_IsTxDone, size = 20 PC units, attributes = code 
.ca/build/Config_1/production/mcc_generated_files/boot/com_adaptor_uart.o: Link Error: Could not allocate section .text.BOOT_COM_Peek, size = 18 PC units, attributes = code 
.ca/build/Config_1/production/mcc_generated_files/system.o: Link Error: Could not allocate section .text.SYSTEM_Initialize, size = 18 PC units, attributes = code 
.ca/build/Config_1/production/mcc_generated_files/uart1.o: Link Error: Could not allocate section .text.UART1_SetTxInterruptHandler, size = 14 PC units, attributes = code 
.ca/build/Config_1/production/mcc_generated_files/uart1.o: Link Error: Could not allocate section .text.UART1_SetRxInterruptHandler, size = 14 PC units, attributes = code 
.ca/build/Config_1/production/mcc_generated_files/uart1.o: Link Error: Could not allocate section .text.UART1_IsRxReady, size = 14 PC units, attributes = code 
.ca/build/Config_1/production/mcc_generated_files/system.o: Link Error: Could not allocate section .text.SYSTEM_CORCONModeOperatingSet, size = 12 PC units, attributes = code 
.ca/build/Config_1/production/mcc_generated_files/traps.o: Link Error: Could not allocate section .text.use_failsafe_stack, size = 10 PC units, attributes = code 
.ca/build/Config_1/production/mcc_generated_files/system.o: Link Error: Could not allocate section .text.INTERRUPT_GlobalEnable, size = 8 PC units, attributes = code 
.ca/build/Config_1/production/main.o: Link Error: Could not allocate section .text.main, size = 8 PC units, attributes = code [0m
[31m.ca/build/Config_1/production/mcc_generated_files/boot/boot_process.o: Link Error: Could not allocate section .text.BOOT_StartApplication, size = 6 PC units, attributes = code 
.ca/build/Config_1/production/mcc_generated_files/boot/boot_process.o: Link Error: Could not allocate section .text.Reset, size = 4 PC units, attributes = code 
.ca/build/Config_1/production/mcc_generated_files/boot/boot_demo.o: Link Error: Could not allocate section .text.EnterBootloadMode, size = 4 PC units, attributes = code 
.ca/build/Config_1/production/mcc_generated_files/boot/hardware_interrupt_table.o: Link Error: Could not allocate section .text, size = 4 PC units, attributes = code 
.ca/build/Config_1/production/mcc_generated_files/traps.o: Link Error: Could not allocate section .text.TRAPS_halt_on_error, size = 4 PC units, attributes = code 
.ca/build/Config_1/production/mcc_generated_files/boot/boot_process.o: Link Error: Could not allocate section .text.BOOT_Initialize, size = 2 PC units, attributes = code 
.ca/build/Config_1/production/mcc_generated_files/boot/boot_demo.o: Link Error: Could not allocate section .text.BOOT_DEMO_Initialize, size = 2 PC units, attributes = code 
.ca/build/Config_1/production/mcc_generated_files/uart1.o: Link Error: Could not allocate section .text.UART1_Transmit_CallBack, size = 2 PC units, attributes = code 
.ca/build/Config_1/production/mcc_generated_files/uart1.o: Link Error: Could not allocate section .text.UART1_Receive_CallBack, size = 2 PC units, attributes = code 
.ca/build/Config_1/production/mcc_generated_files/boot/com_adaptor_uart.o: Link Error: Could not allocate section .text.BOOT_COM_Write, size = 34 PC units, attributes = code 
.ca/build/Config_1/production/mcc_generated_files/uart1.o: Link Error: Could not allocate section .text.UART1_Write, size = 32 PC units, attributes = code 
.ca/build/Config_1/production/mcc_generated_files/boot/boot_process.o: Link Error: Could not allocate section .text.GetMemoryAddressRange, size = 28 PC units, attributes = code 
.ca/build/Config_1/production/mcc_generated_files/uart1.o: Link Error: Could not allocate section .text.UART1_IsTxReady, size = 28 PC units, attributes = code 
.ca/build/Config_1/production/mcc_generated_files/boot/boot_process.o: Link Error: Could not allocate section .text.IsLegalRange, size = 26 PC units, attributes = code 
.ca/build/Config_1/production/mcc_generated_files/interrupt_manager.o: Link Error: Could not allocate section .text.INTERRUPT_Initialize, size = 26 PC units, attributes = code 
.ca/build/Config_1/production/mcc_generated_files/uart1.o: Link Error: Could not allocate section .text.UART1_Read, size = 24 PC units, attributes = code 
.ca/build/Config_1/production/mcc_generated_files/boot/boot_process.o: Link Error: Could not allocate section .text.IsLegalAddress, size = 22 PC units, attributes = code 
.ca/build/Config_1/production/mcc_generated_files/boot/boot_process.o: Link Error: Could not allocate section .text.BOOT_ImageAddressGet, size = 20 PC units, attributes = code 
.ca/build/Config_1/production/mcc_generated_files/uart1.o: Link Error: Could not allocate section .text.UART1_IsTxDone, size = 20 PC units, attributes = code 
.ca/build/Config_1/production/mcc_generated_files/boot/com_adaptor_uart.o: Link Error: Could not allocate section .text.BOOT_COM_Peek, size = 18 PC units, attributes = code 
.ca/build/Config_1/production/mcc_generated_files/system.o: Link Error: Could not allocate section .text.SYSTEM_Initialize, size = 18 PC units, attributes = code 
.ca/build/Config_1/production/mcc_generated_files/uart1.o: Link Error: Could not allocate section .text.UART1_SetTxInterruptHandler, size = 14 PC units, attributes = code 
.ca/build/Config_1/production/mcc_generated_files/uart1.o: Link Error: Could not allocate section .text.UART1_SetRxInterruptHandler, size = 14 PC units, attributes = code 
.ca/build/Config_1/production/mcc_generated_files/uart1.o: Link Error: Could not allocate section .text.UART1_IsRxReady, size = 14 PC units, attributes = code 
.ca/build/Config_1/production/mcc_generated_files/system.o: Link Error: Could not allocate section .text.SYSTEM_CORCONModeOperatingSet, size = 12 PC units, attributes = code 
.ca/build/Config_1/production/mcc_generated_files/traps.o: Link Error: Could not allocate section .text.use_failsafe_stack, size = 10 PC units, attributes = code 
.ca/build/Config_1/production/mcc_generated_files/system.o: Link Error: Could not allocate section .text.INTERRUPT_GlobalEnable, size = 8 PC units, attributes = code 
.ca/build/Config_1/production/main.o: Link Error: Could not allocate section .text.main, size = 8 PC units, attributes = code 
.ca/build/Config_1/production/mcc_generated_files/boot/boot_process.o: Link Error: Could not allocate section .text.BOOT_StartApplication, size = 6 PC units, attributes = code 
.ca/build/Config_1/production/mcc_generated_files/boot/boot_process.o: Link Error: Could not allocate section .text.Reset, size = 4 PC units, attributes = code 
.ca/build/Config_1/production/mcc_generated_files/boot/boot_demo.o: Link Error: Could not allocate section .text.EnterBootloadMode, size = 4 PC units, attributes = code 
.ca/build/Config_1/production/mcc_generated_files/boot/hardware_interrupt_table.o: Link Error: Could not allocate section .text, size = 4 PC units, attributes = code 
.ca/build/Config_1/production/mcc_generated_files/traps.o: Link Error: Could not allocate section .text.TRAPS_halt_on_error, size = 4 PC units, attributes = code 
.ca/build/Config_1/production/mcc_generated_files/boot/boot_process.o: Link Error: Could not allocate section .text.BOOT_Initialize, size = 2 PC units, attributes = code 
.ca/build/Config_1/production/mcc_generated_files/boot/boot_demo.o: Link Error: Could not allocate section .text.BOOT_DEMO_Initialize, size = 2 PC units, attributes = code 
.ca/build/Config_1/production/mcc_generated_files/uart1.o: Link Error: Could not allocate section .text.UART1_Transmit_CallBack, size = 2 PC units, attributes = code 
.ca/build/Config_1/production/mcc_generated_files/uart1.o: Link Error: Could not allocate section .text.UART1_Receive_CallBack, size = 2 PC units, attributes = code 
.ca/build/Config_1/production/mcc_generated_files/uart1.o: Link Error: Could not allocate section .text.UART1_Write, size = 32 PC units, attributes = code 
.ca/build/Config_1/production/mcc_generated_files/boot/boot_process.o: Link Error: Could not allocate section .text.GetMemoryAddressRange, size = 28 PC units, attributes = code 
.ca/build/Config_1/production/mcc_generated_files/uart1.o: Link Error: Could not allocate section .text.UART1_IsTxReady, size = 28 PC units, attributes = code 
.ca/build/Config_1/production/mcc_generated_files/boot/boot_process.o: Link Error: Could not allocate section .text.IsLegalRange, size = 26 PC units, attributes = code 
.ca/build/Config_1/production/mcc_generated_files/interrupt_manager.o: Link Error: Could not allocate section .text.INTERRUPT_Initialize, size = 26 PC units, attributes = code 
.ca/build/Config_1/production/mcc_generated_files/uart1.o: Link Error: Could not allocate section .text.UART1_Read, size = 24 PC units, attributes = code 
.ca/build/Config_1/production/mcc_generated_files/boot/boot_process.o: Link Error: Could not allocate section .text.IsLegalAddress, size = 22 PC units, attributes = code 
.ca/build/Config_1/production/mcc_generated_files/boot/boot_process.o: Link Error: Could not allocate section .text.BOOT_ImageAddressGet, size = 20 PC units, attributes = code 
.ca/build/Config_1/production/mcc_generated_files/uart1.o: Link Error: Could not allocate section .text.UART1_IsTxDone, size = 20 PC units, attributes = code 
.ca/build/Config_1/production/mcc_generated_files/boot/com_adaptor_uart.o: Link Error: Could not allocate section .text.BOOT_COM_Peek, size = 18 PC units, attributes = code 
.ca/build/Config_1/production/mcc_generated_files/system.o: Link Error: Could not allocate section .text.SYSTEM_Initialize, size = 18 PC units, attributes = code 
.ca/build/Config_1/production/mcc_generated_files/uart1.o: Link Error: Could not allocate section .text.UART1_SetTxInterruptHandler, size = 14 PC units, attributes = code 
.[0m
[31mca/build/Config_1/production/mcc_generated_files/uart1.o: Link Error: Could not allocate section .text.UART1_SetRxInterruptHandler, size = 14 PC units, attributes = code 
.ca/build/Config_1/production/mcc_generated_files/uart1.o: Link Error: Could not allocate section .text.UART1_IsRxReady, size = 14 PC units, attributes = code 
.ca/build/Config_1/production/mcc_generated_files/system.o: Link Error: Could not allocate section .text.SYSTEM_CORCONModeOperatingSet, size = 12 PC units, attributes = code 
.ca/build/Config_1/production/mcc_generated_files/traps.o: Link Error: Could not allocate section .text.use_failsafe_stack, size = 10 PC units, attributes = code 
.ca/build/Config_1/production/mcc_generated_files/system.o: Link Error: Could not allocate section .text.INTERRUPT_GlobalEnable, size = 8 PC units, attributes = code 
.ca/build/Config_1/production/main.o: Link Error: Could not allocate section .text.main, size = 8 PC units, attributes = code 
.ca/build/Config_1/production/mcc_generated_files/boot/boot_process.o: Link Error: Could not allocate section .text.BOOT_StartApplication, size = 6 PC units, attributes = code 
.ca/build/Config_1/production/mcc_generated_files/boot/boot_process.o: Link Error: Could not allocate section .text.Reset, size = 4 PC units, attributes = code 
.ca/build/Config_1/production/mcc_generated_files/boot/boot_demo.o: Link Error: Could not allocate section .text.EnterBootloadMode, size = 4 PC units, attributes = code 
.ca/build/Config_1/production/mcc_generated_files/boot/hardware_interrupt_table.o: Link Error: Could not allocate section .text, size = 4 PC units, attributes = code 
.ca/build/Config_1/production/mcc_generated_files/traps.o: Link Error: Could not allocate section .text.TRAPS_halt_on_error, size = 4 PC units, attributes = code 
.ca/build/Config_1/production/mcc_generated_files/boot/boot_process.o: Link Error: Could not allocate section .text.BOOT_Initialize, size = 2 PC units, attributes = code 
.ca/build/Config_1/production/mcc_generated_files/boot/boot_demo.o: Link Error: Could not allocate section .text.BOOT_DEMO_Initialize, size = 2 PC units, attributes = code 
.ca/build/Config_1/production/mcc_generated_files/uart1.o: Link Error: Could not allocate section .text.UART1_Transmit_CallBack, size = 2 PC units, attributes = code 
.ca/build/Config_1/production/mcc_generated_files/uart1.o: Link Error: Could not allocate section .text.UART1_Receive_CallBack, size = 2 PC units, attributes = code 
.ca/build/Config_1/production/mcc_generated_files/uart1.o: Link Error: Could not allocate section .text.UART1_IsTxReady, size = 28 PC units, attributes = code 
.ca/build/Config_1/production/mcc_generated_files/boot/boot_process.o: Link Error: Could not allocate section .text.IsLegalRange, size = 26 PC units, attributes = code 
.ca/build/Config_1/production/mcc_generated_files/interrupt_manager.o: Link Error: Could not allocate section .text.INTERRUPT_Initialize, size = 26 PC units, attributes = code 
.ca/build/Config_1/production/mcc_generated_files/uart1.o: Link Error: Could not allocate section .text.UART1_Read, size = 24 PC units, attributes = code 
.ca/build/Config_1/production/mcc_generated_files/boot/boot_process.o: Link Error: Could not allocate section .text.IsLegalAddress, size = 22 PC units, attributes = code 
.ca/build/Config_1/production/mcc_generated_files/boot/boot_process.o: Link Error: Could not allocate section .text.BOOT_ImageAddressGet, size = 20 PC units, attributes = code 
.ca/build/Config_1/production/mcc_generated_files/uart1.o: Link Error: Could not allocate section .text.UART1_IsTxDone, size = 20 PC units, attributes = code 
.ca/build/Config_1/production/mcc_generated_files/boot/com_adaptor_uart.o: Link Error: Could not allocate section .text.BOOT_COM_Peek, size = 18 PC units, attributes = code 
.ca/build/Config_1/production/mcc_generated_files/system.o: Link Error: Could not allocate section .text.SYSTEM_Initialize, size = 18 PC units, attributes = code 
.ca/build/Config_1/production/mcc_generated_files/uart1.o: Link Error: Could not allocate section .text.UART1_SetTxInterruptHandler, size = 14 PC units, attributes = code 
.ca/build/Config_1/production/mcc_generated_files/uart1.o: Link Error: Could not allocate section .text.UART1_SetRxInterruptHandler, size = 14 PC units, attributes = code 
.ca/build/Config_1/production/mcc_generated_files/uart1.o: Link Error: Could not allocate section .text.UART1_IsRxReady, size = 14 PC units, attributes = code 
.ca/build/Config_1/production/mcc_generated_files/system.o: Link Error: Could not allocate section .text.SYSTEM_CORCONModeOperatingSet, size = 12 PC units, attributes = code 
.ca/build/Config_1/production/mcc_generated_files/traps.o: Link Error: Could not allocate section .text.use_failsafe_stack, size = 10 PC units, attributes = code 
.ca/build/Config_1/production/mcc_generated_files/system.o: Link Error: Could not allocate section .text.INTERRUPT_GlobalEnable, size = 8 PC units, attributes = code 
.ca/build/Config_1/production/main.o: Link Error: Could not allocate section .text.main, size = 8 PC units, attributes = code 
.ca/build/Config_1/production/mcc_generated_files/boot/boot_process.o: Link Error: Could not allocate section .text.BOOT_StartApplication, size = 6 PC units, attributes = code 
.ca/build/Config_1/production/mcc_generated_files/boot/boot_process.o: Link Error: Could not allocate section .text.Reset, size = 4 PC units, attributes = code 
.ca/build/Config_1/production/mcc_generated_files/boot/boot_demo.o: Link Error: Could not allocate section .text.EnterBootloadMode, size = 4 PC units, attributes = code
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
