zachleedogg/E_Moto/(commit log)

2016-07-21 Added pic33 libraries and drivers
2016-07-31 Android App with working BLE scanning and Timers and buttons. Pretty slick UI, too.
2016-08-04 Added refresh Bluetooth functionality and added a timer bug fix.
2016-08-08 Small fixes to App. Created an Input Capture Module for the PIC33 library
    [main.c]
2016-08-08 Some library cleanup and Framework Code Optomizations
2016-08-10 Framework optomizations including Prioirty, timer checking, timer interrupt, task scheduler, and initializations. Only verified using the simulator.
2016-08-19 Added Electronics and Architechture, Re-arranged file system
    [Cost Estimates.ods, Proto1a.dch, Proto1a.dip]
2016-08-23 fogrot to save...
    [Proto1a.dch]
2016-08-26 Primary Layout and Pours Completed for Proto1a
    [Proto1a.dch, Proto1a.dip]
2016-09-03 TFT LCD is kinda working. may be a problem with the SPI TX buffer. Also does the MCLR is not setup properly.
    [Proto1a.dch, Proto1a.dip]
2016-09-04 TFT LCD working with const write to screen. still need to increse write array to 32 to write to whole screen in one shot. Frame rate is about 4frame per sec
2016-09-07 Added text write of const strings at double size, still need to add color and size parameters. Modified ADC library to remove ADC pins. Touch screen working as a basic Drawing Pad.
2016-09-10 Touch screen working really well. Started Input Capture module for the PING sensors but not yet working
2016-09-10 Changed some init values for PING sensor. added another git ignore too
2016-09-10 PING sensor working in single AND cascaded mode, but there is a hack to make cascade mode reset... probably should just go to a slower timer like T4 or something...
    [main.c]
2016-09-11 Screen Orientation added, touch is fully accurate, need to work on IO pin init, there will be problems when migrating to family with obscurely number port-pins
    [main.c]
2016-09-11 created E-Moto project, fixed terrible framework bug, priorities could be input out of range.
    [Defines.h, FSM_TEMPLATE.h, configure.h, main.c]
2016-09-12 Screen touch is working beautiful in test bench and framework. There is some framework bug that causes lag in the screen, but I fixed it by putting the timer handler back into the ISR routine. I gues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
    [Defines.h, main.c]
2016-09-16 fixed the 1ms timer issue. Heavy screen writes delay the system. bumped clock speed to 120Mhz. Put timer update back in the ISR for speed. Changed the FSM to use function calls instead of giant switc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
    [FSM_TEMPLATE.h, main.c]
2016-09-29 PCB layout updates, and added FreeRTOS to the Repo just to play around with
    [Proto1a.dch, Proto1a.dip]
2016-09-30 not sure what I did last, probably testing LCD screen. Going to rewrite the drvier using DMA now anyways
2016-09-30 Touch Screen using DMA
2016-10-06 Touch screen working in framework, close to RAM overflow...
2016-10-06 Almost 100% done with proto1a, added new effiecient pin library
    [Proto1a.dch, Proto1a.dip]
2016-10-11 re-designed GPIO library, Fixed UART enums nomenclature, changed TOUCH and LCD SCREEN to use new pin library API
    [Defines.h, main.c, touchScreenSerivce.c]
2016-10-12 update ADC lib for compatability with all pic33 devices with 16reg ADCs
2016-10-12 Made ADC buffer pointers constant, added more support for microInit Fucntion
2016-10-12 ADC not working
2016-10-12 new ADC working (no API change just implementation) and updated gitignore. also CPU load calulator kinda works
2016-10-15 added clamp diodes to comparator outputs
    [Proto1a.dch, Proto1a.dip]
2016-10-21 Added accelerometer
    [Proto1a.dch, Proto1a.dip]
2016-10-21 finished proto1.0 and create gerber output
    [Board.gbr, BoardOutline.gbr, Bottom.gbr, BottomAssy.gbr, BottomDimension.gbr, BottomMask.gbr, BottomPaste.gbr, BottomSilk.gbr]
2016-10-22 Ok the PCB is really finished this time. Added Switches
    [Proto1a.dch, Proto1a.dip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]
2016-10-22 Changed VCAP footprint and added label to reset sw
    [Board.gbr, BoardOutline.gbr, Bottom.gbr, BottomAssy.gbr, BottomDimension.gbr, BottomMask.gbr, BottomPaste.gbr, BottomSilk.gbr]
2016-10-31 Updated E_MOTO project and libraries for Compiler optimizations
    [Board.gbr, BoardOutline.gbr, Bottom.gbr, BottomAssy.gbr, BottomDimension.gbr, BottomMask.gbr, BottomPaste.gbr, BottomSilk.gbr]
2016-11-03 Added a proper task scheduler for 1ms, 10ms, 100ms, and 1000ms. Added project configurations for Eval board and Debug Modes. Also did a lot of re-factoring
2016-11-20 Revised Simulatations with TI components in LT spice, finalized resistor/cap values in schematic.
    [BOM.csv, BOM_stripped.xlsx, Proto1a.dch]
2016-11-20 added ltc6802 to library and created seat heater arduino prototype
2016-11-20 First commit of BMS project
    [BMS_V1.dch]
2016-11-22 updated system architecture, re-ran reverse polarity sim, updated cap and res value in schematic
    [Proto1a.dch]
2016-11-29 Basic clean-up all around. Added full i2c support, changed interface, move draw() function from touch to display, still need to change the names of those modules. Added full support for dual ping sen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
2016-12-10 Removed FreeRTOS from Repo, little bit of framework re-org. Created externs for TaskRunner, created template Framework project. Added .tkk to GUI project and created an alternate GUI app using tabbed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
2016-12-13 Cleaned up Framework for Monday
2016-12-13 created batch file to build GUI exe file. Cleaned up Framework more for monday folks
2016-12-23 Fixed everything: CAN library, Pins Library, Added CAN service, Fixed the GUI to generally work more better, still have to kill it from time to time... Need to fix the problem when heavy bus traffic 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
    [Defines.h, E_MOTO_GUI.py, SerialComPorts.py, canSerivce.c, canService.h, debuggerSerivce.c, framework_configure.h]
2017-01-29 added stuff to research folder, started body controller project, lost it because I did not commit often enough.
    [BodyControllerList.ods, BodyController_01.dch, BodyController_01.dip, BodyController_02.dip, InterfaceList.ods, LM3904 Calculator.ods]
2017-02-02 added bms schematic
    [BMS_V1.dch, BodyController_01.dch, InterfaceController_01.dch]
2017-02-02 bms schemtic almost done. Need to add current transducer circuit
    [BMS_V1.dch]
2017-02-04 Added array packages to BMS for easier layout, cheaper cost, etc
    [BMS_V1.dch, BMS_V1.dip, BodyController_01.dch]
2017-02-09 layout and schematic updates
    [BMS_V1.dch, BMS_V1.dip]
2017-02-09 bms layout
    [BMS_V1.dch, BMS_V1.dip]
2017-10-20 A lot of stuff, mostly Body Controller Hardware
    [18650.SLDPRT, 1P Holder.SLDPRT, 2Banger18650Holder.SLDASM, 92125A126_TYPE 18-8 SS FLAT-HEAD SOCKET CAP SCREW.SLDPRT, 93840A116_METRIC NYLON FLAT HEAD SLOTTED MACHINE SCREW.SLDPRT, BMS_V1.dch, BMS_V1.dip, Bank.SLDASM]
2017-12-01 Updated layout, cleaned up directory, and modified BOM
    [BodyController_01.dch, BodyController_01.dip, BodyController_02.dip, BodyController_03.kicad_pcb, BodyController_03.sch, CAN.sch, Connectors.sch, DCDC.sch]
2017-12-21 started serious layout
    [346900200.SLDPRT, 347720140.SLDPRT, BodyControllerList.ods, BodyController_03.kicad_pcb, BodyController_03.sch, COMMUNICATION.sch, Connectors.sch, ConnectorsTogether.SLDASM]
2018-01-11 Body Controller Layout Done
    [BodyController_03.kicad_pcb, BodyController_03.sch, COMMUNICATION.sch, Communication.sch, Connectors.sch, DCDC.sch, HighSideDrivers_1.sch, HighSideDrivers_2.sch]
2018-01-11 Added output files
    [BodyController_03-B.Cu.gbr, BodyController_03-Edge.Cuts.gbr, BodyController_03-F.Cu.gbr, BodyController_03-F.Fab.gbr, BodyController_03-F.Mask.gbr, BodyController_03-F.SilkS.gbr, BodyController_03-In1.Cu.gbr, BodyController_03-In2.Cu.gbr]
2018-01-12 Updates to BOM
    [exportedCom.xlsx]
2018-01-12 Added resistor values via BOM importer. Changed layout file to add large CAN resistors and buffer to 1.65V Reference
    [BodyController_03.kicad_pcb, BodyController_03.sch, Communication.sch, Connectors.sch, DCDC.sch, HighSideDrivers_1.sch, HighSideDrivers_2.sch, HighSideDrivers_3.sch]
2018-01-13 fUll project rename and minor BOM updates
    [BodyController_01-B.Cu.gbr, BodyController_01-B.Mask.gbr, BodyController_01-Edge.Cuts.gbr, BodyController_01-F.Cu.gbr, BodyController_01-F.Fab.gbr, BodyController_01-F.Mask.gbr, BodyController_01-F.Paste.gbr, BodyController_01-F.SilkS.gbr]
2018-01-15 added BOM scripts
    [BodyController_01.kicad_pcb, E_Moto_BOM.xlsx, template.xlsx]
2018-01-16 fixed some BOM items, changed USB to vertical mount, CAN traces thicker, J1172 sims
    [BOM.xls, BOM.xlsx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]
2018-01-18 added CAN choke
    [BOM.xls, BodyController_01.kicad_pcb, Communication.sch, DCDC.sch, Inputs.sch, J1772.sch, PowerRails.sch]
2018-01-18 Found a few DRC errors, still need to correct them
    [BodyController_01-B.Cu.gbr, BodyController_01-B.Mask.gbr, BodyController_01-Edge.Cuts.gbr, BodyController_01-F.Cu.gbr, BodyController_01-F.Fab.gbr, BodyController_01-F.Mask.gbr, BodyController_01-F.Paste.gbr, BodyController_01-F.SilkS.gbr]
2018-01-19 Updated footprints, added CAN esd protection
    [BodyController_01.kicad_pcb, Communication.sch, DCDC.sch, Inputs.sch, J1772.sch, PowerInput.sch, PowerRails.sch]
2018-02-09 Final layout for real this time. larger vias for EuroCircuit minimum rule.
    [BodyController_01-B.Cu.gbr, BodyController_01-B.Mask.gbr, BodyController_01-Edge.Cuts.gbr, BodyController_01-F.Cu.gbr, BodyController_01-F.Fab.gbr, BodyController_01-F.Mask.gbr, BodyController_01-F.Paste.gbr, BodyController_01-F.SilkS.gbr]
2018-03-02 New bring-up code for Body Controller
    [BOM.xls, BOM.xlsx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]
2018-05-31 too much work to specify all. New Scheduler, new bootloader, added new Hardware projects, updated code for bringup, COnverted kicad files to new version.
    [BMS_01.kicad_pcb, BMS_01.sch, BattStack.sch, BodyController_01-2018-03-03-11-13-07.sch, BodyController_01-2018-03-04-09-58-14.sch, BodyController_01-2018-03-25-07-54-45.sch, BodyController_01.kicad_pcb, BodyController_01.sch]
2018-06-08 Added some sims, added turn signal functionality but have not yet tested it
    [BodyController_01.SLDASM, BottomShell.SLDPRT, COMPOUND.sldprt, CP_Elec_10x10.sldasm, CP_Elec_6.3x7.7.sldasm, C_0603.sldasm, C_0805.sldasm, C_1206.sldasm]
2018-06-09 Isolated Gate Driver Simulation
2018-06-12 Added new gat driver sim called simple
2018-06-29 changed some directory locations, added new DCDC PBC project, few Body controller light and switches changes
    [BodyControllerList.ods, Communication.sch, DCDC.sch, DCDC_01.kicad_pcb, DCDC_01.sch, DCDC_POWER.sch, Inputs.sch, J1772.sch]
2018-07-06 DCDC schematic update and first pass completion. Still needs review and component values
    [Commuication.sch, Connectors.sch, DCDC_01.sch, DCDC_Controller.sch, DCDC_Power_Stage.sch, MicroController.sch, PowerRails.sch, _saved_DCDC.sch]
2018-07-13 Mostly finished DCDC schematic, still needs some values and maybe a soft-start circuit that can be bypassed with 0ohm resister in case it doesn't work.
    [Commuication.sch, Communication.sch, Connectors.sch, DCDC.sch, DCDC_01.kicad_pcb, DCDC_01.sch, DCDC_Controller_old.sch, DCDC_POWER.sch]
2018-07-23 Updated DCDC schematic with footprints. Moving onto BMS as higher priority. Footprints added, 5V regulator updated
    [BMS_01.kicad_pcb, BMS_01.sch, BattStack.sch, CellMonitor.sch, Communication.sch, DCDC_01.kicad_pcb, DCDC_Controller.sch, DCDC_Power_Stage.sch]
2018-07-27 Added foorprints for BMS schematics
    [BMS_01.kicad_pcb, BMS_01.sch, BattStack.sch, CellMonitor.sch, Communication.sch, Connectors.sch, Micro.sch, NTC.sch]
2018-07-28 BMS Connectors
    [BMS_01.sch, Connectors.sch]
2019-07-03 Too much stuff to list
    [18650.SLDPRT, 18650.STL, 7_wide_Bank.SLDASM, 92981A120_ALLOY STEEL SHOULDER SCREW.SLDPRT, 9657K303_STEEL COMPRESSION SPRING.SLDPRT, BMS_01.kicad_pcb, BMS_01.sch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]
2019-07-14 Layout for Welder almost complete
    [Connectors.sch, MOT_Driver.sch, Micro.sch, Outputs.sch, Power.sch, Sensors.sch, Switches.sch, Welder.kicad_pcb]
2019-07-14 a few last layout items
    [Connectors.sch, Switches.sch, Welder.kicad_pcb]
2020-02-11 major CAD update
    [18650 NN.SLDPRT, 18650.SLDPRT, 1P Holder.SLDPRT, 25x2.SLDASM, 2Banger18650Holder.SLDASM, 7_wide_Bank.SLDASM, 92125A126_TYPE 18-8 SS FLAT-HEAD SOCKET CAP SCREW.SLDPRT, 93840A116_METRIC NYLON FLAT HEAD SLOTTED MACHINE SCREW.SLDPRT]
2020-03-23 added basstery assebmly into Frame.
    [18650.SLDPRT, Battery_Module_12x24.SLDASM, Battery_Pack_Assy.SLDASM, Enclosure_Bottom.SLDPRT, Enclosure_Front_Rear.SLDPRT, Enclosure_Side.SLDPRT, Enclosure_assy.SLDASM, Module_to_Module_BusBar.SLDPRT]
2020-04-24 created HV penthouse. Complete Battery Assembly
    [BMS_01.kicad_pcb, BMS_01.sch, BMS_V1.dch, BMS_V1.dip, BattStack.sch, Battery_Pack_Assy.SLDASM, Busbar_B+_to_Fuse.SLDPRT, Busbar_Contactor_to_Output.SLDPRT]
2020-05-06 Aluminum Enclosure early exploration
    New part for aluminum enclosure with rough shape.
    New file for battery top level assembly with aluminum enclosure in it.
    New FrameAndBattery file with aluminum enclosure in it.
    [Aluminum_Enclosure_01.SLDPRT, Battery_Pack_Assy.SLDASM, Enclosure_assy.SLDASM]
2020-05-11 First draft of subframe
    Modeled the first draft of subframe in Frame_01. That is also shown in FrameAndBattery_02.
2020-05-17 critical Frame Dimensions updated!
    [ME1616.SLDPRT, MotorMount.sldprt, MotorMountAssy.SLDASM, Mounting Points.SLDPRT]
2020-10-11 trellis work
    [Mounting Points.SLDPRT, Trellis_Left.sldprt, Trellis_Left_02.SLDPRT, Trellis_Left_02_BOT.STL, Trellis_Left_02_MID.STL, Trellis_Left_02_TOP.STL]
2020-10-11 added ann power holder drawing
2021-01-03 battery 3.0
    [12X48_Pack_Insulator.SLDPRT, 18650.SLDPRT, 18650_Shrinkwarp.SLDPRT, 18650_wrapped.SLDASM, 1S24P_Brick.SLDASM, 24S48P.SLDASM, 6P_Cell_Pack.SLDASM, 6S48P.SLDASM]
2022-04-16 BMS controller. Lots of new FW including bootloaders
    [BMS_01-B.Cu.gbr, BMS_01-B.Mask.gbr, BMS_01-Edge.Cuts.gbr, BMS_01-F.Cu.gbr, BMS_01-F.Mask.gbr, BMS_01-F.Paste.gbr, BMS_01-F.SilkS.gbr, BMS_01-In1.Cu.gbr]
2022-04-26 added sevcon files
    [BOM_by_refdes.xlsx]
2022-04-29 added eds and object dictionaries
    [Master Object Dictionary Database.xls, Master Object Dictionary Database.xlsx]
2022-05-14 added new BMS projects. Bringup code going well.
    [BMS_01.kicad_pcb, BMS_01.kicad_sch, BattStack.kicad_sch, CellMonitor.kicad_sch, ChargerAndDCDC.kicad_sch, Communication.kicad_sch, Config_1.txt, Config_2.txt]
